faoziaziz/qioters/1.jpg

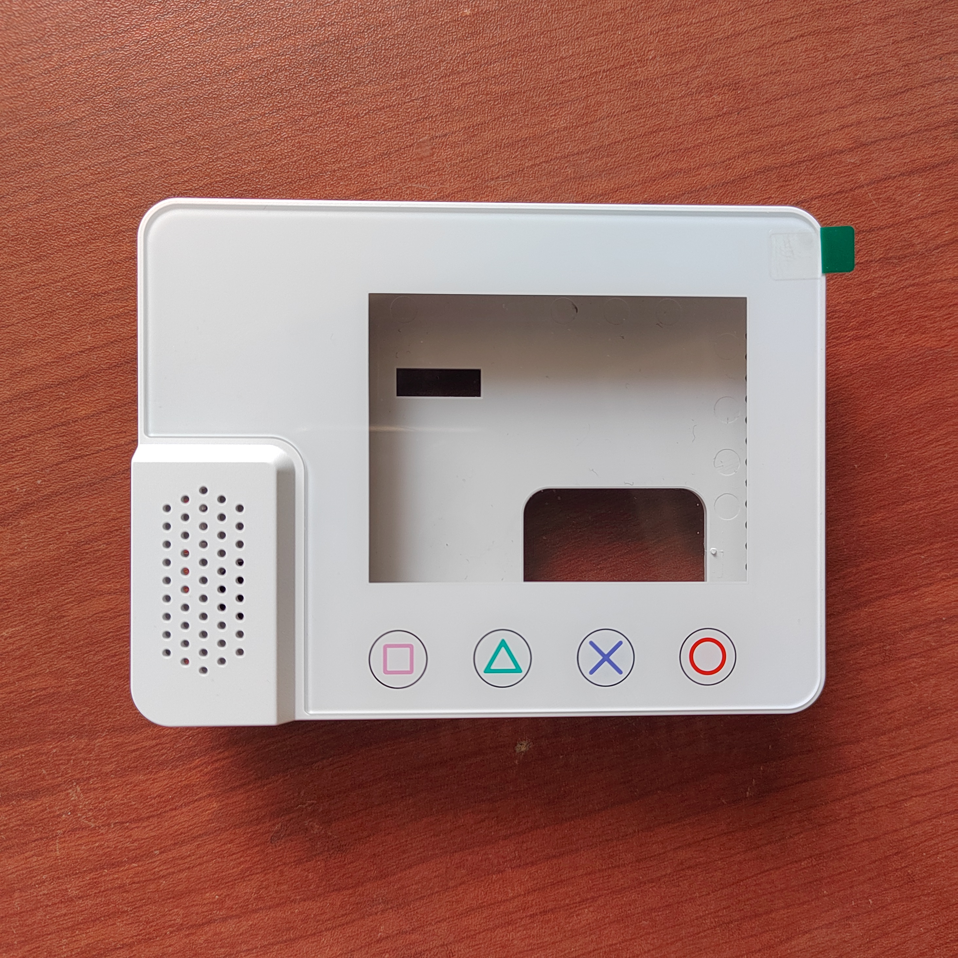
1.jpg
