faoziaziz/qioters/2.jpg

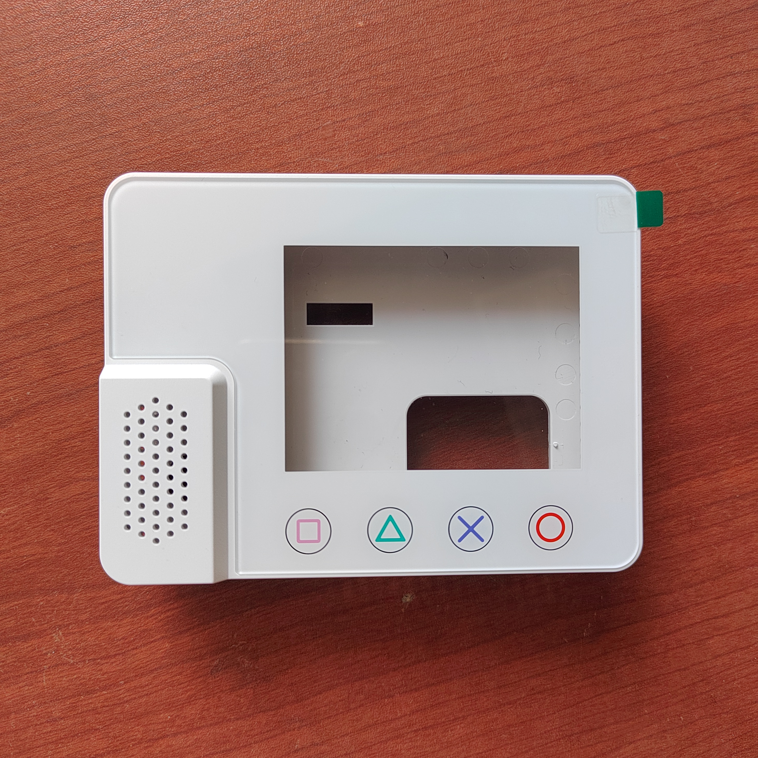
2.jpg
