faoziaziz/qioters/1.png

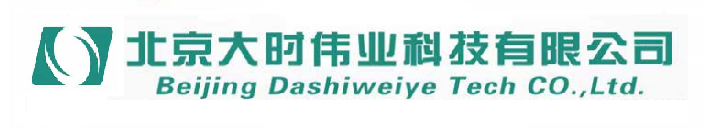
1.png
