faoziaziz/qioters/VAR-SOM_Compatibility_and_Pinouts.xlsx

Sheet: Revision
Version | Date | Description
1.0 | 2019-12-17 | Preliminary
1.1 | 22-Dec-19 | Correct SOM-MX8MM pins in the compatibility page only
1.2 | 02-JAN-20 | Added VAR-SOM-MX8M-NANO
1.3 | 2020-01-20 | Added VAR-SOM-MX8M-NANO and MINI SOM pin usage
1.4 | 2020-01-20 | Added VAR-SOM-SOLO pin usage and fix pin 58
1.5 | 2020-01-28 | Pin view on compatibility_pinmap page modified to include all SOMs
1.6 | 2020-03-22 | Added VAR-SOM-MX8MP Compatibility list updated with SOM-MX8MP
1.7 | 2020-05-17 | Updated VAR-SOM-MX8MP Pinout
1.8 | 2020-06-02 | Added SymphonyConnectors J7-J8-J5-J6-J4-J10-J11-J19
1.9 | 2020-06-15 | Added notes on power pins 31 33 35 in MX8X MX8MM MX8MN MX8MP Update second SPI in most COMMON FUNCTION TABLE pins 70 775 77 79
2.0 | 2020-06-28 | Updated COMMON FUNCTION TABLE pins 1,58,97 Updated most common function table - column ordered for MX6 family than MX8 family Updated VAR-SOM-MX8MP sheet pins 1,58 SymphonyConnectors sheet update to reflect Symphony-V1.4 changes; Added SOM notes column
2.1 | 2020-07-21 | Added Bootcfg on VAR-SOM-MX8MM Updated Mnemonics
2.2 | 2020-10-21 | Added SOM board images to mnemonics Added VAR-SOM-6UL pin usage per SOM configuration Updated J19 pin numbering according to Symphony-V1.4 VAR-SOM-MX8MP - updated pins 36,38 name
2.3 | 2021-03-18 | VAR-SOM-MX8M-MINI, VAR-SOM-MX8M-NANO - Added note for pin 91
2.4 | 2022-05-18 | VAR-SOM-MX8M-PLUS - removed SAI5_xx ALT functions from CPU SAI1_xx balls [SOM pins 40,55,56,57,70,72,73,75,82,86,117,120,177] Corrected notes pins 29,30
2.5 | 2023-03-16 | Added VAR-SOM-AM62 - Added pinmux sheet, updated compatibility_pinmap sheet Added SOM board images to mnemonics
2.6 | 2023-03-20 | VAR-SOM-AM62 - upated pins 50,51
2.7 | 2024-12-04 | Added support for VAR-SOM-MX8M-PLUS_V2.x Updated notes VAR-SOM-MX8M-PLUS_V1.x

Sheet: Mnemonics
Pinname mnemonics
"/" | Denote alternate function number "/" is ALT1 "////" is ALT4 None is ALT0
"/*/" | Function of configurable IC E.g. "SAI5_RXC/SAI1_TXD1////PDM_CLK/////GPIO3_IO20/*/LINEIN1_LP" " /*/LINEIN1_LP " - with "AC" Audio Codec configuration in the part number pin will expose the Audio Codec LINEIN1_LP IO The "SAI5_RXC/SAI1_TXD1////PDM_CLK/////GPIO3_IO20" Altenate function of SOC pad SAI5_RXC cannot be used in the above case!
"~" | Prefix points to an alternate function optionally used or shared on SOM; Verify with SOM datasheet before using this pin;
NC | Not Connected E.g. "NC/*/LVDS0_CH1_CLK_N" means that when "LD" LVDS Display option NOT included in the SOM configuration - this pin will not be connected
Compatibility_PinMap table mnemonics
"FULL COMPATIBLE" | "S"- Compatible Signal pin; "P"- Compatible Power pin
SOM Boards naming mnemonics
VAR-SOM-SOLO
VAR-SOM-6UL
VAR-SOM-MX6
VAR-SOM-MX8
VAR-SOM-MX8X
VAR-SOM-MX8MM (MINI)
VAR-SOM-MX8MN (NANO)
VAR-SOM-MX8MP (PLUS)
VAR-SOM-MX93
VAR-SOM-AM62

Sheet: Compatibility_PinMap
 | Symphony SOMs compatibility list: |  |  | FULL COMPATIBLE (S- Signal; P- Power) | ALL VAR-SOM MOST COMMON FUNCTION; If none will display unique or GPIO by default; |  |  |  |  |  |  |  |  |  |  | PWM | Enter PIN#
PIN# | Compatibility LIST (MX6/MX8/MX8X/MX8MM/MX8MN/MX8MP) - Symphony based | Compatible Name | Common GPIO used on Symphony | xxxx | VAR-SOM-SOLO | VAR-SOM-6UL | VAR-SOM-MX6 | VAR-SOM-MX8 | VAR-SOM-MX8X | VAR-SOM-MX8MM | VAR-SOM-MX8MN | VAR-SOM-MX8MP_V1.x | VAR-SOM-MX8MP_V2.x | VAR-SOM-MX93 | VAR-SOM-AM62 |  | 17 | SPECIFIC SOM PIN FUNCTIONS :
1 |  |  |  |  | DGND | DGND | GND | GND | GND | NC | NC | NC | NC | NC | NC |  | VAR-SOM-SOLO | IPU1_DISP0_D09/LCD_D09//PWM2_OUT///WDOG2_B/////GPIO4_IO30
2 | GND | GND |  | P | DGND | DGND | GND | GND | GND | GND | GND | GND | GND | GND | GND |  | VAR-SOM-6UL | ENET_REF_CLK2/PWM4_OUT//OTG2_ID///CSI_FIELD////USDHC1_VSELECT/////GPIO1_IO5(ADC IN5)//////ENET2_1588_EVENT0_OUT///////CCM_PLL3_BYP////////UART5_RX
3 | ETH_MDI_A+/ETH0_MDI_A_P/ETH0_MDI_A_P/ETH_TRX0_P/ETH_TRX0_P/ETH0_MDI_A_P | ETH#A_MDI_A_P |  | S | GETH_TR0P | ETH_RXDP | ETH_MDI_A+ | ETH0_MDI_A_P | ETH0_MDI_A_P | ETH_TRX0_P | ETH_TRX0_P | ETH0_MDI_A_P | ETH0_MDI_A_P | ETH0_MDI_A_P | ETH0_MDI_A_P |  | VAR-SOM-MX6 | IPU1_DISP0_DATA09/IPU2_DISP0_DATA09//PWM2_OUT///WDOG2_B/////GPIO4_IO30
4 | ETH_MDI_C+/ETH0_MDI_C_P/ETH0_MDI_C_P/ETH_TRX2_P/ETH_TRX2_P/ETH0_MDI_C_P | ETH#A_MDI_C_P |  | S | GETH_TR2P | NC | ETH_MDI_C+ | ETH0_MDI_C_P | ETH0_MDI_C_P | ETH_TRX2_P | ETH_TRX2_P | ETH0_MDI_C_P | ETH0_MDI_C_P | ETH0_MDI_C_P | ETH0_MDI_C_P |  | VAR-SOM-MX8 | LVDS0_GPIO0_IO00/LVDS0_PWM0_OUT///LSIO_GPIO1_IO04
5 | ETH_MDI_A-/ETH0_MDI_A_M/ETH0_MDI_A_M/ETH_TRX0_N/ETH_TRX0_N/ETH0_MDI_A_M | ETH#A_MDI_A_M |  | S | GETH_TR0N | ETH_RXDN | ETH_MDI_A- | ETH0_MDI_A_M | ETH0_MDI_A_M | ETH_TRX0_N | ETH_TRX0_N | ETH0_MDI_A_M | ETH0_MDI_A_M | ETH0_MDI_A_M | ETH0_MDI_A_M |  | VAR-SOM-MX8X | MIPI_DSI0_GPIO0_IO00/ADMA_I2C1_SCL//MIPI_DSI0_PWM0_OUT////LSIO_GPIO1_IO27
6 | ETH_MDI_C-/ETH0_MDI_C_M/ETH0_MDI_C_M/ETH_TRX2_N/ETH_TRX2_N/ETH0_MDI_C_M | ETH#A_MDI_C_M |  | S | GETH_TR2N | NC | ETH_MDI_C- | ETH0_MDI_C_M | ETH0_MDI_C_M | ETH_TRX2_N | ETH_TRX2_N | ETH0_MDI_C_M | ETH0_MDI_C_M | ETH0_MDI_C_M | ETH0_MDI_C_M |  | VAR-SOM-MX8MM | SPDIF_EXT_CLK/PWM1_OUT/////GPIO5_IO05
7 | GND | GND |  | P | DGND | DGND | GND | GND | GND | GND | GND | GND | GND | GND | GND |  | VAR-SOM-MX8MN | SPDIF_EXT_CLK/PWM1_OUT/////GPIO5_IO05
8 | GND | GND |  | P | DGND | DGND | GND | GND | GND | GND | GND | GND | GND | GND | GND |  | VAR-SOM-MX8MP_V1.x | SPDIF1_EXT_CLK/PWM1_OUT///GPT1_COMPARE3/////GPIO5_IO05
9 | ETH_MDI_B+/ETH0_MDI_B_P/ETH0_MDI_B_P/ETH_TRX1_P/ETH_TRX1_P/ETH0_MDI_B_P | ETH#A_MDI_B_P |  | S | GETH_TR1P | ETH_TXDP | ETH_MDI_B+ | ETH0_MDI_B_P | ETH0_MDI_B_P | ETH_TRX1_P | ETH_TRX1_P | ETH0_MDI_B_P | ETH0_MDI_B_P | ETH0_MDI_B_P | ETH0_MDI_B_P |  | VAR-SOM-MX8MP_V2.x | SPDIF1_EXT_CLK/PWM1_OUT///GPT1_COMPARE3/////GPIO5_IO05
10 | ETH_MDI_D+/ETH0_MDI_D_P/ETH0_MDI_D_P/ETH_TRX3_P/ETH_TRX3_P/ETH0_MDI_D_P | ETH#A_MDI_D_P |  | S | GETH_TR3P | NC | ETH_MDI_D+ | ETH0_MDI_D_P | ETH0_MDI_D_P | ETH_TRX3_P | ETH_TRX3_P | ETH0_MDI_D_P | ETH0_MDI_D_P | ETH0_MDI_D_P | ETH0_MDI_D_P |  | VAR-SOM-MX93 | GPIO2.IO[24]/USDHC3.DATA0//LCDIF.D[20]/TPM3.CH3/DAP.TDO_TRACESWO/SPI6.PCS1/FLEXIO1.FLEXIO[24]
11 | ETH_MDI_B-/ETH0_MDI_B_M/ETH0_MDI_B_M/ETH_TRX1_N/ETH_TRX1_N/ETH0_MDI_B_M | ETH#A_MDI_B_M |  | S | GETH_TR1N | ETH_TXDN | ETH_MDI_B- | ETH0_MDI_B_M | ETH0_MDI_B_M | ETH_TRX1_N | ETH_TRX1_N | ETH0_MDI_B_M | ETH0_MDI_B_M | ETH0_MDI_B_M | ETH0_MDI_B_M |  | VAR-SOM-AM62 | MCASP0_AXR1/SPI2_CS2//ECAP1_IN_APWM_OUT/////PR0_UART0_RXD//////EHRPWM1_A///////GPIO1_9////////EQEP0_S
12 | ETH_MDI_D-/ETH0_MDI_D_M/ETH0_MDI_D_M/ETH_TRX3_N/ETH_TRX3_N/ETH0_MDI_D_M | ETH#A_MDI_D_M |  | S | GETH_TR3N | NC | ETH_MDI_D- | ETH0_MDI_D_M | ETH0_MDI_D_M | ETH_TRX3_N | ETH_TRX3_N | ETH0_MDI_D_M | ETH0_MDI_D_M | ETH0_MDI_D_M | ETH0_MDI_D_M
13 | GND | GND |  | P | DGND | DGND | GND | GND | GND | GND | GND | GND | GND | GND | GND
14 | GND | GND |  | P | DGND | DGND | GND | GND | GND | GND | GND | GND | GND | GND | GND
15 | ETH0_LED_ACT | ETH#A_LED_ACT |  | S | ETH_LED2 | ETH_LED2 | GETH_LED2 | ETH0_LED_ACT | ETH0_LED_ACT | ETH_LED_ACT | ETH_LED_ACT | ETH0_LED_ACT | ETH0_LED_ACT | ETH0_LED_ACT | ETH0_LED_ACT
16 | ETH0_LED_LINK_10_100_1000 | ETH#A_LED_LINK_10_100_1000 |  | S | ETH_LED1 | ETH_LED1 | ETH_PME_N_LED1 | ETH0_LED_LINK_10_100_1000 | ETH0_LED_LINK_10_100_1000 | ETH_LED_LINK10_100_1000 | ETH_LED_LINK10_100_1000 | ETH0_LED_LINK_10_100_1000 | ETH0_LED_LINK_10_100_1000 | ETH0_LED_LINK | ETH0_LED_LINK_10_100_1000
17 | PWM2_OUT/LVDS0_PWM0_OUT/MIPI_DSI0_PWM0_OUT/PWM1_OUT/PWM1_OUT/EHRPWM1_A | PWM#A |  | S | PWM2_OUT | PWM4_OUT | PWM2_OUT | LVDS0_PWM0_OUT | MIPI_DSI0_PWM0_OUT | PWM1_OUT | PWM1_OUT | PWM1_OUT | PWM1_OUT | TPM3.CH3 (PWM) | EHRPWM1_A
18 | DMIC_CLK | AC#_DMIC_CLK |  | S | DMIC_CLK | NC | DMIC_CLK | DMIC_CLK | DMIC_CLK | DMIC_CLK | DMIC_CLK | DMIC_CLK | DMIC_CLK | DMIC_CLK | DMIC_CLK
19 | GND/GND/GND/GND/GND/DGND | GND |  | P | DGND | DGND | GND | GND | GND | GND | GND | DGND | DGND | GND | DGND
20 | DMIC_DATA | AC#_DMIC_DATA |  | S | DMIC_DATA | NC | DMIC_DATA | DMIC_DATA | DMIC_DATA | DMIC_DATA | DMIC_DATA | DMIC_DATA | DMIC_DATA | DMIC_DATA | DMIC_DATA
21 | AUD4_RXD/AUD_SAI1_RXD/ADMA_SAI0_RXD/SAI2_RXD0/SAI2_RXD0/MCASP2_AXR2 | SAI#A_RXD |  | S | AUD4_RXD | SAI1_RX_D | AUD4_RXD | AUD_SAI1_RXD | ADMA_SAI0_RXD | SAI2_RXD0 | SAI2_RXD0 | SAI2_RX_DATA0 | SAI2_RX_DATA0 | SAI3.RX_DATA[0] | MCASP2_AXR2
22 | AUD4_RXC/AUD_SAI1_RXC/ADMA_SAI0_RXC/SAI2_RXC/SAI2_RXC/MCASP2_ACLKR | SAI#A_RXC_USDHC#A_RESET_B |  | S | AUD4_RXC | SAI1_RX_BCLK | AUD4_RXC | AUD_SAI1_RXC | ADMA_SAI0_RXC | SAI2_RXC | SAI2_RXC | SAI2_RX_BCLK | SAI2_RX_BCLK | SAI3.RX_BCLK | MCASP2_ACLKR
23 | AUD4_RXFS/AUD_SAI1_RXFS/ADMA_SAI0_RXFS/SAI2_RXFS/SAI2_RXFS/MCASP2_AFSR | SAI#A_RXFS_PCIE#A_RESET_B |  | S | AUD4_RXFS | SAI1_RX_SYNC | AUD4_RXFS | AUD_SAI1_RXFS | ADMA_SAI0_RXFS | SAI2_RXFS | SAI2_RXFS | SAI2_RX_SYNC | SAI2_RX_SYNC | SAI3.RX_SYNC | MCASP2_AFSR
24 | AUD4_TXFS/AUD_SAI1_TXFS/ADMA_SAI0_TXFS/SAI2_TXFS/SAI2_TXFS/MCASP2_AFSX | SAI#A_TXFS |  | S | AUD4_TXFS | SAI1_TX_SYNC | AUD4_TXFS | AUD_SAI1_TXFS | ADMA_SAI0_TXFS | SAI2_TXFS | SAI2_TXFS | SAI2_TX_SYNC | SAI2_TX_SYNC | SAI3.TX_SYNC | MCASP2_AFSX
25 | AUD4_TXC/AUD_SAI0_TXC/ADMA_SAI0_TXC/SAI2_TXC/SAI2_TXC/MCASP2_ACLKX | SAI#A_TXC |  | S | AUD4_TXC | SAI1_TX_BCLK | AUD4_TXC | AUD_SAI0_TXC | ADMA_SAI0_TXC | SAI2_TXC | SAI2_TXC | SAI2_TX_BCLK | SAI2_TX_BCLK | SAI3.TX_BCLK | MCASP2_ACLKX
26 | AUD4_TXD/AUD_SAI1_TXD/ADMA_SAI0_TXD/SAI2_TXD0/SAI2_TXD0/MCASP2_AXR3 | SAI#A_TXD |  | S | AUD4_TXD | SAI1_TX_D | AUD4_TXD | AUD_SAI1_TXD | ADMA_SAI0_TXD | SAI2_TXD0 | SAI2_TXD0 | SAI2_TX_DATA0 | SAI2_TX_DATA0 | SAI3.RX_BCLK | MCASP2_AXR3
27 | GND | GND |  | P | DGND | DGND | GND | GND | GND | GND | GND | GND | GND | GND | GND
28 | GND | GND |  | P | DGND | DGND | GND | GND | GND | GND | GND | GND | GND | GND | GND
29 | CCM_CLKO2/MIPI_CSI0_MCLK_OUT/MIPI_CSI0_MCLK_OUT/EXT_CLK4/EXT_CLK4/SYSCLKOUT0 | CLK#GP |  | S | CCM_CLKO2 | GPT2_CLK | CCM_CLKO2 | MIPI_CSI0_MCLK_OUT | MIPI_CSI0_MCLK_OUT | EXT_CLK4 | EXT_CLK4 | CCM_CLKO2 | CCM_CLKO2 | CCMSRCGPCMIX.CLKO1 | SYSCLKOUT0
30 | NC/CONN_ENET0_MDIO/CONN_ENET0_MDIO/ENET_MDIO/ENET_MDIO/MDIO0_MDIO | J1_30-ENET_MDIO |  | S | NC | ENET1_MDIO | NC | CONN_ENET0_MDIO | CONN_ENET0_MDIO | ENET_MDIO | ENET_MDIO | ENET_QOS_MDIO | ENET_QOS_MDIO | ENET_QOS.MDIO | MDIO0_MDIO
31 |  |  |  |  | DGND | DGND | GND | VCC_SOM | NC | NC | NC | NC | NC | NC | NC
32 | VCC_SOM | VCC_SOM |  | P | VCC_SOM | VCC_SOM | VCC_SOM | VCC_SOM | VCC_SOM | VCC_SOM | VCC_SOM | VCC_SOM | VCC_SOM | VCC_SOM | VCC_SOM
33 |  |  |  |  | DGND | DGND | GND | VCC_SOM | NC | NC | NC | NC | NC | NC | NC
34 | VCC_SOM | VCC_SOM |  | S | VCC_SOM | VCC_SOM | VCC_SOM | VCC_SOM | VCC_SOM | VCC_SOM | VCC_SOM | VCC_SOM | VCC_SOM | VCC_SOM | VCC_SOM
35 |  |  |  |  | DGND | DGND | GND | VCC_SOM | NC | NC | NC | NC | NC | NC | NC
36 | VCC_SOM/VCC_SOM/LICELL/VCC_SOM/VCC_SOM/VCC_SOM | VCC_SOM/MX8MP-ENET0 PWR |  | P | VCC_SOM | LICELL | VCC_SOM | VCC_SOM | LICELL | VCC_SOM | VCC_SOM | VDD_ENET0_1P8_3P3_IN | VDD_ENET0_1P8_3P3_IN | NC | VCC_SOM
37 | GND | GND |  | P | DGND | DGND | GND | GND | GND | GND | GND | GND | GND | GND | GND
38 | VCC_SOM/VDD_ENET1_1P8_2P5_3P3_IN/VDD_ENET1_1P8_2P5_3P3_IN/VDD_ENET/VDD_ENET/NC | VDD_ENET for MX8 SOM family |  | P | VCC_SOM | VCC_SOM | VCC_SOM | VDD_ENET1_1P8_2P5_3P3_IN | VDD_ENET1_1P8_2P5_3P3_IN | VDD_ENET | VDD_ENET | VDD_ENET1_1P8_3P3_IN | VDD_ENET1_1P8_3P3_IN | NC | NC
39 | ECSPI1_SS0/DMA_SPI1_CS0/ADMA_SPI2_CS0/ECSPI1_SS0/ECSPI1_SS0/SPI2_CS0 | SPI#A_CS0 |  | S | ECSPI1_SS0 | ECSPI4_SS0 | ECSPI1_SS0 | DMA_SPI1_CS0 | ADMA_SPI2_CS0 | ECSPI1_SS0 | ECSPI1_SS0 | ECSPI2_SS0 | ECSPI2_SS0 | SPI6.PCS0 | SPI2_CS0
40 |  |  | J1_40-MIPI_CAM_RST |  | GPIO3_IO05 | NC | GPIO3_IO05 | LSIO_GPIO3_IO06 | LSIO_GPIO0_IO12 | GPIO1_IO13 | GPIO1_IO13 | GPIO1_IO00 | GPIO1_IO00 | GPIO3.IO[27] | GPIO0_22
41 | ECSPI1_MISO/DMA_SPI1_SDI/ADMA_SPI2_SDI/ECSPI1_MISO/ECSPI1_MISO/SPI2_D1 | SPI#A_SDI |  | S | ECSPI1_MISO | ECSPI4_MISO | ECSPI1_MISO | DMA_SPI1_SDI | ADMA_SPI2_SDI | ECSPI1_MISO | ECSPI1_MISO | ECSPI2_MISO | ECSPI2_MISO | SPI6.SIN | SPI2_D1
42 | SRC_BOOT_CFG07/BOOT_SEL/BOOT_SEL/BOOT_SEL/BOOT_SEL/BOOT_SEL | BOOT#_SEL |  | S | SRC_BOOT_CFG07 | BOOT_SEL0 | SRC_BOOT_CFG07 | BOOT_SEL | BOOT_SEL | BOOT_SEL | BOOT_SEL | BOOT_SEL | BOOT_SEL | BOOT_SEL | BOOT_SEL
43 | ECSPI1_SCLK/DMA_SPI1_SCK/ADMA_SPI2_SCK/ECSPI1_SCLK/ECSPI1_SCLK/SPI2_CLK | SPI#A_SCK |  | S | ECSPI1_SCLK | ECSPI4_SCLK | ECSPI1_SCLK | DMA_SPI1_SCK | ADMA_SPI2_SCK | ECSPI1_SCLK | ECSPI1_SCLK | ECSPI2_SCLK | ECSPI2_SCLK | SPI6.SCK | SPI2_CLK
44 | FLEXCAN1_TX/FLEXCAN0_TX/ADMA_FLEXCAN2_TX/CAN_TX/CAN_TX/MCAN0_TX | FLEXCAN#A_TX |  | S | FLEXCAN1_TX | CAN1_TX | FLEXCAN1_TX | FLEXCAN0_TX | ADMA_FLEXCAN2_TX | CAN_TX | CAN_TX | FLEXCAN2_TX | FLEXCAN2_TX | CAN1.TX | MCAN0_TX
45 | ECSPI1_MOSI/DMA_SPI1_SDO/ADMA_SPI2_SDO/ECSPI1_MOSI/ECSPI1_MOSI/SPI2_D0 | SPI#A_SDO |  | S | ECSPI1_MOSI | ECSPI4_MOSI | ECSPI1_MOSI | DMA_SPI1_SDO | ADMA_SPI2_SDO | ECSPI1_MOSI | ECSPI1_MOSI | ECSPI2_MOSI | ECSPI2_MOSI | SPI6.SOUT | SPI2_D0
46 | FLEXCAN1_RX/DMA_FLEXCAN0_RX/ADMA_FLEXCAN2_RX/CAN_RX/CAN_RX/MCAN0_RX | FLEXCAN#A_RX |  | S | FLEXCAN1_RX | CAN1_RX | FLEXCAN1_RX | DMA_FLEXCAN0_RX | ADMA_FLEXCAN2_RX | CAN_RX | CAN_RX | FLEXCAN2_RX | FLEXCAN2_RX | CAN1.RX | MCAN0_RX
47 | GND | GND |  | P | DGND | DGND | GND | GND | GND | GND | GND | GND | GND | GND | GND
48 |  |  |  |  | GPIO4_IO10 | GPIO1_IO25 | GPIO4_IO10 | LSIO_GPIO0_IO17 | LSIO_GPIO3_IO02 | GPIO1_IO02/WDOG_B | GPIO1_IO02/WDOG_B | SAI2_MCLK | SAI2_MCLK | GPIO2.IO[10] | GPIO0_20
49 | SOM_3V3_PER/SOM_3V3_PER/SOM_3V3_PER/SOM_3V3_PER/SOM_3V3_PER/SOM_PGOOD | SOM_3V3_PER |  | P | SOM_3V3_PER | SOM_3V3_PER | SOM_3V3_PER | SOM_3V3_PER | SOM_3V3_PER | SOM_3V3_PER | SOM_3V3_PER | SOM_3V3_PER | SOM_3V3_PER | SOM_3V3_PER | SOM_PGOOD
50 | UART2_CTS_B/DMA_UART1_RTS_B/ADMA_UART0_RTS_B/UART2_CTS_B/UART2_CTS_B/UART5_CTSn | UART#BT_RTS_B |  | S | UART2_CTS_B | UART2_CTS_B | UART2_CTS_B | DMA_UART1_RTS_B | ADMA_UART0_RTS_B | UART2_CTS_B | UART2_CTS_B | UART3_CTS_B | UART3_CTS_B | UART5.RTS_B | UART5_CTSn
51 | UART2_RTS_B/DMA_UART1_CTS_B/ADMA_UART0_CTS_B/UART2_RTS_B/UART2_RTS_B/UART5_RTSn | UART#BT_CTS_B |  | S | UART2_RTS_B | UART2_RTS_B | UART2_RTS_B | DMA_UART1_CTS_B | ADMA_UART0_CTS_B | UART2_RTS_B | UART2_RTS_B | UART3_RTS_B | UART3_RTS_B | UART5.CTS_B | UART5_RTSn
52 | UART2_TX_DATA/DMA_UART1_TX/ADMA_UART0_TX/UART2_TXD/UART2_TXD/UART5_TXD | UART#BT_TX |  | S | UART2_TX | UART2_TX | UART2_TX_DATA | DMA_UART1_TX | ADMA_UART0_TX | UART2_TXD | UART2_TXD | UART3_TX | UART3_TX | UART5.TX | UART5_TXD
53 | UART2_RX_DATA/DMA_UART1_RX/ADMA_UART0_RX/UART2_RXD/UART2_RXD/UART5_RXD | UART#BT_RX |  | S | UART2_RX | UART2_RX | UART2_RX_DATA | DMA_UART1_RX | ADMA_UART0_RX | UART2_RXD | UART2_RXD | UART3_RX | UART3_RX | UART5.RX | UART5_RXD
54 |  |  |  |  | UART3_RX | UART5_RX | UART3_RX_DATA | UART3_RX | LSIO_GPIO0_IO05 | UART1_RXD | UART1_RXD | GPIO4_IO09 | GPIO4_IO09 | GPIO4.IO[27] | GPIO1_6
55 |  |  |  |  | UART3_CTS_B | UART5_CTS_B | UART3_CTS_B | UART3_RTS (actually CTS) | LSIO_GPIO0_IO03 | UART1_CTS_B | UART1_CTS_B | GPIO4_IO15 | GPIO4_IO15 | GPIO4.IO[16] | GPIO1_0
56 |  |  |  |  | UART3_TX | UART5_TX | UART3_TX_DATA | UART3_TX | LSIO_GPIO0_IO01 | UART1_TXD | UART1_TXD | GPIO4_IO14 | GPIO4_IO14 | GPIO4.IO[17] | GPIO0_91
57 |  |  |  |  | UART3_RTS_B | UART5_RTS_B | UART3_RTS_B | UART3_CTS (actually RTS) | LSIO_GPIO0_IO04 | UART1_RTS_B | UART1_RTS_B | GPIO4_IO11 | GPIO4_IO11 | GPIO4.IO[23] | GPIO1_2
58 |  |  |  |  | DGND | DGND | GND | GND | GND | GND | GND | NC | NC | NC | MCU_GPIO0_7
59 | GND | GND |  | P | DGND | DGND | GND | GND | GND | GND | GND | GND | GND | GND | GND
60 | SD2_CLK/CONN_USDHC1_CLK/CONN_USDHC1_CLK/SD2_CLK/SD2_CLK/MMC1_CLK | USDHC#A_CLK |  | S | SD2_CLK | SD1_CLK | SD2_CLK | CONN_USDHC1_CLK | CONN_USDHC1_CLK | SD2_CLK | SD2_CLK | USDHC2_CLK | USDHC2_CLK | USDHC2.CLK | MMC1_CLK
61 | SD2_DATA2/CONN_USDHC1_DATA2/CONN_USDHC1_DATA2/SD2_DATA2/SD2_DATA2/MMC1_DAT2 | USDHC#A_DAT2 |  | S | SD2_D2 | SD1_DATA2 | SD2_DATA2 | CONN_USDHC1_DATA2 | CONN_USDHC1_DATA2 | SD2_DATA2 | SD2_DATA2 | USDHC2_DATA2 | USDHC2_DATA2 | USDHC2.DATA2 | MMC1_DAT2
62 | SD2_DATA0/CONN_USDHC1_DATA0/CONN_USDHC1_DATA0/SD2_DATA0/SD2_DATA0/MMC1_DAT2 | USDHC#A_DAT0 |  | S | SD2_D0 | SD1_DATA0 | SD2_DATA0 | CONN_USDHC1_DATA0 | CONN_USDHC1_DATA0 | SD2_DATA0 | SD2_DATA0 | USDHC2_DATA0 | USDHC2_DATA0 | USDHC2.DATA0 | MMC1_DAT2
63 | SD2_DATA1/CONN_USDHC1_DATA1/CONN_USDHC1_DATA1/SD2_DATA1/SD2_DATA1/MMC1_DAT1 | USDHC#A_DAT1 |  | S | SD2_D1 | SD1_DATA1 | SD2_DATA1 | CONN_USDHC1_DATA1 | CONN_USDHC1_DATA1 | SD2_DATA1 | SD2_DATA1 | USDHC2_DATA1 | USDHC2_DATA1 | USDHC2.DATA1 | MMC1_DAT1
64 | SD2_CMD/CONN_USDHC1_CMD/CONN_USDHC1_CMD/SD2_CMD/SD2_CMD/MMC1_CMD | USDHC#A_CMD |  | S | SD2_CMD | SD1_CMD | SD2_CMD | CONN_USDHC1_CMD | CONN_USDHC1_CMD | SD2_CMD | SD2_CMD | USDHC2_CMD | USDHC2_CMD | USDHC2.CMD | MMC1_CMD
65 | SD2_DATA3/CONN_USDHC1_DATA3/CONN_USDHC1_DATA3/SD2_DATA3/SD2_DATA3/MMC1_DAT3 | USDHC#A_DAT3 |  | S | SD2_D3 | SD1_DATA3 | SD2_DATA3 | CONN_USDHC1_DATA3 | CONN_USDHC1_DATA3 | SD2_DATA3 | SD2_DATA3 | USDHC2_DATA3 | USDHC2_DATA3 | USDHC2.DATA3 | MMC1_DAT3
66 | GND | GND |  | P | DGND | DGND | GND | GND | GND | GND | GND | GND | GND | GND | GND
67 | GND | GND |  | P | DGND | DGND | GND | GND | GND | GND | GND | GND | GND | GND | GND
68 | PWM1_OUT/LSIO_PWM2_OUT/LSIO_PWM3_OUT/PWM2_OUT/PWM2_OUT/EHRPWM0_B | PWM#B_CPT_INT |  | S | PWM1_OUT | PWM2_OUT | PWM1_OUT | LSIO_PWM2_OUT | LSIO_PWM3_OUT | PWM2_OUT | PWM2_OUT | PWM3_OUT | PWM3_OUT | TPM4.CH3 (PWM) | EHRPWM0_B
69 | PWM3_OUT/LSIO_PWM3_OUT/LSIO_PWM2_OUT/PWM3_OUT/PWM3_OUT/EHRPWM1_B | PWM#C |  | S | PWM3_OUT | PWM1_OUT | PWM3_OUT | LSIO_PWM3_OUT | LSIO_PWM2_OUT | PWM3_OUT | PWM3_OUT | PWM2_OUT | PWM2_OUT | TPM6.CH3 (PWM) | EHRPWM1_B
70 |  |  | J1_70-MIPI_CAM_SYNC |  | JTAG_TRSTB | ECSPI2_MOSI | GPIO2_IO14 | DMA_SPI0_SDO | ADMA_SPI1_SDO | ECSPI2_MOSI | ECSPI2_MOSI | GPIO1_IO13 | GPIO1_IO13 | NC | SPI1_D0
71 |  |  |  |  | GPIO1_IO02 | GPIO4_IO14 | GPIO1_IO02 | LSIO_GPIO6_IO20 | LSIO_GPIO0_IO06 | GPIO2_IO19 | GPIO2_IO19 | GPIO4_IO08 | GPIO4_IO08 | GPIO4.IO[26] | GPIO1_5
72 |  |  |  |  | USB_OTG_ID | GPIO5_IO3 | USB_OTG_ID | LSIO_GPIO3_IO11 | LSIO_GPIO5_IO09 | USB2_OTG_ID | USB2_OTG_ID | GPIO1_IO05 | GPIO1_IO05 | GPIO1.IO[10] | GPIO1_12
73 |  |  |  |  | GPIO2_IO11 | GPIO5_IO1 | GPIO2_IO11 | LSIO_GPIO6_IO12 | LSIO_GPIO0_IO08 | GPIO4_IO27 | GPIO4_IO27 | GPIO4_IO12 | GPIO4_IO12 | GPIO4.IO[19] | GPIO0_89
74 | NC/CONN_ENET0_MDC/CONN_ENET0_MDC/ENET_MDC/ENET_MDC/MDIO0_MDC | J1_74-ENET_MDC |  | S | ONOFF | ENET1_MDC | NC | CONN_ENET0_MDC | CONN_ENET0_MDC | ENET_MDC | ENET_MDC | ENET_QOS_MDC | ENET_QOS_MDC | ENET_QOS.MDC | MDIO0_MDC
75 |  |  | J1_75-MIPI_CAM_TRIGGER |  | GPIO3_21 | ECSPI2_SCLK | GPIO3_IO21 | DMA_SPI0_SCK | ADMA_SPI1_SCK | ECSPI2_SCLK | ECSPI2_SCLK | GPIO1_IO01 | GPIO1_IO01 | GPIO4.IO[28] | SPI1_CLK
76 | GND | GND |  | P | DGND | DGND | GND | GND | GND | GND | GND | GND | GND | GND | GND
77 |  |  | J1_77-MIPI_CSI_PWDN |  | GPIO3_22 | ECSPI2_MISO | GPIO3_IO22 | DMA_SPI0_SDI | ADMA_SPI1_SDI | ECSPI2_MISO | ECSPI2_MISO | GPIO1_IO08 | GPIO1_IO08 | GPIO2.IO[11] | SPI1_D1
78 | GND | GND |  | P | DGND | DGND | GND | GND | GND | GND | GND | GND | GND | GND | GND
79 |  |  |  |  | GPIO3_IO30 | ECSPI2_SS0 | GPIO3_IO30 | DMA_SPI0_CS0 | ADMA_SPI1_CS0 | ECSPI2_SS0 | ECSPI2_SS0 | GPIO3_IO14 | GPIO3_IO14 | GPIO3.IO[18] | SPI1_CS0
80 | GPIO4_IO14/LSIO_GPIO0_IO14/LSIO_GPIO4_IO22/GPIO1_IO10/GPIO1_IO10/GPIO1_48 | USDHC#A_CD_B |  | S | GPIO4_14 | GPIO1_0 | GPIO4_IO14 | LSIO_GPIO0_IO14 | LSIO_GPIO4_IO22 | GPIO1_IO10 | GPIO1_IO10 | GPIO1_IO14 | GPIO1_IO14 | GPIO3.IO[0] | GPIO1_48
81 |  |  |  |  | GPIO5_IO19 | GPIO5_IO7 | GPIO5_IO19 | LSIO_GPIO6_IO19 | LSIO_GPIO0_IO07 | GPIO1_IO00 | GPIO1_IO00 | GPIO4_IO07 | GPIO4_IO07 | GPIO4.IO[25] | GPIO1_4
82 | GPIO4_IO15/LSIO_GPIO0_IO18/LSIO_GPIO4_IO21/GPIO5_IO01/GPIO5_IO01/GPIO1_51 | J1_82-USB#A_HOST_PWR |  | S | GPIO4_15 | GPIO3_16 | GPIO4_IO15 | LSIO_GPIO0_IO18 | LSIO_GPIO4_IO21 | GPIO5_IO01 | GPIO5_IO01 | GPIO1_IO07 | GPIO1_IO07 | NC | GPIO1_51
83 | UART1_RX_DATA/DMA_UART0_RX/ADMA_UART3_RX/UART4_RXD/UART4_RXD/UART0_RXD | UART#_DEBUG_RX |  | S | UART1_RX | UART1_RX | UART1_RX_DATA | DMA_UART0_RX | ADMA_UART3_RX | UART4_RXD | UART4_RXD | UART2_RX | UART2_RX | UART1.RX | UART0_RXD
84 |  |  |  |  | UART1_RTS_B | UART1_RTS_B | UART1_RTS_B | UART0_CTS_B (= old RTS) | LSIO_GPIO0_IO24 | GPIO4_IO03 | NC | GPIO3_IO06 | GPIO3_IO06 | NC | GPIO0_19
85 | UART1_TX_DATA/DMA_UART0_TX/ADMA_UART3_TX/UART4_TXD/UART4_TXD/UART0_TXD | UART#_DEBUG_TX |  | S | UART1_TX | UART1_TX | UART1_TX_DATA | DMA_UART0_TX | ADMA_UART3_TX | UART4_TXD | UART4_TXD | UART2_TX | UART2_TX | UART1.TX | UART0_TXD
86 |  |  | J1_86-MIPI_CAM_BUF_CTL |  | UART1_CTS_B GPIO3_IO19 | UART1_CTS_B GPIO1_IO18 | UART1_CTS_B GPIO3_IO19 | DMA_UART0_RTS_B LSIO_GPIO0_IO22 | LSIO_GPIO3_IO24 | GPIO4_IO05 | NC | GPIO1_IO06 | GPIO1_IO06 | GPIO2.IO[17] | GPIO0_21
87 | I2C1_SDA/DMA_I2C1_SDA/ADMA_I2C1_SDA/I2C2_SDA/I2C2_SDA/I2C0_SDA | I2C#A_SDA |  | S | I2C1_SDA | I2C1_SDA | I2C1_SDA | DMA_I2C1_SDA | ADMA_I2C1_SDA | I2C2_SDA | I2C2_SDA | I2C3_SDA | I2C3_SDA | I2C5.SDA | I2C0_SDA
88 | I2C1_SCL/DMA_I2C1_SCL/ADMA_I2C1_SCL/I2C2_SCL/I2C2_SCL/I2C0_SCL | I2C#A_SCL |  | S | I2C1_SCL | I2C1_SCL | I2C1_SCL | DMA_I2C1_SCL | ADMA_I2C1_SCL | I2C2_SCL | I2C2_SCL | I2C3_SCL | I2C3_SCL | I2C5.SCL | I2C0_SCL
89 | GND | GND |  | S | DGND | DGND | GND | GND | GND | GND | GND | GND | GND | GND | GND
90 | I2C3_SDA/DMA_I2C4_SDA/ADMA_I2C2_SDA/I2C3_SDA/I2C3_SDA/I2C1_SDA | I2C#C_SDA |  | S | I2C3_SDA | I2C3_SDA | I2C3_SDA | DMA_I2C4_SDA | ADMA_I2C2_SDA | I2C3_SDA | I2C3_SDA | I2C4_SDA | I2C4_SDA | I2C1.SDA | I2C1_SDA
91 |  |  |  |  | JTAG_TDI | BOOT_MODE1 | SATA_RX_N | USB3_SS3_RX_N | USB3_SS3_RX_N | GPIO1_IO15 | GPIO1_IO15 | USB1_RX_N | USB1_RX_N | NC | MCU_GPIO0_5
92 | I2C3_SCL/DMA_I2C4_SCL/ADMA_I2C2_SCL/I2C3_SCL/I2C3_SCL/I2C1_SCL | I2C#C_SCL |  | S | I2C3_SCL | I2C3_SCL | I2C3_SCL | DMA_I2C4_SCL | ADMA_I2C2_SCL | I2C3_SCL | I2C3_SCL | I2C4_SCL | I2C4_SCL | I2C1.SCL | I2C1_SCL
93 |  |  |  |  | JTAG_TDO | BOOT_MODE0 | SATA_RX_P | USB3_SS3_RX_P | USB3_SS3_RX_P | GPIO4_IO10 | NC | USB1_RX_P | USB1_RX_P | NC | MCU_GPIO0_8
94 | GPIO1_IO04/CONN_USB_OTG2_ID/CONN_USB_OTG2_ID/USB1_ID/USB1_ID/GPIO1_50 | USB#B_OTG_ID |  | S | GPIO1_4 | USB_OTG1_ID | GPIO1_IO04 | CONN_USB_OTG2_ID | CONN_USB_OTG2_ID | USB1_ID | USB1_ID | USB1_ID | USB1_ID | USB1_ID | GPIO1_50
95 | GND | GND |  | P | DGND | DGND | GND | GND | GND | GND | GND | GND | GND | GND | GND
96 |  |  |  |  | UART5_CTS_B | UART7_CTS_B | UART5_CTS_B | LSIO_GPIO6_IO10 | CONN_ENET1_RGMII_TXC | GPIO1_IO06 | GPIO1_IO06 | GPIO4_IO17 | GPIO4_IO17 | GPIO4.IO[21] | GPIO0_88
97 |  |  |  |  | JTAG_TCK | NC | SATA_TX_P | USB3_SS3_TX_P | USB3_SS3_TX_P | NC | NC | USB1_TX_P | USB1_TX_P | NC | NC
98 | POR_B/POR_B_3V3/POR_B_3V3/PMIC_PWRON_B/PMIC_PWRON_B/SYS_nRSTIN_3V3 | POR_B#_3V3 |  | S | POR_B | POR_B | POR_B | POR_B_3V3 | POR_B_3V3 | PMIC_PWRON_B | PMIC_PWRON_B | PMIC_RST_B_3V3 | PMIC_RST_B_3V3 | SYS_NRST | SYS_nRSTIN_3V3
99 |  |  |  |  | JTAG_TMS | NC | SATA_TX_N | USB3_SS3_TX_N | USB3_SS3_TX_N | GPIO1_IO14 | GPIO1_IO14 | USB1_TX_N | USB1_TX_N | NC | MCU_GPIO0_6
100 | CLK1_N/PCIE_EXT_REFCLK100M_N/PCIE_EXT_REFCLK100M_N/PCIE1_REF_CLK_N/NC/NC | PCIE#A_REFCLK100M_N |  | S | CLK1_N | GPIO4_IO15 | CLK1_N | PCIE_EXT_REFCLK100M_N | PCIE_EXT_REFCLK100M_N | PCIE1_REF_CLK_N | NC | PCIE_REF_CLK_N | PCIE_REF_CLK_N | NC | NC
101 | GND | GND |  | P | DGND | DGND | GND | GND | GND | GND | GND | GND | GND | GND | GND
102 | CLK1_P/PCIE_EXT_REFCLK100M_P/PCIE_EXT_REFCLK100M_P/PCIE1_REF_CLK_P/NC/NC | PCIE#A_REFCLK100M_P |  | S | CLK1_P | GPIO4_IO11 | CLK1_P | PCIE_EXT_REFCLK100M_P | PCIE_EXT_REFCLK100M_P | PCIE1_REF_CLK_P | NC | PCIE_REF_CLK_P | PCIE_REF_CLK_P | NC | NC
103 | VCC_SOM | VCC_SOM |  | P | VCC_SOM | VCC_SOM | VCC_SOM | VCC_SOM | VCC_SOM | VCC_SOM | VCC_SOM | VCC_SOM | VCC_SOM | VCC_SOM | VCC_SOM
104 | USB_H1_VBUS/CONN_USB_OTG1_VBUS/CONN_USB_OTG1_VBUS/USB2_VBUS/NC/USB1_VBUS | USB#A_HOST_VBUS |  | S | USB_H1_VBUS_5V | USB_OTG2_VBUS | USB_H1_VBUS | CONN_USB_OTG1_VBUS | CONN_USB_OTG1_VBUS | USB2_VBUS | NC | USB2_VBUS | USB2_VBUS | USB2_VBUS_3V3 | USB1_VBUS
105 | VCC_SOM | VCC_SOM |  | P | VCC_SOM | VCC_SOM | VCC_SOM | VCC_SOM | VCC_SOM | VCC_SOM | VCC_SOM | VCC_SOM | VCC_SOM | VCC_SOM | VCC_SOM
106 | USB_OTG_VBUS/CONN_USB_OTG2_VBUS/CONN_USB_OTG2_VBUS/USB1_VBUS/USB1_VBUS/USB0_VBUS | USB#B_OTG_VBUS |  | S | USB_OTG_VBUS_5V | USB_OTG1_VBUS | USB_OTG_VBUS | CONN_USB_OTG2_VBUS | CONN_USB_OTG2_VBUS | USB1_VBUS | USB1_VBUS | USB1_VBUS | USB1_VBUS | USB1_VBUS_3V3 | USB0_VBUS
107 | VCC_SOM | VCC_SOM |  | P | VCC_SOM | VCC_SOM | VCC_SOM | VCC_SOM | VCC_SOM | VCC_SOM | VCC_SOM | VCC_SOM | VCC_SOM | VCC_SOM | VCC_SOM
108 | USB_HOST_DN/CONN_USB_OTG1_DN/CONN_USB_OTG1_DN/USB2_D_N/NC/USB1_DM | USB#A_HOST_DN |  | S | USB_H1_DN | USB_OTG2_DN | USB_HOST_DN | CONN_USB_OTG1_DN | CONN_USB_OTG1_DN | USB2_D_N | NC | USB2_D_N | USB2_D_N | USB2_DN | USB1_DM
109 | VCC_SOM | VCC_SOM |  | P | VCC_SOM | VCC_SOM | VCC_SOM | VCC_SOM | VCC_SOM | VCC_SOM | VCC_SOM | VCC_SOM | VCC_SOM | VCC_SOM | VCC_SOM
110 | USB_HOST_DP/CONN_USB_OTG1_DP/CONN_USB_OTG1_DP/USB2_D_P/NC/USB1_DP | USB#A_HOST_DP |  | S | USB_H1_DP | USB_OTG2_DP | USB_HOST_DP | CONN_USB_OTG1_DP | CONN_USB_OTG1_DP | USB2_D_P | NC | USB2_D_P | USB2_D_P | USB2_DP | USB1_DP
111 | VCC_SOM | VCC_SOM |  | P | VCC_SOM | VCC_SOM | VCC_SOM | VCC_SOM | VCC_SOM | VCC_SOM | VCC_SOM | VCC_SOM | VCC_SOM | VCC_SOM | VCC_SOM
112 | GND | GND |  | P | DGND | DGND | GND | GND | GND | GND | GND | GND | GND | GND | GND
113 |  |  |  |  | UART5_RTS_B | UART7_RTS_B | UART5_RTS_B | LSIO_GPIO6_IO11 | LSIO_GPIO0_IO02 | GPIO4_IO28 | GPIO4_IO28 | GPIO4_IO16 | GPIO4_IO16 | GPIO4.IO[20] | GPIO0_87
114 | USB_OTG_DN/CONN_USB_OTG2_DM/CONN_USB_OTG2_DM/USB1_D_N/USB1_D_N/USB0_DM | USB#B_OTG_DN |  | S | USB_OTG_DN | USB_OTG1_DN | USB_OTG_DN | CONN_USB_OTG2_DM | CONN_USB_OTG2_DM | USB1_D_N | USB1_D_N | USB1_D_N | USB1_D_N | USB1_DN | USB0_DM
115 | UART5_RX_DATA/DMA_UART4_RX/ADMA_UART2_RX/UART2_RXD/UART2_RXD/UART2_RXD | UART#B_RX |  | S | UART5_RX | UART7_RX | UART5_RX_DATA | DMA_UART4_RX | ADMA_UART2_RX | UART2_RXD | UART2_RXD | UART4_RXD | UART4_RXD | UART6.RX | UART2_RXD
116 | USB_OTG_DP/CONN_USB_OTG2_DP/CONN_USB_OTG2_DP/USB1_D_P/USB1_D_P/USB0_DP | USB#B_OTG_DP |  | S | USB_OTG_DP | USB_OTG1_DP | USB_OTG_DP | CONN_USB_OTG2_DP | CONN_USB_OTG2_DP | USB1_D_P | USB1_D_P | USB1_D_P | USB1_D_P | USB1_DP | USB0_DP
117 |  |  | J1_117-MIPI_CAM_OPT |  | UART4_CTS_B GPIO6_IO03 | UART8_CTS_B GPIO3_IO9 | GPIO6_IO03 | LSIO_GPIO4_IO00 | LSIO_GPIO3_IO23 | GPIO1_IO08 | GPIO1_IO08 | GPIO1_IO03 | GPIO1_IO03 | NC | GPIO1_11
118 | GND | GND |  | P | DGND | DGND | GND | GND | GND | GND | GND | GND | GND | GND | GND
119 | CSI_D0P/MIPI_CSI0_DP0/MIPI_CSI0_DP0/CSI_P1_D0_P/CSI_P1_D0_P/CSI0_RXP0 | MIPI_CSI#A_DATA0_P |  | S | CSI_DATA0_P | GPIO3_IO7 | CSI_D0P | MIPI_CSI0_DP0 | MIPI_CSI0_DP0 | CSI_P1_D0_P | CSI_P1_D0_P | MIPI_CSI1_D0_P | MIPI_CSI1_D0_P | CSI_D0_P | CSI0_RXP0
120 |  |  |  |  | GPIO5_IO21 | GPIO5_IO5 | GPIO5_IO21 | LSIO_GPIO6_IO17 | LSIO_GPIO0_IO11 | GPIO5_IO02 | GPIO5_IO02 | GPIO4_IO10 | GPIO4_IO10 | GPIO4.IO[22] | GPIO1_1
121 | CSI_D0M/MIPI_CSI0_DN0/MIPI_CSI0_DN0/CSI_P1_D0_N/CSI_P1_D0_N/CSI0_RXN0 | MIPI_CSI#A_DATA0_N |  | S | CSI_DATA0_N | GPIO3_IO8 | CSI_D0M | MIPI_CSI0_DN0 | MIPI_CSI0_DN0 | CSI_P1_D0_N | CSI_P1_D0_N | MIPI_CSI1_D0_N | MIPI_CSI1_D0_N | CSI_D0_N | CSI0_RXN0
122 |  |  |  |  | GPIO5_IO20 | GPIO5_IO9 | GPIO5_IO20 | LSIO_GPIO6_IO18 | LSIO_GPIO0_IO10 | GPIO1_IO12 | GPIO1_IO12 | GPIO4_IO06 | GPIO4_IO06 | GPIO4.IO[24] | GPIO1_3
123 | CSI_D1M/MIPI_CSI0_DN1/MIPI_CSI0_DN1/CSI_P1_D1_N/CSI_P1_D1_N/CSI0_RXN1 | MIPI_CSI#A_DATA1_N |  | S | CSI_DATA1_N | GPIO3_IO17 | CSI_D1M | MIPI_CSI0_DN1 | MIPI_CSI0_DN1 | CSI_P1_D1_N | CSI_P1_D1_N | MIPI_CSI1_D1_N | MIPI_CSI1_D1_N | CSI_D1_N | CSI0_RXN1
124 | UART4_TX_DATA/DMA_UART2_TX/ADMA_UART1_TX/UART3_TXD/UART3_TXD/UART6_TXD | UART#A_TX |  | S | UART4_TX | UART8_TX | UART4_TX_DATA | DMA_UART2_TX | ADMA_UART1_TX | UART3_TXD | UART3_TXD | UART1_TXD | UART1_TXD | UART7.TX | UART6_TXD
125 | CSI_D1P/MIPI_CSI0_DP1/MIPI_CSI0_DP1/CSI_P1_D1_P/CSI_P1_D1_P/CSI0_RXP1 | MIPI_CSI#A_DATA1_P |  | S | CSI_DATA1_P | GPIO3_IO18 | CSI_D1P | MIPI_CSI0_DP1 | MIPI_CSI0_DP1 | CSI_P1_D1_P | CSI_P1_D1_P | MIPI_CSI1_D1_P | MIPI_CSI1_D1_P | CSI_D1_P | CSI0_RXP1
126 | GND | GND |  | P | DGND | DGND | GND | GND | GND | GND | GND | GND | GND | GND | GND
127 | CSI_D2P/MIPI_CSI0_DP2/MIPI_CSI0_DP2/CSI_P1_D2_P/CSI_P1_D2_P/CSI0_RXP2 | MIPI_CSI#A_DATA2_P |  | S | CSI_DATA2_P | GPIO3_IO19 | CSI_D2P | MIPI_CSI0_DP2 | MIPI_CSI0_DP2 | CSI_P1_D2_P | CSI_P1_D2_P | MIPI_CSI1_D2_P | MIPI_CSI1_D2_P | NC | CSI0_RXP2
128 | PCIE_TXM/HSIO_PCIE0_TX0_N/HSIO_PCIE0_TX0_N/PCIE1_TX_N/NC/MCU_GPIO0_21 | PCIE#A_TX0_N |  | S | PCIE_TX_N | GPIO4_IO12 | PCIE_TXM | HSIO_PCIE0_TX0_N | HSIO_PCIE0_TX0_N | PCIE1_TX_N | NC | PCIE_TXN_N | PCIE_TXN_N | WIFI_HOST_WAKE | MCU_GPIO0_21
129 | CSI_D2M/MIPI_CSI0_DN2/MIPI_CSI0_DN2/CSI_P1_D2_N/CSI_P1_D2_N/CSI0_RXN2 | MIPI_CSI#A_DATA2_N |  | S | CSI_DATA2_N | GPIO3_IO20 | CSI_D2M | MIPI_CSI0_DN2 | MIPI_CSI0_DN2 | CSI_P1_D2_N | CSI_P1_D2_N | MIPI_CSI1_D2_N | MIPI_CSI1_D2_N | NC | CSI0_RXN2
130 | PCIE_TXP/HSIO_PCIE0_TX0_P/HSIO_PCIE0_TX0_P/PCIE1_TX_P/NC/MCU_RESETz | PCIE#A_TX0_P |  | S | PCIE_TX_P | USB_OTG1_CHD_B | PCIE_TXP | HSIO_PCIE0_TX0_P | HSIO_PCIE0_TX0_P | PCIE1_TX_P | NC | PCIE_TXN_P | PCIE_TXN_P | BT_DEV_WAKE | MCU_RESETz
131 | CSI_D3M/MIPI_CSI0_DN3/MIPI_CSI0_DN3/CSI_P1_D3_N/CSI_P1_D3_N/CSI0_RXN3 | MIPI_CSI#A_DATA3_N |  | S | CSI_DATA3_N | GPIO3_IO23 | CSI_D3M | MIPI_CSI0_DN3 | MIPI_CSI0_DN3 | CSI_P1_D3_N | CSI_P1_D3_N | MIPI_CSI1_D3_N | MIPI_CSI1_D3_N | GPIO1.IO[15] | CSI0_RXN3
132 | GND | GND |  | P | DGND | DGND | GND | GND | GND | GND | GND | GND | GND | GND | GND
133 | CSI_D3P/MIPI_CSI0_DP3/MIPI_CSI0_DP3/CSI_P1_D3_P/CSI_P1_D3_P/CSI0_RXP3 | MIPI_CSI#A_DATA3_P |  | S | CSI_DATA3_P | GPIO3_IO24 | CSI_D3P | MIPI_CSI0_DP3 | MIPI_CSI0_DP3 | CSI_P1_D3_P | CSI_P1_D3_P | MIPI_CSI1_D3_P | MIPI_CSI1_D3_P | NC | CSI0_RXP3
134 | PCIE_RXP/HSIO_PCIE0_RX0_P/HSIO_PCIE0_RX0_P/PCIE1_RX_P/NC/RESET_REQz | PCIE#A_RX0_P |  | S | PCIE_RX_P | GPIO4_IO16 | PCIE_RXP | HSIO_PCIE0_RX0_P | HSIO_PCIE0_RX0_P | PCIE1_RX_P | NC | PCIE_RXN_P | PCIE_RXN_P | BT_HOST_WAKE | RESET_REQz
135 | CSI_CLK0P/MIPI_CSI0_CKP/MIPI_CSI0_CKP/CSI_P1_CK_P/CSI_P1_CK_P/CSI0_RXCLKP | MIPI_CSI#A_CLK_P |  | S | CSI_CLK0_P | GPIO3_IO27 | CSI_CLK0P | MIPI_CSI0_CKP | MIPI_CSI0_CKP | CSI_P1_CK_P | CSI_P1_CK_P | MIPI_CSI1_CLK_P | MIPI_CSI1_CLK_P | CSI_CLK_P | CSI0_RXCLKP
136 | PCIE_RXM/HSIO_PCIE0_RX0_N/HSIO_PCIE0_RX0_N/PCIE1_RX_N/NC/MCU_ERRORn | PCIE#A_RX0_N |  | S | PCIE_RX_N | ONOFF | PCIE_RXM | HSIO_PCIE0_RX0_N | HSIO_PCIE0_RX0_N | PCIE1_RX_N | NC | PCIE_RXN_N | PCIE_RXN_N | PMIC_NINT | MCU_ERRORn
137 | CSI_CLK0M/MIPI_CSI0_CKN/MIPI_CSI0_CKN/CSI_P1_CK_N/CSI_P1_CK_N/CSI0_RXCLKN | MIPI_CSI#A_CLK_N |  | S | CSI_CLK0_N | GPIO3_IO28 | CSI_CLK0M | MIPI_CSI0_CKN | MIPI_CSI0_CKN | CSI_P1_CK_N | CSI_P1_CK_N | MIPI_CSI1_CLK_N | MIPI_CSI1_CLK_N | CSI_CLK_N | CSI0_RXCLKN
138 | GND | GND |  | P | DGND | DGND | GND | GND | GND | GND | GND | GND | GND | GND | GND
139 | GND | GND |  | P | DGND | DGND | GND | GND | GND | GND | GND | GND | GND | GND | GND
140 |  |  |  |  | DSI_CLK0_P | CCM_PMIC_STBY_REQ | DSI_CLK0_P | MIPI_DSI0_CLK_P | LSIO_GPIO3_IO20/*/LSIO_GPIO1_IO10 | PMIC_STBY_REQ | PMIC_STBY_REQ | USB2_RX_P | USB2_RX_P | BBSMMIX.PMIC_STBY_REQ | MCU_GPIO0_19
141 |  |  |  |  | DSI_DATA0_N | GPIO3_IO13 | DSI_DATA0_N | MIPI_DSI0_DATA0_N | LSIO_GPIO3_IO19/*/LSIO_GPIO1_IO12 | GPIO4_IO14 | NC | USB2_TX_N | USB2_TX_N | ETH_INT_1V8 | MCU_GPIO0_20
142 |  |  |  |  | DSI_CLK0_N | SNVS_PMIC_ON_REQ | DSI_CLK0_N | MIPI_DSI0_CLK_N | LSIO_GPIO3_IO18/*/LSIO_GPIO1_IO09 | PMIC_ON_REQ | PMIC_ON_REQ | USB2_RX_N | USB2_RX_N | BBSMMIX.PMIC_ON_REQ | MCU_GPIO0_11
143 |  |  |  |  | DSI_DATA0_P | GPIO3_IO14 | DSI_DATA0_P | MIPI_DSI0_DATA0_P | LSIO_GPIO3_IO21/*/LSIO_GPIO1_IO11 | ONOFF | ONOFF | USB2_TX_P | USB2_TX_P | BBSMMIX.ONOFF | MCU_GPIO0_12
144 | GND | GND |  | P | DGND | DGND | GND | GND | GND | GND | GND | GND | GND | GND | GND
145 |  |  |  |  | DSI_DATA1_N | GPIO3_IO4 | DSI_DATA1_N | MIPI_DSI0_DATA1_N | LSIO_GPIO3_IO22/*/LSIO_GPIO1_IO13 | GPIO4_IO07 | NC | EARC_N_HPD | EARC_N_HPD | NC | MCU_GPIO0_9
146 |  |  |  |  | HDMI_TX_DATA1_P | GPIO2_IO6 | HDMI_TX_DATA1_P | HDMI_TX0_DATA1_EDP1_P | SCU_DSC_BOOT_MODE1 | GPIO4_IO18 | NC | HDMI_TX1_P | HDMI_TX1_P | ANAMIX.ADC_IN0 | MCU_GPIO0_17
147 |  |  |  |  | DSI_DATA1_P | GPIO3_IO0 | DSI_DATA1_P | MIPI_DSI0_DATA1_P | LSIO_GPIO3_IO17/*/LSIO_GPIO1_IO14 | GPIO4_IO12 | NC | EARC_P_UTIL | EARC_P_UTIL | NC | MCU_GPIO0_10
148 |  |  |  |  | HDMI_TX_DATA1_N | GPIO2_IO5 | HDMI_TX_DATA1_N | HDMI_TX0_DATA1_EDP1_N | SNVS_TAMPER_OUT4 | GPIO1_IO15 | NC | HDMI_TX1_N | HDMI_TX1_N | ANAMIX.ADC_IN1 | MCU_GPIO0_18
149 | GND | GND |  | P | DGND | DGND | GND | GND | GND | GND | GND | GND | GND | GND | GND
150 |  |  |  |  | HDMI_TX_CLK_N | GPIO2_IO3 | HDMI_TX_CLK_N | HDMI_TX0_CLK_EDP3_N | SNVS_TAMPER_OUT0 | GPIO1_IO03 | GPIO1_IO03 | HDMI_TXC_N | HDMI_TXC_N | ANAMIX.ADC_IN2 | MCU_GPIO0_2
151 |  |  |  |  | HDMI_TX_DATA2_P | GPIO2_IO2 | HDMI_TX_DATA2_P | HDMI_TX0_DATA2_EDP0_P | SNVS_TAMPER_IN2 | GPIO4_IO06 | NC | HDMI_TX2_P | HDMI_TX2_P | ANAMIX.ADC_IN3 | MCU_GPIO0_3
152 |  |  |  |  | HDMI_TX_CLK_P | GPIO2_IO4 | HDMI_TX_CLK_P | HDMI_TX0_CLK_EDP3_P | SNVS_TAMPER_OUT1 | GPIO4_IO13 | NC | HDMI_TXC_P | HDMI_TXC_P | ANAMIX.CLKIN1 | MCU_GPIO0_4
153 |  |  |  |  | HDMI_TX_DATA2_N | GPIO2_IO7 | HDMI_TX_DATA2_N | HDMI_TX0_DATA2_EDP0_N | SNVS_TAMPER_IN1 | GPIO1_IO05 | GPIO1_IO05 | HDMI_TX2_N | HDMI_TX2_N | ANAMIX.CLKIN2 | MCU_GPIO0_1
154 |  |  |  |  | HDMI_TX_HPD | GPIO3_IO15 | HDMI_TX_HPD | HDMI_TX0_HPD | SNVS_TAMPER_IN3 | GPIO1_IO01 | GPIO1_IO01 | HDMI_HPD | HDMI_HPD | BBSMMIX.TAMPER0 | MCU_GPIO0_16
155 |  |  |  |  | HDMI_TX_DATA0_P | GPIO2_IO0 | HDMI_TX_DATA0_P | HDMI_TX0_DATA0_EDP2_P | SNVS_TAMPER_OUT3 | GPIO4_IO17 | NC | HDMI_TX0_P | HDMI_TX0_P | NC | MCU_GPIO0_14
156 |  |  |  |  | HDMI_TX_DDC_CEC | NC | HDMI_TX_DDC_CEC | HDMI_TX0_CEC / SNVS_TAMPER_IN0 | SNVS_TAMPER_IN0 | GPIO4_IO11 | NC | HDMI_CEC | HDMI_CEC | BBSMMIX.TAMPER1 | MCU_GPIO0_15
157 |  |  |  |  | HDMI_TX_DATA0_N | GPIO2_IO1 | HDMI_TX_DATA0_N | HDMI_TX0_DATA0_EDP2_N | SNVS_TAMPER_OUT2 | GPIO4_IO08 | NC | HDMI_TX0_N | HDMI_TX0_N | NC | MCU_GPIO0_13
158 | GND | GND |  | P | DGND | DGND | GND | GND | GND | GND | GND | GND | GND | GND | GND
159 | GND | GND |  | P | DGND | DGND | GND | GND | GND | GND | GND | GND | GND | GND | GND
160 | LVDS0_TX1_N/LVDS0_T0BN/MIPI_DSI0_DN1/DSI_TX1_N/*/LVDS0_CH0_TX1_N/DSI_TX1_N/*/LVDS0_CH0_TX1_N/OLDI0_A1N | LVDS#A_TX1_N |  | S | LVDS0_DATA1_N | LVDS_TX1_N | LVDS0_TX1_N | LVDS0_T0BN | MIPI_DSI0_DN1 | DSI_TX1_N/*/LVDS0_CH0_TX1_N | DSI_TX1_N/*/LVDS0_CH0_TX1_N | LVDS0_D1_N | LVDS0_D1_N | LVDS_TX1_N/*/DSI_D1_N | OLDI0_A1N
161 | LVDS0_TX0_N/LVDS0_T0AN/MIPI_DSI0_DN0/DSI_TX0_N/*/LVDS0_CH0_TX0_N/DSI_TX0_N/*/LVDS0_CH0_TX0_N/OLDI0_A0N | LVDS#A_TX0_N |  | S | LVDS0_DATA0_N | LVDS_TX0_N | LVDS0_TX0_N | LVDS0_T0AN | MIPI_DSI0_DN0 | DSI_TX0_N/*/LVDS0_CH0_TX0_N | DSI_TX0_N/*/LVDS0_CH0_TX0_N | LVDS0_D0_N | LVDS0_D0_N | LVDS_TX0_N/*/DSI_D0_N | OLDI0_A0N
162 | LVDS0_TX1_P/LVDS0_T0BP/MIPI_DSI0_DP1/DSI_TX1_P/*/LVDS0_CH0_TX1_P/DSI_TX1_P/*/LVDS0_CH0_TX1_P/OLDI0_A1P | LVDS#A_TX1_P |  | S | LVDS0_DATA1_P | LVDS_TX1_P | LVDS0_TX1_P | LVDS0_T0BP | MIPI_DSI0_DP1 | DSI_TX1_P/*/LVDS0_CH0_TX1_P | DSI_TX1_P/*/LVDS0_CH0_TX1_P | LVDS0_D1_P | LVDS0_D1_P | LVDS_TX1_P/*/DSI_D1_P | OLDI0_A1P
163 | LVDS0_TX0_P/LVDS0_T0AP/MIPI_DSI0_DP0/DSI_TX0_P/*/LVDS0_CH0_TX0_P/DSI_TX0_P/*/LVDS0_CH0_TX0_P/OLDI0_A0P | LVDS#A_TX0_P |  | S | LVDS0_DATA0_P | LVDS_TX0_P | LVDS0_TX0_P | LVDS0_T0AP | MIPI_DSI0_DP0 | DSI_TX0_P/*/LVDS0_CH0_TX0_P | DSI_TX0_P/*/LVDS0_CH0_TX0_P | LVDS0_D0_P | LVDS0_D0_P | LVDS_TX0_P/*/DSI_D0_P | OLDI0_A0P
164 | LVDS0_TX2_N/LVDS0_T0CN/MIPI_DSI0_DN2/DSI_TX2_N/*/LVDS0_CH0_TX2_N/DSI_TX2_N/*/LVDS0_CH0_TX2_N/OLDI0_A2N | LVDS#A_TX2_N |  | S | LVDS0_DATA2_N | LVDS_TX2_N | LVDS0_TX2_N | LVDS0_T0CN | MIPI_DSI0_DN2 | DSI_TX2_N/*/LVDS0_CH0_TX2_N | DSI_TX2_N/*/LVDS0_CH0_TX2_N | LVDS0_D2_N | LVDS0_D2_N | LVDS_TX2_N/*/DSI_D2_N | OLDI0_A2N
165 | LVDS0_TX3_N/LVDS0_T0DN/MIPI_DSI0_DN3/DSI_TX3_N/*/LVDS0_CH0_TX3_N/DSI_TX3_N/*/LVDS0_CH0_TX3_N/OLDI0_A3N | LVDS#A_TX3_N |  | S | LVDS0_DATA3_N | GPIO3_IO2 | LVDS0_TX3_N | LVDS0_T0DN | MIPI_DSI0_DN3 | DSI_TX3_N/*/LVDS0_CH0_TX3_N | DSI_TX3_N/*/LVDS0_CH0_TX3_N | LVDS0_D3_N | LVDS0_D3_N | LVDS_TX3_N/*/DSI_D3_N | OLDI0_A3N
166 | LVDS0_TX2_P/LVDS0_T0CP/MIPI_DSI0_DP2/DSI_TX2_P/*/LVDS0_CH0_TX2_P/DSI_TX2_P/*/LVDS0_CH0_TX2_P/OLDI0_A2P | LVDS#A_TX2_P |  | S | LVDS0_DATA2_P | LVDS_TX2_P | LVDS0_TX2_P | LVDS0_T0CP | MIPI_DSI0_DP2 | DSI_TX2_P/*/LVDS0_CH0_TX2_P | DSI_TX2_P/*/LVDS0_CH0_TX2_P | LVDS0_D2_P | LVDS0_D2_P | LVDS_TX2_P/*/DSI_D2_P | OLDI0_A2P
167 | LVDS0_TX3_P/LVDS0_T0DP/MIPI_DSI0_DP3/DSI_TX3_P/*/LVDS0_CH0_TX3_P/DSI_TX3_P/*/LVDS0_CH0_TX3_P/OLDI0_A3P | LVDS#A_TX3_P |  | S | LVDS0_DATA3_P | GPIO3_IO3 | LVDS0_TX3_P | LVDS0_T0DP | MIPI_DSI0_DP3 | DSI_TX3_P/*/LVDS0_CH0_TX3_P | DSI_TX3_P/*/LVDS0_CH0_TX3_P | LVDS0_D3_P | LVDS0_D3_P | LVDS_TX3_P/*/DSI_D3_P | OLDI0_A3P
168 | LVDS0_CLK_N/LVDS0_T0CLKN/MIPI_DSI0_CKN/DSI_CLK_N/*/LVDS0_CH0_CLK_N/DSI_CLK_N/*/LVDS0_CH0_CLK_N/OLDI0_CLK0N | LVDS#A_CLK_N |  | S | LVDS0_CLK_N | LVDS_CLK_N | LVDS0_CLK_N | LVDS0_T0CLKN | MIPI_DSI0_CKN | DSI_CLK_N/*/LVDS0_CH0_CLK_N | DSI_CLK_N/*/LVDS0_CH0_CLK_N | LVDS0_CLK_N | LVDS0_CLK_N | LVDS_CLK_N/*/DSI_CLK_N | OLDI0_CLK0N
169 | GND | GND |  | P | DGND | DGND | GND | GND | GND | GND | GND | GND | GND | GND | GND
170 | LVDS0_CLK_P/LVDS0_T0CLKP/MIPI_DSI0_CKP/DSI_CLK_P/*/LVDS0_CH0_CLK_P/DSI_CLK_P/*/LVDS0_CH0_CLK_P/OLDI0_CLK0P | LVDS#A_CLK_P |  | S | LVDS0_CLK_P | LVDS_CLK_P | LVDS0_CLK_P | LVDS0_T0CLKP | MIPI_DSI0_CKP | DSI_CLK_P/*/LVDS0_CH0_CLK_P | DSI_CLK_P/*/LVDS0_CH0_CLK_P | LVDS0_CLK_P | LVDS0_CLK_P | LVDS_CLK_P/*/DSI_CLK_P | OLDI0_CLK0P
171 | UART5_TX_DATA/DMA_UART4_TX/ADMA_UART2_TX/UART2_TXD/UART2_TXD/UART2_TXD | UART#B_TX |  | S | UART5_TX_D | UART7_TX | UART5_TX_DATA | DMA_UART4_TX | ADMA_UART2_TX | UART2_TXD | UART2_TXD | UART4_TXD | UART4_TXD | UART6.TX | UART2_TXD
172 | GND | GND |  | P | DGND | DGND | GND | GND | GND | GND | GND | GND | GND | GND | GND
173 |  |  |  |  | UART4_RTS_B | UART8_RTS_B | UART4_RTS_B | LSIO_GPIO3_IO31 | SNVS_TAMPER_IN4 | GPIO4_IO15 | NC | GPIO1_IO09 | GPIO1_IO09 | NC | GPIO0_18
174 | I2C2_SCL/DMA_I2C0_SCL or HDMI_TX0_DDC_SCL/ADMA_I2C3_SCL/I2C4_SCL/I2C4_SCL/I2C2_SCL | I2C#B_SCL |  | S | I2C2_SCL | I2C4_SCL | I2C2_SCL | DMA_I2C0_SCL or HDMI_TX0_DDC_SCL | ADMA_I2C3_SCL | I2C4_SCL | I2C4_SCL | I2C5_SCL | I2C5_SCL | I2C7.SCL | I2C2_SCL
175 | UART4_RX_DATA/DMA_UART2_RX/ADMA_UART1_RX/UART3_RXD/UART3_RXD/UART6_RXD | UART#A_RX |  | S | UART4_RX | UART8_RX | UART4_RX_DATA | DMA_UART2_RX | ADMA_UART1_RX | UART3_RXD | UART3_RXD | UART1_RXD | UART1_RXD | UART7.RX | UART6_RXD
176 | I2C2_SDA/DMA_I2C0_SDA or HDMI_TX0_DDC_SDA/ADMA_I2C3_SDA/I2C4_SDA/I2C4_SDA/I2C2_SDA | I2C#B_SDA |  | S | I2C2_SDA | I2C4_SDA | I2C2_SDA | DMA_I2C0_SDA or HDMI_TX0_DDC_SDA | ADMA_I2C3_SDA | I2C4_SDA | I2C4_SDA | I2C5_SDA | I2C5_SDA | I2C7.SDA | I2C2_SDA
177 |  |  |  |  | GPIO5_IO18 | GPIO5_IO8 | GPIO5_IO18 | LSIO_GPIO6_IO13 | LSIO_GPIO0_IO09 | GPIO4_IO11 | NC | GPIO4_IO13 | GPIO4_IO13 | GPIO4.IO[18] | GPIO0_90
178 | GND | GND |  | P | DGND | DGND | GND | GND | GND | GND | GND | GND | GND | GND | GND
179 | GND | GND |  | P | DGND | DGND | GND | GND | GND | GND | GND | GND | GND | GND | GND
180 | LVDS1_CLK_N/LVDS0_T1CLKN/MIPI_DSI1_CKN/LVDS0_CH1_CLK_N/LVDS0_CH1_CLK_N/OLDI0_CLK1N | LVDS#B_CLK_N |  | S | LVDS1_CLK_N | CCM_CLK1_N | LVDS1_CLK_N | LVDS0_T1CLKN | MIPI_DSI1_CKN | LVDS0_CH1_CLK_N | LVDS0_CH1_CLK_N | LVDS1_CLK_N | LVDS1_CLK_N | DSI_CLK_N/*/LVDS_CLK_N | OLDI0_CLK1N
181 | LVDS1_TX3_P/LVDS0_T1DP/*/MIPI_DSI0_DP3/**/HDMI_TX0_AUX_P/MIPI_DSI1_DP3/LVDS0_CH1_TX3_P/LVDS0_CH1_TX3_P/OLDI0_A7P | LVDS#B_TX3_P |  | S | LVDS1_DATA3_P | GPIO3_IO1 | LVDS1_TX3_P | LVDS0_T1DP/*/MIPI_DSI0_DP3/**/HDMI_TX0_AUX_P | MIPI_DSI1_DP3 | LVDS0_CH1_TX3_P | LVDS0_CH1_TX3_P | LVDS1_D3_P | LVDS1_D3_P | DSI_D3_P/*/LVDS_TX3_P | OLDI0_A7P
182 | LVDS1_CLK_P/LVDS0_T1CLKP/MIPI_DSI1_CKP/LVDS0_CH1_CLK_P/LVDS0_CH1_CLK_P/OLDI0_CLK1P | LVDS#B_CLK_P |  | S | LVDS1_CLK_P | CCM_CLK1_P | LVDS1_CLK_P | LVDS0_T1CLKP | MIPI_DSI1_CKP | LVDS0_CH1_CLK_P | LVDS0_CH1_CLK_P | LVDS1_CLK_P | LVDS1_CLK_P | DSI_CLK_P/*/LVDS_CLK_P | OLDI0_CLK1P
183 | LVDS1_TX3_N/LVDS0_T1DN/*/MIPI_DSI0_DN3/**/HDMI_TX0_AUX_M/MIPI_DSI1_DN3/LVDS0_CH1_TX3_N/LVDS0_CH1_TX3_N/OLDI0_A7N | LVDS#B_TX3_N |  | S | LVDS1_DATA3_N | NC | LVDS1_TX3_N | LVDS0_T1DN/*/MIPI_DSI0_DN3/**/HDMI_TX0_AUX_M | MIPI_DSI1_DN3 | LVDS0_CH1_TX3_N | LVDS0_CH1_TX3_N | LVDS1_D3_N | LVDS1_D3_N | DSI_D3_N/*/LVDS_TX3_N | OLDI0_A7N
184 | LVDS1_TX0_N/LVDS0_T1AN/MIPI_DSI1_DN0/LVDS0_CH1_TX0_N/LVDS0_CH1_TX0_N/OLDI0_A4N | LVDS#B_TX0_N |  | S | LVDS1_DATA0_N | NC | LVDS1_TX0_N | LVDS0_T1AN | MIPI_DSI1_DN0 | LVDS0_CH1_TX0_N | LVDS0_CH1_TX0_N | LVDS1_D0_N | LVDS1_D0_N | DSI_D0_N/*/LVDS_TX0_N | OLDI0_A4N
185 | GND | GND |  | P | DGND | DGND | GND | GND | GND | GND | GND | GND | GND | GND | GND
186 | LVDS1_TX0_P/LVDS0_T1AP/MIPI_DSI1_DP0/LVDS0_CH1_TX0_P/LVDS0_CH1_TX0_P/OLDI0_A4P | LVDS#B_TX0_P |  | S | LVDS1_DATA0_P | NC | LVDS1_TX0_P | LVDS0_T1AP | MIPI_DSI1_DP0 | LVDS0_CH1_TX0_P | LVDS0_CH1_TX0_P | LVDS1_D0_P | LVDS1_D0_P | DSI_D0_P/*/LVDS_TX0_P | OLDI0_A4P
187 | TS_X- | TP#_TS_X- |  | S | TS_X- | ADC IN3(TS) | TS_X- | TS_X- | TS_X- | TS_X- | TS_X- | TS_X- | TS_X- | TS_X- | TS_X-
188 | LVDS1_TX1_N/LVDS0_T1BN/MIPI_DSI1_DN1/LVDS0_CH1_TX1_N/LVDS0_CH1_TX1_N/OLDI0_A5N | LVDS#B_TX1_N |  | S | LVDS1_DATA1_N | NC | LVDS1_TX1_N | LVDS0_T1BN | MIPI_DSI1_DN1 | LVDS0_CH1_TX1_N | LVDS0_CH1_TX1_N | LVDS1_D1_N | LVDS1_D1_N | DSI_D1_N/*/LVDS_TX1_N | OLDI0_A5N
189 | TS_X+ | TP#_TS_X+ |  | S | TS_X+ | ADC IN4(TS) | TS_X+ | TS_X+ | TS_X+ | TS_X+ | TS_X+ | TS_X+ | TS_X+ | TS_X+ | TS_X+
190 | LVDS1_TX1_P/LVDS0_T1BP/MIPI_DSI1_DP1/LVDS0_CH1_TX1_P/LVDS0_CH1_TX1_P/OLDI0_A5P | LVDS#B_TX1_P |  | S | LVDS1_DATA1_P | NC | LVDS1_TX1_P | LVDS0_T1BP | MIPI_DSI1_DP1 | LVDS0_CH1_TX1_P | LVDS0_CH1_TX1_P | LVDS1_D1_P | LVDS1_D1_P | DSI_D1_P/*/LVDS_TX1_P | OLDI0_A5P
191 | TS_Y+ | TP#_TS_Y+ |  | S | TS_Y+ | ADC IN2(TS) | TS_Y+ | TS_Y+ | TS_Y+ | TS_Y+ | TS_Y+ | TS_Y+ | TS_Y+ | TS_Y+ | TS_Y+
192 | LVDS1_TX2_N/LVDS0_T1CN/*/MIPI_DSI0_DN2/MIPI_DSI1_DN2/LVDS0_CH1_TX2_N/LVDS0_CH1_TX2_N/OLDI0_A6N | LVDS#B_TX2_N |  | S | LVDS1_DATA2_N | NC | LVDS1_TX2_N | LVDS0_T1CN/*/MIPI_DSI0_DN2 | MIPI_DSI1_DN2 | LVDS0_CH1_TX2_N | LVDS0_CH1_TX2_N | LVDS1_D2_N | LVDS1_D2_N | DSI_D2_N/*/LVDS_TX2_N | OLDI0_A6N
193 | TS_Y- | TP#_TS_Y- |  | S | TS_Y- | ADC IN1(TS) | TS_Y- | TS_Y- | TS_Y- | TS_Y- | TS_Y- | TS_Y- | TS_Y- | TS_Y- | TS_Y-
194 | LVDS1_TX2_P/LVDS0_T1CP/*/MIPI_DSI0_DP2/MIPI_DSI1_DP2/LVDS0_CH1_TX2_P/LVDS0_CH1_TX2_P/OLDI0_A6P | LVDS#B_TX2_P |  | S | LVDS1_DATA2_P | NC | LVDS1_TX2_P | LVDS0_T1CP/*/MIPI_DSI0_DP2 | MIPI_DSI1_DP2 | LVDS0_CH1_TX2_P | LVDS0_CH1_TX2_P | LVDS1_D2_P | LVDS1_D2_P | DSI_D2_P/*/LVDS_TX2_P | OLDI0_A6P
195 | AC_AGND | AC#_AGND |  | P | AC_AGND/EMMC_BOOT | AC_AGND | AC_AGND | AC_AGND | AC_AGND | AC_AGND | AC_AGND | AC_AGND | AC_AGND | AC_AGND | AC_AGND
196 | AC_AGND/AC_HPOUTFB/AC_HPOUTFB/AC_HPOUTFB/AC_HPOUTFB/AC_HPOUTFB | AC#_HPOUTFB |  | S | AC_AGND | AC_AGND | AC_AGND | AC_HPOUTFB | AC_HPOUTFB | AC_HPOUTFB | AC_HPOUTFB | AC_HPOUTFB | AC_HPOUTFB | AC_HPOUTFB | AC_HPOUTFB
197 | AC_LINEIN1_LP | AC#_LINEIN_LP |  | S | AC_LINEIN_LP | AC_LINEIN_LP | AC_LINEIN1_LP | AC_LINEIN1_LP | AC_LINEIN1_LP | AC_LINEIN1_LP | AC_LINEIN1_LP | AC_LINEIN1_LP | AC_LINEIN1_LP | AC_LINEIN1_LP | AC_LINEIN1_LP
198 | AC_HPLOUT | AC#_HPLOUT |  | S | AC_HPLOUT | AC_HPLOUT | AC_HPLOUT | AC_HPLOUT | AC_HPLOUT | AC_HPLOUT | AC_HPLOUT | AC_HPLOUT | AC_HPLOUT | AC_HPLOUT | AC_HPLOUT
199 | AC_LINEIN1_RP | AC#_LINEIN_RP |  | S | AC_LINEIN_RP | AC_LINEIN_RP | AC_LINEIN1_RP | AC_LINEIN1_RP | AC_LINEIN1_RP | AC_LINEIN1_RP | AC_LINEIN1_RP | AC_LINEIN1_RP | AC_LINEIN1_RP | AC_LINEIN1_RP | AC_LINEIN1_RP
200 | AC_HPROUT | AC#_HPROUT |  | S | AC_HPROUT | AC_HPROUT | AC_HPROUT | AC_HPROUT | AC_HPROUT | AC_HPROUT | AC_HPROUT | AC_HPROUT | AC_HPROUT | AC_HPROUT | AC_HPROUT

Sheet: SymphonyConnectors
 | xxx | yyy | << Highlight | VAR-SOM-MX93
Symphony Header | Pin# | SOM_PIN | Symphony NetName | Alternate Function for Selected SOM (Cell E1) | Symphony Note | SOM Note
J13 | 1 | 79 | J1.79 | USDHC1.STROBE/FLEXSPI.A_DQS///FLEXIO1.FLEXIO[18]/GPIO3.IO[18] |  | 1.8V level signal
J13 | 3 | 48 | J1.48 | GPIO2.IO[10]/SPI3.SOUT/ISI.D[4]/LCDIF.D[6]/TPM4.EXTCLK/UART7.CTS_B/I2C8.SDA/FLEXIO1.FLEXIO[10] |  | 0
J13 | 5 | 84 | J1.84 | USDHC3.DATA0/FLEXSPI.A_DATA[0]///FLEXIO1.FLEXIO[22]/GPIO3.IO[22]/*/NC |  | 1.8V level signal USDHC3 cannot be used on WBD or WB
J13 | 7 | 173 | J1.173 | NC |  | 0
J13 | 9 | 154 | J1.154-HDMI_HPD | BBSMMIX.TAMPER0 |  | 1.8V level signal
J13 | 11 | 156 | J1.156-HDMI_DDCCEC | BBSMMIX.TAMPER1 |  | 1.8V level signal
J13 | 15 | 152 | J1.152-HDMI_CLKP | ANAMIX.CLKIN1/ANAMIX.ESD_DIODE |  | 1.8V level signal. Has an internal 100k Pull down.
J13 | 16 | 155 | J1.155-HDMI_D0P | NC |  | 0
J13 | 17 | 150 | J1.150-HDMI_CLKM | ANAMIX.ADC_IN2 |  | 1.8V level signal
J13 | 18 | 157 | J1.157-HDMI_D0M | NC |  | 0
J13 | 21 | 151 | J1.151-HDMI_D2P | ANAMIX.ADC_IN3 |  | 1.8V level signal
J13 | 22 | 146 | J1.146-HDMI_D1P | ANAMIX.ADC_IN0 |  | 1.8V level signal
J13 | 23 | 153 | J1.153-HDMI_D2M | ANAMIX.CLKIN2/ANAMIX.ATX |  | 1.8V level signal. Has an internal 100k Pull down.
J13 | 24 | 148 | J1.148-HDMI_D1M | ANAMIX.ADC_IN1 |  | 1.8V level signal
J18 | 1 | 68 | PWM#B_CPT_INT | GPIO2.IO[25]/USDHC3.DATA1/CAN2.TX/LCDIF.D[21]/TPM4.CH3/DAP.TCLK_SWCLK/SPI7.PCS1/FLEXIO1.FLEXIO[25] |  | 0
J18 | 2 | 69 | PWM#C | GPIO2.IO[27]/USDHC3.DATA3/CAN2.RX/LCDIF.D[23]/TPM6.CH3/DAP.TMS_SWDIO/SPI5.PCS1/FLEXIO1.FLEXIO[27] |  | 0
J18 | 3 | 124 | UART#A_TX | GPIO2.IO[8]/SPI3.PCS0/ISI.D[2]/LCDIF.D[4]/TPM6.CH0/UART7.TX/I2C7.SDA/FLEXIO1.FLEXIO[8] |  | 0
J18 | 4 | 52 | UART#BT_TX | DAP.TDO_TRACESWO/MQS2.RIGHT//CAN2.RX/FLEXIO1.FLEXIO[31]/GPIO3.IO[31]/UART5.TX |  | 1.8V level signal UART can be used if BT disabled
J18 | 5 | 175 | UART#A_RX | GPIO2.IO[9]/SPI3.SIN/ISI.D[3]/LCDIF.D[5]/TPM3.EXTCLK/UART7.RX/I2C7.SCL/FLEXIO1.FLEXIO[9] |  | 0
J18 | 6 | 53 | UART#BT_RX | DAP.TDI/MQS2.LEFT//CAN2.TX/FLEXIO2.FLEXIO[30]/GPIO3.IO[28]/UART5.RX |  | 1.8V level signal UART can be used if BT disabled
J18 | 7 | 171 | UART#B_TX | GPIO2.IO[4]/TPM3.CH0/PDM.CLK/LCDIF.D[0]/SPI7.PCS0/UART6.TX/I2C6.SDA/FLEXIO1.FLEXIO[4] |  | 0
J18 | 8 | 51 | UART#BT_CTS_B | DAP.TCLK_SWCLK////FLEXIO1.FLEXIO[30]/GPIO3.IO[30]/UART5.CTS_B |  | 1.8V level signal UART can be used if BT disabled
J18 | 9 | 115 | UART#B_RX | GPIO2.IO[5]/TPM4.CH0/PDM.BIT_STREAM[0]/LCDIF.D[1]/SPI7.SIN/UART6.RX/I2C6.SCL/FLEXIO1.FLEXIO[5] |  | 0
J18 | 10 | 50 | UART#BT_RTS_B | DAP.TMS_SWDIO////FLEXIO2.FLEXIO[31]/GPIO3.IO[29]/UART5.RTS_B |  | 1.8V level signal UART can be used if BT disabled. Has an internal 10K pull down.
J3 | 5 | 141 | J1.141-DSI_D0M | ETH_INT_1V8 |  | 1.8V level signal
J3 | 6 | 143 | J1.143-DSI_D0P | BBSMMIX.ONOFF |  | 1.8V level signal. Has an internal 100k Pull up.
J3 | 8 | 145 | J1.145-DSI_D1M | USDHC3.CLK/FLEXSPI.A_SCLK///FLEXIO1.FLEXIO[20]/GPIO3.IO[20]/*/NC |  | 1.8V level signal USDHC3 cannot be used on WBD or WB
J3 | 9 | 147 | J1.147-DSI_D1P | USDHC3.CMD/FLEXSPI.A_SS0_B///FLEXIO1.FLEXIO[21]/GPIO3.IO[21]/*/NC |  | 1.8V level signal USDHC3 cannot be used on WBD or WB
J3 | 11 | 57 |  | ENET2.RGMII_RXC/ENET2.RX_ER/SAI2.TX_DATA[1]//FLEXIO2.FLEXIO[23]/GPIO4.IO[23] |  | 1.8V level signal
J3 | 12 |  | CB-USB#A_HOST_PWR | SymphonyBoard USB#A power switch control input (U22.2) | For v1.3 compatibility add short to J3.18
J3 | 14 | 142 | J1.142-DSI_CLK0M | BBSMMIX.PMIC_ON_REQ |  | 1.8V level signal. Has an internal 100k Pull down.
J3 | 15 | 140 | J1.140-DSI_CLK0P | BBSMMIX.PMIC_STBY_REQ |  | 1.8V level signal. Has an internal 100k Pull down.
J3 | 17 |  | CB_WDOG_B | SymphonyBoard reset circuitry reset input (U7.3)
J3 | 18 | 82 | J1.82-USB#A_HOST_PWR | NC | For v1.3 compatibility add short to J3.12 | 0
J3 | 19 | 17 | PWM#A | GPIO2.IO[24]/USDHC3.DATA0//LCDIF.D[20]/TPM3.CH3/DAP.TDO_TRACESWO/SPI6.PCS1/FLEXIO1.FLEXIO[24] |  | 0
J4 | 1 | 87 | I2C#A_SDA | GPIO2.IO[22]/USDHC3.CLK/SPDIF1.IN/LCDIF.D[18]/TPM5.CH1/TPM6.EXTCLK/I2C5.SDA/FLEXIO1.FLEXIO[22] |  | 0
J4 | 2 | 88 | I2C#A_SCL | GPIO2.IO[23]/USDHC3.CMD/SPDIF1.OUT/LCDIF.D[19]/TPM6.CH1//I2C5.SCL/FLEXIO1.FLEXIO[23] |  | 0
J17 | 1 | 86 | J1.86-MIPI_CAM_BUF_CTL | GPIO2.IO[17]/SAI3.MCLK/ISI.D[8]/LCDIF.D[13]/UART3.RTS_B/SPI4.PCS1/UART4.RTS_B/FLEXIO1.FLEXIO[17] |  | 0
J17 | 2 | 40 | J1.40-MIPI_CAM_RST | CCMSRCGPCMIX.CLKO2////FLEXIO1.FLEXIO[27]/GPIO3.IO[27] |  | 1.8V level signal
J17 | 3 | 84 | J1.84 | USDHC3.DATA0/FLEXSPI.A_DATA[0]///FLEXIO1.FLEXIO[22]/GPIO3.IO[22]/*/NC |  | 1.8V level signal USDHC3 cannot be used on WBD or WB
J17 | 4 | 70 | J1.70-MIPI_CAM_SYNC | NC |  | 0
J17 | 5 | 48 | J1.48 | GPIO2.IO[10]/SPI3.SOUT/ISI.D[4]/LCDIF.D[6]/TPM4.EXTCLK/UART7.CTS_B/I2C8.SDA/FLEXIO1.FLEXIO[10] |  | 0
J17 | 6 | 75 | J1.75-MIPI_CAM_TRIGGER | CCMSRCGPCMIX.CLKO3////FLEXIO2.FLEXIO[28]/GPIO4.IO[28] |  | 1.8V level signal
J17 | 7 | 117 | J1.117-MIPI_CAM_OPT | NC |  | 0
J17 | 8 | 77 | J1.77-MIPI_CSI_PWDN | GPIO2.IO[11]/SPI3.SCK/ISI.D[5]/LCDIF.D[7]/TPM5.EXTCLK/UART7.RTS_B/I2C8.SCL/FLEXIO1.FLEXIO[11] |  | 0
J17 | 9 | 173 | J1.173 | NC |  | 0
J17 | 10 | 79 | J1.79 | USDHC1.STROBE/FLEXSPI.A_DQS///FLEXIO1.FLEXIO[18]/GPIO3.IO[18] |  | 1.8V level signal
J16 | 1 | 23 | SAI#A_RXFS_PCIE#A_RESET_B | GPIO2.IO[19]/SAI3.RX_SYNC/PDM.BIT_STREAM[3]/LCDIF.D[15]/SPI5.SIN/SPI4.SIN/TPM6.CH2/SAI3.TX_DATA[0] |  | 0
J16 | 2 | 43 | SPI#A_SCK | GPIO2.IO[3]/I2C4.SCL/ISI.LINE_VALID/LCDIF.HSYNC/SPI6.SCK/UART5.RTS_B/I2C6.SCL/FLEXIO1.FLEXIO[3] |  | 0
J16 | 3 | 25 | SAI#A_TXC | GPIO2.IO[16]/SAI3.TX_BCLK/PDM.BIT_STREAM[2]/LCDIF.D[12]/UART3.CTS_B/SPI4.PCS2/UART4.CTS_B/FLEXIO1.FLEXIO[16] |  | 0
J16 | 4 | 39 | SPI#A_CS0 | GPIO2.IO[0]/I2C3.SDA/ISI.PCLK/LCDIF.PCLK/SPI6.PCS0/UART5.TX/I2C5.SDA/FLEXIO1.FLEXIO[0] |  | I2C3 used internally by Codec, PMIC, EEPROM
J16 | 5 | 21 | SAI#A_RXD | GPIO2.IO[20]/SAI3.RX_DATA[0]/PDM.BIT_STREAM[0]/LCDIF.D[16]/SPI5.SOUT/SPI4.SOUT/TPM3.CH1/FLEXIO1.FLEXIO[20] |  | 0
J16 | 6 | 41 | SPI#A_SDI | GPIO2.IO[1]/I2C3.SCL/ISI.D[0]/LCDIF.DE/SPI6.SIN/UART5.RX/I2C5.SCL/FLEXIO1.FLEXIO[1] |  | I2C3 used internally by Codec, PMIC, EEPROM
J16 | 7 | 26 | SAI#A_TXD | GPIO2.IO[21]/SAI3.TX_DATA[0]/PDM.CLK/LCDIF.D[17]/SPI5.SCK/SPI4.SCK/TPM4.CH1/SAI3.RX_BCLK |  | 0
J16 | 8 | 45 | SPI#A_SDO | GPIO2.IO[2]/I2C4.SDA/ISI.FRAME_VALID/LCDIF.VSYNC/SPI6.SOUT/UART5.CTS_B/I2C6.SDA/FLEXIO1.FLEXIO[2] |  | 0
J16 | 9 | 24 | SAI#A_TXFS | GPIO2.IO[26]/USDHC3.DATA2/PDM.BIT_STREAM[1]/LCDIF.D[22]/TPM5.CH3/DAP.TDI/SPI8.PCS1/SAI3.TX_SYNC |  | 0
J16 | 10 | 174 | I2C#B_SCL | GPIO2.IO[7]/SPI3.PCS1/ISI.D[1]/LCDIF.D[3]/SPI7.SCK/UART6.RTS_B/I2C7.SCL/FLEXIO1.FLEXIO[7] |  | 0
J16 | 11 | 22 | SAI#A_RXC_USDHC#A_RESET_B | GPIO2.IO[18]/SAI3.RX_BCLK/ISI.D[9]/LCDIF.D[14]/SPI5.PCS0/SPI4.PCS0/TPM5.CH2/FLEXIO1.FLEXIO[18] |  | 0
J16 | 12 | 176 | I2C#B_SDA | GPIO2.IO[6]/TPM5.CH0/PDM.BIT_STREAM[1]/LCDIF.D[2]/SPI7.SOUT/UART6.CTS_B/I2C7.SDA/FLEXIO1.FLEXIO[6] |  | 0
J16 | 13 | 92 | I2C#C_SCL | I2C1.SCL/I3C1.SCL/UART1.DCB_B/TPM2.CH0//GPIO1.IO[0] |  | 0
J16 | 14 | 88 | I2C#A_SCL | GPIO2.IO[23]/USDHC3.CMD/SPDIF1.OUT/LCDIF.D[19]/TPM6.CH1//I2C5.SCL/FLEXIO1.FLEXIO[23] |  | 0
J16 | 15 | 90 | I2C#C_SDA | I2C1.SDA/I3C1.SDA/UART1.RIN_B/TPM2.CH1//GPIO1.IO[1] |  | 0
J16 | 16 | 87 | I2C#A_SDA | GPIO2.IO[22]/USDHC3.CLK/SPDIF1.IN/LCDIF.D[18]/TPM5.CH1/TPM6.EXTCLK/I2C5.SDA/FLEXIO1.FLEXIO[22] |  | 0
J16 | 17 | 72 | J1.72-USB3_INTB | PDM.BIT_STREAM[1]/M33.NMI/SPI2.PCS1/TPM2.EXTCLK/LPTMR1.ALT3/GPIO1.IO[10] |  | 0
J16 | 18 | #N/A | CANL0 | #N/A | Via U13 CAN PHY chip on Symphony
J16 | 20 | #N/A | CANH0 | #N/A | Via U13 CAN PHY chip on Symphony
U13 | 1 | 44 | FLEXCAN#A_TX | PDM.CLK/MQS1.LEFT///LPTMR1.ALT1/GPIO1.IO[8]/CAN1.TX |  | 0
U13 | 4 | 46 | FLEXCAN#A_RX | PDM.BIT_STREAM[0]/MQS1.RIGHT/SPI1.PCS1/TPM1.EXTCLK/LPTMR1.ALT2/GPIO1.IO[9]/CAN1.RX |  | 0
J30 | 3 | 193 | TP#_TS_Y- | GPIO2.IO[13]/TPM4.CH2/PDM.BIT_STREAM[3]/LCDIF.D[9]/SPI8.SIN/UART8.RX/I2C8.SCL/FLEXIO1.FLEXIO[13]/*/TS_Y- |  | 0
J30 | 4 | 56 | J1.56-ENET1_RGMII_TXD2 | ENET2.RGMII_TD2/INPUT=ENET2.TX_CLK OUTPUT=CCMSRCGPCMIX.ENET_REF_CLK_ROOT/SAI2.RX_DATA[1]//FLEXIO2.FLEXIO[17]/GPIO4.IO[17] | Via U8 U10 switch; Set EXP_ENET_SEL = L | 1.8V level signal
J30 | 5 | 191 | TP#_TS_Y+ | GPIO2.IO[12]/TPM3.CH2/PDM.BIT_STREAM[2]/LCDIF.D[8]/SPI8.PCS0/UART8.TX/I2C8.SDA/SAI3.RX_SYNC/*/TS_Y+ |  | 0
J30 | 6 | 55 | J1.55-ENET1_RGMII_TXD3 | ENET2.RGMII_TD3//SAI2.RX_DATA[0]//FLEXIO2.FLEXIO[16]/GPIO4.IO[16] | Via U8 U10 switch; Set EXP_ENET_SEL = L | 1.8V level signal
J30 | 7 | 189 | TP#_TS_X+ | GPIO2.IO[15]/UART3.RX/ISI.D[7]/LCDIF.D[11]/SPI8.SCK/UART8.RTS_B/UART4.RX/FLEXIO1.FLEXIO[15]/*/TS_X+ |  | 0
J30 | 8 | 73 | J1.73-ENET1_RGMII_TXD0 | ENET2.RGMII_TD0/UART4.TX/SAI2.RX_DATA[3]//FLEXIO2.FLEXIO[19]/GPIO4.IO[19] | Via U8 U10 switch; Set EXP_ENET_SEL = L | 1.8V level signal
J30 | 9 | 187 | TP#_TS_X- | GPIO2.IO[14]/UART3.TX/ISI.D[6]/LCDIF.D[10]/SPI8.SOUT/UART8.CTS_B/UART4.TX/FLEXIO1.FLEXIO[14]/*/TS_X- |  | 0
J30 | 10 | 96 | J1.96-ENET1_RGMII_TXC | ENET2.RGMII_TXC/ENET2.TX_ER/SAI2.TX_BCLK//FLEXIO2.FLEXIO[21]/GPIO4.IO[21] | Via U8 U10 switch; Set EXP_ENET_SEL = L | 1.8V level signal
J30 | 11 | 71 | J1.71-ENET1_RGMII_RXD2 | ENET2.RGMII_RD2/UART4.CTS_B/SAI2.MCLK/MQS2.RIGHT/FLEXIO2.FLEXIO[26]/GPIO4.IO[26] | Via U8 U10 switch; Set EXP_ENET_SEL = L | 1.8V level signal
J30 | 12 | 113 | J1.113-ENET1_RGMII_TX_CTL | ENET2.RGMII_TX_CTL/UART4.DTR_B/SAI2.TX_SYNC//FLEXIO2.FLEXIO[20]/GPIO4.IO[20] | Via U8 U10 switch; Set EXP_ENET_SEL = L | 1.8V level signal
J30 | 13 | 81 | J1.81-ENET1_RGMII_RXD1 | ENET2.RGMII_RD1/SPDIF1.IN/SAI2.TX_DATA[3]//FLEXIO2.FLEXIO[25]/GPIO4.IO[25] | Via U8 U10 switch; Set EXP_ENET_SEL = L | 1.8V level signal
J30 | 14 | 177 | J1.177-ENET1_RGMII_TXD1 | ENET2.RGMII_TD1/UART4.RTS_B/SAI2.RX_DATA[2]//FLEXIO2.FLEXIO[18]/GPIO4.IO[18] | Via U8 U10 switch; Set EXP_ENET_SEL = L | 1.8V level signal
J30 | 15 | 122 | J1.122-ENET1_RGMII_RXD0 | ENET2.RGMII_RD0/UART4.RX/SAI2.TX_DATA[2]//FLEXIO2.FLEXIO[24]/GPIO4.IO[24] | Via U8 U10 switch; Set EXP_ENET_SEL = L | 1.8V level signal
J30 | 16 | 57 | J1.57-ENET1_RGMII_RXC | ENET2.RGMII_RXC/ENET2.RX_ER/SAI2.TX_DATA[1]//FLEXIO2.FLEXIO[23]/GPIO4.IO[23] | Via U8 U10 switch; Set EXP_ENET_SEL = L | 1.8V level signal
J30 | 17 | 120 | J1.120-ENET1_RGMII_RX_CTL | ENET2.RGMII_RX_CTL/UART4.DSR_B/SAI2.TX_DATA[0]//FLEXIO2.FLEXIO[22]/GPIO4.IO[22] | Via U8 U10 switch; Set EXP_ENET_SEL = L | 1.8V level signal
J30 | 18 | 54 | J1.54-ENET1_RGMII_RXD3 | ENET2.RGMII_RD3/SPDIF1.OUT/SPDIF1.IN/MQS2.LEFT/FLEXIO2.FLEXIO[27]/GPIO4.IO[27] | Via U8 U10 switch; Set EXP_ENET_SEL = L | 1.8V level signal
 |  |  |  |  | Note: U8 U10 do not exist as of Symphony V1.4
J5 | 5 | 184 | LVDS#B_TX0_N | DSI_D0_N/*/LVDS_TX0_N |  | 0
J5 | 6 | 186 | LVDS#B_TX0_P | DSI_D0_P/*/LVDS_TX0_P |  | 0
J5 | 8 | 188 | LVDS#B_TX1_N | DSI_D1_N/*/LVDS_TX1_N |  | 0
J5 | 9 | 190 | LVDS#B_TX1_P | DSI_D1_P/*/LVDS_TX1_P |  | 0
J5 | 11 | 192 | LVDS#B_TX2_N | DSI_D2_N/*/LVDS_TX2_N |  | 0
J5 | 12 | 194 | LVDS#B_TX2_P | DSI_D2_P/*/LVDS_TX2_P |  | 0
J5 | 14 | 180 | LVDS#B_CLK_N | DSI_CLK_N/*/LVDS_CLK_N |  | 0
J5 | 15 | 182 | LVDS#B_CLK_P | DSI_CLK_P/*/LVDS_CLK_P |  | 0
J5 | 19 | 17 | PWM#A | GPIO2.IO[24]/USDHC3.DATA0//LCDIF.D[20]/TPM3.CH3/DAP.TDO_TRACESWO/SPI6.PCS1/FLEXIO1.FLEXIO[24] |  | 0
J6 | 1 | 183 | LVDS#B_TX3_N | DSI_D3_N/*/LVDS_TX3_N |  | 0
J6 | 2 | 181 | LVDS#B_TX3_P | DSI_D3_P/*/LVDS_TX3_P |  | 0
J7 | 5 | 161 | LVDS#A_TX0_N | LVDS_TX0_N/*/DSI_D0_N |  | 0
J7 | 6 | 163 | LVDS#A_TX0_P | LVDS_TX0_P/*/DSI_D0_P |  | 0
J7 | 8 | 160 | LVDS#A_TX1_N | LVDS_TX1_N/*/DSI_D1_N |  | 0
J7 | 9 | 162 | LVDS#A_TX1_P | LVDS_TX1_P/*/DSI_D1_P |  | 0
J7 | 11 | 164 | LVDS#A_TX2_N | LVDS_TX2_N/*/DSI_D2_N |  | 0
J7 | 12 | 166 | LVDS#A_TX2_P | LVDS_TX2_P/*/DSI_D2_P |  | 0
J7 | 14 | 168 | LVDS#A_CLK_N | LVDS_CLK_N/*/DSI_CLK_N |  | 0
J7 | 15 | 170 | LVDS#A_CLK_P | LVDS_CLK_P/*/DSI_CLK_P |  | 0
J7 | 19 | 17 | PWM#A | GPIO2.IO[24]/USDHC3.DATA0//LCDIF.D[20]/TPM3.CH3/DAP.TDO_TRACESWO/SPI6.PCS1/FLEXIO1.FLEXIO[24] |  | 0
J8 | 1 | 165 | LVDS#A_TX3_N | LVDS_TX3_N/*/DSI_D3_N |  | 0
J8 | 2 | 167 | LVDS#A_TX3_P | LVDS_TX3_P/*/DSI_D3_P |  | 0
J10 | 1 | 187 | TP#_TS_X-_CONN | GPIO2.IO[14]/UART3.TX/ISI.D[6]/LCDIF.D[10]/SPI8.SOUT/UART8.CTS_B/UART4.TX/FLEXIO1.FLEXIO[14]/*/TS_X- | Via resistor R13 | 0
J10 | 2 | 191 | TP#_TS_Y+_CONN | GPIO2.IO[12]/TPM3.CH2/PDM.BIT_STREAM[2]/LCDIF.D[8]/SPI8.PCS0/UART8.TX/I2C8.SDA/SAI3.RX_SYNC/*/TS_Y+ | Via resistor R10 | 0
J10 | 3 | 189 | TP#_TS_X+_CONN | GPIO2.IO[15]/UART3.RX/ISI.D[7]/LCDIF.D[11]/SPI8.SCK/UART8.RTS_B/UART4.RX/FLEXIO1.FLEXIO[15]/*/TS_X+ | Via resistor R12 | 0
J10 | 4 | 193 | TP#_TS_Y-_CONN | GPIO2.IO[13]/TPM4.CH2/PDM.BIT_STREAM[3]/LCDIF.D[9]/SPI8.SIN/UART8.RX/I2C8.SCL/FLEXIO1.FLEXIO[13]/*/TS_Y- | Via resistor R8 | 0
J11 | 1 |  | CPT_RST |  | Cap touch reset - only 10K PU.
J11 | 2 | 90 | I2C#C_SDA | I2C1.SDA/I3C1.SDA/UART1.RIN_B/TPM2.CH1//GPIO1.IO[1] |  | 0
J11 | 3 | 92 | I2C#C_SCL | I2C1.SCL/I3C1.SCL/UART1.DCB_B/TPM2.CH0//GPIO1.IO[0] |  | 0
J11 | 4 | 68 | PWM#B_CPT_INT | GPIO2.IO[25]/USDHC3.DATA1/CAN2.TX/LCDIF.D[21]/TPM4.CH3/DAP.TCLK_SWCLK/SPI7.PCS1/FLEXIO1.FLEXIO[25] |  | 0
J19 | 11 | 119 | MIPI_CSI#A_DATA0_P | CSI_D0_P |  | 0
J19 | 13 | 121 | MIPI_CSI#A_DATA0_N | CSI_D0_N |  | 0
J19 | 17 | 135 | MIPI_CSI#A_CLK_P | CSI_CLK_P |  | 0
J19 | 19 | 137 | MIPI_CSI#A_CLK_N | CSI_CLK_N |  | 0
J19 | 23 | 125 | MIPI_CSI#A_DATA1_P | CSI_D1_P |  | 0
J19 | 25 | 123 | MIPI_CSI#A_DATA1_N | CSI_D1_N |  | 0
J19 | 29 | 127 | MIPI_CSI#A_DATA2_P | NC |  | 0
J19 | 31 | 129 | MIPI_CSI#A_DATA2_N | NC |  | 0
J19 | 35 | 133 | MIPI_CSI#A_DATA3_P | NC |  | 0
J19 | 37 | 131 | MIPI_CSI#A_DATA3_N | WDOG1.WDOG_ANY/////GPIO1.IO[15] |  | Used internally to connect to PMIC. Has an internal 100k Pull up
J19 | 41 | 75 | J1.75-MIPI_CAM_TRIGGER_1V8 | CCMSRCGPCMIX.CLKO3////FLEXIO2.FLEXIO[28]/GPIO4.IO[28] | Input from SOM; Unidirectional buffer; 1.8V Level | 1.8V level signal
J19 | 45 | 70 | J1.70-MIPI_CAM_SYNC_1V8 | NC | Output to SOM; Unidirectional buffer; 1.8V Level | 0
J19 | 47 | 117 | J1.117-MIPI_CAM_OPT_1V8 | NC | Output to SOM; Unidirectional buffer; 1.8V Level | 0
J19 | 49 | 40 | J1.40-MIPI_CAM_RST_B_1V8 | CCMSRCGPCMIX.CLKO2////FLEXIO1.FLEXIO[27]/GPIO3.IO[27] | Input from SOM; Unidirectional buffer; 1.8V Level | 1.8V level signal
J19 | 51 | 77 | J1.77-MIPI_CSI_PWDN_1V8 | GPIO2.IO[11]/SPI3.SCK/ISI.D[5]/LCDIF.D[7]/TPM5.EXTCLK/UART7.RTS_B/I2C8.SCL/FLEXIO1.FLEXIO[11] | Input from SOM; Unidirectional buffer; 1.8V Level | 0
J19 | 55 | 88 | CAM_I2C_SCL | GPIO2.IO[23]/USDHC3.CMD/SPDIF1.OUT/LCDIF.D[19]/TPM6.CH1//I2C5.SCL/FLEXIO1.FLEXIO[23] | Via I2C level translator; 1.8V Levels | 0
J19 | 57 | 87 | CAM_I2C_SDA | GPIO2.IO[22]/USDHC3.CLK/SPDIF1.IN/LCDIF.D[18]/TPM5.CH1/TPM6.EXTCLK/I2C5.SDA/FLEXIO1.FLEXIO[22] | Via I2C level translator; 1.8V Levels | 0
 |  | 86 | J1.86-MIPI_CAM_BUF_CTL | GPIO2.IO[17]/SAI3.MCLK/ISI.D[8]/LCDIF.D[13]/UART3.RTS_B/SPI4.PCS1/UART4.RTS_B/FLEXIO1.FLEXIO[17] | Pins 10-12-14-16-20 buffer control; Include PU 10K | 0
J29 | 2 |  | USB_DEBUG_DM_C | Debug console UART via USB bridge signal | Via U23 buffer
J29 | 3 |  | USB_DEBUG_DP_C | Debug console UART via USB bridge signal | Via U23 buffer
U23 | 4 | 83 | UART#_DEBUG_RX | UART1.RX/SECO.RX/SPI2.SIN/TPM1.CH0//GPIO1.IO[4] |  | 0
U23 | 7 | 85 | UART#_DEBUG_TX | UART1.TX/SECO.TX/SPI2.PCS0/TPM1.CH1//GPIO1.IO[5]/CCMSRCGPCMIX.BOOT_MODE[0] |  | 0
J27 | 2 |  | SATAc_TXP | Via C140 | Via U2 selector; controlled by EXP_USB3_SATA_SEL.
J27 | 3 |  | SATAc_TXN | Via C141 | Via U2 selector; controlled by EXP_USB3_SATA_SEL.
J27 | 5 |  | SATAc_RXN | Via C142 | Via U2 selector; controlled by EXP_USB3_SATA_SEL.
J27 | 6 |  | SATAc_RXP | Via C143 | Via U2 selector; controlled by EXP_USB3_SATA_SEL.
U2 | 2 | 93 | J1.93-SATA_RXP-USB3_SS3_RX_P | BT_PCM_IN | Include 10K PD to support SOM-6UL boot | 1.8V level signal
U2 | 3 | 91 | J1.91-SATA_RXN-USB3_SS3_RX_N | BT_PCM_CLK | Include 10K PU to support SOM-6UL boot | 1.8V level signal
U2 | 6 | 97 | J1.97-SATA_TXP-USB3_SS3_TX_P | BT_PCM_OUT |  | 1.8V level signal
U2 | 7 | 99 | J1.99-SATA_TXN-USB3_SS3_TX_N | BT_PCM_SYNC |  | 1.8V level signal
 |  |  |  |  | Note: EXP_USB3_SATA_SEL=0 (default) to SATA
J15 | 1 |  | PCIE#A_WAKE_B |  | Connected to TP2
J15 | 11 |  | PCIE#A_REFCLK100M_N_C |  | Sourced from U6 PCI ref. clk. Generator
J15 | 13 |  | PCIE#A_REFCLK100M_P_C |  | Sourced from U6 PCI ref. clk. Generator
J15 | 20 |  | PCIE#A_DIS_B |  | Connected to TP1
J15 | 23 | 136 | PCIE#A_RX0_N | PMIC_NINT | Via C8 - as 0 Ohm resistor | 1.8V level signal. No internal pull up.
J15 | 25 | 134 | PCIE#A_RX0_P | BT_HOST_WAKE | Via C7 - as 0 Ohm resistor | 1.8V level signal
J15 | 31 | 128 | PCIE#A_TX0_N | WIFI_HOST_WAKE | Via C6 AC coupling capacitor | 1.8V level signal
J15 | 33 | 130 | PCIE#A_TX0_P | BT_DEV_WAKE | Via C5 AC coupling capacitor | 1.8V level signal
J15 | 30 | 88 | I2C#A_SCL | GPIO2.IO[23]/USDHC3.CMD/SPDIF1.OUT/LCDIF.D[19]/TPM6.CH1//I2C5.SCL/FLEXIO1.FLEXIO[23] |  | 0
J15 | 32 | 87 | I2C#A_SDA | GPIO2.IO[22]/USDHC3.CLK/SPDIF1.IN/LCDIF.D[18]/TPM5.CH1/TPM6.EXTCLK/I2C5.SDA/FLEXIO1.FLEXIO[22] |  | 0
J15 | 22 | 23 | SAI#A_RXFS_PCIE#A_RESET_B | GPIO2.IO[19]/SAI3.RX_SYNC/PDM.BIT_STREAM[3]/LCDIF.D[15]/SPI5.SIN/SPI4.SIN/TPM6.CH2/SAI3.TX_DATA[0] |  | 0

Sheet: ConcertoConnectors
 |  | xxxx | << Highlight | VAR-SOM-MX8MN
Concerto Header | Pin# | SOM_PIN | Concerto NetName | Alternate Function for Selected SOM ^^^^^ | Note
J25 | 5 | 84 | UART#DBG_RTS | NC
J25 | 9 | 154 | HDMI_TX_HPD | GPIO1_IO01/PWM1_OUT/////REF_CLK_24M//////EXT_CLK2
J25 | 11 | 156 | HDMI_TX_DDC_CEC | NC
J25 | 15 | 152 | HDMI_TX_CK_P | NC
J25 | 16 | 155 | HDMI_TX_D0_P | NC
J25 | 17 | 150 | HDMI_TX_CK_N | ~GPIO1_IO03/SD1_VSELECT/////SDMA1_EXT_EVENT0//////XTAL_OK
J25 | 18 | 157 | HDMI_TX_D0_N | NC
J25 | 21 | 151 | HDMI_TX_D2_P | NC
J25 | 22 | 146 | HDMI_TX_D1_P | NC
J25 | 23 | 153 | HDMI_TX_D2_N | ~GPIO1_IO05/M4_NMI/////PMIC_READY//////INT_BOOT
J25 | 24 | 148 | HDMI_TX_D1_N | NC
 |  |  |  | Name
J13 | 42 | 137 | MIPI-CSI_CK_N | CSI_CK_N
J13 | 44 | 135 | MIPI-CSI_CK_P | CSI_CK_P
J13 | 48 | 121 | MIPI-CSI_D0_N | CSI_D0_N
J13 | 50 | 119 | MIPI-CSI_D0_P | CSI_D0_P
J13 | 36 | 123 | MIPI-CSI_D1_N | CSI_D1_N
J13 | 38 | 125 | MIPI-CSI_D1_P | CSI_D1_P
J13 | 30 | 129 | MIPI-CSI_D2_N | CSI_D2_N
J13 | 32 | 127 | MIPI-CSI_D2_P | CSI_D2_P
J13 | 24 | 131 | MIPI-CSI_D3_N | CSI_D3_N
J13 | 26 | 133 | MIPI-CSI_D3_P | CSI_D3_P
J13 | 14 | 70 | MIPI-CSI_OPT_1V8_TO_SOM | ECSPI2_MOSI/UART4_TXD//I2C3_SDA///SAI5_RXD3////SAI5_TXD0/////GPIO5_IO11 | VIA U18 & U19
J13 | 10 | 77 | MIPI-CSI_PWR_EN_1V8_FROM_SOM | ECSPI2_MISO/UART4_CTS_B//I2C4_SCL///SAI5_MCLK/////GPIO5_IO12 | VIA U18 & U19
J13 | 12 | 40 | MIPI-CSI_RST_B_1V8_FROM_SOM | GPIO1_IO13/USB1_OTG_OC/////PWM2_OUT | VIA U18 & U19
J13 | 16 | 86 | MIPI-CSI_SYNC_1V8_TO_SOM | NC | VIA U18 & U19
J13 | 20 | 75 | MIPI-CSI_TRIG_1V8_FROM_SOM | ECSPI2_SCLK/UART4_RXD//I2C3_SCL///SAI5_RXD2////SAI5_TXC/////GPIO5_IO10 | VIA U18 & U19
 |  | 73 | MIPI_CSI_BUF_OE_B | SAI2_MCLK/SAI5_MCLK/////GPIO4_IO27//////SAI3_MCLK | Control Signal
J20 | 14 | 168 | LVDS#A_CLK_N | DSI_CLK_N/*/LVDS0_CH0_CLK_N
J20 | 15 | 170 | LVDS#A_CLK_P | DSI_CLK_P/*/LVDS0_CH0_CLK_P
J20 | 5 | 161 | LVDS#A_TX0_N | DSI_D0_N/*/LVDS0_CH0_TX0_N
J20 | 6 | 163 | LVDS#A_TX0_P | DSI_D0_P/*/LVDS0_CH0_TX0_P
J20 | 8 | 160 | LVDS#A_TX1_N | DSI_D1_N/*/LVDS0_CH0_TX1_N
J20 | 9 | 162 | LVDS#A_TX1_P | DSI_D1_P/*/LVDS0_CH0_TX1_P
J20 | 11 | 164 | LVDS#A_TX2_N | DSI_D2_N/*/LVDS0_CH0_TX2_N
J20 | 12 | 166 | LVDS#A_TX2_P | DSI_D2_P/*/LVDS0_CH0_TX2_P
J20 | 19 | 17 | PWM#A | SPDIF_EXT_CLK/PWM1_OUT/////GPIO5_IO05
J22 | 14 | 180 | LVDS_DISP2_CK_N | NC/*/LVDS0_CH1_CLK_N
J22 | 15 | 182 | LVDS_DISP2_CK_P | NC/*/LVDS0_CH1_CLK_P
J22 | 5 | 184 | LVDS_DISP2_D0_N | NC/*/LVDS0_CH1_TX0_N
J22 | 6 | 186 | LVDS_DISP2_D0_P | NC/*/LVDS0_CH1_TX0_P
J22 | 8 | 188 | LVDS_DISP2_D1_N | NC/*/LVDS0_CH1_TX1_N
J22 | 9 | 190 | LVDS_DISP2_D1_P | NC/*/LVDS0_CH1_TX1_P
J22 | 11 | 192 | LVDS_DISP2_D2_N | NC/*/LVDS0_CH1_TX2_N
J22 | 12 | 194 | LVDS_DISP2_D2_P | NC/*/LVDS0_CH1_TX2_P
J22 | 19 | 68 | PWM#B | SPDIF_RX/PWM2_OUT/////GPIO5_IO04
J18 | 12 | 70 | J1.70 | ECSPI2_MOSI/UART4_TXD//I2C3_SDA///SAI5_RXD3////SAI5_TXD0/////GPIO5_IO11
J18 | 18 | 75 | J1.75 | ECSPI2_SCLK/UART4_RXD//I2C3_SCL///SAI5_RXD2////SAI5_TXC/////GPIO5_IO10
J18 | 17 | 77 | J1.77 | ECSPI2_MISO/UART4_CTS_B//I2C4_SCL///SAI5_MCLK/////GPIO5_IO12
J18 | 11 | 79 | J1.79 | ECSPI2_SS0/UART4_RTS_B//I2C4_SDA/////GPIO5_IO13
J18 | 14 | 142 | MIPI-DSI_CK_N | PMIC_ON_REQ
J18 | 15 | 140 | MIPI-DSI_CK_P | PMIC_STBY_REQ
J18 | 5 | 141 | MIPI-DSI_D0_N | NC
J18 | 6 | 143 | MIPI-DSI_D0_P | ONOFF
J18 | 8 | 145 | MIPI-DSI_D1_N | NC
J18 | 9 | 147 | MIPI-DSI_D1_P | NC
J18 | 19 | 69 | PWM#C | SPDIF_TX/PWM3_OUT/////GPIO5_IO03
J26 | 1 | 52 | UART#BT_TXD | SAI3_TXC/GPT1_COMPARE2//SAI5_RXD2///SAI2_TXD1////~UART2_TXD/////GPIO5_IO00//////PDM_BIT2
J26 | 2 | 56 | UART#C_TX | UART1_TXD/ECSPI3_MOSI/////GPIO5_IO23
J26 | 3 | 53 | UART#BT_RXD | SAI3_TXFS/GPT1_CAPTURE2//SAI5_RXD1///SAI3_TXD1////~UART2_RXD/////GPIO4_IO31//////PDM_BIT3
J26 | 4 | 54 | UART#C_RX | UART1_RXD/ECSPI3_SCLK/////GPIO5_IO22
J26 | 5 | 50 | UART#BT_CTS | SAI3_RXC/GPT1_CLK//SAI5_RXC///SAI2_RXD1////~UART2_CTS_B/////GPIO4_IO29//////PDM_CLK
J26 | 6 | 55 | UART#C_CTS | _UART3_RXD/UART1_CTS_B//SD3_RESET_B///GPT1_CAPTURE2/////GPIO5_IO26
J26 | 7 | 51 | UART#BT_RTS | SAI3_RXD/GPT1_COMPARE1//SAI5_RXD0///SAI3_TXD1////~UART2_RTS_B/////GPIO4_IO30//////PDM_BIT1
J26 | 8 | 57 | UART#C_RTS | _UART3_TXD/UART1_RTS_B//SD3_VSELECT///GPT1_CLK/////GPIO5_IO27
J26 | 9 | 171 | UART#B_TX | UART2_TXD/ECSPI3_SS0///GPT1_COMPARE2/////GPIO5_IO25
J26 | 10 | 124 | UART#A_TX | UART3_TXD/UART1_RTS_B//SD3_VSELECT///GPT1_CLK/////GPIO5_IO27
J26 | 11 | 115 | UART#B_RX | UART2_RXD/ECSPI3_MISO///GPT1_COMPARE3/////GPIO5_IO24
J26 | 12 | 175 | UART#A_RX | UART3_RXD/UART1_CTS_B//SD3_RESET_B///GPT1_CAPTURE2/////GPIO5_IO26
J26 | 13 | 96 | UART#B_CTS | GPIO1_IO06/ENET_MDC/////SD1_CD_B//////EXT_CLK3
J26 | 14 | 117 | UART#A_CTS | GPIO1_IO08/ENET_1588_EVENT0_IN//PWM1_OUT/////SD2_RESET_B
J26 | 15 | 113 | UART#B_RTS | SAI3_RXFS/GPT1_CAPTURE1//SAI5_RXFS///SAI3_RXD1////SPDIF_IN/////GPIO4_IO28//////PDM_BIT0
J26 | 16 | 173 | UART#A_RTS | NC
J26 | 17 | #N/A | CAN#A_H | #N/A | Via PHY chip on Custom
J26 | 19 | #N/A | CAN#A_L | #N/A | Via PHY chip on Custom
J23 | 6 | 39 | ENET2_RX_ER | ECSPI1_SS0/UART3_RTS_B//I2C2_SDA///SAI5_RXD1////SAI5_TXFS/////GPIO5_IO09
J23 | 10 | 43 | ENET2_TD1 | ~ECSPI1_SCLK/UART3_RXD//I2C1_SCL///SAI5_RXFS/////GPIO5_IO06
J23 | 4 | 41 | ENET2_TX_CLK | ~ECSPI1_MISO/UART3_CTS_B//I2C2_SCL///SAI5_RXD0/////GPIO5_IO08
J23 | 8 | 45 | ENET2_TX_EN | ~ECSPI1_MOSI/UART3_TXD//I2C1_SDA///SAI5_RXC/////GPIO5_IO07
J23 | 5 | 48 | GPLED | GPIO1_IO02/~WDOG_B/////WDOG_ANY
J23 | 1 | 174 | I2C#B_SCL_BASE | I2C4_SCL/PWM2_OUT///ECSPI2_MISO/////GPIO5_IO20 | Via U17 requires ETH_RST_B/I2C_BASE_EN_B = L
J23 | 3 | 176 | I2C#B_SDA_BASE | I2C4_SDA/PWM1_OUT///ECSPI2_SS0/////GPIO5_IO21 | Via U17 requires ETH_RST_B/I2C_BASE_EN_B = L
J23 | 9 | 92 | I2C#C_SCL_BASE | ~I2C3_SCL/PWM4_OUT//GPT2_CLK///ECSPI2_SCLK/////GPIO5_IO18 | Via U17 requires ETH_RST_B/I2C_BASE_EN_B = L
J23 | 7 | 90 | I2C#C_SDA_BASE | ~I2C3_SDA/PWM3_OUT//GPT3_CLK///ECSPI2_MOSI/////GPIO5_IO19 | Via U17 requires ETH_RST_B/I2C_BASE_EN_B = L
 |  | 120 | ETH_RST_B/I2C_BASE_EN_B | SAI3_MCLK/PWM4_OUT//SAI5_MCLK////SPDIF_OUT/////GPIO5_IO02//////SPDIF_IN | Base Control signal
J17 | 2 | 187 | TP#_X_NEG | NC/*/TS_X-
J17 | 3 |  | CB_WDOG_B |  | Connect to WDOG_B function for "REBOOT"
J17 | 4 | 191 | TP#_Y_POS | NC/*/TS_Y+
J17 | 5 | 122 | CAP_TOUCH_INT_B | GPIO1_IO12/USB1_OTG_PWR
J17 | 6 | 189 | TP#_X_POS | NC/*/TS_X+
J17 | 7 | 86 | UART#DBG_CTS | NC
J17 | 8 | 193 | TP#_Y_NEG | NC/*/TS_Y-
J17 | 9 | 73 | MIPI_CSI_BUF_OE_B | SAI2_MCLK/SAI5_MCLK/////GPIO4_IO27//////SAI3_MCLK
J17 | 10 | 82 | J1.82 | SAI3_TXD/GPT1_COMPARE3//SAI5_RXD3////SPDIF_EXT_CLK/////GPIO5_IO01

Sheet: VAR-SOM-MX6
PIN# | Symbol pin name source
1 | GND/*/USB_OTG_ID/ENET_RX_ER//ESAI_RX_HF_CLK///SPDIF_IN////ENET_1588_EVENT2_OUT/////GPIO1_IO24
2 | GND
3 | NC/*/MDI_A+
4 | NC/*/MDI_C+
5 | NC/*/MDI_A-
6 | NC/*/MDI_C-
7 | GND
8 | GND
9 | NC/*/MDI_B+
10 | NC/*/MDI_D+
11 | NC/*/MDI_B-
12 | NC/*/MDI_D-
13 | GND
14 | GND
15 | NC/*/GETH_LED2
16 | /ENET_TX_EN//ESAI_TX3_RX2/////GPIO1_IO28/*/GETH_LED1
17 | IPU1_DISP0_DATA09/IPU2_DISP0_DATA09//PWM2_OUT///WDOG2_B/////GPIO4_IO30
18 | NC/*/DMIC_CLK
19 | GND
20 | NC/*/DMIC_DATA
21 | IPU1_DISP0_DATA23/IPU2_DISP0_DATA23//ECSPI1_SS0///AUD4_RXD/////GPIO5_IO17
22 | IPU1_DISP0_DATA19/IPU2_DISP0_DATA19//ECSPI2_SCLK///AUD5_RXD////AUD4_RXC/////GPIO5_IO13///////EIM_CS3
23 | IPU1_DISP0_DATA18/IPU2_DISP0_DATA18//ECSPI2_SS0///AUD5_TXFS////AUD4_RXFS/////GPIO5_IO12///////EIM_CS2
24 | IPU1_DISP0_DATA22/IPU2_DISP0_DATA22//ECSPI1_MISO///AUD4_TXFS/////GPIO5_IO16
25 | IPU1_DISP0_DATA20/IPU2_DISP0_DATA20//ECSPI1_SCLK///AUD4_TXC/////GPIO5_IO14
26 | IPU1_DISP0_DATA21/IPU2_DISP0_DATA21//ECSPI1_MOSI///AUD4_TXD/////GPIO5_IO15
27 | GND
28 | GND
29 | ESAI_RX_HF_CLK//I2C3_SCL///XTALOSC_REF_CLK_24M////CCM_CLKO2/////GPIO1_IO03//////USB_H1_OC///////MLB_CLK
30 | NC
31 | GND
32 | VCC_SOM
33 | GND
34 | VCC_SOM
35 | GND
36 | VCC_SOM
37 | GND
38 | VCC_SOM
39 | ECSPI1_SS0/ENET_COL//AUD5_RXD///KEY_ROW1////UART5_RX_DATA/////GPIO4_IO09//////SD2_VSELECT
40 | EIM_AD05/IPU1_DISP1_DATA04//IPU2_CSI1_DATA04/////GPIO3_IO05///////SRC_BOOT_CFG05
41 | ECSPI1_MISO/ENET_MDIO//AUD5_TXFS///KEY_COL1////UART5_TX_DATA/////GPIO4_IO08//////SD1_VSELECT
42 | EIM_AD07/IPU1_DISP1_DATA02//IPU2_CSI1_DATA02/////GPIO3_IO07///////SRC_BOOT_CFG07
43 | ECSPI1_SCLK/ENET_RX_DATA3//AUD5_TXC///KEY_COL0////UART4_TX_DATA/////GPIO4_IO06//////DCIC1_OUT
44 | ESAI_TX4_RX1/ECSPI5_RDY//EPIT1_OUT///FLEXCAN1_TX////UART2_TX_DATA/////GPIO1_IO07//////SPDIF_LOCK///////USB_OTG_HOST_MODE
45 | ECSPI1_MOSI/ENET_TX_DATA3//AUD5_TXD///KEY_ROW0////UART4_RX_DATA/////GPIO4_IO07//////DCIC2_OUT
46 | ESAI_TX5_RX0/XTALOSC_REF_CLK_32K//EPIT2_OUT///FLEXCAN1_RX////UART2_RX_DATA/////GPIO1_IO08//////SPDIF_SR_CLK///////USB_OTG_PWR_CTL_WAKE
47 | GND
48 | ECSPI1_SS1/ENET_RX_DATA2//FLEXCAN1_TX///KEY_COL2////ENET_MDC/////GPIO4_IO10//////USB_H1_PWR_CTL_WAKE
49 | SOM_3V3_PER
50 | EIM_DATA28/I2C1_SDA//ECSPI4_MOSI///IPU2_CSI1_DATA12////UART2_CTS_B/////GPIO3_IO28//////IPU1_EXT_TRIG///////IPU1_DI0_PIN13
51 | EIM_DATA29/IPU1_DI1_PIN15//ECSPI4_SS0////UART2_RTS_B/////GPIO3_IO29//////IPU2_CSI1_VSYNC///////IPU1_DI0_PIN14
52 | EIM_DATA26/IPU1_DI1_PIN11//IPU1_CSI0_DATA01///IPU2_CSI1_DATA14////UART2_TX_DATA/////GPIO3_IO26//////IPU1_SISG2///////IPU1_DISP1_DATA22
53 | EIM_DATA27/IPU1_DI1_PIN13//IPU1_CSI0_DATA00///IPU2_CSI1_DATA13////UART2_RX_DATA/////GPIO3_IO27//////IPU1_SISG3///////IPU1_DISP1_DATA23
54 | EIM_DATA25/ECSPI4_SS3//UART3_RX_DATA///ECSPI1_SS3////ECSPI2_SS3/////GPIO3_IO25//////AUD5_RXC///////UART1_DSR_B
55 | EIM_DATA23/IPU1_DI0_D0_CS//UART3_CTS_B///UART1_DCD_B////IPU2_CSI1_DATA_EN/////GPIO3_IO23//////IPU1_DI1_PIN02///////IPU1_DI1_PIN14
56 | EIM_DATA24/ECSPI4_SS2//UART3_TX_DATA///ECSPI1_SS2////ECSPI2_SS2/////GPIO3_IO24//////AUD5_RXFS///////UART1_DTR_B
57 | EIM_EB3/ECSPI4_RDY//UART3_RTS_B///UART1_RI_B////IPU2_CSI1_HSYNC/////GPIO2_IO31//////IPU1_DI1_PIN03///////SRC_BOOT_CFG31
58 | GND/*/MLB_CLK/ENET_TX_DATA1//ESAI_TX2_RX3////ENET_1588_EVENT0_IN/////GPIO1_IO29
59 | GND
60 | SD2_CLK/ECSPI5_SCLK//KEY_COL5///AUD4_RXFS/////GPIO1_IO10
61 | SD2_DATA2/ECSPI5_SS1//EIM_CS3///AUD4_TXD////KEY_ROW6/////GPIO1_IO13
62 | SD2_DATA0/ECSPI5_MISO///AUD4_RXD////KEY_ROW7/////GPIO1_IO15//////DCIC2_OUT
63 | SD2_DATA1/ECSPI5_SS0//EIM_CS2///AUD4_TXFS////KEY_COL7/////GPIO1_IO14
64 | SD2_CMD/ECSPI5_MOSI//KEY_ROW5///AUD4_RXC/////GPIO1_IO11
65 | SD2_DATA3/ECSPI5_SS3//KEY_COL6///AUD4_TXC/////GPIO1_IO12
66 | GND
67 | GND
68 | ESAI_RX_FS/WDOG1_B//KEY_COL6///CCM_REF_EN_B////PWM1_OUT/////GPIO1_IO09//////SD1_WP
69 | /SD4_DATA1//PWM3_OUT/////GPIO2_IO09
70 | /SD4_DATA6//UART2_CTS_B/////GPIO2_IO14
71 | ESAI_TX_FS//KEY_ROW6/////GPIO1_IO02//////SD2_WP///////MLB_DATA
72 | ESAI_RX_CLK/WDOG2_B//KEY_ROW5///USB_OTG_ID////PWM2_OUT/////GPIO1_IO01//////SD1_CD_B
73 | /SD4_DATA3/////GPIO2_IO11
74 | NC
75 | EIM_DATA21/ECSPI4_SCLK//IPU1_DI0_PIN17///IPU2_CSI1_DATA11////USB_OTG_OC/////GPIO3_IO21//////I2C1_SCL///////SPDIF_IN
76 | GND
77 | EIM_DATA22/ECSPI4_MISO//IPU1_DI0_PIN01///IPU2_CSI1_DATA10////USB_OTG_PWR/////GPIO3_IO22//////SPDIF_OUT
78 | GND
79 | EIM_DATA30/IPU1_DISP1_DATA21//IPU1_DI0_PIN11///IPU1_CSI0_DATA03////UART3_CTS_B/////GPIO3_IO30//////USB_H1_OC
80 | FLEXCAN2_TX/IPU1_SISG4//USB_OTG_OC///KEY_COL4////UART5_RTS_B/////GPIO4_IO14
81 | IPU1_CSI0_HSYNC///CCM_CLKO1/////GPIO5_IO19///////ARM_TRACE_CTL
82 | FLEXCAN2_RX/IPU1_SISG5//USB_OTG_PWR///KEY_ROW4////UART5_CTS_B/////GPIO4_IO15
83 | IPU1_CSI0_DATA11/AUD3_RXFS//ECSPI2_SS0///UART1_RX_DATA/////GPIO5_IO29///////ARM_TRACE08
84 | EIM_DATA20/ECSPI4_SS0//IPU1_DI0_PIN16///IPU2_CSI1_DATA15////UART1_RTS_B/////GPIO3_IO20//////EPIT2_OUT
85 | IPU1_CSI0_DATA10/AUD3_RXC//ECSPI2_MISO///UART1_TX_DATA/////GPIO5_IO28///////ARM_TRACE07
86 | EIM_DATA19/ECSPI1_SS1//IPU1_DI0_PIN08///IPU2_CSI1_DATA16////UART1_CTS_B/////GPIO3_IO19//////EPIT1_OUT
87 | IPU1_CSI0_DATA08/EIM_DATA06//ECSPI2_SCLK///KEY_COL7////I2C1_SDA/////GPIO5_IO26///////ARM_TRACE05
88 | IPU1_CSI0_DATA09/EIM_DATA07//ECSPI2_MOSI///KEY_ROW7////I2C1_SCL/////GPIO5_IO27///////ARM_TRACE06
89 | GND
90 | ESAI_TX3_RX2/ENET_1588_EVENT2_IN//ENET_REF_CLK///SD1_LCTL////SPDIF_IN/////GPIO7_IO11//////I2C3_SDA///////JTAG_DE_B
91 | SATA_RXN
92 | ESAI_TX2_RX3//KEY_ROW7///CCM_CLKO1/////GPIO1_IO05//////I2C3_SCL///////ARM_EVENTI
93 | SATA_RXP
94 | ESAI_TX_HF_CLK//KEY_COL7/////GPIO1_IO04//////SD2_CD_B
95 | GND
96 | IPU1_CSI0_DATA19/EIM_DATA15///UART5_CTS_B/////GPIO6_IO05
97 | SATA_TXP
98 | POR_B
99 | SATA_TXN
100 | CLK1_N
101 | GND
102 | CLK1_P
103 | VCC_SOM
104 | USB_H1_VBUS
105 | VCC_SOM
106 | USB_OTG_VBUS
107 | VCC_SOM
108 | USB_HOST_DN
109 | VCC_SOM
110 | USB_HOST_DP
111 | VCC_SOM
112 | GND
113 | IPU1_CSI0_DATA18/EIM_DATA14///UART5_RTS_B/////GPIO6_IO04///////ARM_TRACE15
114 | USB_OTG_DN
115 | IPU1_CSI0_DATA15/EIM_DATA11///UART5_RX_DATA/////GPIO6_IO01///////ARM_TRACE12
116 | USB_OTG_DP
117 | IPU1_CSI0_DATA17/EIM_DATA13///UART4_CTS_B/////GPIO6_IO03///////ARM_TRACE14
118 | GND
119 | CSI_D0P
120 | IPU1_CSI0_VSYNC/EIM_DATA01/////GPIO5_IO21///////ARM_TRACE00
121 | CSI_D0M
122 | IPU1_CSI0_DATA_EN/EIM_DATA00/////GPIO5_IO20///////ARM_TRACE_CLK
123 | CSI_D1M
124 | IPU1_CSI0_DATA12/EIM_DATA08///UART4_TX_DATA/////GPIO5_IO30///////ARM_TRACE09
125 | CSI_D1P
126 | GND
127 | CSI_D2P
128 | PCIE_TXM
129 | CSI_D2M
130 | PCIE_TXP
131 | CSI_D3M
132 | GND
133 | CSI_D3P
134 | PCIE_RXP
135 | CSI_CLK0P
136 | PCIE_RXM
137 | CSI_CLK0M
138 | GND
139 | GND
140 | DSI_CLK0P
141 | DSI_D0M
142 | DSI_CLK0M
143 | DSI_D0P
144 | GND
145 | DSI_D1M
146 | HDMI_D1P
147 | DSI_D1P
148 | HDMI_D1M
149 | GND
150 | HDMI_CLKM
151 | HDMI_D2P
152 | HDMI_CLKP
153 | HDMI_D2M
154 | HDMI_HPD
155 | HDMI_D0P
156 | HDMI_DDCCEC/*/TAMPER
157 | HDMI_D0M
158 | GND
159 | GND
160 | LVDS0_TX1_N
161 | LVDS0_TX0_N
162 | LVDS0_TX1_P
163 | LVDS0_TX0_P
164 | LVDS0_TX2_N
165 | LVDS0_TX3_N
166 | LVDS0_TX2_P
167 | LVDS0_TX3_P
168 | LVDS0_CLK_N
169 | GND
170 | LVDS0_CLK_P
171 | IPU1_CSI0_DATA14/EIM_DATA10///UART5_TX_DATA/////GPIO6_IO00///////ARM_TRACE11
172 | GND
173 | IPU1_CSI0_DATA16/EIM_DATA12///UART4_RTS_B/////GPIO6_IO02///////ARM_TRACE13
174 | ECSPI1_SS3/ENET_CRS//HDMI_TX_DDC_SCL///KEY_COL3////I2C2_SCL/////GPIO4_IO12//////SPDIF_IN
175 | IPU1_CSI0_DATA13/EIM_DATA09///UART4_RX_DATA/////GPIO5_IO31///////ARM_TRACE10
176 | /ASRC_EXT_CLK//HDMI_TX_DDC_SDA///KEY_ROW3////I2C2_SDA/////GPIO4_IO13//////SD1_VSELECT
177 | IPU1_CSI0_PIXCLK/////GPIO5_IO18///////ARM_EVENTO
178 | GND
179 | GND
180 | LVDS1_CLK_N
181 | LVDS1_TX3_P
182 | LVDS1_CLK_P
183 | LVDS1_TX3_N
184 | LVDS1_TX0_N
185 | GND
186 | LVDS1_TX0_P
187 | NC/*/TS_X-
188 | LVDS1_TX1_N
189 | NC/*/TS_X+
190 | LVDS1_TX1_P
191 | NC/*/TS_Y+
192 | LVDS1_TX2_N
193 | NC/*/TS_Y-
194 | LVDS1_TX2_P
195 | NC/*/AGND/*/EMMC_BOOT
196 | NC/*/AGND
197 | NC/*/LINEIN1_LP
198 | NC/*/HPLOUT
199 | NC/*/LINEIN1_RP
200 | NC/*/HPROUT

Sheet: VAR-SOM-MX8
PIN# | Symbol pin name source
1 | GND/*/CONN_ENET1_REFCLK_125M_25M/CONN_ENET1_PPS///LSIO_GPIO4_IO16
2 | GND
3 | NC/*/ETH0_MDI_A_P
4 | NC/*/ETH0_MDI_C_P
5 | NC/*/ETH0_MDI_A_M
6 | NC/*/ETH0_MDI_C_M
7 | GND
8 | GND
9 | NC/*/ETH0_MDI_B_P
10 | NC/*/ETH0_MDI_D_P
11 | NC/*/ETH0_MDI_B_M
12 | NC/*/ETH0_MDI_D_M
13 | GND
14 | GND
15 | NC/*/ETH0_LED_ACT
16 | NC/*/ETH0_LED_LINK_10_100_1000
17 | LVDS0_GPIO0_IO00/LVDS0_PWM0_OUT///LSIO_GPIO1_IO04
18 | NC/*/DMIC_CLK
19 | GND
20 | NC/*/DMIC_DATA
21 | AUD_SAI1_RXD/AUD_SAI0_TXFS///LSIO_GPIO3_IO13
22 | AUD_SAI1_RXC/AUD_SAI0_TXD///LSIO_GPIO3_IO12
23 | AUD_SAI1_RXFS/AUD_SAI0_RXD///LSIO_GPIO3_IO14
24 | AUD_SAI1_TXFS/AUD_SAI1_RXFS///LSIO_GPIO3_IO17
25 | AUD_SAI1_TXC/AUD_SAI0_TXC///LSIO_GPIO3_IO15
26 | AUD_SAI1_TXD/AUD_SAI1_RXC///LSIO_GPIO3_IO16
27 | GND
28 | GND
29 | MIPI_CSI0_ACM_MCLK_OUT///LSIO_GPIO1_IO24
30 | CONN_ENET0_MDIO/DMA_I2C4_SDA///LSIO_GPIO4_IO13
31 | VCC_SOM/*/NC
32 | VCC_SOM
33 | VCC_SOM/*/NC
34 | VCC_SOM
35 | VCC_SOM/*/NC
36 | VCC_SOM/*/LICELL
37 | GND
38 | VDD_ENET1_1P8_2P5_3P3_IN
39 | /DMA_SPI1_CS0//LSIO_KPP0_ROW2///LSIO_GPIO3_IO24
40 | DMA_SPI0_CS1/AUD_SAI0_TXC///LSIO_GPIO3_IO06
41 | /DMA_SPI1_SDI//LSIO_KPP0_ROW1///LSIO_GPIO3_IO23
42 | LVDS0_GPIO0_IO01///LSIO_GPIO1_IO05
43 | /DMA_SPI1_SCK//LSIO_KPP0_COL3///LSIO_GPIO3_IO21
44 | DMA_FLEXCAN0_TX///LSIO_GPIO3_IO30
45 | /DMA_SPI1_SDO//LSIO_KPP0_ROW0///LSIO_GPIO3_IO22
46 | DMA_FLEXCAN0_RX///LSIO_GPIO3_IO29
47 | GND
48 | LSIO_GPT1_CLK/DMA_I2C2_SCL//LSIO_KPP0_COL7///LSIO_GPIO0_IO17
49 | SOM_3V3_PER
50 | DMA_UART1_CTS_B/DMA_SPI3_CS0//DMA_UART1_RTS_B///LSIO_GPIO0_IO27
51 | DMA_UART1_RTS_B/DMA_SPI3_SDI//DMA_UART1_CTS_B///LSIO_GPIO0_IO26
52 | DMA_UART1_TX/DMA_SPI3_SCK///LSIO_GPIO0_IO24
53 | DMA_UART1_RX/DMA_SPI3_SDO///LSIO_GPIO0_IO25
54 | CONN_ENET1_RGMII_RXD3/DMA_UART3_RX//VPU_TSI_S1_CLK///LSIO_GPIO6_IO21
55 | CONN_ENET1_RGMII_TXD3/DMA_UART3_RTS_B//VPU_TSI_S1_SYNC///LSIO_GPIO6_IO15
56 | CONN_ENET1_RGMII_TXD2/DMA_UART3_TX//VPU_TSI_S1_VID///LSIO_GPIO6_IO14
57 | CONN_ENET1_RGMII_RXC/DMA_UART3_CTS_B//VPU_TSI_S1_DATA///LSIO_GPIO6_IO16
58 | GND/*/CONN_ENET0_REFCLK_125M_25M/CONN_ENET0_PPS///LSIO_GPIO4_IO15
59 | GND
60 | CONN_USDHC1_CLK
61 | CONN_USDHC1_DATA2/CONN_NAND_DQS_N///LSIO_GPIO5_IO17
62 | CONN_USDHC1_DATA0/CONN_NAND_RE_N///LSIO_GPIO5_IO15
63 | CONN_USDHC1_DATA1/CONN_NAND_RE_P///LSIO_GPIO5_IO16
64 | CONN_USDHC1_CMD///LSIO_GPIO5_IO14
65 | CONN_USDHC1_DATA3/CONN_NAND_DQS_P///LSIO_GPIO5_IO18
66 | GND/*/SNVS_TAMPER_OUT0
67 | GND
68 | LSIO_GPT1_COMPARE/LSIO_PWM2_OUT//LSIO_KPP0_ROW5///LSIO_GPIO0_IO19
69 | LSIO_GPT0_COMPARE/LSIO_PWM3_OUT//LSIO_KPP0_COL6///LSIO_GPIO0_IO16
70 | DMA_SPI0_SDO/AUD_SAI0_TXD///LSIO_GPIO3_IO03
71 | CONN_ENET1_RGMII_RXD2/CONN_ENET1_RMII_RX_ER//VPU_TSI_S0_CLK///LSIO_GPIO6_IO20
72 | DMA_SPI2_CS1/AUD_SAI0_TXFS///LSIO_GPIO3_IO11
73 | CONN_ENET1_RGMII_TXD0///LSIO_GPIO6_IO12
74 | CONN_ENET0_MDC/DMA_I2C4_SCL///LSIO_GPIO4_IO14
75 | DMA_SPI0_SCK/AUD_SAI0_RXC///LSIO_GPIO3_IO02
76 | GND
77 | DMA_SPI0_SDI/AUD_SAI0_RXD///LSIO_GPIO3_IO04
78 | GND
79 | DMA_SPI0_CS0/AUD_SAI0_RXFS///LSIO_GPIO3_IO05
80 | LSIO_GPT0_CLK/DMA_I2C1_SCL//LSIO_KPP0_COL4///LSIO_GPIO0_IO14
81 | CONN_ENET1_RGMII_RXD1//VPU_TSI_S0_DATA///LSIO_GPIO6_IO19
82 | LSIO_GPT1_CAPTURE/DMA_I2C2_SDA//LSIO_KPP0_ROW4///LSIO_GPIO0_IO18
83 | DMA_UART0_RX///LSIO_GPIO0_IO20
84 | DMA_UART0_CTS_B/LSIO_PWM1_OUT//DMA_UART2_TX///LSIO_GPIO0_IO23
85 | DMA_UART0_TX///LSIO_GPIO0_IO21
86 | DMA_UART0_RTS_B/LSIO_PWM0_OUT//DMA_UART2_RX///LSIO_GPIO0_IO22
87 | DMA_I2C1_SDA/CONN_USB_OTG2_OC///LSIO_GPIO4_IO06
88 | DMA_I2C1_SCL/CONN_USB_OTG2_PWR///LSIO_GPIO4_IO04
89 | GND
90 | CONN_ENET1_MDIO/DMA_I2C4_SDA///LSIO_GPIO4_IO17
91 | CONN_USB_SS3_RX_M_LN_0
92 | CONN_ENET1_MDC/DMA_I2C4_SCL///LSIO_GPIO4_IO18
93 | CONN_USB_SS3_RX_P_LN_0
94 | CONN_USB_OTG2_ID
95 | GND
96 | CONN_ENET1_RGMII_TXC/CONN_ENET1_RCLK50M_OUT//CONN_ENET1_RCLK50M_IN///LSIO_GPIO6_IO10
97 | CONN_USB_SS3_TX_P_LN_0
98 | POR_B_3V3
99 | CONN_USB_SS3_TX_M_LN_0
100 | HSIO_PCIE_IOB_EXT_REFCLK100M_N
101 | GND
102 | HSIO_PCIE_IOB_EXT_REFCLK100M_P
103 | VCC_SOM
104 | CONN_USB_OTG1_VBUS
105 | VCC_SOM
106 | CONN_USB_OTG2_VBUS
107 | VCC_SOM
108 | CONN_USB_OTG1_DN
109 | VCC_SOM
110 | CONN_USB_OTG1_DP
111 | VCC_SOM
112 | GND
113 | CONN_ENET1_RGMII_TX_CTL///LSIO_GPIO6_IO11
114 | CONN_USB_OTG2_DM
115 | M40_GPIO0_IO00/M40_TPM0_CH0//DMA_UART4_RX///LSIO_GPIO0_IO08
116 | CONN_USB_OTG2_DP
117 | DMA_FLEXCAN1_TX///LSIO_GPIO4_IO00
118 | GND
119 | MIPI_CSI0_DP0
120 | CONN_ENET1_RGMII_RX_CTL//VPU_TSI_S0_VID///LSIO_GPIO6_IO17
121 | MIPI_CSI0_DN0
122 | CONN_ENET1_RGMII_RXD0//VPU_TSI_S0_SYNC///LSIO_GPIO6_IO18
123 | MIPI_CSI0_DN1
124 | LVDS0_I2C1_SCL/DMA_UART2_TX///LSIO_GPIO1_IO08
125 | MIPI_CSI0_DP1
126 | GND
127 | MIPI_CSI0_DP2
128 | HSIO_PCIE0_TX0_N
129 | MIPI_CSI0_DN2
130 | HSIO_PCIE0_TX0_P
131 | MIPI_CSI0_DN3
132 | GND
133 | MIPI_CSI0_DP3
134 | HSIO_PCIE0_RX0_P
135 | MIPI_CSI0_CKP
136 | HSIO_PCIE0_RX0_N
137 | MIPI_CSI0_CKN
138 | GND
139 | GND
140 | MIPI_DSI0_CKP
141 | MIPI_DSI0_DN0
142 | MIPI_DSI0_CKN
143 | MIPI_DSI0_DP0
144 | GND
145 | MIPI_DSI0_DN1
146 | HDMI_TX0_TX_P_LN_1
147 | MIPI_DSI0_DP1
148 | HDMI_TX0_TX_M_LN_1
149 | GND
150 | HDMI_TX0_TX_M_LN_3
151 | HDMI_TX0_TX_P_LN_0
152 | HDMI_TX0_TX_P_LN_3
153 | HDMI_TX0_TX_M_LN_0
154 | HDMI_TX0_HPD
155 | HDMI_TX0_TX_P_LN_2
156 | HDMI_TX0_CEC/*/SNVS_TAMPER_IN0
157 | HDMI_TX0_TX_M_LN_2
158 | GND
159 | GND
160 | LVDS0_T0BN
161 | LVDS0_T0AN
162 | LVDS0_T0BP
163 | LVDS0_T0AP
164 | LVDS0_T0CN
165 | LVDS0_T0DN
166 | LVDS0_T0CP
167 | LVDS0_T0DP
168 | LVDS0_T0CLKN
169 | GND
170 | LVDS0_T0CLKP
171 | M40_GPIO0_IO01/M40_TPM0_CH1//DMA_UART4_TX///LSIO_GPIO0_IO09
172 | GND
173 | DMA_FLEXCAN1_RX///LSIO_GPIO3_IO31
174 | HDMI_TX0_I2C0_SCL/DMA_I2C0_SCL///LSIO_GPIO2_IO02/*/HDMI_TX0_DDC_SCL
175 | LVDS0_I2C1_SDA/DMA_UART2_RX///LSIO_GPIO1_IO09
176 | HDMI_TX0_I2C0_SDA/DMA_I2C0_SDA///LSIO_GPIO2_IO03/*/HDMI_TX0_DDC_SCL
177 | CONN_ENET1_RGMII_TXD1///LSIO_GPIO6_IO13
178 | GND
179 | GND
180 | LVDS0_T1CLKN
181 | LVDS0_T1DP/*/MIPI_DSI0_DP3/**/HDMI_TX0_AUX_P
182 | LVDS0_T1CLKP
183 | LVDS0_T1DN/*/MIPI_DSI0_DN3/**/HDMI_TX0_AUX_M
184 | LVDS0_T1AN
185 | GND
186 | LVDS0_T1AP
187 | NC/*/TS_X-
188 | LVDS0_T1BN
189 | NC/*/TS_X+
190 | LVDS0_T1BP
191 | NC/*/TS_Y+
192 | LVDS0_T1CN/*/MIPI_DSI0_DN2
193 | NC/*/TS_Y-
194 | LVDS0_T1CP/*/MIPI_DSI0_DP2
195 | NC/*/AGND
196 | NC/*/HPOUTFB
197 | NC/*/LINEIN1_LP
198 | NC/*/HPLOUT
199 | NC/*/LINEIN1_RP
200 | NC/*/HPROUT

Sheet: VAR-SOM-MX8X
PIN# | Symbol pin name source | SOM Usage | Applicable Configuration | Note
1 | GND |  |  |  | Odd
2 | GND |  |  |  | Even
3 | NC/*/ETH0_MDI_A_P |  |  |  | Odd
4 | NC/*/ETH0_MDI_C_P |  |  |  | Even
5 | NC/*/ETH0_MDI_A_M |  |  |  | Odd
6 | NC/*/ETH0_MDI_C_M |  |  |  | Even
7 | GND |  |  |  | Odd
8 | GND |  |  |  | Even
9 | NC/*/ETH0_MDI_B_P |  |  |  | Odd
10 | NC/*/ETH0_MDI_D_P |  |  |  | Even
11 | NC/*/ETH0_MDI_B_M |  |  |  | Odd
12 | NC/*/ETH0_MDI_D_M |  |  |  | Even
13 | GND |  |  |  | Odd
14 | GND |  |  |  | Even
15 | NC/*/ETH0_LED_ACT |  |  |  | Odd
16 | NC/*/ETH0_LED_LINK_10_100_1000 |  |  |  | Even
17 | MIPI_DSI0_GPIO0_IO00/ADMA_I2C1_SCL//MIPI_DSI0_PWM0_OUT////LSIO_GPIO1_IO27 |  |  |  | Odd
18 | ADMA_FLEXCAN1_RX/ADMA_SAI2_RXFS//ADMA_FTM_CH2///ADMA_SAI1_TXD////LSIO_GPIO1_IO17/*/DMIC_CLK |  |  |  | Even
19 | GND |  |  |  | Odd
20 | ADMA_ACM_MCLK_OUT0/ADMA_ESAI0_TX_HF_CLK//ADMA_LCD_CLK///ADMA_SPI2_SDO////LSIO_GPIO0_IO20/*/DMIC_DATA |  |  |  | Even
21 | ADMA_SPI0_CS0/ADMA_SAI0_RXD//M40_TPM0_CH1///M40_GPIO0_IO03////LSIO_GPIO1_IO08 |  |  |  | Odd
22 | ADMA_SPI0_CS1/ADMA_SAI0_RXC//ADMA_SAI1_TXD///ADMA_LCD_PWM0////LSIO_GPIO1_IO07 |  |  |  | Even
23 | ADMA_SAI1_RXD/ADMA_SAI0_RXFS//ADMA_SPI1_CS1///ADMA_LCD_D21////LSIO_GPIO0_IO29 |  |  |  | Odd
24 | ADMA_SPI0_SDO/ADMA_SAI0_TXFS//M40_I2C0_SDA///M40_GPIO0_IO01////LSIO_GPIO1_IO06 |  |  |  | Even
25 | ADMA_SPI0_SCK/ADMA_SAI0_TXC//M40_I2C0_SCL///M40_GPIO0_IO00////LSIO_GPIO1_IO04 |  |  |  | Odd
26 | ADMA_SPI0_SDI/ADMA_SAI0_TXD//M40_TPM0_CH0///M40_GPIO0_IO02////LSIO_GPIO1_IO05 |  |  |  | Even
27 | GND |  |  |  | Odd
28 | GND |  |  |  | Even
29 | MIPI_CSI0_ACM_MCLK_OUT////LSIO_GPIO3_IO04 |  |  |  | Odd
30 | CONN_ENET0_MDIO/ADMA_I2C3_SDA//CONN_ENET1_MDIO////LSIO_GPIO5_IO10 |  |  |  | Even
31 | NC |  |  |  | Odd
32 | VCC_SOM |  |  |  | Even
33 | NC |  |  |  | Odd
34 | VCC_SOM |  |  |  | Even
35 | NC |  |  |  | Odd
36 | LICELL |  |  |  | Even
37 | GND |  |  |  | Odd
38 | VDD_ENET1_1P8_2P5_3P3_IN |  |  |  | Even
39 | ADMA_SPI2_CS0////LSIO_GPIO1_IO00 |  |  |  | Odd
40 | ADMA_SPDIF0_EXT_CLK//ADMA_LCD_D12///CONN_ENET1_REFCLK_125M_25M////LSIO_GPIO0_IO12 |  |  |  | Even
41 | ADMA_ACM_MCLK_IN0/ADMA_ESAI0_RX_HF_CLK//ADMA_LCD_VSYNC///ADMA_SPI2_SDI////LSIO_GPIO0_IO19 |  |  |  | Odd
42 | ADMA_I2C1_SCL/CONN_USB_OTG2_PWR////LSIO_GPIO4_IO04 |  |  |  | Even
43 | ADMA_SPI2_SCK////LSIO_GPIO1_IO03 |  |  |  | Odd
44 | ADMA_FLEXCAN2_TX/ADMA_SAI3_RXFS//ADMA_UART3_TX///ADMA_SAI1_RXC////LSIO_GPIO1_IO20 |  |  |  | Even
45 | ADMA_SPI2_SDO////LSIO_GPIO1_IO01 |  |  |  | Odd
46 | ADMA_FLEXCAN2_RX/ADMA_SAI3_RXD//ADMA_UART3_RX///ADMA_SAI1_RXFS////LSIO_GPIO1_IO19 |  |  |  | Even
47 | GND |  |  |  | Odd
48 | CI_PI_CSI_EN/CI_PI_CSI_I2C_SCL//ADMA_I2C3_SCL///ADMA_SPI1_SDI////LSIO_GPIO3_IO02 |  |  |  | Even
49 | SOM_3V3_PER |  |  |  | Odd
50 | ADMA_FLEXCAN0_RX/ADMA_SAI2_RXC//ADMA_UART0_RTS_B///ADMA_SAI1_TXC////LSIO_GPIO1_IO15 |  |  |  | Even
51 | ADMA_FLEXCAN0_TX/ADMA_SAI2_RXD//ADMA_UART0_CTS_B///ADMA_SAI1_TXFS////LSIO_GPIO1_IO16 |  |  |  | Odd
52 | ADMA_UART0_TX/ADMA_MQS_L//ADMA_FLEXCAN0_TX///SCU_UART0_TX////LSIO_GPIO1_IO22 |  |  |  | Even
53 | ADMA_UART0_RX/ADMA_MQS_R//ADMA_FLEXCAN0_RX///SCU_UART0_RX////LSIO_GPIO1_IO21 |  |  |  | Odd
54 | ADMA_ESAI0_TX1//ADMA_LCD_D05///CONN_ENET1_RGMII_RXD3////LSIO_GPIO0_IO05 |  |  |  | Even
55 | ADMA_ESAI0_SCKT/CONN_MLB_SIG//ADMA_LCD_D03///CONN_ENET1_RGMII_TXD3////LSIO_GPIO0_IO03 |  |  |  | Odd
56 | ADMA_ESAI0_FST/CONN_MLB_CLK//ADMA_LCD_D01///CONN_ENET1_RGMII_TXD2////LSIO_GPIO0_IO01 |  |  |  | Even
57 | ADMA_ESAI0_TX0/CONN_MLB_DATA//ADMA_LCD_D04///CONN_ENET1_RGMII_RXC////LSIO_GPIO0_IO04 |  |  |  | Odd
58 | GND |  |  |  | Even
59 | GND |  |  |  | Odd
60 | CONN_USDHC1_CLK//ADMA_UART3_RX////LSIO_GPIO4_IO23 |  |  |  | Even
61 | CONN_USDHC1_DATA2/CONN_NAND_WE_B//ADMA_UART3_CTS_B////LSIO_GPIO4_IO27 |  |  |  | Odd
62 | CONN_USDHC1_DATA0/CONN_NAND_CE1_B//ADMA_MQS_L////LSIO_GPIO4_IO25 |  |  |  | Even
63 | CONN_USDHC1_DATA1/CONN_NAND_RE_B//ADMA_UART3_TX////LSIO_GPIO4_IO26 |  |  |  | Odd
64 | CONN_USDHC1_CMD/CONN_NAND_CE0_B//ADMA_MQS_R////LSIO_GPIO4_IO24 |  |  |  | Even
65 | CONN_USDHC1_DATA3/CONN_NAND_ALE//ADMA_UART3_RTS_B////LSIO_GPIO4_IO28 |  |  |  | Odd
66 | GND |  |  |  | Even
67 | GND |  |  |  | Odd
68 | ADMA_UART1_CTS_B/LSIO_PWM3_OUT//ADMA_LCD_D17///LSIO_GPT1_COMPARE////LSIO_GPIO0_IO24 |  |  |  | Even
69 | ADMA_UART1_RTS_B/LSIO_PWM2_OUT//ADMA_LCD_D16///LSIO_GPT1_CAPTURE////LSIO_GPT0_CLK |  |  |  | Odd
70 | CI_PI_CSI_MCLK/MIPI_CSI0_I2C0_SDA///ADMA_SPI1_SDO////LSIO_GPIO3_IO01 |  |  |  | Even
71 | ADMA_ESAI0_TX2_RX3/CONN_ENET1_RMII_RX_ER//ADMA_LCD_D06///CONN_ENET1_RGMII_RXD2////LSIO_GPIO0_IO06 |  |  |  | Odd
72 | CONN_ENET0_REFCLK_125M_25M/CONN_ENET0_PPS//CONN_ENET1_PPS////LSIO_GPIO5_IO09 |  |  |  | Even
73 | ADMA_ESAI0_TX4_RX1//ADMA_LCD_D08///CONN_ENET1_RGMII_TXD0////LSIO_GPIO0_IO08 |  |  |  | Odd
74 | CONN_ENET0_MDC/ADMA_I2C3_SCL//CONN_ENET1_MDC////LSIO_GPIO5_IO11 |  |  |  | Even
75 | ADMA_SAI0_TXFS/ADMA_SPI2_CS1//ADMA_SPI1_SCK////LSIO_GPIO0_IO28 |  |  |  | Odd
76 | GND |  |  |  | Even
77 | ADMA_SAI0_TXC/ADMA_SAI1_TXD//ADMA_SPI1_SDI///ADMA_LCD_D19////LSIO_GPIO0_IO26 |  |  |  | Odd
78 | GND |  |  |  | Even
79 | CI_PI_CSI_RESET/CI_PI_CSI_I2C_SDA//ADMA_I2C3_SDA///ADMA_SPI1_CS0////LSIO_GPIO3_IO03 |  |  |  | Odd
80 | CONN_USDHC1_CD_B/CONN_NAND_DQS_P//ADMA_SPI2_CS0///CONN_NAND_DQS////LSIO_GPIO4_IO22 |  |  |  | Even
81 | ADMA_ESAI0_TX3_RX2//ADMA_LCD_D07///CONN_ENET1_RGMII_RXD1////LSIO_GPIO0_IO07 |  |  |  | Odd
82 | CONN_USDHC1_WP/CONN_NAND_DQS_N//ADMA_SPI2_SDI////LSIO_GPIO4_IO21 |  |  |  | Even
83 | SCU_GPIO0_IO00/SCU_UART0_RX//M40_UART0_RX///ADMA_UART3_RX////LSIO_GPIO2_IO03 |  |  |  | Odd
84 | CI_PI_CSI_PCLK/MIPI_CSI0_I2C0_SCL///ADMA_SPI1_SCK////LSIO_GPIO3_IO00 |  |  |  | Even
85 | SCU_GPIO0_IO01/SCU_UART0_TX//M40_UART0_TX///ADMA_UART3_TX////SCU_WDOG0_WDOG_OUT |  |  |  | Odd
86 | LSIO_QSPI0B_SS1_B/LSIO_QSPI1A_SS1_B//LSIO_KPP0_ROW3////LSIO_GPIO3_IO24 |  |  |  | Even
87 | ADMA_I2C1_SDA/CONN_USB_OTG1_OC//CONN_USB_OTG2_OC////LSIO_GPIO4_IO05 |  |  |  | Odd
88 | ADMA_I2C1_SCL/CONN_USB_OTG1_PWR//CONN_USB_OTG2_PWR////LSIO_GPIO4_IO03 |  |  |  | Even
89 | GND |  |  |  | Odd
90 | MIPI_DSI1_GPIO0_IO01/ADMA_I2C2_SDA////LSIO_GPIO2_IO00 |  |  |  | Even
91 | CONN_USB_SS3_RX_M_LN_0 |  |  |  | Odd
92 | MIPI_DSI1_GPIO0_IO00/ADMA_I2C2_SCL//MIPI_DSI1_PWM0_OUT////LSIO_GPIO1_IO31 |  |  |  | Even
93 | CONN_USB_SS3_RX_P_LN_0 |  |  |  | Odd
94 | CONN_USB_OTG2_ID |  |  |  | Even
95 | GND |  |  |  | Odd
96 | ADMA_ESAI0_FSR/CONN_ENET1_RCLK50M_OUT//ADMA_LCD_D00///CONN_ENET1_RGMII_TXC////CONN_ENET1_RCLK50M_IN |  |  |  | Even
97 | CONN_USB_SS3_TX_P_LN_0 |  |  |  | Odd
98 | POR_B_3V3 |  |  |  | Even
99 | CONN_USB_SS3_TX_M_LN_0 |  |  |  | Odd
100 | HSIO_PCIE_IOB_EXT_REFCLK100M_N |  |  |  | Even
101 | GND |  |  |  | Odd
102 | HSIO_PCIE_IOB_EXT_REFCLK100M_P |  |  |  | Even
103 | VCC_SOM |  |  |  | Odd
104 | CONN_USB_OTG1_VBUS |  |  |  | Even
105 | VCC_SOM |  |  |  | Odd
106 | CONN_USB_OTG2_VBUS |  |  |  | Even
107 | VCC_SOM |  |  |  | Odd
108 | CONN_USB_OTG1_DN |  |  |  | Even
109 | VCC_SOM |  |  |  | Odd
110 | CONN_USB_OTG1_DP |  |  |  | Even
111 | VCC_SOM |  |  |  | Odd
112 | GND |  |  |  | Even
113 | ADMA_ESAI0_SCKR//ADMA_LCD_D02///CONN_ENET1_RGMII_TX_CTL////LSIO_GPIO0_IO02 |  |  |  | Odd
114 | CONN_USB_OTG2_DM |  |  |  | Even
115 | ADMA_UART2_RX/ADMA_FTM_CH0//ADMA_FLEXCAN1_RX////LSIO_GPIO1_IO24 |  |  |  | Odd
116 | CONN_USB_OTG2_DP |  |  |  | Even
117 | LSIO_QSPI0B_SS0_B/LSIO_QSPI1A_SS0_B//LSIO_KPP0_ROW2////LSIO_GPIO3_IO23 |  |  |  | Odd
118 | GND |  |  |  | Even
119 | MIPI_CSI0_DP0 |  |  |  | Odd
120 | ADMA_SPDIF0_TX/ADMA_MQS_L//ADMA_LCD_D11///CONN_ENET1_RGMII_RX_CTL////LSIO_GPIO0_IO11 |  |  |  | Even
121 | MIPI_CSI0_DN0 |  |  |  | Odd
122 | ADMA_SPDIF0_RX/ADMA_MQS_R//ADMA_LCD_D10///CONN_ENET1_RGMII_RXD0////LSIO_GPIO0_IO10 |  |  |  | Even
123 | MIPI_CSI0_DN1 |  |  |  | Odd
124 | ADMA_UART1_TX/LSIO_PWM0_OUT//LSIO_GPT0_CAPTURE////LSIO_GPIO0_IO21 |  |  |  | Even
125 | MIPI_CSI0_DP1 |  |  |  | Odd
126 | GND |  |  |  | Even
127 | MIPI_CSI0_DP2 |  |  |  | Odd
128 | HSIO_PCIE0_TX0_N |  |  |  | Even
129 | MIPI_CSI0_DN2 |  |  |  | Odd
130 | HSIO_PCIE0_TX0_P |  |  |  | Even
131 | MIPI_CSI0_DN3 |  |  |  | Odd
132 | GND |  |  |  | Even
133 | MIPI_CSI0_DP3 |  |  |  | Odd
134 | HSIO_PCIE0_RX0_P |  |  |  | Even
135 | MIPI_CSI0_CKP |  |  |  | Odd
136 | HSIO_PCIE0_RX0_N |  |  |  | Even
137 | MIPI_CSI0_CKN |  |  |  | Odd
138 | GND |  |  |  | Even
139 | GND |  |  |  | Odd
140 | LSIO_QSPI0B_DATA2/LSIO_QSPI1A_DATA2//LSIO_KPP0_COL3////LSIO_GPIO3_IO20/*/ADMA_ADC_IN0/M40_I2C0_SCL//M40_GPIO0_IO00////LSIO_GPIO1_IO10 |  |  |  | Even
141 | LSIO_QSPI0B_DATA1/LSIO_QSPI1A_DATA1//LSIO_KPP0_COL2////LSIO_GPIO3_IO19/*/ADMA_ADC_IN2/M40_UART0_RX//M40_GPIO0_IO02///ADMA_ACM_MCLK_IN0////LSIO_GPIO1_IO12 |  |  |  | Odd
142 | LSIO_QSPI0B_DATA0/LSIO_QSPI1A_DATA0//LSIO_KPP0_COL1////LSIO_GPIO3_IO18/*/ADMA_ADC_IN1/M40_I2C0_SDA//M40_GPIO0_IO01////LSIO_GPIO1_IO09 |  |  |  | Even
143 | LSIO_QSPI0B_DATA3/LSIO_QSPI1A_DATA3//LSIO_KPP0_ROW0////LSIO_GPIO3_IO21/*/ADMA_ADC_IN3/M40_UART0_TX//M40_GPIO0_IO03///ADMA_ACM_MCLK_OUT0////LSIO_GPIO1_IO11 |  |  |  | Odd
144 | GND |  |  |  | Even
145 | LSIO_QSPI0B_DQS/LSIO_QSPI1A_DQS//LSIO_KPP0_ROW1////LSIO_GPIO3_IO22/*/ADMA_ADC_IN5/M40_TPM0_CH1//M40_GPIO0_IO05////LSIO_GPIO1_IO13 |  |  |  | Odd
146 | SCU_DSC_BOOT_MODE1 |  |  |  | Even
147 | LSIO_QSPI0B_SCLK/LSIO_QSPI1A_SCLK//LSIO_KPP0_COL0////LSIO_GPIO3_IO17/*/ADMA_ADC_IN4/M40_TPM0_CH0//M40_GPIO0_IO04////LSIO_GPIO1_IO14 |  |  |  | Odd
148 | CI_PI_CSI_D06//ADMA_SAI2_RXD///SNVS_TAMPER_OUT4 |  |  |  | Even
149 | GND |  |  |  | Odd
150 | CI_PI_CSI_D02//ADMA_SAI0_RXC///SNVS_TAMPER_OUT0 |  |  |  | Even
151 | CI_PI_CSI_D09//ADMA_SAI3_RXD///SNVS_TAMPER_IN2 |  |  |  | Odd
152 | CI_PI_CSI_D03//ADMA_SAI0_RXD///SNVS_TAMPER_OUT1 |  |  |  | Even
153 | CI_PI_CSI_D08//ADMA_SAI3_RXC///SNVS_TAMPER_IN1 |  |  |  | Odd
154 | CI_PI_CSI_HSYNC/CI_PI_CSI_D00//ADMA_SAI3_RXFS///SNVS_TAMPER_IN3 |  |  |  | Even
155 | CI_PI_CSI_D05//ADMA_SAI2_RXC///SNVS_TAMPER_OUT3 |  |  |  | Odd
156 | CI_PI_CSI_D07//ADMA_SAI2_RXFS///SNVS_TAMPER_IN0 |  |  |  | Even
157 | CI_PI_CSI_D04//ADMA_SAI0_RXFS///SNVS_TAMPER_OUT2 |  |  |  | Odd
158 | GND |  |  |  | Even
159 | GND |  |  |  | Odd
160 | MIPI_DSI0_DN1 |  |  |  | Even
161 | MIPI_DSI0_DN0 |  |  |  | Odd
162 | MIPI_DSI0_DP1 |  |  |  | Even
163 | MIPI_DSI0_DP0 |  |  |  | Odd
164 | MIPI_DSI0_DN2 |  |  |  | Even
165 | MIPI_DSI0_DN3 |  |  |  | Odd
166 | MIPI_DSI0_DP2 |  |  |  | Even
167 | MIPI_DSI0_DP3 |  |  |  | Odd
168 | MIPI_DSI0_CKN |  |  |  | Even
169 | GND |  |  |  | Odd
170 | MIPI_DSI0_CKP |  |  |  | Even
171 | ADMA_UART2_TX/ADMA_FTM_CH1//ADMA_FLEXCAN1_TX////LSIO_GPIO1_IO23 |  |  |  | Odd
172 | GND |  |  |  | Even
173 | CI_PI_CSI_VSYNC/CI_PI_CSI_D01///SNVS_TAMPER_IN4 |  |  |  | Odd
174 | ADMA_SPI3_CS1/ADMA_I2C3_SCL//ADMA_LCD_RESET///ADMA_SPI2_CS0////ADMA_LCD_D16 |  |  |  | Even
175 | ADMA_UART1_RX/LSIO_PWM1_OUT//LSIO_GPT0_COMPARE///LSIO_GPT1_CLK////LSIO_GPIO0_IO22 |  |  |  | Odd
176 | ADMA_ACM_MCLK_IN1/ADMA_I2C3_SDA//ADMA_LCD_EN///ADMA_SPI2_SCK////ADMA_LCD_D17 |  |  |  | Even
177 | ADMA_ESAI0_TX5_RX0//ADMA_LCD_D09///CONN_ENET1_RGMII_TXD1////LSIO_GPIO0_IO09 |  |  |  | Odd
178 | GND |  |  |  | Even
179 | GND |  |  |  | Odd
180 | MIPI_DSI1_CKN |  |  |  | Even
181 | MIPI_DSI1_DP3 |  |  |  | Odd
182 | MIPI_DSI1_CKP |  |  |  | Even
183 | MIPI_DSI1_DN3 |  |  |  | Odd
184 | MIPI_DSI1_DN0 |  |  |  | Even
185 | GND |  |  |  | Odd
186 | MIPI_DSI1_DP0 |  |  |  | Even
187 | ADMA_SPI3_SDO//ADMA_LCD_D14////LSIO_GPIO0_IO14/*/TS_X- |  |  |  | Odd
188 | MIPI_DSI1_DN1 |  |  |  | Even
189 | ADMA_SPI3_SCK//ADMA_LCD_D13////LSIO_GPIO0_IO13/*/TS_X+ |  |  |  | Odd
190 | MIPI_DSI1_DP1 |  |  |  | Even
191 | ADMA_SPI3_CS0/ADMA_ACM_MCLK_OUT1//ADMA_LCD_HSYNC////LSIO_GPIO0_IO16/*/TS_Y+ |  |  |  | Odd
192 | MIPI_DSI1_DN2 |  |  |  | Even
193 | ADMA_SPI3_SDI//ADMA_LCD_D15////LSIO_GPIO0_IO15/*/TS_Y- |  |  |  | Odd
194 | MIPI_DSI1_DP2 |  |  |  | Even
195 | NC/*/AGND |  |  |  | Odd
196 | ADMA_SAI0_RXD/ADMA_SAI1_RXFS//ADMA_SPI1_CS0///ADMA_LCD_D20////LSIO_GPIO0_IO27/*/HPOUTFB |  |  |  | Even
197 | ADMA_SAI0_TXD/ADMA_SAI1_RXC//ADMA_SPI1_SDO///ADMA_LCD_D18////LSIO_GPIO0_IO25/*/LINEIN1_LP |  |  |  | Odd
198 | ADMA_FLEXCAN1_TX/ADMA_SAI3_RXC//ADMA_DMA0_REQ_IN0///ADMA_SAI1_RXD////LSIO_GPIO1_IO18/*/HPLOUT |  |  |  | Even
199 | ADMA_SAI1_RXFS/ADMA_SAI1_TXFS///ADMA_LCD_D23////LSIO_GPIO0_IO31/*/LINEIN1_RP |  |  |  | Odd
200 | ADMA_SAI1_RXC/ADMA_SAI1_TXC///ADMA_LCD_D22////LSIO_GPIO0_IO30/*/HPROUT |  |  |  | Even

Sheet: VAR-SOM-MX8MM
PIN# | Name | SOM Usage | Applicable Configuration | Note |  | dmic
1 | ENET_TX_CTL/////GPIO1_IO22/*/NC |  |  |  | Odd
2 | GND |  |  |  | Even |  | BOOT_CFG | 15 | 14 | 13 | 12 | 11 | 10 | 9 | 8 | 7 | 6 | 5 | 4 | 3 | 2 | 1 | 0
3 | ENET_TD3/////GPIO1_IO18/*/ETH_TRX0_P |  |  |  | Odd |  | eMMC - SD3 | 0 | 0 | 1 | 0 | 1 | 0 | 0 | 0 | 0 | 0 | 0 | 0 | 0 | 0 | 0 | 0
4 | ENET_RD0/////GPIO1_IO26/*/ETH_TRX2_P |  |  |  | Even |  | Sdcard - SD2 | 0 | 0 | 0 | 1 | 0 | 1 | 0 | 0 | 0 | X | X | 0 | 0 | 0 | 0 | X | X=Don't Care
5 | ENET_TD2/ENET_TX_CLK_IN|ENET_REF_CLK_ROOT_OUT/////GPIO1_IO19/*/ETH_TRX0_N |  |  |  | Odd |  | GPIO4_IO | 19 | 18 | 17 | X | 15 | 14 | 13 | 12 | X | 8 | 7 | 6 | 5 | 4 | 3 | 2 | X=Not Exposed
6 | ENET_RD1/////GPIO1_IO27/*/ETH_TRX2_N |  |  |  | Even
7 | GND |  |  |  | Odd
8 | GND |  |  |  | Even
9 | ENET_TD1/////GPIO1_IO20/*/ETH_TRX1_P |  |  |  | Odd
10 | ENET_RD2/////GPIO1_IO28/*/ETH_TRX3_P |  |  |  | Even
11 | ENET_TD0/////GPIO1_IO21/*/ETH_TRX1_N |  |  |  | Odd
12 | ENET_RD3/////GPIO1_IO29/*/ETH_TRX3_N |  |  |  | Even
13 | GND |  |  |  | Odd
14 | GND |  |  |  | Even
15 | ENET_RX_CTL/////GPIO1_IO24/*/LED_ACT |  |  |  | Odd
16 | ENET_RXC/ENET_RX_ER/////GPIO1_IO25/*/LED_LINK10_100_1000 |  |  |  | Even
17 | SPDIF_EXT_CLK/PWM1_OUT/////GPIO5_IO05 |  |  |  | Odd
18 | SAI5_RXD3/SAI1_TXD5//SAI1_TXFS///SAI5_TXD0////PDM_BIT3/////GPIO3_IO24/*/DMIC_CLK |  | AC |  | Even
19 | GND |  |  |  | Odd
20 | SAI5_MCLK/SAI1_TXC/////GPIO3_IO25/*/DMIC_DATA |  | AC |  | Even
21 | SAI2_RXD0/SAI5_TXD0////UART1_RTS_B/////GPIO4_IO23 |  |  |  | Odd
22 | SAI2_RXC/SAI5_TXC////UART1_RXD/////GPIO4_IO22 |  |  |  | Even
23 | SAI2_RXFS/SAI5_TXFS//SAI5_TXD1///SAI2_RXD1////UART1_TXD/////GPIO4_IO21 |  |  |  | Odd
24 | SAI2_TXFS/SAI5_TXD1///SAI2_TXD1////UART1_CTS_B/////GPIO4_IO24 |  |  |  | Even
25 | SAI2_TXC/SAI5_TXD2/////GPIO4_IO25 |  |  |  | Odd
26 | SAI2_TXD0/SAI5_TXD3/////GPIO4_IO26 |  |  |  | Even
27 | GND |  |  |  | Odd
28 | GND |  |  |  | Even
29 | GPIO1_IO07/ENET_MDIO//////EXT_CLK4 |  |  |  | Odd
30 | ~ENET_MDIO/////GPIO1_IO17 | ENET_MDIO | EC | MDIO Shared + 8.2K PU on SOM to NVCC_ENET | Even
31 | NC |  |  | For other iMX8 based SOM keep optional RES. for pwr | Odd
32 | VCC_SOM |  |  |  | Even
33 | NC |  |  | For other iMX8 based SOM keep optional RES. for pwr | Odd
34 | VCC_SOM |  |  |  | Even
35 | NC |  |  | For other iMX8 based SOM keep optional RES. for pwr | Odd
36 | VCC_SOM |  |  |  | Even
37 | GND |  |  |  | Odd
38 | VDD_ENET/*/NC | VDD_ENET | NO EC | Must provide power with no EC | Even
39 | ECSPI1_SS0/UART3_RTS_B/////GPIO5_IO09 |  |  |  | Odd
40 | GPIO1_IO13/USB1_OTG_OC/////PWM2_OUT |  |  |  | Even
41 | ~ECSPI1_MISO/UART3_CTS_B/////GPIO5_IO08 | ECSPI1 | CN or TP | ECSPI1 Shared | Odd
42 | BOOT_SEL |  |  | Internal Pulled up = eMMC | Even
43 | ~ECSPI1_SCLK/UART3_RXD/////GPIO5_IO06 | ECSPI1 | CN or TP | ECSPI1 Shared | Odd
44 | NC/*/CAN_TX |  |  |  | Even
45 | ~ECSPI1_MOSI/UART3_TXD/////GPIO5_IO07 | ECSPI1 | CN or TP | ECSPI1 Shared | Odd
46 | NC/*/CAN_RX |  |  |  | Even
47 | GND |  |  |  | Odd
48 | GPIO1_IO02/~WDOG_B/////WDOG_ANY | WDOG_B |  | Always connected to PMIC_WDOG_B input | Even
49 | SOM_3V3_PER |  |  | Power output with last SOM rail; Used as control to base peripheral power enable; | Odd
50 | SAI3_RXC/GPT1_CLK//SAI5_RXC////~UART2_CTS_B/////GPIO4_IO29 | UART2 | WBD or WB | UART2 Function can be released with BT disabled | Even
51 | SAI3_RXD/GPT1_COMPARE1//SAI5_RXD0////~UART2_RTS_B/////GPIO4_IO30 | UART2 | WBD or WB | UART2 Function can be released with BT disabled | Odd
52 | SAI3_TXC/GPT1_COMPARE2//SAI5_RXD2////~UART2_TXD/////GPIO5_IO00 | UART2 | WBD or WB | UART2 Function can be released with BT disabled | Even
53 | SAI3_TXFS/GPT1_CAPTURE2//SAI5_RXD1///SAI3_TXD1////~UART2_RXD/////GPIO4_IO31 | UART2 | WBD or WB | UART2 Function can be released with BT disabled | Odd
54 | UART1_RXD/ECSPI3_SCLK/////GPIO5_IO22 |  |  |  | Even
55 | _UART3_RXD/UART1_CTS_B/////GPIO5_IO26 |  |  | Duplicate pin on 175 | Odd
56 | UART1_TXD/ECSPI3_MOSI/////GPIO5_IO23 |  |  |  | Even
57 | _UART3_TXD/UART1_RTS_B/////GPIO5_IO27 |  |  | Duplicate pin on 124 | Odd
58 | GND |  |  |  | Even
59 | GND |  |  |  | Odd
60 | SD2_CLK/////GPIO2_IO13 |  |  |  | Even
61 | SD2_DATA2/////GPIO2_IO17 |  |  |  | Odd
62 | SD2_DATA0/////GPIO2_IO15 |  |  |  | Even
63 | SD2_DATA1/////GPIO2_IO16 |  |  |  | Odd
64 | SD2_CMD/////GPIO2_IO14 |  |  |  | Even
65 | SD2_DATA3/////GPIO2_IO18 |  |  |  | Odd
66 | GND |  |  |  | Even
67 | GND |  |  |  | Odd
68 | SPDIF_RX/PWM2_OUT/////GPIO5_IO04 |  |  |  | Even
69 | SPDIF_TX/PWM3_OUT/////GPIO5_IO03 |  |  |  | Odd
70 | ECSPI2_MOSI/UART4_TXD/////GPIO5_IO11 |  |  |  | Even
71 | SD2_RESET_B/////GPIO2_IO19 |  |  |  | Odd
72 | GPIO1_IO11/USB2_OTG_ID |  |  |  | Even
73 | SAI2_MCLK/SAI5_MCLK/////GPIO4_IO27 |  |  |  | Odd
74 | ~ENET_MDC/////GPIO1_IO16 | ENET_MDC | EC | MDC Shared | Even
75 | ECSPI2_SCLK/UART4_RXD/////GPIO5_IO10 |  |  |  | Odd
76 | GND |  |  |  | Even
77 | ECSPI2_MISO/UART4_CTS_B/////GPIO5_IO12 |  |  |  | Odd
78 | GND |  |  |  | Even
79 | ECSPI2_SS0/UART4_RTS_B/////GPIO5_IO13 |  |  |  | Odd
80 | GPIO1_IO10/USB1_OTG_ID |  |  |  | Even
81 | ~GPIO1_IO00/ENET_PHY_REF_CLK_ROOT_OUT/////REF_CLK_32K//////EXT_CLK1 | GPIO1_IO00 | CN | SOM usage: CAN-FD_CS | Odd
82 | SAI3_TXD/GPT1_COMPARE3//SAI5_RXD3/////GPIO5_IO01 |  |  |  | Even
83 | UART4_RXD/UART2_CTS_B//PCIE1_CLKREQ_B/////GPIO5_IO28 |  |  |  | Odd
84 | SAI1_RXD1/SAI5_RXD1///PDM_BIT1/////GPIO4_IO03//////~BOOT_CFG01 | BOOT_CFG |  | Can be driven after SOM_3V3_PER rise + 30ms | Even
85 | UART4_TXD/UART2_RTS_B/////GPIO5_IO29 |  |  |  | Odd
86 | SAI1_RXD3/SAI5_RXD3///PDM_BIT3/////GPIO4_IO05//////~BOOT_CFG03 | BOOT_CFG |  | Can be driven after SOM_3V3_PER rise + 30ms | Even
87 | I2C2_SDA/ENET1_1588_EVENT1_OUT/////GPIO5_IO17 |  |  |  | Odd
88 | I2C2_SCL/ENET1_1588_EVENT1_IN/////GPIO5_IO16 |  |  |  | Even
89 | GND |  |  |  | Odd
90 | ~I2C3_SDA/PWM3_OUT//GPT3_CLK/////GPIO5_IO19 | I2C3 | AC | I2C3 Shared on SOM | Even
91 | ~GPIO1_IO15/USB2_OTG_OC/////PWM4_OUT//////CLKO2 | GPIO1_IO15 | CN | SOM usage: CN-TX_INT (SOM Rev v1.3 and up) | Odd
92 | ~I2C3_SCL/PWM4_OUT//GPT2_CLK/////GPIO5_IO18 | I2C3 | AC | I2C3 Shared on SOM | Even
93 | SAI1_TXFS/SAI5_TXFS/////GPIO4_IO10 |  |  |  | Odd
94 | USB1_ID |  |  |  | Even
95 | GND |  |  |  | Odd
96 | GPIO1_IO06/ENET1_MDC/////SD1_CD_B//////EXT_CLK3 |  |  |  | Even
97 | ENET_TXC/ENET_TX_ER/////GPIO1_IO23/*/NC |  |  |  | Odd
98 | PMIC_PWRON_B |  |  | Include 100K pull up to VCC_SOM on SOM | Even
99 | ~GPIO1_IO14/USB2_OTG_PWR/////PWM3_OUT//////CLKO1 | GPIO1_IO14 | TP | SOM usage: RES-TOUCH_CS_B | Odd
100 | PCIE1_REF_CLK_N |  |  |  | Even
101 | GND |  |  |  | Odd
102 | PCIE1_REF_CLK_P |  |  |  | Even
103 | VCC_SOM |  |  |  | Odd
104 | USB2_VBUS |  |  |  | Even
105 | VCC_SOM |  |  |  | Odd
106 | USB1_VBUS |  |  |  | Even
107 | VCC_SOM |  |  |  | Odd
108 | USB2_D_N |  |  |  | Even
109 | VCC_SOM |  |  |  | Odd
110 | USB2_D_P |  |  |  | Even
111 | VCC_SOM |  |  |  | Odd
112 | GND |  |  |  | Even
113 | SAI3_RXFS/GPT1_CAPTURE1//SAI5_RXFS///SAI3_RXD1/////GPIO4_IO28 |  |  |  | Odd
114 | USB1_D_N |  |  |  | Even
115 | UART2_RXD/ECSPI3_MISO/////GPIO5_IO24 |  |  |  | Odd
116 | USB1_D_P |  |  |  | Even
117 | GPIO1_IO08/ENET1_1588_EVENT0_IN/////SD2_RESET_B |  |  |  | Odd
118 | GND |  |  |  | Even
119 | CSI_P1_D0_P |  |  |  | Odd
120 | SAI3_MCLK/PWM4_OUT//SAI5_MCLK/////GPIO5_IO02 |  |  |  | Even
121 | CSI_P1_D0_N |  |  |  | Odd
122 | GPIO1_IO12/USB1_OTG_PWR |  |  |  | Even
123 | CSI_P1_D1_N |  |  |  | Odd
124 | UART3_TXD/UART1_RTS_B/////GPIO5_IO27 |  |  | Duplicate pin 57 | Even
125 | CSI_P1_D1_P |  |  |  | Odd
126 | GND |  |  |  | Even
127 | CSI_P1_D2_P |  |  |  | Odd
128 | PCIE1_TX_N |  |  |  | Even
129 | CSI_P1_D2_N |  |  |  | Odd
130 | PCIE1_TX_P |  |  |  | Even
131 | CSI_P1_D3_N |  |  |  | Odd
132 | GND |  |  |  | Even
133 | CSI_P1_D3_P |  |  |  | Odd
134 | PCIE1_RX_P |  |  |  | Even
135 | CSI_P1_CK_P |  |  |  | Odd
136 | PCIE1_RX_N |  |  |  | Even
137 | CSI_P1_CK_N |  |  |  | Odd
138 | GND |  |  |  | Even
139 | GND |  |  |  | Odd
140 | PMIC_STBY_REQ |  |  |  | Even
141 | SAI1_TXD2/SAI5_TXD2/////GPIO4_IO14//////~BOOT_CFG10 | BOOT_CFG |  | Can be driven after SOM_3V3_PER rise + 30ms | Odd
142 | PMIC_ON_REQ |  |  |  | Even
143 | ONOFF |  |  | Can be used to wake from "poweroff" Includes 100K pull up to VCC_SOM on SOM | Odd
144 | GND |  |  |  | Even
145 | SAI1_RXD5/SAI6_TXD0//SAI6_RXD0///SAI1_RXFS/////GPIO4_IO07//////~BOOT_CFG05 | BOOT_CFG |  | Can be driven after SOM_3V3_PER rise + 30ms | Odd
146 | SAI1_TXD6/SAI6_RXFS//SAI6_TXFS/////GPIO4_IO18//////~BOOT_CFG14 | BOOT_CFG |  | Can be driven after SOM_3V3_PER rise + 30ms | Even
147 | SAI1_TXD0/SAI5_TXD0/////GPIO4_IO12//////~BOOT_CFG08 | BOOT_CFG |  | Can be driven after SOM_3V3_PER rise + 30ms | Odd
148 | SAI1_RXD0/SAI5_RXD0//SAI1_TXD1///PDM_BIT0/////GPIO4_IO02//////~BOOT_CFG00 | BOOT_CFG |  | Can be driven after SOM_3V3_PER rise + 30ms | Even
149 | GND |  |  |  | Odd
150 | ~GPIO1_IO03/USDHC1_VSELECT | GPIO1_IO03 | TP | SOM usage: RES-TOUCH_INT_B | Even
151 | SAI1_RXD4/SAI6_TXC//SAI6_RXC/////GPIO4_IO06//////~BOOT_CFG04 | BOOT_CFG |  | Can be driven after SOM_3V3_PER rise + 30ms | Odd
152 | SAI1_TXD1/SAI5_TXD1/////GPIO4_IO13//////~BOOT_CFG09 | BOOT_CFG |  | Can be driven after SOM_3V3_PER rise + 30ms | Even
153 | ~GPIO1_IO05/M4_NMI/////PMIC_READY | GPIO1_IO05 | CN | SOM usage: CAN_INT_B | Odd
154 | GPIO1_IO01/PWM1_OUT/////REF_CLK_24M//////EXT_CLK2 |  |  |  | Even
155 | SAI1_TXD5/SAI6_RXD0//SAI6_TXD0/////GPIO4_IO17//////~BOOT_CFG13 | BOOT_CFG |  | Can be driven after SOM_3V3_PER rise + 30ms | Odd
156 | SAI1_TXD7/SAI6_MCLK///PDM_CLK/////GPIO4_IO19//////~BOOT_CFG15 | BOOT_CFG |  | Can be driven after SOM_3V3_PER rise + 30ms | Even
157 | SAI1_RXD6/SAI6_TXFS//SAI6_RXFS/////GPIO4_IO08//////~BOOT_CFG06 | BOOT_CFG |  | Can be driven after SOM_3V3_PER rise + 30ms | Odd
158 | GND |  |  |  | Even
159 | GND |  |  |  | Odd
160 | DSI_TX1_N/*/LVDS0_CH0_TX1_N |  | LD |  | Even
161 | DSI_TX0_N/*/LVDS0_CH0_TX0_N |  | LD |  | Odd
162 | DSI_TX1_P/*/LVDS0_CH0_TX1_P |  | LD |  | Even
163 | DSI_TX0_P/*/LVDS0_CH0_TX0_P |  | LD |  | Odd
164 | DSI_TX2_N/*/LVDS0_CH0_TX2_N |  | LD |  | Even
165 | DSI_TX3_N/*/LVDS0_CH0_TX3_N |  | LD |  | Odd
166 | DSI_TX2_P/*/LVDS0_CH0_TX2_P |  | LD |  | Even
167 | DSI_TX3_P/*/LVDS0_CH0_TX3_P |  | LD |  | Odd
168 | DSI_CLK_N/*/LVDS0_CH0_CLK_N |  | LD |  | Even
169 | GND |  |  |  | Odd
170 | DSI_CLK_P/*/LVDS0_CH0_CLK_P |  | LD |  | Even
171 | UART2_TXD/ECSPI3_SS0/////GPIO5_IO25 |  |  |  | Odd
172 | GND |  |  |  | Even
173 | SAI1_TXD3/SAI5_TXD3/////GPIO4_IO15//////~BOOT_CFG11 | BOOT_CFG |  | Can be driven after SOM_3V3_PER rise + 30ms | Odd
174 | I2C4_SCL/PWM2_OUT//PCIE1_CLKREQ_B/////GPIO5_IO20 |  |  |  | Even
175 | UART3_RXD/UART1_CTS_B/////GPIO5_IO26 |  |  | Duplicate pin 55 | Odd
176 | I2C4_SDA/PWM1_OUT/////GPIO5_IO21 |  |  |  | Even
177 | SAI1_TXC/SAI5_TXC/////GPIO4_IO11 |  |  |  | Odd
178 | GND |  |  |  | Even
179 | GND |  |  |  | Odd
180 | NC/*/LVDS0_CH1_CLK_N |  | LD |  | Even
181 | NC/*/LVDS0_CH1_TX3_P |  | LD |  | Odd
182 | NC/*/LVDS0_CH1_CLK_P |  | LD |  | Even
183 | NC/*/LVDS0_CH1_TX3_N |  | LD |  | Odd
184 | NC/*/LVDS0_CH1_TX0_N |  | LD |  | Even
185 | GND |  |  |  | Odd
186 | NC/*/LVDS0_CH1_TX0_P |  | LD |  | Even
187 | SAI1_RXD2/SAI5_RXD2///PDM_BIT2/////GPIO4_IO04//////~BOOT_CFG02/*/TS_X- | BOOT_CFG |  | Can be driven after SOM_3V3_PER rise + 30ms | Odd
188 | NC/*/LVDS0_CH1_TX1_N |  | LD |  | Even
189 | SAI1_MCLK/SAI5_MCLK//SAI1_TXC///PDM_CLK/////GPIO4_IO20/*/TS_X+ |  |  |  | Odd
190 | NC/*/LVDS0_CH1_TX1_P |  | LD |  | Even
191 | SAI1_RXFS/SAI5_RXFS/////GPIO4_IO00/*/TS_Y+ |  |  |  | Odd
192 | NC/*/LVDS0_CH1_TX2_N |  | LD |  | Even
193 | SAI1_RXC/SAI5_RXC/////GPIO4_IO01/*/TS_Y- |  |  |  | Odd
194 | NC/*/LVDS0_CH1_TX2_P |  | LD |  | Even
195 | AGND |  |  |  | Odd
196 | SAI5_RXFS/SAI1_TXD0/////GPIO3_IO19/*/HPOUTFB |  | AC |  | Even
197 | SAI5_RXC/SAI1_TXD1////PDM_CLK/////GPIO3_IO20/*/LINEIN1_LP |  | AC |  | Odd
198 | SAI5_RXD0/SAI1_TXD2////PDM_BIT0/////GPIO3_IO21/*/HPLOUT |  | AC |  | Even
199 | SAI5_RXD1/SAI1_TXD3//SAI1_TXFS///SAI5_TXFS////PDM_BIT1/////GPIO3_IO22/*/LINEIN1_RP |  | AC |  | Odd
200 | SAI5_RXD2/SAI1_TXD4//SAI1_TXFS///SAI5_TXC////PDM_BIT2/////GPIO3_IO23/*/HPROUT |  | AC |  | Even

Sheet: VAR-SOM-MX8MN
PIN# | Name | SOM Usage | Applicable Configuration | Note |  | HIGHLIGHT IN RED | xxx | HIGHLIGHT IN GRN | yyy | HIGHLIGHT IN YEL | zz
1 | ENET_TX_CTL//SAI6_MCLK/////GPIO1_IO22//////SD3_D0/*/NC |  |  |  | Odd
2 | GND |  |  |  | Even
3 | ENET_TD3//SAI6_TXC///PDM_BIT1////SPDIF_EXT_CLK/////GPIO1_IO18//////SD3_D6/*/ETH_TRX0_P |  |  |  | Odd
4 | ENET_RD0//SAI7_RXD0///PDM_BIT1/////GPIO1_IO26//////SD3_D4/*/ETH_TRX2_P |  |  |  | Even
5 | ENET_TD2/ENET_TX_CLK_IN|ENET_REF_CLK_ROOT_OUT//SAI6_RXD0///PDM_BIT3/////GPIO1_IO19//////SD3_D7/*/ETH_TRX0_N |  |  |  | Odd
6 | ENET_RD1//SAI7_RXFS///PDM_BIT0/////GPIO1_IO27//////SD3_RESET_B/*/ETH_TRX2_N |  |  |  | Even
7 | GND |  |  |  | Odd
8 | GND |  |  |  | Even
9 | ENET_TD1//SAI6_RXFS///PDM_BIT2/////GPIO1_IO20//////SD3_CD_B/*/ETH_TRX1_P |  |  |  | Odd
10 | ENET_RD2//SAI7_RXC///PDM_CLK/////GPIO1_IO28//////SD3_CLK/*/ETH_TRX3_P |  |  |  | Even
11 | ENET_TD0//SAI6_RXC///PDM_BIT1/////GPIO1_IO21//////SD3_WP/*/ETH_TRX1_N |  |  |  | Odd
12 | ENET_RD3//SAI7_MCLK///SPDIF_IN/////GPIO1_IO29//////SD3_CMD/*/ETH_TRX3_N |  |  |  | Even
13 | GND |  |  |  | Odd
14 | GND |  |  |  | Even
15 | ENET_RX_CTL//SAI7_TXFS///PDM_BIT3/////GPIO1_IO24//////SD3_D2/*/LED_ACT |  |  |  | Odd
16 | ENET_RXC/ENET_RX_ER//SAI7_TXC///PDM_BIT2/////GPIO1_IO25//////SD3_D3/*/LED_LINK10_100_1000 |  |  |  | Even
17 | SPDIF_EXT_CLK/PWM1_OUT/////GPIO5_IO05 |  |  |  | Odd
18 | SAI5_RXD3///SAI5_TXD0////PDM_BIT3/////GPIO3_IO24/*/DMIC_CLK |  |  |  | Even
19 | GND |  |  |  | Odd
20 | SAI5_MCLK/////GPIO3_IO25/*/DMIC_DATA |  |  |  | Even
21 | SAI2_RXD0/SAI5_TXD0///SAI2_TXD1////UART1_RTS_B/////GPIO4_IO23//////PDM_BIT3 |  |  |  | Odd
22 | SAI2_RXC/SAI5_TXC////UART1_RXD/////GPIO4_IO22//////PDM_BIT1 |  |  |  | Even
23 | SAI2_RXFS/SAI5_TXFS//SAI5_TXD1///SAI2_RXD1////UART1_TXD/////GPIO4_IO21//////PDM_BIT2 |  |  |  | Odd
24 | SAI2_TXFS/SAI5_TXD1///SAI2_TXD1////UART1_CTS_B/////GPIO4_IO24//////PDM_BIT2 |  |  |  | Even
25 | SAI2_TXC/SAI5_TXD2/////GPIO4_IO25//////PDM_BIT1 |  |  |  | Odd
26 | SAI2_TXD0/SAI5_TXD3/////GPIO4_IO26 |  |  |  | Even
27 | GND |  |  |  | Odd
28 | GND |  |  |  | Even
29 | GPIO1_IO07/ENET_MDIO/////SD1_WP//////EXT_CLK4 |  |  |  | Odd
30 | ~ENET_MDIO//SAI6_TXFS///PDM_BIT2////SPDIF_IN/////GPIO1_IO17//////SD3_D5 | ENET_MDIO | EC | MDIO Shared + 8.2K PU on SOM to NVCC_ENET | Even
31 | NC |  |  | For other iMX8 based SOM keep optional RES. for pwr | Odd
32 | VCC_SOM |  |  |  | Even
33 | NC |  |  | For other iMX8 based SOM keep optional RES. for pwr | Odd
34 | VCC_SOM |  |  |  | Even
35 | NC |  |  | For other iMX8 based SOM keep optional RES. for pwr | Odd
36 | VCC_SOM |  |  |  | Even
37 | GND |  |  |  | Odd
38 | VDD_ENET/*/NC | VDD_ENET | NO EC | Must provide power with NO EC | Even
39 | ECSPI1_SS0/UART3_RTS_B//I2C2_SDA///SAI5_RXD1////SAI5_TXFS/////GPIO5_IO09 |  |  |  | Odd
40 | GPIO1_IO13/USB1_OTG_OC/////PWM2_OUT |  |  |  | Even
41 | ~ECSPI1_MISO/UART3_CTS_B//I2C2_SCL///SAI5_RXD0/////GPIO5_IO08 | ECSPI1 | CN or TP | ECSPI1 Shared | Odd
42 | BOOT_SEL |  |  | Internal Pulled up = eMMC | Even
43 | ~ECSPI1_SCLK/UART3_RXD//I2C1_SCL///SAI5_RXFS/////GPIO5_IO06 | ECSPI1 | CN or TP | ECSPI1 Shared | Odd
44 | NC/*/CAN_TX |  |  |  | Even
45 | ~ECSPI1_MOSI/UART3_TXD//I2C1_SDA///SAI5_RXC/////GPIO5_IO07 | ECSPI1 | CN or TP | ECSPI1 Shared | Odd
46 | NC/*/CAN_RX |  |  |  | Even
47 | GND |  |  |  | Odd
48 | GPIO1_IO02/~WDOG_B/////WDOG_ANY | WDOG_B |  | Always connected to PMIC_WDOG_B input | Even
49 | SOM_3V3_PER |  |  | Power output with last SOM rail; Used as control to base peripheral power enable; | Odd
50 | SAI3_RXC/GPT1_CLK//SAI5_RXC///SAI2_RXD1////~UART2_CTS_B/////GPIO4_IO29//////PDM_CLK | UART2 | WBD or WB | Function can be released with BT disabled | Even
51 | SAI3_RXD/GPT1_COMPARE1//SAI5_RXD0///SAI3_TXD1////~UART2_RTS_B/////GPIO4_IO30//////PDM_BIT1 | UART2 | WBD or WB | Function can be released with BT disabled | Odd
52 | SAI3_TXC/GPT1_COMPARE2//SAI5_RXD2///SAI2_TXD1////~UART2_TXD/////GPIO5_IO00//////PDM_BIT2 | UART2 | WBD or WB | Function can be released with BT disabled | Even
53 | SAI3_TXFS/GPT1_CAPTURE2//SAI5_RXD1///SAI3_TXD1////~UART2_RXD/////GPIO4_IO31//////PDM_BIT3 | UART2 | WBD or WB | Function can be released with BT disabled | Odd
54 | UART1_RXD/ECSPI3_SCLK/////GPIO5_IO22 |  |  |  | Even
55 | _UART3_RXD/UART1_CTS_B//SD3_RESET_B///GPT1_CAPTURE2/////GPIO5_IO26 |  |  | Duplicate pin on 157 | Odd
56 | UART1_TXD/ECSPI3_MOSI/////GPIO5_IO23 |  |  |  | Even
57 | _UART3_TXD/UART1_RTS_B//SD3_VSELECT///GPT1_CLK/////GPIO5_IO27 |  |  | Duplicate pin on 124 | Odd
58 | GND |  |  |  | Even
59 | GND |  |  |  | Odd
60 | SD2_CLK/SAI5_RXFS//ECSPI2_SCLK///UART4_RXD////SAI5_MCLK/////GPIO2_IO13 |  |  |  | Even
61 | SD2_D2/SAI5_TXC//ECSPI2_SS0///SPDIF_OUT////PDM_BIT2/////GPIO2_IO17 |  |  |  | Odd
62 | SD2_D0/SAI5_RXD0//I2C4_SDA///UART2_RXD////PDM_BIT0/////GPIO2_IO15 |  |  |  | Even
63 | SD2_D1/SAI5_TXFS//I2C4_SCL///UART2_TXD////PDM_BIT1/////GPIO2_IO16 |  |  |  | Odd
64 | SD2_CMD/SAI5_RXC//ECSPI2_MOSI///UART4_TXD////PDM_CLK/////GPIO2_IO14 |  |  |  | Even
65 | SD2_D3/SAI5_TXD0//ECSPI2_MISO///SPDIF_IN////PDM_BIT3/////GPIO2_IO18 |  |  |  | Odd
66 | GND |  |  |  | Even
67 | GND |  |  |  | Odd
68 | SPDIF_RX/PWM2_OUT/////GPIO5_IO04 |  |  |  | Even
69 | SPDIF_TX/PWM3_OUT/////GPIO5_IO03 |  |  |  | Odd
70 | ECSPI2_MOSI/UART4_TXD//I2C3_SDA///SAI5_RXD3////SAI5_TXD0/////GPIO5_IO11 |  |  |  | Even
71 | SD2_RESET_B/////GPIO2_IO19 |  |  |  | Odd
72 | GPIO1_IO11/PWM2_OUT |  |  |  | Even
73 | SAI2_MCLK/SAI5_MCLK/////GPIO4_IO27//////SAI3_MCLK |  |  |  | Odd
74 | ~ENET_MDC//SAI6_TXD0///PDM_BIT3////SPDIF_OUT/////GPIO1_IO16//////SD3_STROBE | ENET_MDC | EC | MDC Shared | Even
75 | ECSPI2_SCLK/UART4_RXD//I2C3_SCL///SAI5_RXD2////SAI5_TXC/////GPIO5_IO10 |  |  |  | Odd
76 | GND |  |  |  | Even
77 | ECSPI2_MISO/UART4_CTS_B//I2C4_SCL///SAI5_MCLK/////GPIO5_IO12 |  |  |  | Odd
78 | GND |  |  |  | Even
79 | ECSPI2_SS0/UART4_RTS_B//I2C4_SDA/////GPIO5_IO13 |  |  |  | Odd
80 | GPIO1_IO10/USB1_OTG_ID//PWM3_OUT |  |  |  | Even
81 | ~GPIO1_IO00/ENET_PHY_REF_CLK_ROOT/////REF_CLK_32K//////EXT_CLK1 | GPIO1_IO00 | CN | SOM usage: CAN-FD_CS | Odd
82 | SAI3_TXD/GPT1_COMPARE3//SAI5_RXD3////SPDIF_EXT_CLK/////GPIO5_IO01 |  |  |  | Even
83 | UART4_RXD/UART2_CTS_B///GPT1_COMPARE1/////GPIO5_IO28 |  |  |  | Odd
84 | NC |  |  |  | Even
85 | UART4_TXD/UART2_RTS_B///GPT1_CAPTURE1/////GPIO5_IO29 |  |  |  | Odd
86 | NC |  |  | Include 1K pull Down on SOM | Even
87 | I2C2_SDA/ENET_1588_EVENT1_OUT//SD3_WP///ECSPI1_SS0/////GPIO5_IO17 |  |  |  | Odd
88 | I2C2_SCL/ENET_1588_EVENT1_IN//SD3_CD_B///ECSPI1_MISO/////GPIO5_IO16 |  |  |  | Even
89 | GND |  |  |  | Odd
90 | ~I2C3_SDA/PWM3_OUT//GPT3_CLK///ECSPI2_MOSI/////GPIO5_IO19 | I2C3 | AC | I2C3 Shared on SOM | Even
91 | GPIO1_IO15////SD3_WP/////PWM4_OUT//////CCM_CLKO2 | GPIO1_IO15 | CN | SOM usage: CN-TX_INT (SOM Rev v1.3 and up) | Odd
92 | ~I2C3_SCL/PWM4_OUT//GPT2_CLK///ECSPI2_SCLK/////GPIO5_IO18 | I2C3 | AC | I2C3 Shared on SOM | Even
93 | NC |  |  |  | Odd
94 | USB1_ID |  |  |  | Even
95 | GND |  |  |  | Odd
96 | GPIO1_IO06/ENET_MDC/////SD1_CD_B//////EXT_CLK3 |  |  |  | Even
97 | ENET_TXC/ENET_TX_ER//SAI7_TXD0/////GPIO1_IO23//////SD3_D1/*/NC |  |  |  | Odd
98 | PMIC_PWRON_B |  |  |  | Even
99 | ~GPIO1_IO14////SD3_CD_B/////PWM3_OUT//////CCM_CLKO1 | GPIO1_IO14 | TP |  | Odd
100 | NC |  |  |  | Even
101 | GND |  |  |  | Odd
102 | NC |  |  |  | Even
103 | VCC_SOM |  |  |  | Odd
104 | NC |  |  |  | Even
105 | VCC_SOM |  |  |  | Odd
106 | USB1_VBUS |  |  |  | Even
107 | VCC_SOM |  |  |  | Odd
108 | NC |  |  |  | Even
109 | VCC_SOM |  |  |  | Odd
110 | NC |  |  |  | Even
111 | VCC_SOM |  |  |  | Odd
112 | GND |  |  |  | Even
113 | SAI3_RXFS/GPT1_CAPTURE1//SAI5_RXFS///SAI3_RXD1////SPDIF_IN/////GPIO4_IO28//////PDM_BIT0 |  |  |  | Odd
114 | USB1_D_N |  |  |  | Even
115 | UART2_RXD/ECSPI3_MISO///GPT1_COMPARE3/////GPIO5_IO24 |  |  |  | Odd
116 | USB1_D_P |  |  |  | Even
117 | GPIO1_IO08/ENET_1588_EVENT0_IN//PWM1_OUT/////SD2_RESET_B |  |  |  | Odd
118 | GND |  |  |  | Even
119 | CSI_D0_P |  |  |  | Odd
120 | SAI3_MCLK/PWM4_OUT//SAI5_MCLK////SPDIF_OUT/////GPIO5_IO02//////SPDIF_IN |  |  |  | Even
121 | CSI_D0_N |  |  |  | Odd
122 | GPIO1_IO12/USB1_OTG_PWR |  |  |  | Even
123 | CSI_D1_N |  |  |  | Odd
124 | UART3_TXD/UART1_RTS_B//SD3_VSELECT///GPT1_CLK/////GPIO5_IO27 |  |  | Duplicate pin 57 | Even
125 | CSI_D1_P |  |  |  | Odd
126 | GND |  |  |  | Even
127 | CSI_D2_P |  |  |  | Odd
128 | NC |  |  |  | Even
129 | CSI_D2_N |  |  |  | Odd
130 | NC |  |  |  | Even
131 | CSI_D3_N |  |  |  | Odd
132 | GND |  |  |  | Even
133 | CSI_D3_P |  |  |  | Odd
134 | NC |  |  |  | Even
135 | CSI_CK_P |  |  |  | Odd
136 | NC |  |  |  | Even
137 | CSI_CK_N |  |  |  | Odd
138 | GND |  |  |  | Even
139 | GND |  |  |  | Odd
140 | PMIC_STBY_REQ |  |  |  | Even
141 | NC |  |  |  | Odd
142 | PMIC_ON_REQ |  |  |  | Even
143 | ONOFF |  |  | Can be used to wake from "poweroff" | Odd
144 | GND |  |  |  | Even
145 | NC |  |  |  | Odd
146 | NC |  |  |  | Even
147 | NC |  |  |  | Odd
148 | NC |  |  |  | Even
149 | GND |  |  |  | Odd
150 | ~GPIO1_IO03/SD1_VSELECT/////SDMA1_EXT_EVENT0//////XTAL_OK | GPIO1_IO03 | TP | SOM usage: RES-TOUCH_INT_B | Even
151 | NC |  |  |  | Odd
152 | NC |  |  |  | Even
153 | ~GPIO1_IO05/M4_NMI/////PMIC_READY//////INT_BOOT | GPIO1_IO05 | CN | SOM usage: CAN_INT_B | Odd
154 | GPIO1_IO01/PWM1_OUT/////REF_CLK_24M//////EXT_CLK2 |  |  |  | Even
155 | NC |  |  |  | Odd
156 | NC |  |  |  | Even
157 | NC |  |  |  | Odd
158 | GND |  |  |  | Even
159 | GND |  |  |  | Odd
160 | DSI_D1_N/*/LVDS0_CH0_TX1_N |  |  |  | Even
161 | DSI_D0_N/*/LVDS0_CH0_TX0_N |  |  |  | Odd
162 | DSI_D1_P/*/LVDS0_CH0_TX1_P |  |  |  | Even
163 | DSI_D0_P/*/LVDS0_CH0_TX0_P |  |  |  | Odd
164 | DSI_D2_N/*/LVDS0_CH0_TX2_N |  |  |  | Even
165 | DSI_D3_N/*/LVDS0_CH0_TX3_N |  |  |  | Odd
166 | DSI_D2_P/*/LVDS0_CH0_TX2_P |  |  |  | Even
167 | DSI_D3_P/*/LVDS0_CH0_TX3_P |  |  |  | Odd
168 | DSI_CLK_N/*/LVDS0_CH0_CLK_N |  |  |  | Even
169 | GND |  |  |  | Odd
170 | DSI_CLK_P/*/LVDS0_CH0_CLK_P |  |  |  | Even
171 | UART2_TXD/ECSPI3_SS0///GPT1_COMPARE2/////GPIO5_IO25 |  |  |  | Odd
172 | GND |  |  |  | Even
173 | NC |  |  |  | Odd
174 | I2C4_SCL/PWM2_OUT///ECSPI2_MISO/////GPIO5_IO20 |  |  |  | Even
175 | UART3_RXD/UART1_CTS_B//SD3_RESET_B///GPT1_CAPTURE2/////GPIO5_IO26 |  |  | Duplicate pin 55 | Odd
176 | I2C4_SDA/PWM1_OUT///ECSPI2_SS0/////GPIO5_IO21 |  |  |  | Even
177 | NC |  |  |  | Odd
178 | GND |  |  |  | Even
179 | GND |  |  |  | Odd
180 | NC/*/LVDS0_CH1_CLK_N |  |  |  | Even
181 | NC/*/LVDS0_CH1_TX3_P |  |  |  | Odd
182 | NC/*/LVDS0_CH1_CLK_P |  |  |  | Even
183 | NC/*/LVDS0_CH1_TX3_N |  |  |  | Odd
184 | NC/*/LVDS0_CH1_TX0_N |  |  |  | Even
185 | GND |  |  |  | Odd
186 | NC/*/LVDS0_CH1_TX0_P |  |  |  | Even
187 | NC/*/TS_X- |  |  |  | Odd
188 | NC/*/LVDS0_CH1_TX1_N |  |  |  | Even
189 | NC/*/TS_X+ |  |  |  | Odd
190 | NC/*/LVDS0_CH1_TX1_P |  |  |  | Even
191 | NC/*/TS_Y+ |  |  |  | Odd
192 | NC/*/LVDS0_CH1_TX2_N |  |  |  | Even
193 | NC/*/TS_Y- |  |  |  | Odd
194 | NC/*/LVDS0_CH1_TX2_P |  |  |  | Even
195 | AGND |  |  |  | Odd
196 | SAI5_RXFS/////GPIO3_IO19/*/HPOUTFB |  |  |  | Even
197 | SAI5_RXC////PDM_CLK/////GPIO3_IO20/*/LINEIN1_LP |  |  |  | Odd
198 | SAI5_RXD0////PDM_BIT0/////GPIO3_IO21/*/HPLOUT |  |  |  | Even
199 | SAI5_RXD1///SAI5_TXFS////PDM_BIT1/////GPIO3_IO22/*/LINEIN1_RP |  |  |  | Odd
200 | SAI5_RXD2///SAI5_TXC////PDM_BIT2/////GPIO3_IO23/*/HPROUT |  |  |  | Even

Sheet: VAR-SOM-MX8MP_V1.x
PIN# | Symbol pin name source | SOM Usage | Applicable Configuration | Note |  | xxx
1 | ENET_QOS_RGMII_TX_CTL//SAI6_MCLK///SPDIF1_OUT/////GPIO1_IO22//////USDHC3_DATA0/*/NC |  |  |  | Odd
2 | GND |  |  |  | Even
3 | ENET_QOS_RGMII_TD3//SAI6_TX_BCLK///PDM_BIT_STREAM2/////GPIO1_IO18//////USDHC3_DATA6/*/ETH0_MDI_A_P |  |  |  | Odd
4 | ENET_QOS_RGMII_RD0//SAI7_RX_DATA0///PDM_BIT_STREAM1/////GPIO1_IO26//////USDHC3_DATA4/*/ETH0_MDI_C_P |  |  |  | Even
5 | ENET_QOS_RGMII_TD2/ENET_QOS_INPUT=ENET_ QOS_TX_CLK OUTPUT=CCM_ENET_QOS_REF_CLK_ROOT//SAI6_RX_DATA0///PDM_BIT_STREAM1/////GPIO1_IO19//////USDHC3_DATA7/*/ETH0_MDI_A_M |  |  |  | Odd
6 | ENET_QOS_RGMII_RD1//SAI7_RX_SYNC///PDM_BIT_STREAM0/////GPIO1_IO27//////USDHC3_RESET_B/*/ETH0_MDI_C_M |  |  |  | Even
7 | GND |  |  |  | Odd
8 | GND |  |  |  | Even
9 | ENET_QOS_RGMII_TD1//SAI6_RX_SYNC///PDM_BIT_STREAM0/////GPIO1_IO20//////USDHC3_CD_B/*/ETH0_MDI_B_P |  |  |  | Odd
10 | ENET_QOS_RGMII_RD2//SAI7_RX_BCLK///PDM_CLK/////GPIO1_IO28//////USDHC3_CLK/*/ETH0_MDI_D_P |  |  |  | Even
11 | ENET_QOS_RGMII_TD0//SAI6_RX_BCLK///PDM_CLK/////GPIO1_IO21//////USDHC3_WP/*/ETH0_MDI_B_M |  |  |  | Odd
12 | ENET_QOS_RGMII_RD3//SAI7_MCLK///SPDIF1_IN/////GPIO1_IO29//////USDHC3_CMD/*/ETH0_MDI_D_M |  |  |  | Even
13 | GND |  |  |  | Odd
14 | GND |  |  |  | Even
15 | ENET_QOS_RGMII_RX_CTL//SAI7_TX_SYNC///PDM_BIT_STREAM3/////GPIO1_IO24//////USDHC3_DATA2/*/ETH0_LED_ACT |  |  |  | Odd
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
