faoziaziz/qioters/qiot.ods

Reference | Value | LCSC Part # | Manufacturer_Part_Number | Footprint | Qty | DNP | JLCPARTS | unit pricce | price SKU
C1,C28,C41,C54,C102 | 1uF | C29266 | CL05A105KO5NNNC | Capacitor_SMD:C_0402_1005Metric | 5 |  |  | 0.0023 | 0.0115
C2,C13,C16,C18,C23,C33,C34,C35,C93 | 4.7uF | C23733 | CL05A475MP5NRNC | Capacitor_SMD:C_0402_1005Metric | 9 |  |  | 0.005 | 0.045
C3,C5,C6,C10,C11,C12,C15,C17,C19,C20,C21,C24,C25,C27 | 220nF | C16772 | CL05B224KO5NNNC | Capacitor_SMD:C_0402_1005Metric | 14 |  |  | 0.0042 | 0.0588
C4,C7,C8,C9 | 12pF | C76948 | GRM1555C1H120JA01D | Capacitor_SMD:C_0402_1005Metric | 4 |  |  | 0.0027 | 0.0108
C14,C22,C26,C38,C100 | 22uF | C59461 | CL10A226MQ8NRNC | Capacitor_SMD:C_0603_1608Metric | 5 |  |  | 0.0089 | 0.0445
C29,C30,C31,C32,C37,C39,C40,C42,C55,C62,C63,C64,C66,C73,C81,C83,C90,C94,C95,C98,C103 | 100nF | C77020 | GRM155R71H104KE14D | Capacitor_SMD:C_0402_1005Metric | 21 |  |  | 0.0031 | 0.0651
C36,C52,C56,C58,C59,C65,C67,C71,C72,C74,C75,C77,C78,C79,C87,C88,C99,C101 | 10uF | C194427 | GRM188R6YA106MA73D | Capacitor_SMD:C_0603_1608Metric | 18 |  |  | 0.0417 | 0.7506
C43,C48,C50,C97 | 470nF | C437527 | GRM155R61H474KE11D | Capacitor_SMD:C_0402_1005Metric | 4 |  |  | 0.0288 | 0.1152
C44,C45,C46,C47,C49,C51,C96 | 10nF | C60133 | CC0402KRX7R9BB103 | Capacitor_SMD:C_0402_1005Metric | 7 |  |  | 0.001 | 0.007
C57 | 22nF | C77023 | GRM155R71H223KA12D | Capacitor_SMD:C_0402_1005Metric | 1 |  |  | 0.0028 | 0.0028
C61 | 4.7uF | C2858031 | GRM155R61E475ME15D | Capacitor_SMD:C_0402_1005Metric | 1 |  |  | 0.0368 | 0.0368
C68 | 22uF | C696800 | T491X226K050AT | footprints:CAP-SMD_L7.3-W4.3-R-RD | 1 |  |  | 1.8335 | 1.8335
C70,C86,C91 | 2.2uF | C385032 | GRM155R61E225KE11D | Capacitor_SMD:C_0402_1005Metric | 3 |  |  | 0.0158 | 0.0474
C76,C80,C89,C104 | 1nF | C696907 | TCC0402X7R102M500AT | Capacitor_SMD:C_0402_1005Metric | 4 |  |  | 0.0005 | 0.002
C82 | 47pF | C105622 | CC0603JRNPO9BN470 | Capacitor_SMD:C_0603_1608Metric | 1 |  |  | 0.0028 | 0.0028
C84,C85,C105 | 47uF | C140782 | GRM188R60J476ME15D | Capacitor_SMD:C_0603_1608Metric | 3 |  |  | 0.0541 | 0.1623
C92 | 47uF | C403725 | GRM31CR61E476ME44L | Capacitor_SMD:C_1206_3216Metric | 1 |  |  | 0.2821 | 0.2821
D1,D4,D5,D7 | 150040GS73240 | C6210741 | C6210741 | LED_SMD:LED_0402_1005Metric | 4 |  |  | 0.3351 | 1.3404
D2,D3 | PMEG3020EH | C167645 | PMEG3020EH | Diode_SMD:D_SOD-123F | 2 |  |  | 0.7434 | 1.4868
D6,D11,D12,D13,D14 | LED | C6210741 | IN-S42BT5UW | LED_SMD:LED_0402_1005Metric | 5 |  |  | 0.3351 | 1.6755
D8,D9,D10 | CUS05S40 | C2762696 | CUS05S40.H3F | Diode_SMD:D_SOD-323 | 3 |  |  | 0.0617 | 0.1851
J3,J26 | TYPE-C-31-M-12 | C165948 | TYPE-C-31-M-12 | footprints:HRO_TYPE-C-31-M-12 | 2 |  |  | 0.1746 | 0.3492
J4 | PJ-102AH | C3096093 | PJ-102AH | footprints:DC-IN-TH_PJ-102AH | 1 |  |  | 0.8121 | 0.8121
L1 | 4.7uH_2016 | C383380 | MLP2016H4R7MT0S1 | Inductor_SMD:L_Murata_DFE201610P | 1 |  |  | 0.0778 | 0.0778
L2 | 6.8uH | C41405888 | YSMC201610H-6R8MB | Inductor_SMD:L_Murata_DFE201610P | 1 |  |  | 0.0562 | 0.0562
L3 | 2.2uH | C41347750 | AFE201612S2R2MBT | Inductor_SMD:L_APV_APH0620 | 1 |  |  | 0.0357 | 0.0357
Q1,Q2,Q3,Q8 | PMBT2222A | C23869 | PMBT2222A,215 | Package_TO_SOT_SMD:SOT-23 | 4 |  |  | 0.0108 | 0.0432
Q4,Q5,Q9,Q10 | IRLZ44NSTRL(UMW) | C42370422 | IRLZ44NSTRL(UMW) | Package_TO_SOT_SMD:TO-263-2 | 4 |  |  | 0.3094 | 1.2376
Q6 | 2N7002 | C65189 | 2N7002,215 | Package_TO_SOT_SMD:SOT-23 | 1 |  |  | 0.0254 | 0.0254
Q7 | BSS223PW | C5197341 | BSS223PW-VB | Package_TO_SOT_SMD:SOT-323_SC-70 | 1 |  |  | 0.0274 | 0.0274
R1 | 2.2M | C2998080 | FRC0402F2204TS | Resistor_SMD:R_0402_1005Metric | 1 |  |  | 0.0007 | 0.0007
R3,R5,R6,R7,R18,R29,R33,R46,R50,R53,R84,R87,R92,R93,TH1,TH2,TH3,TH4 | 10K | C60490 | RC0402FR-0710KL | Resistor_SMD:R_0402_1005Metric | 18 |  |  | 0.0006 | 0.0108
R4,R80 | 30K | C138008 | RC0402FR-0730KL | Resistor_SMD:R_0402_1005Metric | 2 |  |  | 0.0007 | 0.0014
R8,R12,R15,R25,R37,R41,R42 | 1K | C11702 | 0402WGF1001TCE | Resistor_SMD:R_0402_1005Metric | 7 |  |  | 0.0006 | 0.0042
R9,R10,R85,R86 | 5.1K | C105872 | RC0402FR-075K1L | Resistor_SMD:R_0402_1005Metric | 4 |  |  | 0.0007 | 0.0028
R11 | 2.7K | C138017 | RC0402FR-072K7L | Resistor_SMD:R_0402_1005Metric | 1 |  |  | 0.0007 | 0.0007
R13,R16,R17,R38,R44,R48,R49 | 100K | C60491 | RC0402FR-07100KL | Resistor_SMD:R_0402_1005Metric | 7 |  |  | 0.0006 | 0.0042
R14 | 1.5k | C25867 | 0402WGF1501TCE | Resistor_SMD:R_0402_1005Metric | 1 |  |  | 0.0006 | 0.0006
R20,R21,R22,R27 | 49.9 | C25120 | 0402WGF499JTCE | Resistor_SMD:R_0402_1005Metric | 4 |  |  | 0.0006 | 0.0024
R24 | 2K | C4109 | 0402WGF2001TCE | Resistor_SMD:R_0402_1005Metric | 1 |  |  | 0.0006 | 0.0006
R26 | 402 | C137984 | RC0402FR-07402RL | Resistor_SMD:R_0402_1005Metric | 1 |  |  | 0.0007 | 0.0007
R28,R58 | 10 | C2906862 | FRC0402F10R0TS | Resistor_SMD:R_0402_1005Metric | 2 |  |  | 0.0005 | 0.001
R30,R32 | 100 | C106232 | RC0402FR-07100RL | Resistor_SMD:R_0402_1005Metric | 2 |  |  | 0.0007 | 0.0014
R31 | 0.05 | C473658 | CS02W8F500MTCE | Resistor_SMD:R_0402_1005Metric | 1 |  |  | 0.0377 | 0.0377
R34,R35,R36 | 150 | C138054 | RC0402FR-07150RL | Resistor_SMD:R_0402_1005Metric | 3 |  |  | 0.0007 | 0.0021
R39 | 365 | C453662 | RC-02K3650FT | Resistor_SMD:R_0402_1005Metric | 1 |  |  | 0.0006 | 0.0006
R40,R43,R56,R61 | 0 | C106231 | RC0402FR-070RL | Resistor_SMD:R_0402_1005Metric | 4 |  |  | 0.0006 | 0.0024
R45 | 2.2K | C114762 | RC0402FR-072K2L | Resistor_SMD:R_0402_1005Metric | 1 |  |  | 0.0007 | 0.0007
R47,R52,R65,R68,R74,R88 | 4.7K | C105871 | RC0402FR-074K7L | Resistor_SMD:R_0402_1005Metric | 6 |  |  | 0.0007 | 0.0042
R51 | 2.49 | C2085509 | CRCW04022R49FKED | Resistor_SMD:R_0402_1005Metric | 1 |  |  | 0.0115 | 0.0115
R54 | 63.4K | C2933107 | FRC0402F6342TS | Resistor_SMD:R_0402_1005Metric | 1 |  |  | 0.0005 | 0.0005
R57,R59 | 0.01 | C138067 | RC0402FR-0710ML | Resistor_SMD:R_0402_1005Metric | 2 |  |  | 0.0007 | 0.0014
R62 | 200K | C2907009 | FRC0603F2003TS | Resistor_SMD:R_0603_1608Metric | 1 |  |  | 0.001 | 0.001
R63 | 64K | C2902643 | ARG03DTC6402N | Resistor_SMD:R_0603_1608Metric | 1 |  |  | 0.0086 | 0.0086
R64 | 16K | C163487 | RC0402FR-0716KL | Resistor_SMD:R_0402_1005Metric | 1 |  |  | 0.0007 | 0.0007
R66 | 390K | C25782 | 0402WGF3903TCE | Resistor_SMD:R_0402_1005Metric | 1 |  |  | 0.0006 | 0.0006
R67,R77 | 75K | C137935 | RC0402FR-0775KL | Resistor_SMD:R_0402_1005Metric | 2 |  |  | 0.0007 | 0.0014
R69,R89 | 47K | C93943 | RC0402FR-0747KL | Resistor_SMD:R_0402_1005Metric | 2 |  |  | 0.0007 | 0.0014
R70,R90 | 15K | C25756 | 0402WGF1502TCE | Resistor_SMD:R_0402_1005Metric | 2 |  |  | 0.0006 | 0.0012
R71,R72,R78,R91 | 2.49K | C102924 | RTT022491FTH | Resistor_SMD:R_0402_1005Metric | 4 |  |  | 0.0006 | 0.0024
R73 | 20K | C25765 | 0402WGF2002TCE | Resistor_SMD:R_0402_1005Metric | 1 |  |  | 0.0006 | 0.0006
R75 | 1M | C138033 | RC0402FR-071ML | Resistor_SMD:R_0402_1005Metric | 1 |  |  | 0.0007 | 0.0007
R76,R79 | 50K | C861451 | RT0603BRD0750KL | Resistor_SMD:R_0603_1608Metric | 2 |  |  | 0.0197 | 0.0394
R81,R82 | 0.1 | C3013344 | FRL0402JR100TS | Resistor_SMD:R_0402_1005Metric | 2 |  |  | 0.0025 | 0.005
R83 | 1.5K | C25867 | 0402WGF1501TCE | Resistor_SMD:R_0402_1005Metric | 1 |  |  | 0.0006 | 0.0006
SW1 | SW_SPDT_312 | C466019 | DM1-16UC-1 | Button_Switch_THT:SW_XKB_DM1-16UC-1 | 1 |  |  | 0.1634 | 0.1634
SW2 | SW_Push_Dual | C470264 | SKHHNJA010 | footprints:SW-TH_SKHHNJA010 | 1 |  |  | 0.3837 | 0.3837
U1 | UM803RS | C620009 | UM803RS | Package_TO_SOT_SMD:SOT-23 | 1 |  |  | 0.1433 | 0.1433
U2 | MIMXRT1011DAE5A | C1575810 | MIMXRT1011DAE5A | footprints:MIMXRT1011DAE5A_NXP | 1 |  |  | 3.8478 | 3.8478
U3 | TS5A3159DBVR | C42411032 | TS5A3159DBVR-TP | Package_TO_SOT_SMD:SOT-23-6 | 1 |  |  | 0.1148 | 0.1148
U4 | W25Q128JVS | C97521 | W25Q128JVSIQ | footprints:SOIC127P790X216-8N | 1 |  |  | 1.1216 | 1.1216
U5 | MAX17320G20+T | C7457895 | MAX17320G20+T | footprints:21-0139I_T2444-4_MXM | 1 |  |  | 5.82 | 5.82
U6 | LTC4162EUFD | C3681528 | LTC4162EUFD | footprints:05-08-1712_ADI | 1 |  |  | 9.4875 | 9.4875
U7,U8,U10,U13 | TLV62130 | C122479 | TLV62130RGTR | footprints:RGT0016C | 4 |  |  | 0.4396 | 1.7584
U9 | MAX42402AFLB+ | C22392296 | MAX42402AFLB+ | footprints:MAX42402AFLB | 1 |  |  | 5.9424 | 5.9424
U11 | DRV8825 | C81582 | DRV8825PWPR | footprints:PWP28_5P18X3P1 | 1 |  |  | 1.0392 | 1.0392
U12 | FC41D | FC41D | FC41D | footprints:XCVR_FC41D | 1 |  |  | 3 | 3
U14 | PCA9539PW_118 | C2687996 | PCA9539PW,118 | footprints:SOP65P640X110-24N | 1 |  |  | 1.1267 | 1.1267
Y1 | 24MHz | C2965580 | XL7EL89CKI-111YLC-24M | footprints:OSC_XRCGB24M000F2P29R0 | 1 |  |  | 0.75 | 0.75
Y2 | 32.768KHz | C7528807 | XKXEL89CJI-SUAYLC-32.768K | footprints:CRYSTAL_FC-135 32.7680KA-AG3_EPS | 1 |  |  | 0.1765 | 0.1765
C53,C60 | 150uF | C413508 | EEEFK1H151P | Capacitor_SMD:CP_Elec_10x10.5 | 2 |  | EEEFK1H151P | 0.4541 | 0.9082
 |  |  |  |  |  |  |  |  | 46.7703
