faoziaziz/qioters/MYC-LR3576-PINList.xlsx

 |  | MYC-LR3576X PIN LIST |  |  |  |  |  | Version：V1.0 2024.10.15
LGA381 Pin Name | Net Name | CPU Ball | MUX1 | MUX2 | MUX3 | MUX4 | MUX5 | MUX6 | MUX7 | MUX8 | MUX9 | MUX10 | MUX11 | MUX12 | MUX13 | Power Rail | I/O | Default function | Comment
A61 | GMAC0_MDC_M0 | 1A7 | GPIO3_A6_d | VO_LCDC_D21 | VO_EBC_GDOE | ETH0_MDC_M0 | PDM1_SDI2_M2 | DSMC_DATA14 | FLEXBUS0_D6 |  |  | UART1_RX_M2 | UART10_CTSN_M0 |  | PWM1_CH2_M3 | 1.8V | O | GMAC0_MDC_M0
A60 | GMAC0_MDIO_M0 | A9 | GPIO3_A5_d | VO_LCDC_D22 | VO_EBC_GDSP | ETH0_MDIO_M0 | PDM1_SDI3_M2 | DSMC_DATA15 | FLEXBUS0_D7 |  |  | UART1_RTSN_M2 | SPI2_CSN1_M2 |  | PWM1_CH1_M3 | 1.8V | I/O | GMAC0_MDIO_M0
A16 | GMAC0_TXCLK_M0 | B11 | GPIO3_B6_d | VO_LCDC_D13 | VO_EBC_SDDO13 | ETH0_TXCLK_M0 |  | DSMC_DQS1 | FLEXBUS0_CLK |  |  |  | SPI3_CSN0_M1 |  | PWM0_CH1_M3 | 1.8V | O | GMAC0_TXCLK_M0
A59 | GMAC0_TXCTL_M0 | A11 | GPIO3_B3_d | VO_LCDC_D16 | VO_EBC_SDCE0 | ETH0_TXCTL_M0 | PDM1_SDI0_M2 | DSMC_DATA10 | FLEXBUS0_D2 |  |  |  | UART9_TX_M1 | I2C8_SCL_M3 |  | 1.8V | O | GMAC0_TXCTL_M0
A39 | GMAC0_TXD0_M0 | 1A9 | GPIO3_B5_d | VO_LCDC_D14 | VO_EBC_SDDO14 | ETH0_TXD0_M0 | SPDIF_TX1_M0 | DSMC_DATA8 | FLEXBUS0_D0 |  |  |  | UART9_CTSN_M1 |  | PWM1_CH5_M3 | 1.8V | O | GMAC0_TXD0_M0
A17 | GMAC0_TXD1_M0 | B10 | GPIO3_B4_d | VO_LCDC_D15 | VO_EBC_SDDO15 | ETH0_TXD1_M0 | SPDIF_RX1_M0 | DSMC_DATA9 | FLEXBUS0_D1 |  |  |  | UART9_RTSN_M1 |  | PWM1_CH4_M3 | 1.8V | O | GMAC0_TXD1_M0
A40 | GMAC0_TXD2_M0 | 1A8 | GPIO3_C3_d | VO_LCDC_D8 | VO_EBC_SDDO8 | ETH0_TXD2_M0 | SAI2_LRCK_M2 | DSMC_INT3 | FLEXBUS0_D10 | FLEXBUS0_CSN_M2 |  | UART11_CTSN_M0 | SPI4_MOSI_M1 | I2C9_SDA_M3 | PWM2_CH1_M3 | 1.8V | O | GMAC0_TXD2_M0
A18 | GMAC0_TXD3_M0 | B9 | GPIO3_C2_d | VO_LCDC_D9 | VO_EBC_SDDO9 | ETH0_TXD3_M0 | SAI2_SCLK_M2 | DSMC_INT1 | FLEXBUS0_D9 |  |  | UART11_RTSN_M0 | SPI4_MISO_M1 | I2C9_SCL_M3 | PWM2_CH0_M3 | 1.8V | O | GMAC0_TXD3_M0
A13 | GMAC0_RXCLK_M0 | 1A12 | GPIO3_D1_d | VO_LCDC_D2 | VO_EBC_SDDO2 | ETH0_RXCLK_M0 | SAI2_MCLK_M2 | DSMC_CSN2 | FLEXBUS0_D11 | FLEXBUS1_CSN_M2 |  |  | SPI4_CLK_M1 | I3C1_SDA_PU_M2 |  | 1.8V | I | GMAC0_RXCLK_M0
A38 | GMAC0_RXCTL_M0 | B13 | GPIO3_A7_d | VO_LCDC_D20 | VO_EBC_VCOM | ETH0_RXCTL_M0 | PDM1_CLK1_M2 | DSMC_DATA13 | FLEXBUS0_D5 |  |  | UART1_TX_M2 | UART10_RTSN_M0 |  |  | 1.8V | I | GMAC0_RXCTL_M0
A36 | GMAC0_RXD0_M0 | A13 | GPIO3_B2_d | VO_LCDC_D17 | VO_EBC_SDCE1 | ETH0_RXD0_M0 | PDM1_SDI1_M2 | DSMC_DATA11 | FLEXBUS0_D3 | UART9_RX_M1 |  |  | I2C8_SDA_M3 |  |  | 1.8V | I | GMAC0_RXD0_M0
A14 | GMAC0_RXD1_M0 | 1A11 | GPIO3_B1_d | VO_LCDC_D18 | VO_EBC_SDCE2 | ETH0_RXD1_M0 | PDM1_CLK0_M2 | DSMC_DATA12 | FLEXBUS0_D4 |  |  | UART10_TX_M0 | SPI4_CSN0_M1 |  | PWM1_CH3_M3 | 1.8V | I | GMAC0_RXD1_M0
A37 | GMAC0_RXD2_M0 | B12 | GPIO3_D3_d | VO_LCDC_D0 | VO_EBC_SDDO0 | ETH0_RXD2_M0 | SAI2_SDO_M2 | DSMC_CSN0 | FLEXBUS1_D2 |  |  | UART2_CTSN_M2 |  | I3C1_SCL_M2 | PWM2_CH5_M3 | 1.8V | I | GMAC0_RXD2_M0
A15 | GMAC0_RXD3_M0 | 1A10 | GPIO3_D2_d | VO_LCDC_D1 | VO_EBC_SDDO1 | ETH0_RXD3_M0 | SAI2_SDI_M2 | DSMC_CSN3 | FLEXBUS0_D12 | FLEXBUS1_D15_M0 | FLEXBUS0_CSN_M3 | UART2_RTSN_M2 | SPI4_CSN1_M1 | I3C1_SDA_M2 | PWM2_CH4_M3 | 1.8V | I | GMAC0_RXD3_M0
A54 | GMAC1_MDC_M0 | 1B13 | GPIO2_D4_d | ISP_PRELIGHT_TRIG_M0 | ETH1_MDC_M0 |  |  |  |  |  | UART6_RTSN_M1 |  | I2C9_SDA_M2 |  | PWM2_CH4_M2 | 1.8V | O | GMAC1_MDC_M0
A53 | GMAC1_MDIO_M0 | 1B15 | GPIO2_D5_d | ISP_FLASH_TRIGOUT_M0 | ETH1_MDIO_M0 |  |  |  |  |  | UART6_CTSN_M1 |  | I2C9_SCL_M2 |  | PWM2_CH5_M2 | 1.8V | I/O | GMAC1_MDIO_M0
A9 | GMAC1_TXCLK_M0 | 1C15 | GPIO2_C5_d | VI_CIF_D0 | ETH1_TXCLK_M0 |  | SAI2_SDI_M1 | PDM1_CLK0_M0 |  |  | UART11_RX_M1 | SPI1_CLK_M1 |  |  | PWM1_CH4_M2 | 1.8V | O | GMAC1_TXCLK_M0
A52 | GMAC1_TXCTL_M0 | B16 | GPIO2_D0_d |  | ETH1_TXCTL_M0 |  | SAI4_SDI_M3 |  |  |  | UART4_TX_M0 |  | I2C6_SCL_M2 |  | PWM2_CH0_M2 | 1.8V | O | GMAC1_TXCTL_M0
A32 | GMAC1_TXD0_M0 | 1A14 | GPIO2_C6_d |  | ETH1_TXD0_M0 |  | SAI4_SCLK_M3 |  |  |  | UART4_CTSN_M0 |  | I2C5_SCL_M2 |  | PWM1_CH5_M2 | 1.8V | O | GMAC1_TXD0_M0
A10 | GMAC1_TXD1_M0 | B15 | GPIO2_C7_d |  | ETH1_TXD1_M0 |  | SAI4_LRCK_M3 |  |  |  | UART4_RTSN_M0 |  | I2C5_SDA_M2 |  | PWM0_CH1_M2 | 1.8V | O | GMAC1_TXD1_M0
A33 | GMAC1_TXD2_M0 | A15 | GPIO2_C3_d | VI_CIF_D2 | ETH1_TXD2_M0 |  | SAI2_LRCK_M1 | PDM1_SDI3_M0 |  |  | UART11_RTSN_M1 | SPI1_MISO_M1 |  |  | PWM0_CH0_M2 | 1.8V | O | GMAC1_TXD2_M0
A11 | GMAC1_TXD3_M0 | 1A13 | GPIO2_C4_d | VI_CIF_D1 | ETH1_TXD3_M0 |  | SAI2_SDO_M1 | PDM1_SDI0_M0 |  |  | UART11_TX_M1 | SPI1_CSN0_M1 |  |  | PWM1_CH3_M2 | 1.8V | O | GMAC1_TXD3_M0
A6 | GMAC1_RXCLK_M0 | 1D15 | GPIO2_C2_d | VI_CIF_D3 | ETH1_RXCLK_M0 | ETH0_PPSTRIG_M1 | SAI2_SCLK_M1 | PDM1_SDI2_M0 |  |  | UART11_CTSN_M1 | SPI1_MOSI_M1 |  |  | PWM1_CH2_M2 | 1.8V | I | GMAC1_RXCLK_M0
A31 | GMAC1_RXCTL_M0 | B18 | GPIO2_D3_d |  | ETH1_RXCTL_M0 |  |  |  |  |  | UART6_RX_M1 |  |  | I3C1_SDA_M0 | PWM2_CH3_M2 | 1.8V | I | GMAC1_RXCTL_M0
A29 | GMAC1_RXD0_M0 | 1A16 | GPIO2_D1_d |  | ETH1_RXD0_M0 |  | SAI4_SDO_M3 |  |  |  | UART4_RX_M0 |  | I2C6_SDA_M2 |  | PWM2_CH1_M2 | 1.8V | I | GMAC1_RXD0_M0
A7 | GMAC1_RXD1_M0 | B17 | GPIO2_D2_d | CAM_CLK0_OUT_M1 | ETH1_RXD1_M0 |  | SAI4_MCLK_M3 |  |  |  | UART6_TX_M1 |  |  | I3C1_SCL_M0 | PWM2_CH2_M2 | 1.8V | I | GMAC1_RXD1_M0
A30 | GMAC1_RXD2_M0 | A17 | GPIO2_C0_d | VI_CIF_D5 | ETH1_RXD2_M0 | ETH0_PTP_REFCLK_M1 |  | PDM1_SDI1_M0 |  |  | UART9_RX_M0 |  |  |  | PWM1_CH0_M2 | 1.8V | I | GMAC1_RXD2_M0
A8 | GMAC1_RXD3_M0 | 1A15 | GPIO2_C1_d | VI_CIF_D4 | ETH1_RXD3_M0 | ETH0_PPSCLK_M1 | SAI2_MCLK_M1 | PDM1_CLK1_M0 |  |  | UART9_TX_M0 | SPI1_CSN1_M1 |  |  | PWM1_CH1_M2 | 1.8V | I | GMAC1_RXD3_M0
A43 | SAI1_MCLK_M0 | 1D6 | GPIO4_A2_d | SAI1_MCLK_M0 | SAI4_MCLK_M0 | AUPLL_CLK_IN_M2 |  |  |  |  |  |  |  |  | PWM2_CH5_M0 | 3.3V | O | SAI1_MCLK_M0
A44 | SAI1_SCLK_M0 | 1C6 | GPIO4_A3_d | SAI1_SCLK_M0 |  |  | FLEXBUS1_CSN_M4 |  |  |  | SPI3_CSN0_M2 | UART5_RTSN_M1 | I2C2_SCL_M2 |  | PWM2_CH4_M1 | 3.3V | O | SAI1_SCLK_M0
A22 | SAI1_LRCK_M0 | 1B6 | GPIO4_A5_d | SAI1_LRCK_M0 |  |  | FLEXBUS1_D12_M1 |  |  |  | SPI4_CSN1_M2 | UART5_CTSN_M1 | I2C2_SDA_M2 | PCIE1_CLKREQN_M2 |  | 3.3V | O | SAI1_LRCK_M0
A23 | SAI1_SDI0_M0 | 1A6 | GPIO4_B3_d | SAI1_SDI0_M0 | SAI4_SDO_M0 | PDM1_SDI0_M1 |  |  |  |  | SPI4_CSN0_M2 | SPI3_CSN1_M2 |  |  | PWM2_CH7_M0 | 3.3V | I | SAI1_SDI0_M0
A21 | SAI1_SDO0_M0 | A7 | GPIO4_A7_d | SAI1_SDO0_M0 | SAI4_SDI_M0 |  |  |  |  |  | SPI3_CLK_M2 |  |  |  | PWM2_CH6_M0 | 3.3V | O | SAI1_SDO0_M0
A57 | SAI2_SCLK_M0 | 1D22 | GPIO1_D1_d | ETH1_RXCTL_M1 |  |  | SAI2_SCLK_M0 |  |  |  | UART10_RX_M1 | I3C0_SDA_PU_M1 |  |  |  | 1.8V | O | SAI2_SCLK_M0
A73 | SAI2_LRCK_M0 | 1A24 | GPIO1_D2_d | ETH1_MDC_M1 |  |  | SAI2_LRCK_M0 |  |  |  |  | I3C0_SCL_M1 |  |  | PWM1_CH3_M1 | 1.8V | O | SAI2_LRCK_M0
A74 | SAI2_SDI_M0 | C28 | GPIO1_D3_d | ETH1_MDIO_M1 |  |  | SAI2_SDI_M0 |  |  |  |  | I3C0_SDA_M1 |  |  | PWM1_CH4_M1 | 1.8V | I | SAI2_SDI_M0
A56 | SAI2_SDO_M0 | C29 | GPIO1_D0_d | ETH1_RXD1_M1 |  |  | SAI2_SDO_M0 |  |  |  | UART10_TX_M1 |  |  |  |  | 1.8V | O | SAI2_SDO_M0
A71 | SDMMC0_CMD | 1A21 | GPIO2_A4_d | SDMMC0_CMD | FSPI1_CSN0_M0 |  | SAI3_SDO_M3 |  |  | UART5_RX_M2 |  | I2C5_SDA_M0 | SPI0_CSN0_M1 |  | PWM2_CH4_M0 | 3.3V | I/O | SDMMC0_CMD
A86 | SDMMC0_CLK | 1B21 | GPIO2_A5_d | SDMMC0_CLK | FSPI1_CLK_M0 |  | SAI3_SCLK_M3 | TEST_CLK_OUT |  | UART5_TX_M2 |  | I2C5_SCL_M0 | SPI0_CLK_M1 |  | I3C1_SDA_PU_M1 | 3.3V | O | SDMMC0_CLK
A69 | SDMMC0_D0 | B24 | GPIO2_A0_d | SDMMC0_D0 | FSPI1_D0_M0 | DSM_AUD_LP_M0 |  |  |  | UART0_RX_M1 | UART7_RX_M2 | I2C8_SCL_M0 | SPI0_MOSI_M1 | CAN0_RX_M0 | PWM2_CH2_M0 | 3.3V | I/O | SDMMC0_D0
A84 | SDMMC0_D1 | B25 | GPIO2_A1_d | SDMMC0_D1 | FSPI1_D1_M0 | DSM_AUD_LN_M0 | SAI3_MCLK_M3 |  |  | UART0_TX_M1 | UART7_TX_M2 | I2C8_SDA_M0 | SPI0_MISO_M1 | CAN0_TX_M0 | PWM2_CH3_M0 | 3.3V | I/O | SDMMC0_D1
A70 | SDMMC0_D2 | A23 | GPIO2_A2_d | SDMMC0_D2 | FSPI1_D2_M0 | DSM_AUD_RP_M0 | SAI3_LRCK_M3 |  |  | JTAG_TCK_M0 | UART5_RTSN_M2 |  | SPI0_CSN1_M1 | CAN1_RX_M0 | I3C1_SCL_M1 | 3.3V | I/O | SDMMC0_D2
A85 | SDMMC0_D3 | B23 | GPIO2_A3_d | SDMMC0_D3 | FSPI1_D3_M0 | DSM_AUD_RN_M0 | SAI3_SDI_M3 |  |  | JTAG_TMS_M0 | UART5_CTSN_M2 |  |  | CAN1_TX_M0 | I3C1_SDA_M1 | 3.3V | I/O | SDMMC0_D3
A68 | SDMMC0_DET_L | 1U21 | GPIO0_A7_u | SDMMC0_DETN |  |  |  |  |  |  |  |  | SPI2_CSN1_M0 |  |  | 1.8V | I | SDMMC0_DET_L | Internal pull up 100K to 1.8V
A83 | SDMMC0_PWREN_H | 1Y24 | GPIO0_B6_d | SDMMC0_PWREN | SDMMC1_DETN_M2 |  |  |  |  |  |  | HDMI_TX_HPDIN_M1 | EDP_TX_HPDIN_M1 |  | PWM1_CH2_M0 | 3.3V | O | SDMMC0_PWREN_H
A81 | SDMMC1_CMD_M0 | B26 | GPIO1_C0_d | ETH1_TXD3_M1 | SDMMC1_CMD_M0 |  |  | PDM0_SDI2_M2 |  |  | UART3_TX_M2 |  | SPI1_CSN1_M0 |  | PWM0_CH0_M1 | 1.8V | I/O | SDMMC1_CMD_M0
A48 | SDMMC1_CLK_M0 | 1B22 | GPIO1_C1_d | ETH1_TXCLK_M1 | SDMMC1_CLK_M0 |  | SAI3_MCLK_M1 | PDM0_CLK0_M2 |  |  | UART3_RX_M2 |  |  |  |  | 1.8V | O | SDMMC1_CLK_M0
A46 | SDMMC1_D0_M0 | A28 | GPIO1_B4_d | ETH1_RXD2_M1 | SDMMC1_D0_M0 |  | SAI3_SCLK_M1 |  |  |  |  | I2C9_SDA_M1 | SPI1_CLK_M0 | PCIE1_CLKREQN_M1 | PWM1_CH0_M1 | 1.8V | I/O | SDMMC1_D0_M0
A47 | SDMMC1_D1_M0 | B27 | GPIO1_B5_d | ETH1_RXD3_M1 | SDMMC1_D1_M0 |  | SAI3_LRCK_M1 |  |  |  |  | I2C9_SCL_M1 | SPI1_MOSI_M0 |  | PWM1_CH1_M1 | 1.8V | I/O | SDMMC1_D1_M0
A65 | SDMMC1_D2_M0 | 1A23 | GPIO1_B6_d | ETH1_RXCLK_M1 | SDMMC1_D2_M0 |  | SAI3_SDO_M1 |  |  |  | UART3_CTSN_M2 |  | SPI1_MISO_M0 | PCIE0_CLKREQN_M1 |  | 1.8V | I/O | SDMMC1_D2_M0
A66 | SDMMC1_D3_M0 | A27 | GPIO1_B7_d | ETH1_TXD2_M1 | SDMMC1_D3_M0 |  | SAI3_SDI_M1 |  |  |  | UART3_RTSN_M2 |  | SPI1_CSN0_M0 |  |  | 1.8V | I/O | SDMMC1_D3_M0
A92 | UART0_TX_M0_DEBUG | 1U24 | GPIO0_D4_u |  |  |  |  |  |  |  |  | UART0_TX_M0 | JTAG_TCK_M1 |  |  | 3.3V | O | UART0_TX_M0_DEBUG | The default debugging serial port cannot be modified
A93 | UART0_RX_M0_DEBUG | AA28 | GPIO0_D5_u |  |  |  |  |  |  |  |  | UART0_RX_M0 | JTAG_TMS_M1 |  |  | 3.3V | I | UART0_RX_M0_DEBUG
A77 | UART4_TX_M1 | 1B23 | GPIO1_C4_d | ETH1_TXD0_M1 |  | FSPI1_D0_M1 |  |  |  |  |  | UART4_TX_M1 | UART2_RTSN_M0 | SPI2_MOSI_M1 | PCIE0_BUTTONRSTN | 1.8V | O | UART4_TX_M1
A78 | UART4_RX_M1 | B28 | GPIO1_C5_d | ETH1_TXD1_M1 |  | FSPI1_D1_M1 |  |  |  |  |  | UART4_RX_M1 | UART2_CTSN_M0 | SPI2_MISO_M1 | PCIE1_BUTTONRSTN | 1.8V | I | UART4_RX_M1
A76 | UART4_CTSN_M1 | 1C23 | GPIO1_C3_u | ETH1_PPSTRIG_M1 | SDMMC1_DETN_M0 | FSPI1_CSN0_M1 |  |  |  |  | UART4_CTSN_M1 | I2C6_SDA_M1 | SPI2_CSN0_M1 |  |  | 1.8V | I | UART4_CTSN_M1
A75 | UART4_RTSN_M1 | B29 | GPIO1_C2_u | ETH1_PPSCLK_M1 | SDMMC1_PWREN_M0 | FSPI1_CSN1_M1 |  |  |  |  | UART4_RTSN_M1 | I2C6_SCL_M1 | SPI2_CSN1_M1 |  | PWM1_CH2_M1 | 1.8V | O | UART4_RTSN_M1
A90 | UART5_TX_M1 | 1A5 | GPIO4_B0_d | SAI1_SDO1_M0 | SAI1_SDI3_M0 | PDM1_CLK1_M1 | FLEXBUS1_D13_M1 |  |  |  | SPI4_CLK_M2 | UART5_TX_M1 | UART6_RTSN_M0 | UART2_RTSN_M1 |  | 3.3V | O | UART5_TX_M1
A91 | UART5_RX_M1 | B7 | GPIO4_B1_d | SAI1_SDO2_M0 | SAI1_SDI2_M0 | PDM1_SDI2_M1 | FLEXBUS1_D14_M1 |  |  |  | SPI4_MOSI_M2 | UART5_RX_M1 | UART6_CTSN_M0 | UART2_CTSN_M1 |  | 3.3V | I | UART5_RX_M1
A88 | UART8_TX_M1 | B22 | GPIO2_A6_d | VI_CIF_D15 | SDMMC1_D0_M1 | ETH0_RXD0_M1 | SAI0_SDO0_M0 |  |  |  | UART8_TX_M1 | SPI4_CSN1_M3 | I2C4_SCL_M2 |  |  | 1.8V | O | UART8_TX_M1
A89 | UART8_RX_M1 | B20 | GPIO2_A7_d | VI_CIF_D14 | SDMMC1_D1_M1 | ETH0_TXCTL_M1 | SAI0_SDO1_M0 |  |  |  | UART8_RX_M1 |  | I2C4_SDA_M2 |  |  | 1.8V | I | UART8_RX_M1
A62 | CAN0_TX_M2 | 1C5 | GPIO4_A4_d |  | SAI4_SCLK_M0 | PDM1_SDI3_M1 | FLEXBUS0_D13_M1 |  |  |  | SPI3_MOSI_M2 | UART6_TX_M0 | I2C4_SCL_M1 |  | CAN0_TX_M2 | 3.3V | O | CAN0_TX_M2
A63 | CAN0_RX_M2 | 1B5 | GPIO4_A6_d |  | SAI4_LRCK_M0 | PDM1_CLK0_M1 | FLEXBUS0_D14_M1 |  |  |  | SPI3_MISO_M2 | UART6_RX_M0 | I2C4_SDA_M1 |  | CAN0_RX_M2 | 3.3V | I | CAN0_RX_M2
A79 | CAN1_TX_M2 | 1A4 | GPIO4_B5_d | SPDIF_TX0_M0 |  |  | FLEXBUS0_D15_M1 |  |  |  |  | UART2_TX_M1 | I2C3_SCL_M0 | PCIE0_CLKREQN_M2 | CAN1_TX_M2 | 3.3V | O | CAN1_TX_M2
A80 | CAN1_RX_M2 | B8 | GPIO4_B4_d | SPDIF_RX0_M0 |  |  | FLEXBUS0_CSN_M4 |  |  |  |  | UART2_RX_M1 | I2C3_SDA_M0 |  | CAN1_RX_M2 | 3.3V | I | CAN1_RX_M2
A1 | SARADC_VIN0_BOOT | A25 | SARADC_IN0_BOOT |  |  |  |  |  |  |  |  |  |  |  |  | 1.8V | AI | SARADC_VIN0_BOOT | Configure the boot mode pin. The default boot sequence of the core board is SDMMC0->EMMC->USB
A24 | SARADC_VIN1_KEY/RECOVERY | 1A22 | SARADC_IN1 |  |  |  |  |  |  |  |  |  |  |  |  | 1.8V | AI | SARADC_VIN1_KEY/RECOVERY | 1.Internal pull up 10K to 1.8V 2.It is recommended to reserve a key or test point for the signal used to burn the mirror
A2 | SARADC_VIN2 | 1B19 | SARADC_IN2 |  |  |  |  |  |  |  |  |  |  |  |  | 1.8V | AI | SARADC_VIN2
A25 | SARADC_VIN3 | 1C19 | SARADC_IN3 |  |  |  |  |  |  |  |  |  |  |  |  | 1.8V | AI | SARADC_VIN3
A3 | SARADC_VIN4 | 1E18 | SARADC_IN4 |  |  |  |  |  |  |  |  |  |  |  |  | 1.8V | AI | SARADC_VIN4
A26 | SARADC_VIN5 | 1D19 | SARADC_IN5 |  |  |  |  |  |  |  |  |  |  |  |  | 1.8V | AI | SARADC_VIN5
A4 | SARADC_VIN6 | 1D21 | SARADC_IN6 |  |  |  |  |  |  |  |  |  |  |  |  | 1.8V | AI | SARADC_VIN6
A27 | SARADC_VIN7 | 1E19 | SARADC_IN7 |  |  |  |  |  |  |  |  |  |  |  |  | 1.8V | AI | SARADC_VIN7
A5 | GND
A12 | GND
A19 | GND
A20 | GND
A28 | GND
A34 | GND
A35 | GND
A41 | GND
A42 | GND
A45 | GND
A49 | GND
A50 | GND
A51 | GND
B31 | UART1_TX_M1 | B19 | GPIO2_B0_d | VI_CIF_D13 | SDMMC1_D2_M1 | ETH0_TXD1_M1 | SAI0_SDI0_M0 | PDM0_SDI3_M3 |  |  | UART1_TX_M1 |  |  |  |  | 1.8V | O | UART1_TX_M1
B30 | UART1_RX_M1 | 1A18 | GPIO2_B1_d | VI_CIF_D12 | SDMMC1_D3_M1 | ETH0_TXD0_M1 | SAI0_SDI1_M0 | PDM0_SDI2_M3 |  |  | UART1_RX_M1 |  |  |  |  | 1.8V | I | UART1_RX_M1
B33 | UART3_TX_M0 | 1D16 | GPIO3_A0_d | VI_CIF_HREF |  | ETH0_MDIO_M1 | SAI3_SCLK_M2 |  |  |  | UART3_TX_M0 | SPI3_CLK_M0 | I2C7_SCL_M1 |  |  | 1.8V | O | UART3_TX_M0
B32 | UART3_RX_M0 | 1B18 | GPIO3_A1_d | VI_CIF_VSYNC | ETH1_PPSTRIG_M0 | ETH0_MDC_M1 | SAI3_LRCK_M2 |  |  |  | UART3_RX_M0 | SPI3_MOSI_M0 | I2C7_SDA_M1 |  |  | 1.8V | I | UART3_RX_M0
B79 | I2C2_SCL_M0 | 1W24 | GPIO0_B7_d |  |  |  |  |  |  |  |  | I2C2_SCL_M0 | UART1_TX_M0 | NPU_AVS | PWM1_CH4_M0 | 3.3V | O | I2C2_SCL_M0
B78 | I2C2_SDA_M0 | AB29 | GPIO0_C0_d |  |  |  |  |  |  |  |  | I2C2_SDA_M0 | UART1_RX_M0 | CPULIT_AVS | PWM1_CH3_M0 | 3.3V | I/O | I2C2_SDA_M0
B58 | I2C4_SCL_M3 | 1E9 | GPIO3_C0_d | VO_LCDC_D11 | VO_EBC_SDDO11 | ETH0_PPSCLK_M0 | SAI1_SDO3_M1 | DSMC_DATA7 | FLEXBUS1_D9 |  |  | UART2_TX_M2 | UART3_RTSN_M1 | I2C4_SCL_M3 |  | 1.8V | O | I2C4_SCL_M3
B59 | I2C4_SDA_M3 | 1D12 | GPIO3_B7_d | VO_LCDC_D12 | VO_EBC_SDDO12 | ETH0_PPSTRIG_M0 | SAI1_SDI0_M1 | DSMC_DQS0 | FLEXBUS1_D10 |  | FLEXBUS1_CSN_M0 | UART2_RX_M2 | UART3_CTSN_M1 | I2C4_SDA_M3 |  | 1.8V | I/O | I2C4_SDA_M3
B60 | I2C5_SCL_M3 | 1D9 | GPIO3_C4_d | VO_LCDC_D7 | VO_EBC_SDDO7 |  | SAI1_SDO1_M1 | DSMC_DATA5 | FLEXBUS1_D7 |  |  | UART11_TX_M0 | SPI2_CSN0_M2 | I2C5_SCL_M3 | CAN0_TX_M3 | 1.8V | O | I2C5_SCL_M3
B61 | I2C5_SDA_M3 | 1B10 | GPIO3_C1_d | VO_LCDC_D10 | VO_EBC_SDDO10 | ETH0_PTP_REFCLK_M0 | SAI1_SDO2_M1 | DSMC_DATA6 | FLEXBUS1_D8 |  |  | UART11_RX_M0 | SPI2_MISO_M2 | I2C5_SDA_M3 | CAN0_RX_M3 | 1.8V | I/O | I2C5_SDA_M3
B71 | I2C8_SCL_M2 | A21 | GPIO2_B6_d | VI_CIF_D7 | ETH1_PTP_REFCLK_M1 | ETH0_RXD3_M1 | SAI0_SCLK_M0 |  |  |  |  | UART7_TX_M0 | UART8_RTSN_M1 | I2C8_SCL_M2 |  | 1.8V | O | I2C8_SCL_M2
B72 | I2C8_SDA_M2 | B21 | GPIO2_B7_d | VI_CIF_D6 |  | ETH0_RXD2_M1 | SAI0_LRCK_M0 |  |  |  |  | UART7_RX_M0 | UART8_CTSN_M1 | I2C8_SDA_M2 |  | 1.8V | I/O | I2C8_SDA_M2
B38 | PWM0_CH0_M0 | 1W22 | GPIO0_C4_d | SAI0_MCLK_M1 |  | PDM0_CLK0_M0 |  |  |  |  |  |  | UART10_TX_M2 |  | PWM0_CH0_M0 | 3.3V | I | PWM0_CH0_M0
B35 | PWM0_CH1_M0 | 1W21 | GPIO0_C3_d |  |  | PDM0_CLK1_M0 |  |  |  |  |  | HDMI_TX_CEC_M1 |  | SPI0_CSN1_M0 | PWM0_CH1_M0 | 3.3V | O | PWM0_CH1_M0
B54 | PWM1_CH0_M0 | AD28 | GPIO0_B4_d | REF_CLK1_OUT |  |  |  |  |  |  |  | I2C1_SCL_M1 | UART4_TX_M2 |  | PWM1_CH0_M0 | 3.3V | O | PWM1_CH0_M0
B36 | PWM1_CH1_M0 | AD29 | GPIO0_B5_d | REF_CLK2_OUT |  |  |  |  |  |  |  | I2C1_SDA_M1 | UART4_RX_M2 |  | PWM1_CH1_M0 | 3.3V | O | PWM1_CH1_M0
B69 | GPIO0_A0_d | V29 | GPIO0_A0_d | REF_CLK0_OUT |  | AUPLL_CLK_IN_M0 |  |  |  |  |  |  |  |  |  | 1.8V | I/O | GPIO0_A0_D
B20 | GPIO0_A2_d | 1U23 | GPIO0_A2_d |  |  |  |  |  |  |  |  | CLK_32K_IN | CLK0_32K_OUT | I2C6_SCL_M0 |  | 1.8V | I/O | GPIO0_A2_D
B67 | GPIO0_A5_d | Y29 | GPIO0_A5_d |  |  |  |  |  |  |  |  | PWR_CTRL3 |  | I2C6_SDA_M0 |  | 1.8V | I/O | GPIO0_A5_D
B17 | GPIO0_B0_z | 1U22 | GPIO0_B0_z |  |  | AUPLL_CLK_IN_M1 |  |  |  |  |  | SPI2_CSN0_M0 |  | I2C0_SCL_M0 |  | 1.8V | I/O | GPIO0_B0_Z
B16 | GPIO0_B1_z | 1P23 | GPIO0_B1_z |  |  |  |  |  |  |  |  | SPI2_MISO_M0 |  | I2C0_SDA_M0 |  | 1.8V | I/O | GPIO0_B1_Z
B21 | GPIO0_C5_d | 1AA22 | GPIO0_C5_d | SAI0_SDO0_M1 |  |  |  |  |  |  |  | DP_HPDIN_M1 | UART10_RX_M2 | I3C0_SDA_PU_M0 |  | 3.3V | I/O | GPIO0_C5_D
B70 | GPIO0_D2_d | 1Y22 | GPIO0_D2_d | SAI0_SDI2_M1 | SAI0_SDO2_M1 | PDM0_SDI2_M0 |  |  |  |  | I2C4_SCL_M0 |  | CPUBIG_AVS | PWM1_CH5_M0 | UART1_CTSN_M0 | 3.3V | I/O | GPIO0_D2_D
B41 | GPIO0_D3_d | 1AA23 | GPIO0_D3_d | SAI0_SDI3_M1 | SAI0_SDO1_M1 | PDM0_SDI3_M0 |  |  |  |  | I2C4_SDA_M0 |  | GPU_AVS | PWM2_CH0_M0 | UART1_RTSN_M0 | 3.3V | I/O | GPIO0_D3_D
B64 | GPIO1_C6_d | A26 | GPIO1_C6_d | ETH1_TXCTL_M1 |  | FSPI1_D2_M1 |  | PDM0_SDI0_M2 |  |  | UART2_TX_M0 | I2C8_SCL_M1 |  | SATA_CPPOD |  | 1.8V | I/O | GPIO1_C6_D
B63 | GPIO1_C7_d | 1C22 | GPIO1_C7_d | ETH1_RXD0_M1 |  | FSPI1_D3_M1 |  | PDM0_SDI1_M2 |  |  | UART2_RX_M0 | I2C8_SDA_M1 |  | SATA_CPDET |  | 1.8V | I/O | GPIO1_C7_D
B48 | GPIO1_D4_d | 1E21 | GPIO1_D4_d | ETH1_MCLK_M1 |  |  | SAI2_MCLK_M0 | PDM0_SDI3_M2 | SPDIF_RX1_M2 |  | UART10_RTSN_M1 | I2C5_SCL_M1 |  |  |  | 1.8V | I/O | GPIO1_D4_D
B50 | GPIO1_D5_d | 1E22 | GPIO1_D5_d | ETH_CLK1_25M_OUT_M1 |  | FSPI1_CLK_M1 |  | PDM0_CLK1_M2 | SPDIF_TX1_M2 |  | UART10_CTSN_M1 | I2C5_SDA_M1 | SPI2_CLK_M1 | SATA_MPSWIT | CLK1_32K_OUT | 1.8V | I/O | GPIO1_D5_D
B62 | GPIO2_B2_d | 1A17 | GPIO2_B2_d | VI_CIF_D11 | SDMMC1_CMD_M1 | ETH0_TXD3_M1 | SAI0_SDI2_M0 | PDM0_SDI1_M3 |  |  |  | UART1_CTSN_M1 | SPI4_CSN0_M3 | PCIE0_CLKREQN_M0 |  | 1.8V | I/O | GPIO2_B2_D
B28 | GPIO2_B3_d | 1B16 | GPIO2_B3_d | VI_CIF_D10 | SDMMC1_CLK_M1 | ETH0_TXCLK_M1 | SAI0_SDO2_M0 | PDM0_CLK1_M3 |  |  |  | UART1_RTSN_M1 | SPI4_CLK_M3 | PCIE1_CLKREQN_M0 |  | 1.8V | I/O | GPIO2_B3_D
B45 | GPIO2_B4_d | A19 | GPIO2_B4_d | VI_CIF_D9 | SDMMC1_PWREN_M1 | ETH0_TXD2_M1 | SAI0_SDI3_M0 | PDM0_SDI0_M3 |  |  | UART7_CTSN_M0 | SPI4_MOSI_M3 |  | SATA0_ACTLED_M0 |  | 1.8V | I/O | GPIO2_B4_D
B29 | GPIO2_B5_d | 1C18 | GPIO2_B5_d | VI_CIF_D8 | SDMMC1_DETN_M1 | ETH0_RXCLK_M1 | SAI0_MCLK_M0 | PDM0_CLK0_M3 |  |  | UART7_RTSN_M0 | SPI4_MISO_M3 |  | SATA1_ACTLED_M0 |  | 1.8V | I/O | GPIO2_B5_D
B52 | GPIO2_D6_d | 1D18 | GPIO2_D6_d | CAM_CLK1_OUT_M1 | ETH_CLK1_25M_OUT_M0 | ETH0_MCLK_M1 | SAI3_MCLK_M2 | SPDIF_RX0_M2 |  |  | UART9_RTSN_M0 |  |  | I3C1_SDA_PU_M0 | PWM2_CH6_M2 | 1.8V | I/O | GPIO2_D6_D
B27 | GPIO2_D7_d | 1E15 | GPIO2_D7_d | CAM_CLK2_OUT_M1 | ETH1_MCLK_M0 | ETH_CLK0_25M_OUT_M1 | SAI0_SDO3_M0 | SPDIF_TX0_M2 |  |  | UART9_CTSN_M0 | SPI3_CSN1_M0 |  |  | PWM2_CH7_M2 | 1.8V | I/O | GPIO2_D7_D
B43 | GPIO3_A2_d | 1A20 | GPIO3_A2_d | VI_CIF_CLKO | ETH1_PPSCLK_M0 | ETH0_RXCTL_M1 | SAI3_SDO_M2 | SPDIF_RX1_M1 |  |  | UART3_CTSN_M0 | SPI3_MISO_M0 | CAN1_TX_M3 | MIPI_TE_M1 |  | 1.8V | I/O | GPIO3_A2_D
B47 | GPIO3_A3_d | 1A19 | GPIO3_A3_d | VI_CIF_CLKI | ETH1_PTP_REFCLK_M0 | ETH0_RXD1_M1 | SAI3_SDI_M2 | SPDIF_TX1_M1 |  |  | UART3_RTSN_M0 | SPI3_CSN0_M0 | CAN1_RX_M3 |  |  | 1.8V | I/O | GPIO3_A3_D
B73 | GPIO3_A4_d | 1D13 | GPIO3_A4_d | VO_LCDC_D23 | VO_EBC_SDSHR | ETH_CLK0_25M_OUT_M0 | SAI4_SDI_M1 | DSMC_RDYN | FLEXBUS1_D11 |  | FLEXBUS0_CSN_M0 | UART1_CTSN_M2 | SPI2_CLK_M2 |  | PWM1_CH0_M3 | 1.8V | I/O | GPIO3_A4_D
B56 | GPIO3_B0_d | B14 | GPIO3_B0_d | VO_LCDC_D19 | VO_EBC_SDCE3 | ETH0_MCLK_M0 | SAI4_MCLK_M1 | DSMC_CSN1 | FLEXBUS0_D8 |  |  | UART10_RX_M0 | SPI2_MOSI_M2 |  | PWM0_CH0_M3 | 1.8V | I/O | GPIO3_B0_D
B34 | GPIO3_C5_d | 1B9 | GPIO3_C5_d | VO_LCDC_D6 | VO_EBC_SDDO6 |  | SAI1_SDO0_M1 | DSMC_DATA4 | FLEXBUS1_D6 |  |  | UART8_RX_M0 | SPI1_MISO_M2 |  | PWM2_CH2_M3 | 1.8V | I/O | GPIO3_C5_D
B49 | GPIO3_C6_d | 1D7 | GPIO3_C6_d | VO_LCDC_D5 | VO_EBC_SDDO5 |  | SAI1_LRCK_M1 | DSMC_DATA3 | FLEXBUS1_D5 |  |  | UART8_TX_M0 | SPI1_MOSI_M2 |  |  | 1.8V | I/O | GPIO3_C6_D
B42 | GPIO3_C7_d | 1C7 | GPIO3_C7_d | VO_LCDC_D4 | VO_EBC_SDDO4 |  | SAI1_SCLK_M1 | DSMC_DATA2 | FLEXBUS1_D4 |  |  | UART8_RTSN_M0 | SPI1_CLK_M2 |  |  | 1.8V | I/O | GPIO3_C7_D
B65 | GPIO3_D0_d | 1C12 | GPIO3_D0_d | VO_LCDC_D3 | VO_EBC_SDDO3 |  | SAI1_MCLK_M1 | DSMC_DATA1 | FLEXBUS1_D3 |  |  | UART8_CTSN_M0 | SPI1_CSN0_M2 |  | PWM2_CH3_M3 | 1.8V | I/O | GPIO3_D0_D
B44 | GPIO3_D4_d | 1E12 | GPIO3_D4_d | VO_LCDC_DEN | VO_EBC_SDLE |  | SAI1_SDI1_M1 | DSMC_DATA0 | FLEXBUS1_D1 |  |  | UART5_RX_M0 | SPI3_CLK_M1 | I2C3_SCL_M2 |  | 1.8V | I/O | GPIO3_D4_D
B76 | GPIO3_D5_d | 1D10 | GPIO3_D5_d | VO_LCDC_HSYNC | VO_EBC_GDCLK |  | SAI1_SDI2_M1 | DSMC_CLKP | FLEXBUS1_D0 |  |  | UART5_TX_M0 | SPI3_MISO_M1 | I2C3_SDA_M2 |  | 1.8V | I/O | GPIO3_D5_D
B75 | GPIO3_D6_d | 1C10 | GPIO3_D6_d | VO_LCDC_VSYNC | VO_EBC_SDCLK |  | SAI1_SDI3_M1 | DSMC_CLKN | FLEXBUS1_CLK |  |  | UART5_CTSN_M0 | SPI3_MOSI_M1 |  | PWM2_CH6_M3 | 1.8V | I/O | GPIO3_D6_D
B74 | GPIO3_D7_d | 1E7 | GPIO3_D7_d | VO_LCDC_CLK | VO_EBC_SDOE | CAM_CLK0_OUT_M0 | SAI4_SCLK_M1 | DSMC_RESETN | FLEXBUS0_D15_M0 | FLEXBUS1_D12_M0 | FLEXBUS1_CSN_M1 | UART5_RTSN_M0 | SPI3_CSN1_M1 |  | PWM2_CH7_M3 | 1.8V | I/O | GPIO3_D7_D
B57 | GPIO4_A0_d | 1B12 | GPIO4_A0_d |  | SPDIF_RX0_M1 | CAM_CLK1_OUT_M0 | SAI4_LRCK_M1 | DSMC_INT0 | FLEXBUS0_D13_M0 | FLEXBUS1_D14_M0 | FLEXBUS1_CSN_M3 | UART3_TX_M1 | SPI1_CSN1_M2 | I2C7_SCL_M2 | MIPI_TE_M2 | 1.8V | I/O | GPIO4_A0_D
B51 | GPIO4_A1_d | 1B7 | GPIO4_A1_d | VO_POST_EMPTY | SPDIF_TX0_M1 | CAM_CLK2_OUT_M0 | SAI4_SDO_M1 | DSMC_INT2 | FLEXBUS0_D14_M0 | FLEXBUS1_D13_M0 | FLEXBUS0_CSN_M1 | UART3_RX_M1 |  | I2C7_SDA_M2 |  | 1.8V | I/O | GPIO4_A1_D
B46 | GPIO4_B2_d | B6 | GPIO4_B2_d | SAI1_SDO3_M0 | SAI1_SDI1_M0 | PDM1_SDI1_M1 | FLEXBUS1_D15_M1 |  |  |  |  | SPI4_MISO_M2 |  | MIPI_TE_M0 |  | 3.3V | I/O | GPIO4_B2_D
B12 | PWRON_L |  |  |  |  |  |  |  |  |  |  |  |  |  |  |  | I |  | PMIC PIN,Processor sleep boot signal
B11 | RESET_L | W28 | NPOR |  |  |  |  |  |  |  |  |  |  |  |  | 1.8V | I |  | Reset signal,Internal pull up 10K to 1.8V
B10 | PMIC_EXT_EN_OUT |  |  |  |  |  |  |  |  |  |  |  |  |  |  |  | O |  | PMIC PIN,Core board output controls baseboard power output
B15 | PMIC_PWR_CTRL2 | 1T24 | GPIO0_A4_d |  |  |  |  |  |  |  | PWR_CTRL2 |  |  |  |  |  | I/O |  | Core board output controls baseboard power output
B9 | VCC_3V3_S3 |  |  |  |  |  |  |  |  |  |  |  |  |  |  | 3.3V
B8 | VCC_3V3_S3 |  |  |  |  |  |  |  |  |  |  |  |  |  |  | 3.3V
B19 | VCC_1V8_S3 |  |  |  |  |  |  |  |  |  |  |  |  |  |  | 1.8V
B18 | VCC_1V8_S3 |  |  |  |  |  |  |  |  |  |  |  |  |  |  | 1.8V
B5 | VDD_CORE_5V |  |  |  |  |  |  |  |  |  |  |  |  |  |  | 5V
B4 | VDD_CORE_5V |  |  |  |  |  |  |  |  |  |  |  |  |  |  | 5V
B3 | VDD_CORE_5V |  |  |  |  |  |  |  |  |  |  |  |  |  |  | 5V
B2 | VDD_CORE_5V |  |  |  |  |  |  |  |  |  |  |  |  |  |  | 5V
B1 | VDD_CORE_5V |  |  |  |  |  |  |  |  |  |  |  |  |  |  | 5V
B80 | GND
B68 | GND
B77 | GND
B66 | GND
B55 | GND
B53 | GND
B40 | GND
B39 | GND
B37 | GND
B26 | GND
B25 | GND
B24 | GND
B23 | GND
B22 | GND
B14 | GND
B13 | GND
B7 | GND
B6 | GND
A87 | GND
A82 | GND
A72 | GND
A67 | GND
A64 | GND
A58 | GND
A55 | GND
C10 | DP_TX_AUXP | 2T2 | DP_TX_AUXP |  |  |  |  |  |  |  |  |  |  |  |  |  | AI/O | DP_TX_AUXP
C11 | DP_TX_AUXN | 2T3 | DP_TX_AUXN |  |  |  |  |  |  |  |  |  |  |  |  |  | AI/O | DP_TX_AUXN
C52 | DP_TX_D2P | AK12 | USB3_OTG0_SSRX2P | DP_TX_D2P |  |  |  |  |  |  |  |  |  |  |  |  | AO | DP_TX_D2P
C53 | DP_TX_D2N | AL12 | USB3_OTG0_SSRX2N | DP_TX_D2N |  |  |  |  |  |  |  |  |  |  |  |  | AO | DP_TX_D2N
C32 | DP_TX_D3P | AL13 | USB3_OTG0_SSTX2P | DP_TX_D3P |  |  |  |  |  |  |  |  |  |  |  |  | AO | DP_TX_D3P
C33 | DP_TX_D3N | AK13 | USB3_OTG0_SSTX2N | DP_TX_D3N |  |  |  |  |  |  |  |  |  |  |  |  | AO | DP_TX_D3N
C86 | USB2_OTG0_DP | AK9 | USB2_OTG0_DP |  |  |  |  |  |  |  |  |  |  |  |  |  | AI/O | USB2_OTG0_DP
C87 | USB2_OTG0_DM | AL9 | USB2_OTG0_DM |  |  |  |  |  |  |  |  |  |  |  |  |  | AI/O | USB2_OTG0_DM
C73 | USB3_OTG0_SSTX_1P | AL11 | USB3_OTG0_SSTX1P | DP_TX_D1P |  |  |  |  |  |  |  |  |  |  |  |  | AO | USB3_OTG0_SSTX_1P
C74 | USB3_OTG0_SSTX_1N | AK11 | USB3_OTG0_SSTX1N | DP_TX_D1N |  |  |  |  |  |  |  |  |  |  |  |  | AO | USB3_OTG0_SSTX_1N
C35 | USB3_OTG0_SSRX_1P | AK10 | USB3_OTG0_SSRX1P | DP_TX_D0P |  |  |  |  |  |  |  |  |  |  |  |  | AI/O | USB3_OTG0_SSRX_1P
C36 | USB3_OTG0_SSRX_1N | AL10 | USB3_OTG0_SSRX1N | DP_TX_D0N |  |  |  |  |  |  |  |  |  |  |  |  | AI/O | USB3_OTG0_SSRX_1N
C55 | USB2_OTG0_ID | 2R6 | USB2_OTG0_ID |  |  |  |  |  |  |  |  |  |  |  |  |  | I | USB2_OTG0_ID
C71 | USB2_OTG0_VBUSDET | 2P3 | USB2_OTG0_VBUSDET |  |  |  |  |  |  |  |  |  |  |  |  |  | I | USB2_OTG0_VBUSDET
C89 | USB2_OTG1_DP | 2T4 | USB2_OTG1_DP |  |  |  |  |  |  |  |  |  |  |  |  |  | AI/O | USB2_OTG1_DP
C90 | USB2_OTG1_DM | 2T5 | USB2_OTG1_DM |  |  |  |  |  |  |  |  |  |  |  |  |  | AI/O | USB2_OTG1_DM
C14 | USB2_OTG1_ID | 2T9 | USB2_OTG1_ID |  |  |  |  |  |  |  |  |  |  |  |  |  | I | USB2_OTG1_ID
C13 | USB2_OTG1_VBUSDET | 2T10 | USB2_OTG1_VBUSDET |  |  |  |  |  |  |  |  |  |  |  |  |  | I | USB2_OTG1_VBUSDET
C77 | MIPI_DPHY_DSI_TX_D0P | AL15 | MIPI_DPHY_DSI_TX_D0P | MIPI_CPHY_DSI_TX_TRIO0_B |  |  |  |  |  |  |  |  |  |  |  | 1.8V | AO | MIPI_DPHY_DSI_TX_D0P
C76 | MIPI_DPHY_DSI_TX_D0N | AK15 | MIPI_DPHY_DSI_TX_D0N | MIPI_CPHY_DSI_TX_TRIO0_A |  |  |  |  |  |  |  |  |  |  |  | 1.8V | AO | MIPI_DPHY_DSI_TX_D0N
C39 | MIPI_DPHY_DSI_TX_D1P | AL16 | MIPI_DPHY_DSI_TX_D1P | MIPI_CPHY_DSI_TX_TRIO1_A |  |  |  |  |  |  |  |  |  |  |  | 1.8V | AO | MIPI_DPHY_DSI_TX_D1P
C38 | MIPI_DPHY_DSI_TX_D1N | AK16 | MIPI_DPHY_DSI_TX_D1N | MIPI_CPHY_DSI_TX_TRIO0_C |  |  |  |  |  |  |  |  |  |  |  | 1.8V | AO | MIPI_DPHY_DSI_TX_D1N
C58 | MIPI_DPHY_DSI_TX_CLKP | AL17 | MIPI_DPHY_DSI_TX_CLKP | MIPI_CPHY_DSI_TX_TRIO1_C |  |  |  |  |  |  |  |  |  |  |  | 1.8V | AO | MIPI_DPHY_DSI_TX_CLKP
C57 | MIPI_DPHY_DSI_TX_CLKN | AK17 | MIPI_DPHY_DSI_TX_CLKN | MIPI_CPHY_DSI_TX_TRIO1_B |  |  |  |  |  |  |  |  |  |  |  | 1.8V | AO | MIPI_DPHY_DSI_TX_CLKN
C17 | MIPI_DPHY_DSI_TX_D2P | AL18 | MIPI_DPHY_DSI_TX_D2P | MIPI_CPHY_DSI_TX_TRIO2_B |  |  |  |  |  |  |  |  |  |  |  | 1.8V | AO | MIPI_DPHY_DSI_TX_D2P
C16 | MIPI_DPHY_DSI_TX_D2N | AK18 | MIPI_DPHY_DSI_TX_D2N | MIPI_CPHY_DSI_TX_TRIO2_A |  |  |  |  |  |  |  |  |  |  |  | 1.8V | AO | MIPI_DPHY_DSI_TX_D2N
C61 | MIPI_DPHY_DSI_TX_D3P | AL19 | MIPI_DPHY_DSI_TX_D3P | NO_USE |  |  |  |  |  |  |  |  |  |  |  | 1.8V | AO | MIPI_DPHY_DSI_TX_D3P
C60 | MIPI_DPHY_DSI_TX_D3N | AK19 | MIPI_DPHY_DSI_TX_D3N | MIPI_CPHY_DSI_TX_TRIO2_C |  |  |  |  |  |  |  |  |  |  |  | 1.8V | AO | MIPI_DPHY_DSI_TX_D3N
C80 | MIPI_DPHY_CSI0_RX_D0P | AK20 | MIPI_DPHY_CSI0_RX_D0P | MIPI_CPHY_CSI_RX_TRIO0_B |  |  |  |  |  |  |  |  |  |  |  | 1.8V | AI | MIPI_DPHY_CSI0_RX_D0P
C79 | MIPI_DPHY_CSI0_RX_D0N | AL20 | MIPI_DPHY_CSI0_RX_D0N | MIPI_CPHY_CSI_RX_TRIO0_A |  |  |  |  |  |  |  |  |  |  |  | 1.8V | AI | MIPI_DPHY_CSI0_RX_D0N
C42 | MIPI_DPHY_CSI0_RX_D1P | AK21 | MIPI_DPHY_CSI0_RX_D1P | MIPI_CPHY_CSI_RX_TRIO1_A |  |  |  |  |  |  |  |  |  |  |  | 1.8V | AI | MIPI_DPHY_CSI0_RX_D1P
C41 | MIPI_DPHY_CSI0_RX_D1N | AL21 | MIPI_DPHY_CSI0_RX_D1N | MIPI_CPHY_CSI_RX_TRIO0_C |  |  |  |  |  |  |  |  |  |  |  | 1.8V | AI | MIPI_DPHY_CSI0_RX_D1N
C93 | MIPI_DPHY_CSI0_RX_CLKP | AK22 | MIPI_DPHY_CSI0_RX_CLKP | MIPI_CPHY_CSI_RX_TRIO1_C |  |  |  |  |  |  |  |  |  |  |  | 1.8V | AI | MIPI_DPHY_CSI0_RX_CLKP
C92 | MIPI_DPHY_CSI0_RX_CLKN | AL22 | MIPI_DPHY_CSI0_RX_CLKN | MIPI_CPHY_CSI_RX_TRIO1_B |  |  |  |  |  |  |  |  |  |  |  | 1.8V | AI | MIPI_DPHY_CSI0_RX_CLKN
C64 | MIPI_DPHY_CSI0_RX_D2P | AK23 | MIPI_DPHY_CSI0_RX_D2P | MIPI_CPHY_CSI_RX_TRIO2_B |  |  |  |  |  |  |  |  |  |  |  | 1.8V | AI | MIPI_DPHY_CSI0_RX_D2P
C63 | MIPI_DPHY_CSI0_RX_D2N | AL23 | MIPI_DPHY_CSI0_RX_D2N | MIPI_CPHY_CSI_RX_TRIO2_A |  |  |  |  |  |  |  |  |  |  |  | 1.8V | AI | MIPI_DPHY_CSI0_RX_D2N
C45 | MIPI_DPHY_CSI0_RX_D3P | AK24 | MIPI_DPHY_CSI0_RX_D3P | NO_USE |  |  |  |  |  |  |  |  |  |  |  | 1.8V | AI | MIPI_DPHY_CSI0_RX_D3P
C44 | MIPI_DPHY_CSI0_RX_D3N | AL24 | MIPI_DPHY_CSI0_RX_D3N | MIPI_CPHY_CSI_RX_TRIO2_C |  |  |  |  |  |  |  |  |  |  |  | 1.8V | AI | MIPI_DPHY_CSI0_RX_D3N
C4 | SPI4_CSN0_M0 | AL3 | GPIO4_C4_d | ISP_PRELIGHT_TRIG_M1 | SAI4_LRCK_M2 |  |  |  |  |  | DP_HPDIN_M0 | I2C3_SCL_M3 | SPI4_CSN0_M0 | UART6_TX_M3 | PWM2_CH6_M1 | 3.3V | I/O | SPI4_CSN0_M0
C47 | SPI4_CLK_M0 | AJ1 | GPIO4_C7_d |  | SAI4_SCLK_M2 | VP2_SYNC_OUT |  |  |  |  |  | I2C6_SDA_M3 | SPI4_CLK_M0 | CAN1_RX_M1 | PWM2_CH3_M1 | 3.3V | I/O | SPI4_CLK_M0
C27 | SPI4_MISO_M0 | 1AE1 | GPIO4_C6_d |  | SAI4_SDI_M2 | VP1_SYNC_OUT |  |  |  | PCIE0_CLKREQN_M3 | SATA0_ACTLED_M1 | I2C6_SCL_M3 | SPI4_MISO_M0 | CAN1_TX_M1 | PWM2_CH2_M1 | 3.3V | I/O | SPI4_MISO_M0
C26 | SPI4_MOSI_M0 | AK1 | GPIO4_C5_d | ISP_FLASH_TRIGOUT_M1 | SAI4_SDO_M2 | VP0_SYNC_OUT |  |  |  |  | SATA1_ACTLED_M1 | I2C3_SDA_M3 | SPI4_MOSI_M0 | UART6_RX_M3 | PWM2_CH5_M1 | 3.3V | I/O | SPI4_MOSI_M0
C83 | NC
C84 | NC
C68 | NC
C69 | NC
C29 | NC
C30 | NC
C49 | NC
C50 | NC
C81 | NC
C66 | NC
C91 | GND
C88 | GND
C85 | GND
C82 | NC
C78 | GND
C75 | GND
C72 | GND
C70 | GND
C67 | NC
C65 | NC
C62 | GND
C59 | GND
C56 | GND
C54 | GND
C51 | GND
C48 | GND
C46 | NC
C43 | GND
C40 | GND
C37 | GND
C34 | GND
C31 | GND
C28 | GND
C25 | NC
C24 | NC
C22 | NC
C21 | NC
C20 | NC
C19 | NC
C18 | GND
C15 | GND
C12 | GND
C9 | GND
C3 | NC
D52 | PCIE0_REFCLKP | 1N22 | PCIE0_REFCLKP |  |  |  |  |  |  |  |  |  |  |  |  |  | AI/O | PCIE0_REFCLKP
D51 | PCIE0_REFCLKN | 1N23 | PCIE0_REFCLKN |  |  |  |  |  |  |  |  |  |  |  |  |  | AI/O | PCIE0_REFCLKN
D33 | PCIE0_TXP | P29 | PCIE0_TXP | SATA0_TXP |  |  |  |  |  |  |  |  |  |  |  |  | AO | PCIE0_TXP
D32 | PCIE0_TXN | P28 | PCIE0_TXN | SATA0_TXN |  |  |  |  |  |  |  |  |  |  |  |  | AO | PCIE0_TXN
D36 | PCIE0_RXP | R28 | PCIE0_RXP | SATA0_RXP |  |  |  |  |  |  |  |  |  |  |  |  | AI | PCIE0_RXP
D35 | PCIE0_RXN | R29 | PCIE0_RXN | SATA0_RXN |  |  |  |  |  |  |  |  |  |  |  |  | AI | PCIE0_RXN
D8 | PCIE1_REFCLKP | 1L23 | PCIE1_REFCLKP |  |  |  |  |  |  |  |  |  |  |  |  |  | AI/O | PCIE1_REFCLKP
D7 | PCIE1_REFCLKN | 1M23 | PCIE1_REFCLKN |  |  |  |  |  |  |  |  |  |  |  |  |  | AI/O | PCIE1_REFCLKN
D11 | PCIE1_TXP/USB3_HOST1_SSTXP | N28 | PCIE1_TXP | SATA1_TXP | USB3_OTG1_SSTXP |  |  |  |  |  |  |  |  |  |  |  | AO | PCIE1_TXP/USB3_HOST1_SSTXP
D10 | PCIE1_TXN/USB3_HOST1_SSTXN | N29 | PCIE1_TXN | SATA1_TXN | USB3_OTG1_SSTXN |  |  |  |  |  |  |  |  |  |  |  | AO | PCIE1_TXN/USB3_HOST1_SSTXN
D14 | PCIE1_RXP/USB3_HOST1_SSRXP | M28 | PCIE1_RXP | SATA1_RXP | USB3_OTG1_SSRXP |  |  |  |  |  |  |  |  |  |  |  | AI | PCIE1_RXP/USB3_HOST1_SSRXP
D13 | PCIE1_RXN/USB3_HOST1_SSRXN | M29 | PCIE1_RXN | SATA1_RXN | USB3_OTG1_SSRXN |  |  |  |  |  |  |  |  |  |  |  | AI | PCIE1_RXN/USB3_HOST1_SSRXN
D62 | MIPI_DPHY_CSI1_RX_D0P | AE29 | MIPI_DPHY_CSI1_RX_D0P |  |  |  |  |  |  |  |  |  |  |  |  | 1.8V | AI | MIPI_DPHY_CSI1_RX_D0P
D61 | MIPI_DPHY_CSI1_RX_D0N | AE28 | MIPI_DPHY_CSI1_RX_D0N |  |  |  |  |  |  |  |  |  |  |  |  | 1.8V | AI | MIPI_DPHY_CSI1_RX_D0N
D59 | MIPI_DPHY_CSI1_RX_D1P | AF29 | MIPI_DPHY_CSI1_RX_D1P |  |  |  |  |  |  |  |  |  |  |  |  | 1.8V | AI | MIPI_DPHY_CSI1_RX_D1P
D58 | MIPI_DPHY_CSI1_RX_D1N | AF28 | MIPI_DPHY_CSI1_RX_D1N |  |  |  |  |  |  |  |  |  |  |  |  | 1.8V | AI | MIPI_DPHY_CSI1_RX_D1N
D72 | MIPI_DPHY_CSI1_RX_CLKP | 1AC22 | MIPI_DPHY_CSI1_RX_CLKP |  |  |  |  |  |  |  |  |  |  |  |  | 1.8V | AI | MIPI_DPHY_CSI1_RX_CLKP
D71 | MIPI_DPHY_CSI1_RX_CLKN | 1AC23 | MIPI_DPHY_CSI1_RX_CLKN |  |  |  |  |  |  |  |  |  |  |  |  | 1.8V | AI | MIPI_DPHY_CSI1_RX_CLKN
D46 | MIPI_DPHY_CSI2_RX_D0P | AG29 | MIPI_DPHY_CSI1_RX_D2P | MIPI_DPHY_CSI2_RX_D0P |  |  |  |  |  |  |  |  |  |  |  | 1.8V | AI | MIPI_DPHY_CSI2_RX_D0P
D45 | MIPI_DPHY_CSI2_RX_D0N | AG28 | MIPI_DPHY_CSI1_RX_D2N | MIPI_DPHY_CSI2_RX_D0N |  |  |  |  |  |  |  |  |  |  |  | 1.8V | AI | MIPI_DPHY_CSI2_RX_D0N
D30 | MIPI_DPHY_CSI2_RX_D1P | AH29 | MIPI_DPHY_CSI1_RX_D3P | MIPI_DPHY_CSI2_RX_D1P |  |  |  |  |  |  |  |  |  |  |  | 1.8V | AI | MIPI_DPHY_CSI2_RX_D1P
D29 | MIPI_DPHY_CSI2_RX_D1N | AH28 | MIPI_DPHY_CSI1_RX_D3N | MIPI_DPHY_CSI2_RX_D1N |  |  |  |  |  |  |  |  |  |  |  | 1.8V | AI | MIPI_DPHY_CSI2_RX_D1N
D49 | MIPI_DPHY_CSI2_RX_CLKP | 1AD21 |  | MIPI_DPHY_CSI2_RX_CLKP |  |  |  |  |  |  |  |  |  |  |  | 1.8V | AI | MIPI_DPHY_CSI2_RX_CLKP
D48 | MIPI_DPHY_CSI2_RX_CLKN | 1AD22 |  | MIPI_DPHY_CSI2_RX_CLKN |  |  |  |  |  |  |  |  |  |  |  | 1.8V | AI | MIPI_DPHY_CSI2_RX_CLKN
D21 | MIPI_DPHY_CSI3_RX_D0P | H28 | MIPI_DPHY_CSI3_RX_D0P |  |  |  |  |  |  |  |  |  |  |  |  | 1.8V | AI | MIPI_DPHY_CSI3_RX_D0P
D20 | MIPI_DPHY_CSI3_RX_D0N | H29 | MIPI_DPHY_CSI3_RX_D0N |  |  |  |  |  |  |  |  |  |  |  |  | 1.8V | AI | MIPI_DPHY_CSI3_RX_D0N
D18 | MIPI_DPHY_CSI3_RX_D1P | J28 | MIPI_DPHY_CSI3_RX_D1P |  |  |  |  |  |  |  |  |  |  |  |  | 1.8V | AI | MIPI_DPHY_CSI3_RX_D1P
D17 | MIPI_DPHY_CSI3_RX_D1N | J29 | MIPI_DPHY_CSI3_RX_D1N |  |  |  |  |  |  |  |  |  |  |  |  | 1.8V | AI | MIPI_DPHY_CSI3_RX_D1N
D40 | MIPI_DPHY_CSI3_RX_CLKP | 1H22 | MIPI_DPHY_CSI3_RX_CLKP |  |  |  |  |  |  |  |  |  |  |  |  | 1.8V | AI | MIPI_DPHY_CSI3_RX_CLKP
D39 | MIPI_DPHY_CSI3_RX_CLKN | 1H23 | MIPI_DPHY_CSI3_RX_CLKN |  |  |  |  |  |  |  |  |  |  |  |  | 1.8V | AI | MIPI_DPHY_CSI3_RX_CLKN
D55 | MIPI_DPHY_CSI4_RX_D0P | K28 | MIPI_DPHY_CSI3_RX_D2P | MIPI_DPHY_CSI4_RX_D0P |  |  |  |  |  |  |  |  |  |  |  | 1.8V | AI | MIPI_DPHY_CSI4_RX_D0P
D54 | MIPI_DPHY_CSI4_RX_D0N | K29 | MIPI_DPHY_CSI3_RX_D2N | MIPI_DPHY_CSI4_RX_D0N |  |  |  |  |  |  |  |  |  |  |  | 1.8V | AI | MIPI_DPHY_CSI4_RX_D0N
D69 | MIPI_DPHY_CSI4_RX_D1P | L28 | MIPI_DPHY_CSI3_RX_D3P | MIPI_DPHY_CSI4_RX_D1P |  |  |  |  |  |  |  |  |  |  |  | 1.8V | AI | MIPI_DPHY_CSI4_RX_D1P
D68 | MIPI_DPHY_CSI4_RX_D1N | L29 | MIPI_DPHY_CSI3_RX_D3N | MIPI_DPHY_CSI4_RX_D1N |  |  |  |  |  |  |  |  |  |  |  | 1.8V | AI | MIPI_DPHY_CSI4_RX_D1N
D80 | MIPI_DPHY_CSI4_RX_CLKP | 1K22 |  | MIPI_DPHY_CSI4_RX_CLKP |  |  |  |  |  |  |  |  |  |  |  | 1.8V | AI | MIPI_DPHY_CSI4_RX_CLKP
D79 | MIPI_DPHY_CSI4_RX_CLKN | 1K23 |  | MIPI_DPHY_CSI4_RX_CLKN |  |  |  |  |  |  |  |  |  |  |  | 1.8V | AI | MIPI_DPHY_CSI4_RX_CLKN
D75 | SPI0_CSN0_M0 | 1Y21 | GPIO0_C6_d | SAI0_SCLK_M1 |  |  |  |  |  |  | I2C3_SCL_M1 |  | SPI0_CSN0_M0 |  |  | 3.3V | I/O | SPI0_CSN0_M0
D74 | SPI0_CLK_M0 | 1Y23 | GPIO0_C7_d | SAI0_LRCK_M1 |  |  |  |  |  |  | I2C3_SDA_M1 |  | SPI0_CLK_M0 |  |  | 3.3V | I/O | SPI0_CLK_M0
D76 | SPI0_MISO_M0 | AC28 | GPIO0_D1_d | SAI0_SDI1_M1 | SAI0_SDO3_M1 | PDM0_SDI1_M0 |  |  |  |  |  |  | SPI0_MISO_M0 |  |  | 3.3V | I/O | SPI0_MISO_M0
D77 | SPI0_MOSI_M0 | 1W23 | GPIO0_D0_d | SAI0_SDI0_M1 |  | PDM0_SDI0_M0 |  |  |  |  |  |  | SPI0_MOSI_M0 |  |  | 3.3V | I/O | SPI0_MOSI_M0
D27 | HDMI_TX_D0P | 1AE24 | HDMI_TX_D0P | EDP_TX_D0P |  |  |  |  |  |  |  |  |  |  |  |  | AO | HDMI_TX_D0P
D26 | HDMI_TX_D0N | AK27 | HDMI_TX_D0N | EDP_TX_D0N |  |  |  |  |  |  |  |  |  |  |  |  | AO | HDMI_TX_D0N
D5 | HDMI_TX_D1P | AK28 | HDMI_TX_D1P | EDP_TX_D1P |  |  |  |  |  |  |  |  |  |  |  |  | AO | HDMI_TX_D1P
D4 | HDMI_TX_D1N | AL28 | HDMI_TX_D1N | EDP_TX_D1N |  |  |  |  |  |  |  |  |  |  |  |  | AO | HDMI_TX_D1N
D24 | HDMI_TX_D2P | AJ28 | HDMI_TX_D2P | EDP_TX_D2P |  |  |  |  |  |  |  |  |  |  |  |  | AO | HDMI_TX_D2P
D23 | HDMI_TX_D2N | AK29 | HDMI_TX_D2N | EDP_TX_D2N |  |  |  |  |  |  |  |  |  |  |  |  | AO | HDMI_TX_D2N
D2 | HDMI_TX_D3P | AL26 | HDMI_TX_D3P | EDP_TX_D3P |  |  |  |  |  |  |  |  |  |  |  |  | AO | HDMI_TX_D3P
D1 | HDMI_TX_D3N | AK26 | HDMI_TX_D3N | EDP_TX_D3N |  |  |  |  |  |  |  |  |  |  |  |  | AO | HDMI_TX_D3N
D42 | HDMI_TX_SBDP | 2T12 | HDMI_TX_SBDP | EDP_TX_AUXP |  |  |  |  |  |  |  |  |  |  |  |  | AI/O | HDMI_TX_SBDP
D43 | HDMI_TX_SBDN | 2U12 | HDMI_TX_SBDN | EDP_TX_AUXN |  |  |  |  |  |  |  |  |  |  |  |  | AI/O | HDMI_TX_SBDN
C5 | HDMI_TX_SCL | AL2 | GPIO4_C2_d | DSM_AUD_RP_M1 |  |  |  | HDMI_TX_SCL |  | I2C2_SCL_M3 | CAN0_TX_M1 | UART9_TX_M2 | PWM2_CH0_M1 |  |  | 3.3V | I/O | HDMI_TX_SCL
C6 | HDMI_TX_SDA | 1AE2 | GPIO4_C3_d | DSM_AUD_RN_M1 |  |  |  | HDMI_TX_SDA |  | I2C2_SDA_M3 | CAN0_RX_M1 | UART9_RX_M2 | PWM2_CH1_M1 |  |  | 3.3V | I/O | HDMI_TX_SDA
C8 | HDMI_TX_HPDIN_M0 | AK2 | GPIO4_C1_d | DSM_AUD_LN_M1 |  |  |  | HDMI_TX_HPDIN_M0 | PCIE1_CLKREQN_M3 | I2C7_SDA_M3 | EDP_TX_HPDIN_M0 | UART11_RX_M2 | PWM0_CH1_M1 |  |  | 3.3V | I/O | HDMI_TX_HPDIN_M0
C7 | HDMI_TX_CEC_M0 | AK3 | GPIO4_C0_d | DSM_AUD_LP_M1 | SAI4_MCLK_M2 |  |  | HDMI_TX_CEC_M0 |  | I2C7_SCL_M3 | SPI4_CSN1_M0 | UART11_TX_M2 | PWM1_CH5_M1 |  |  | 3.3V | I/O | HDMI_TX_CEC_M0
D78 | GND
D73 | GND
D70 | GND
D67 | GND
D66 | NC
D65 | NC
D64 | NC
D63 | GND
D60 | GND
D57 | GND
D56 | GND
D53 | GND
D50 | GND
D47 | GND
D44 | GND
D41 | GND
D38 | GND
D37 | GND
D34 | GND
D31 | GND
D28 | GND
D25 | GND
D22 | GND
D19 | GND
D16 | GND
D15 | GND
D12 | GND
D9 | GND
D6 | GND
D3 | GND
C1 | NC
C2 | NC
C23 | GND
E1 | GND
E2 | GND
E3 | GND
E4 | GND
E5 | GND
E6 | GND
E7 | GND
E8 | GND
E9 | GND
E10 | GND
E11 | GND
E12 | GND
E13 | GND
E14 | GND
E15 | GND
E16 | GND
E17 | GND
E18 | GND
E19 | GND
E20 | GND
E21 | GND
E22 | GND
E23 | GND
E24 | GND
E25 | GND
E26 | GND
E27 | GND
E28 | GND
E29 | GND
E30 | GND
E31 | GND
E32 | GND
E33 | GND
E34 | GND
E35 | GND
 |  |  | I/O column, I/O represents digital input and digital output, AI/O represents analog input and output
 |  |  |  | GMAC |  | SAI |  | SDMMC
 |  |  |  | UART |  | I2C |  | DP
 |  |  |  | USB |  | MIPI_DSI |  | MIPI_CSI
 |  |  |  | SPI |  | PCIE |  | Other
 |  |  |  | HDMI |  | GPIO |  | NC
 |  |  |  | Power |  | GND
