faoziaziz/qioters/qiot.step

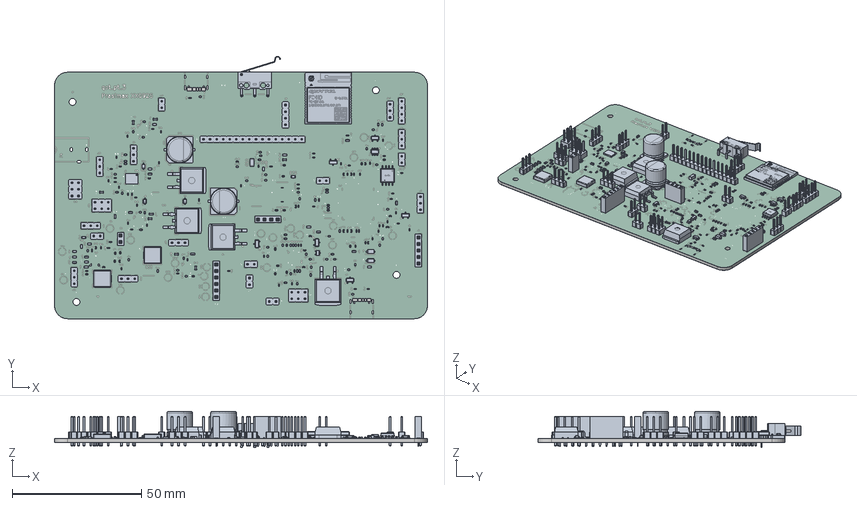
[picture p5: CAD file, 2025-10-26]
qiot.step
144.5 x 101.7 x 14.1 mm
C_0402_1005Metric x 73
SOT-23 x 6
R_0402_1005Metric x 91
LED_0402_1005Metric x 9
C_0603_1608Metric x 28
D_SOD-323 x 3
qiot 1.19.1 x 4
PinHeader_1x03_P2.54mm_Vertical x 9
CRYSTAL-SMD_4P-L2.0-W1.6-BL-2
PinHeader_2x03_P2.54mm_Vertical x 3
PinSocket_1x06_P2.54mm_Vertical
PinSocket_1x04_P2.54mm_Vertical
USB-C_SMD-TYPE-C-31-M-12 x 2
TSSOP-24_L7.8-W4.4-H1.0-LS6.4-P0.65
L_APV_APH0620 x 2
PinHeader_1x16_P2.54mm_Vertical
SOIC-8_L5.3-W5.3-H1.9-LS7.9-P1.27
LTC4162EUFD-L42_PBF
PinHeader_1x02_P2.54mm_Vertical x 7
FC41D--3DModel-STEP-269445
TQFP-80_L12.0-W12.0-H1.2-LS14.0-P0.50
R_0603_1608Metric x 4
QFN-24_L4.0-W4.0-P0.50-TL-EP2.1
SOT-23-6
PinHeader_1x04_P2.54mm_Vertical x 2
CP_Elec_10x10.5 x 2
SOT-323_SC-70
SW_XKB_DM1-16UC-1
QFN-16_L3.0-W3.0-H0.9-P0.50 x 4
HTSSOP-28_L9.7-W4.4-P0.65-LS6.4-BL-EP
C_1206_3216Metric
D_SOD-123F x 2
DC-IN-TH_PJ-102AH
PinSocket_1x05_P2.54mm_Vertical
PinSocket_1x02_P2.54mm_Vertical
qiot_silkscreen
qiot_soldermask
qiot_PCB
