faoziaziz/qioters/tester_golden_sample.pdf

Tester Golden Sample

Menyalakan device
Ada 4 tombol touch yang terletak didalam device, kita namakan dari yang paling kiri (yang dekat dengan Buzzer) sebagai tombol touch 1. Untuk 2, 3, 4 mengikuti urutan dari kiri kekanan.
Untuk menyalakan device,
1. Sambungkan usb micro dengan device.
2. Tekan tombol 1, 2, 3 secara bersamaan.
3. Check melalui device manager apakah terdeteksi COM port baru, jika iya maka kita akan coba untuk flash selanjutnya.

Flashing

Pertama delete dulu semua memorynya dengan tools => erase All Flash Memory => Erase Only

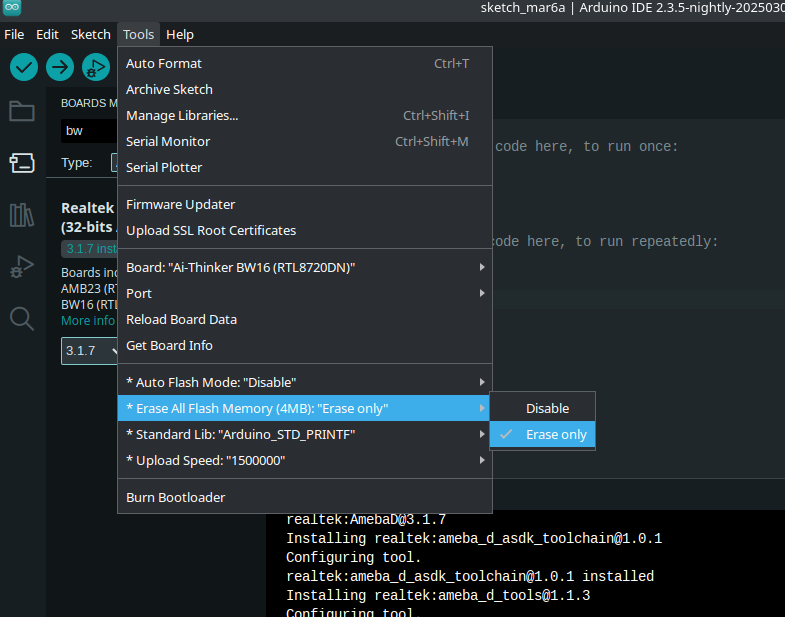
[picture p6: figure]

Pilih erase only untuk mendelete flash program yang awal, biasanya hal ini dilakukan karena pasca image yang diflash melalui ota tidak bisa langsung diflash melalui serial downloader. Kemudian klik upload dan tunggu erasing dari memorynya. Setelah flash delete ok

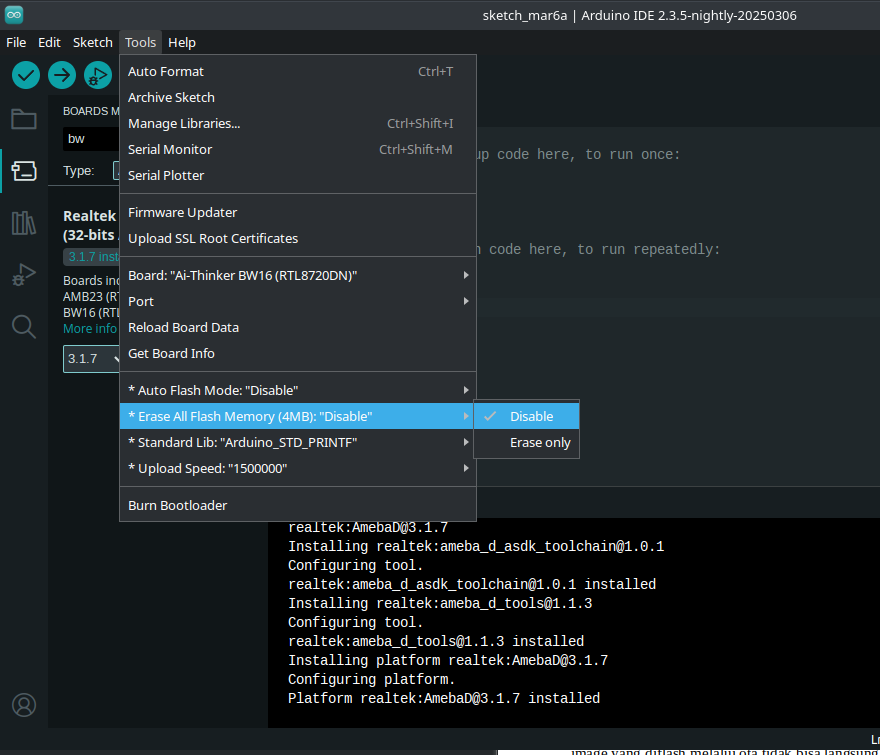
[picture p7: figure]

Rubah erase only menjadi disable.

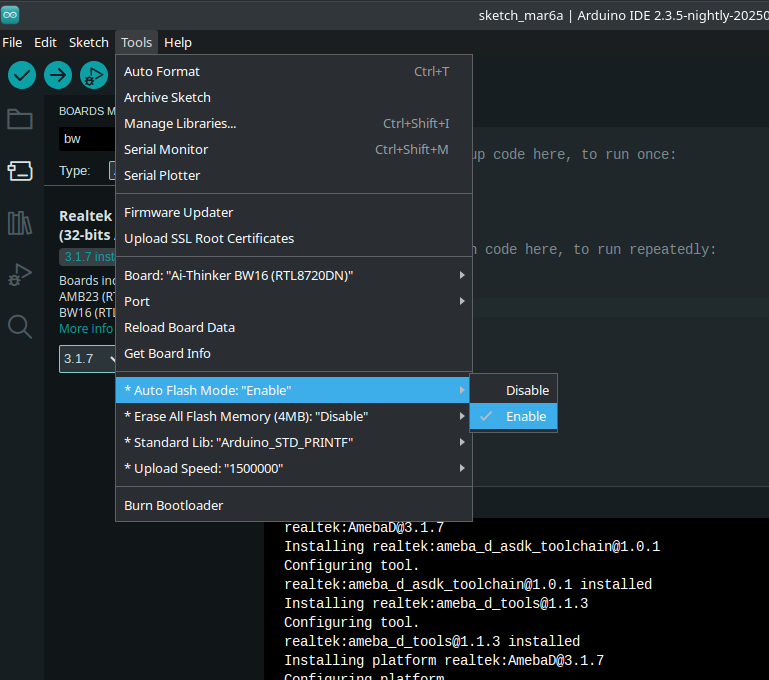
[picture p8: figure]

Pilih enable pada autoflash mode.

Download code berikut https://drive.google.com/file/d/1F_KMlC8iW5evjmMvRgDZTTVTZBBZixk/view?usp=sharing (https://drive.google.com/file/d/1F_KMlC8iW5e-vjmMvRgDZTTVTZBBZixk/view?usp=sharing)
lalu flash, namanya chelticodisp.ino

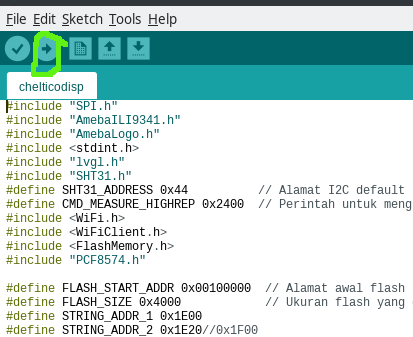
[picture p9: figure]

lalu flash dan download.

Figure 1: Lalu flash
