faoziaziz/qioters/qiot.pdf

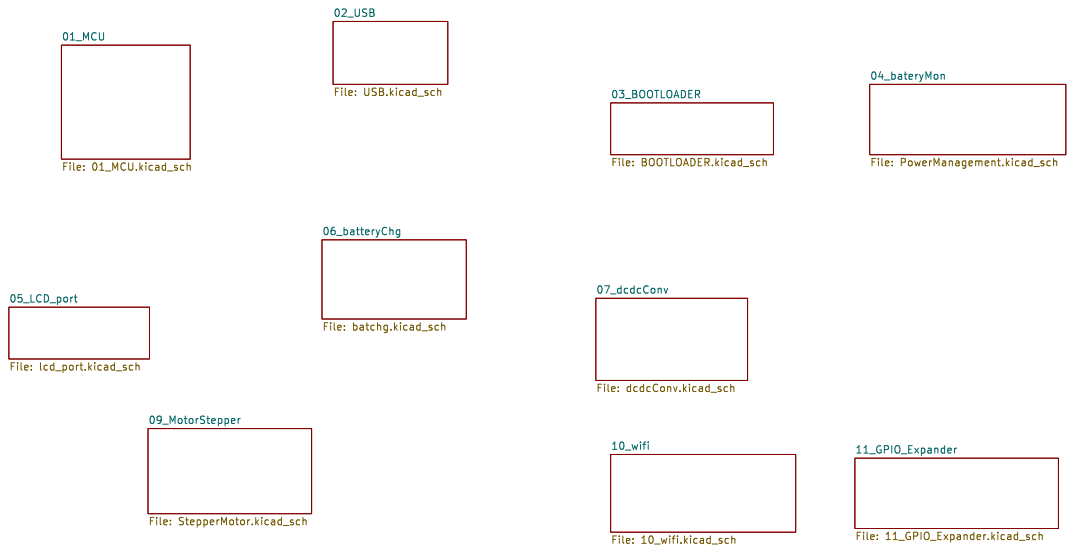
[picture p10: page 1]

Id: 1/11 Title: File: qiot.kicad_sch Sheet: /

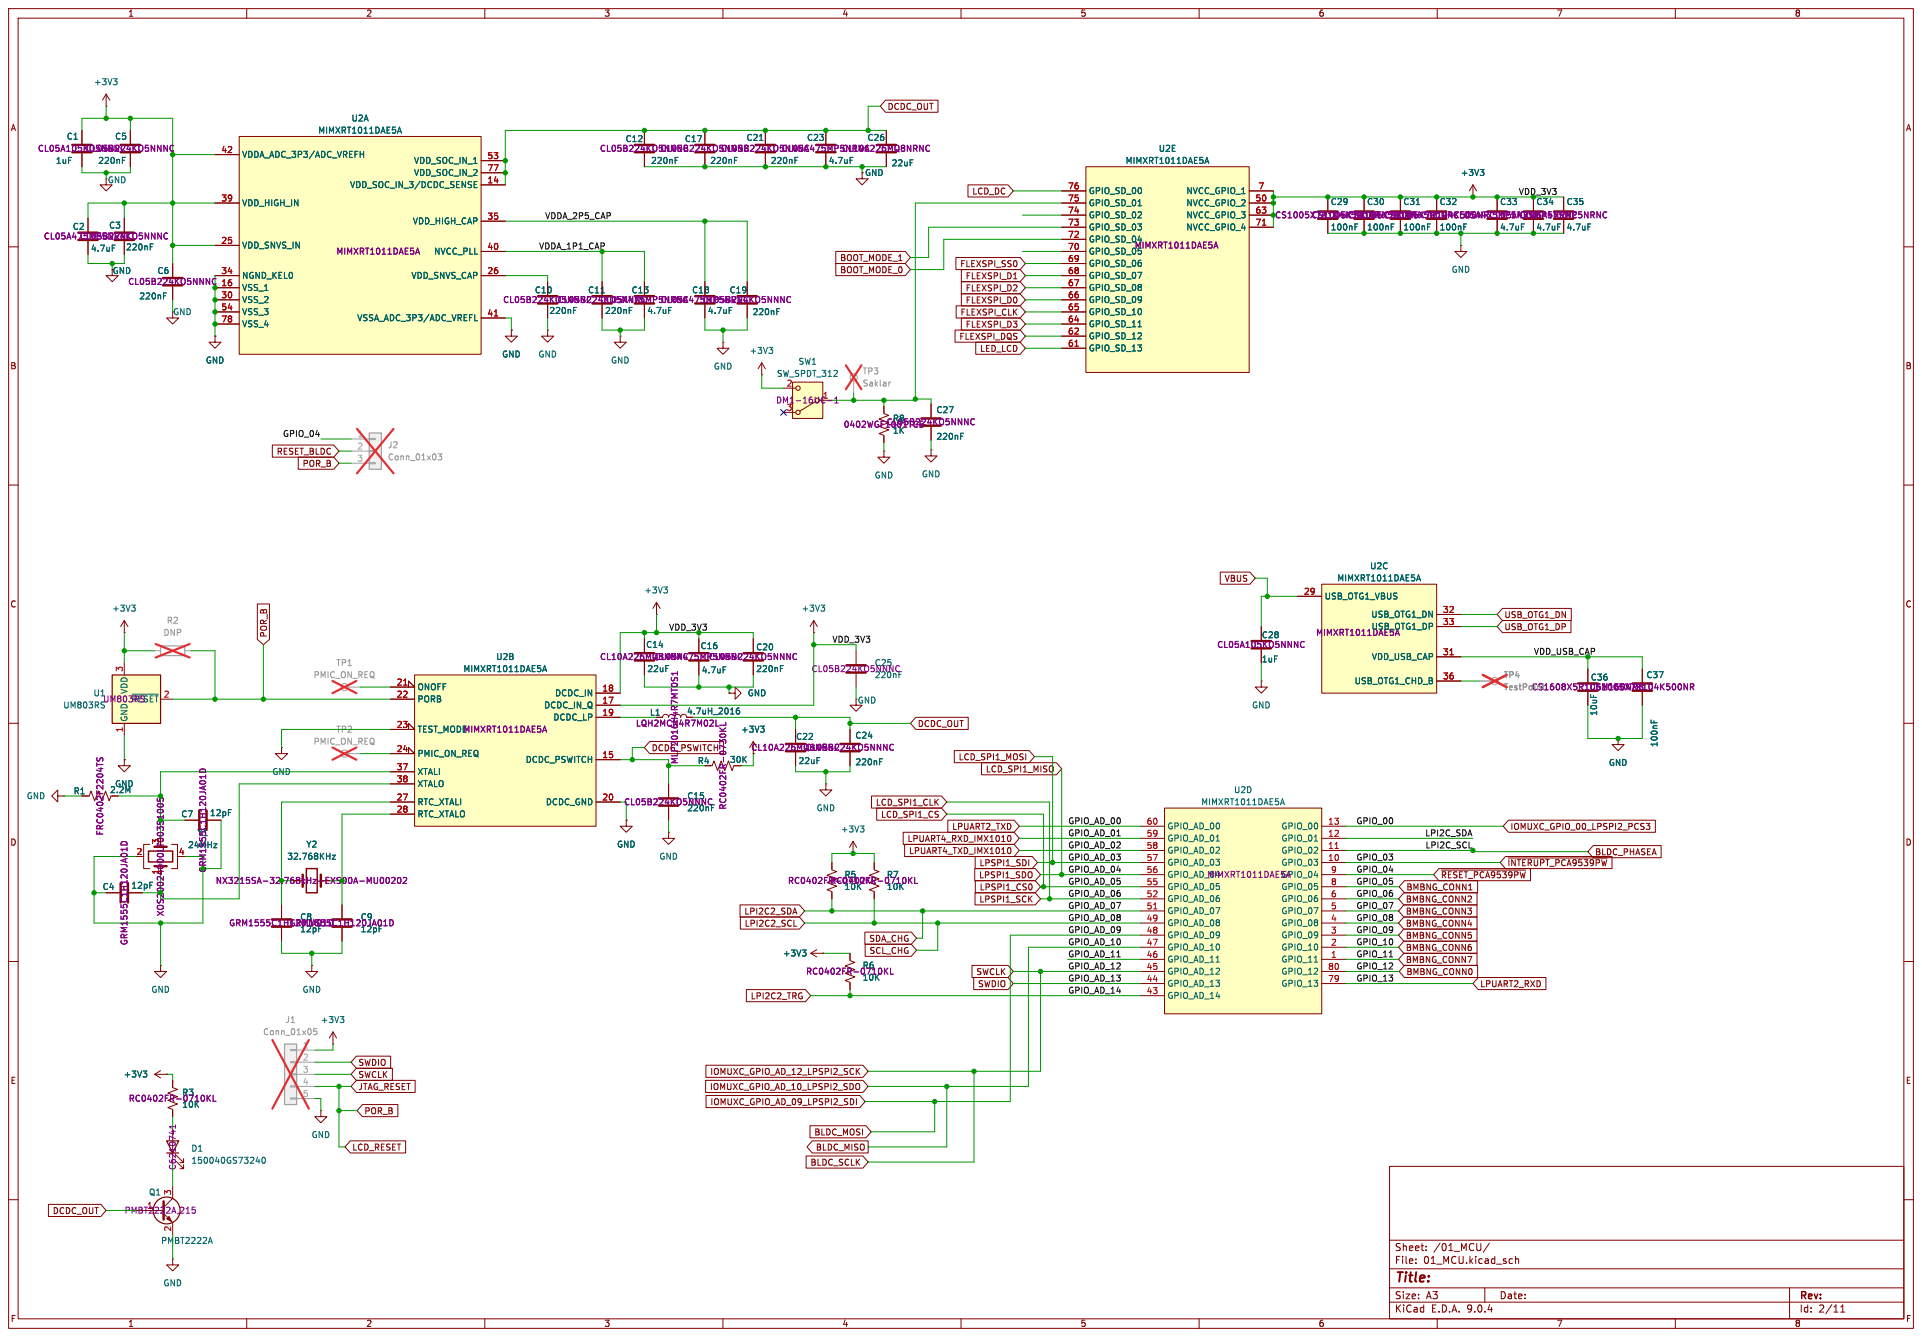
[picture p11: page 2]

Id: 2/11 Title: File: 01_MCU.kicad_sch Sheet: /01_MCU/

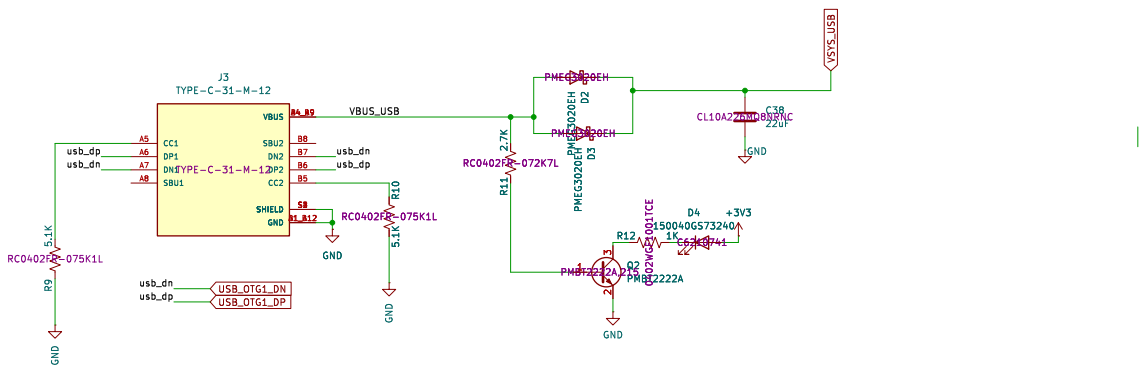
[picture p12: page 3]

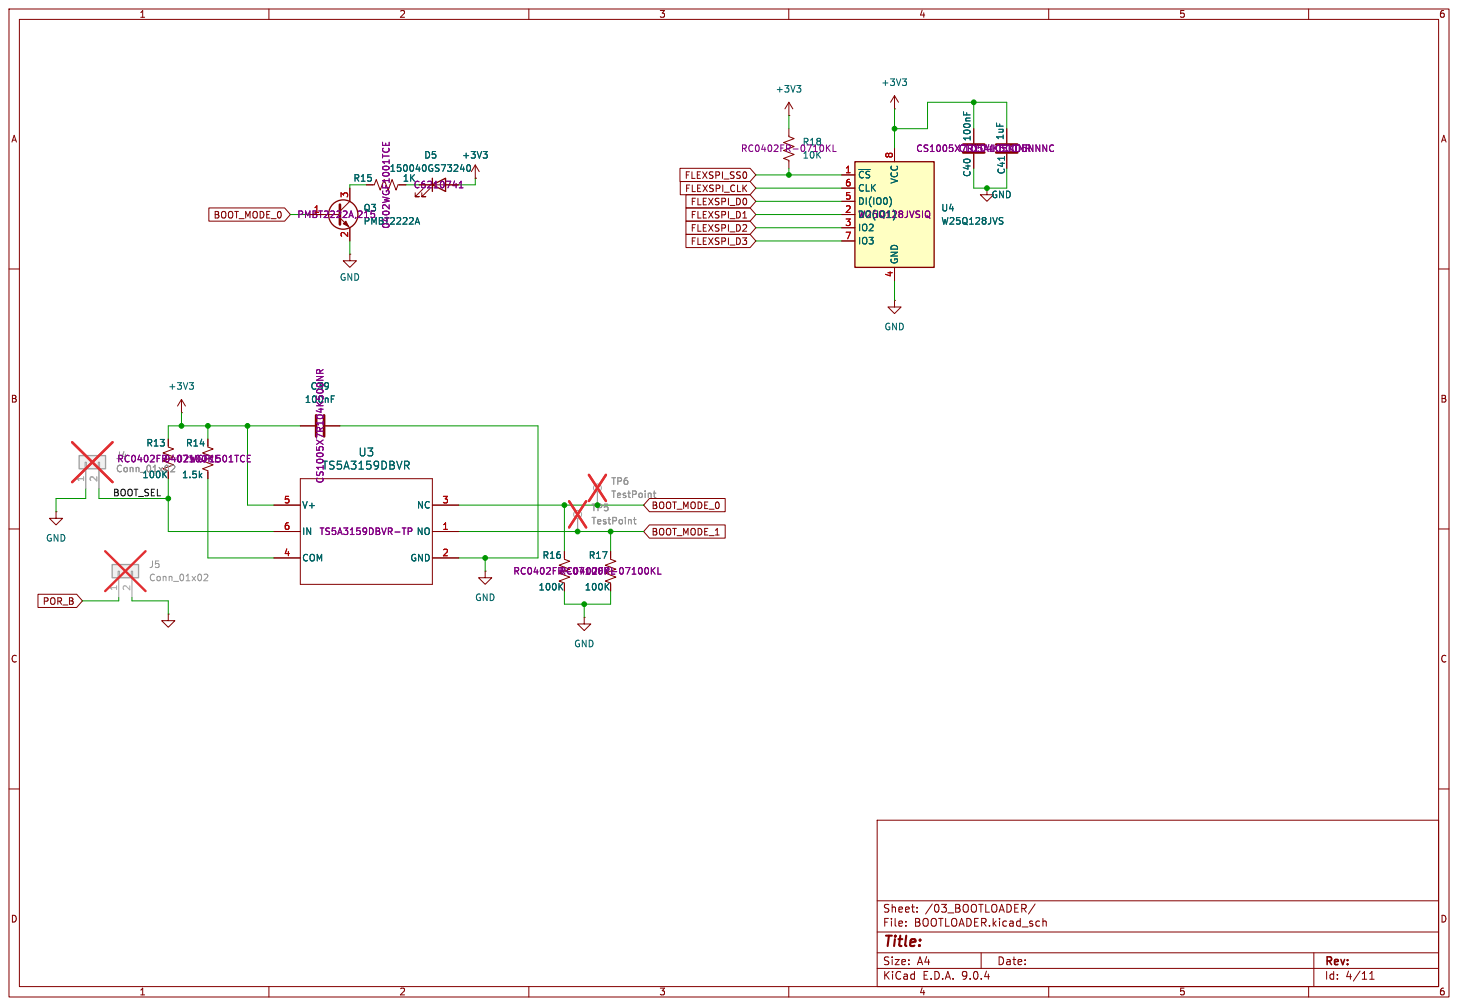
[picture p13: page 4]

Id: 4/11 Title: File: BOOTLOADER.kicad_sch Sheet: /03_BOOTLOADER/

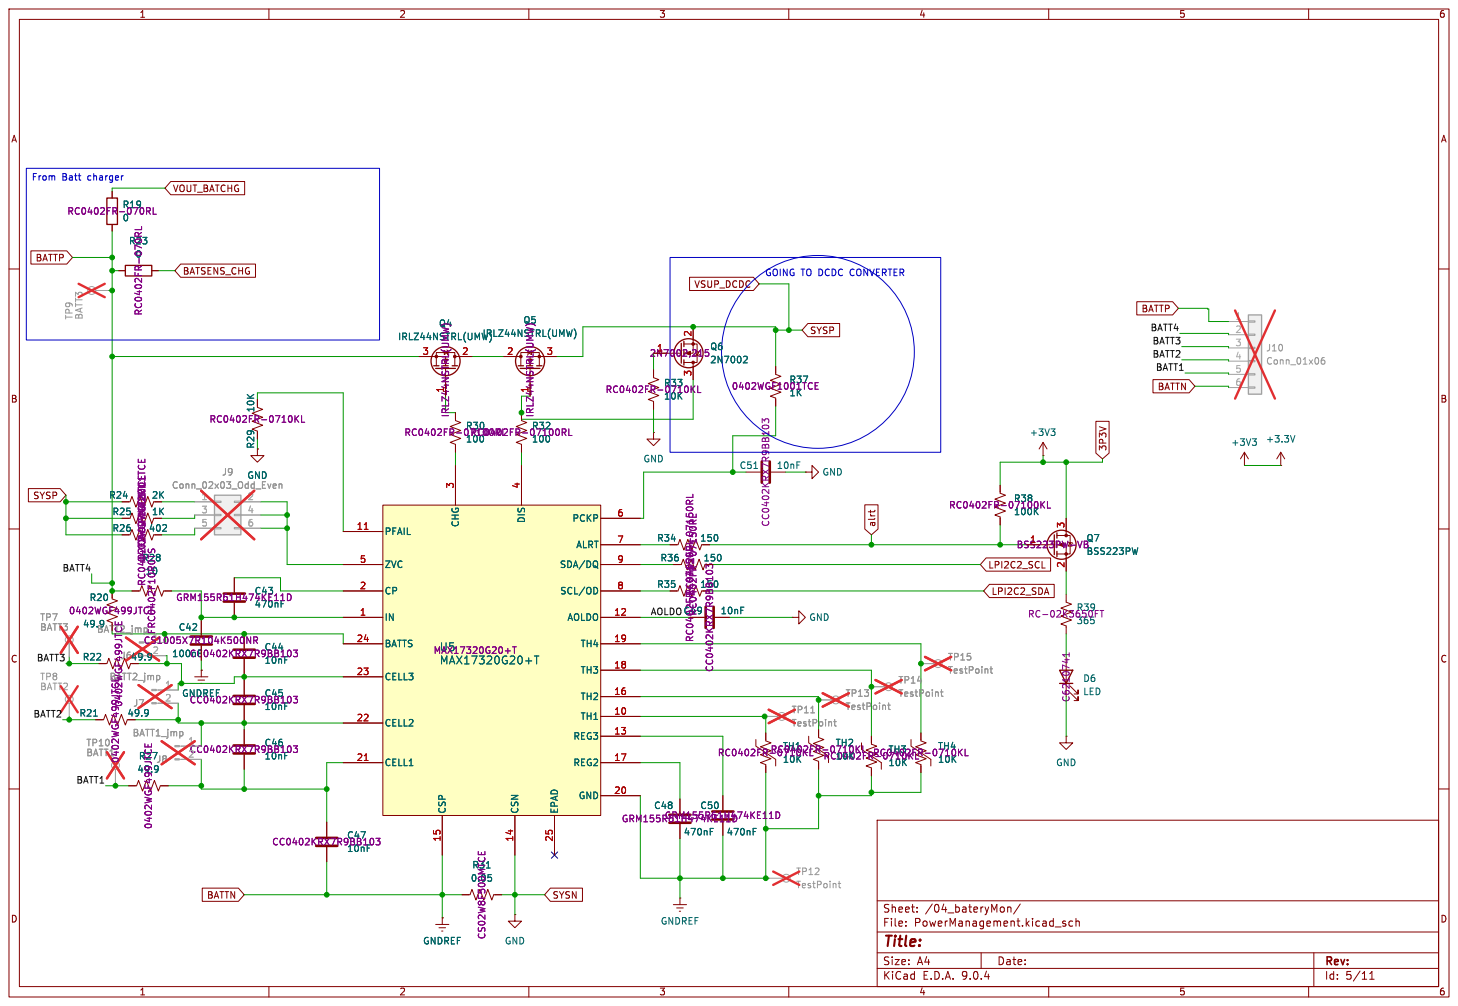
[picture p14: page 5]

4 EPAD 25 ALRT 7 SDA/DQ 9 SCL/OD 8 AOLDO 12 TH4 19 TH3 18 TH2 16 TH1 10 REG3 13 REG2 17 GND 20 PCKP 6 U5 MAX17320G20+T MAX17320G20+T R19

4 EPAD 25 ALRT 7 SDA/DQ 9 SCL/OD 8 AOLDO 12 TH4 19 TH3 18 TH2 16 TH1 10 REG3 13 REG2 17 GND 20 PCKP 6 C45

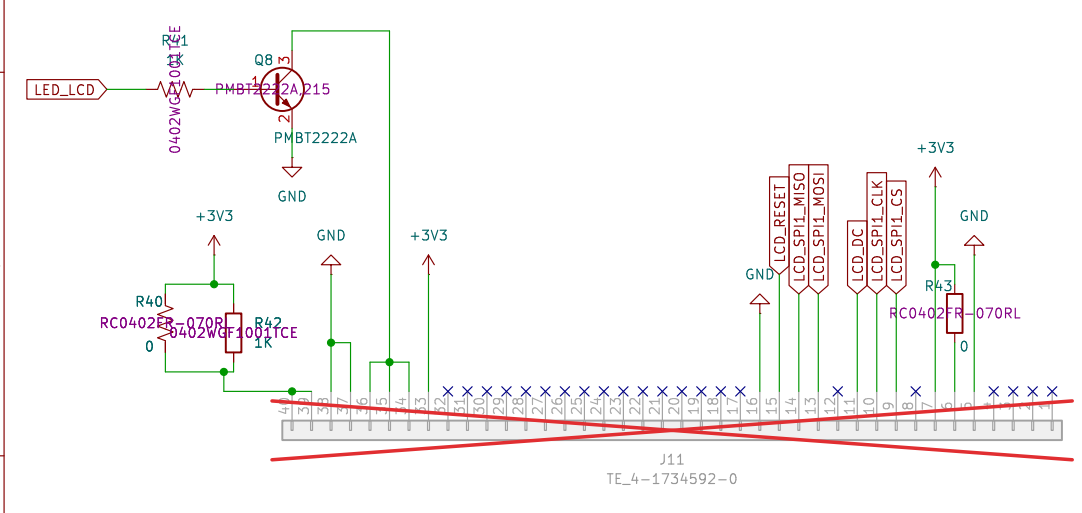
[picture p15: page 6]

Id: 6/11 Title: File: lcd_port.kicad_sch Sheet: /05_LCD_port/

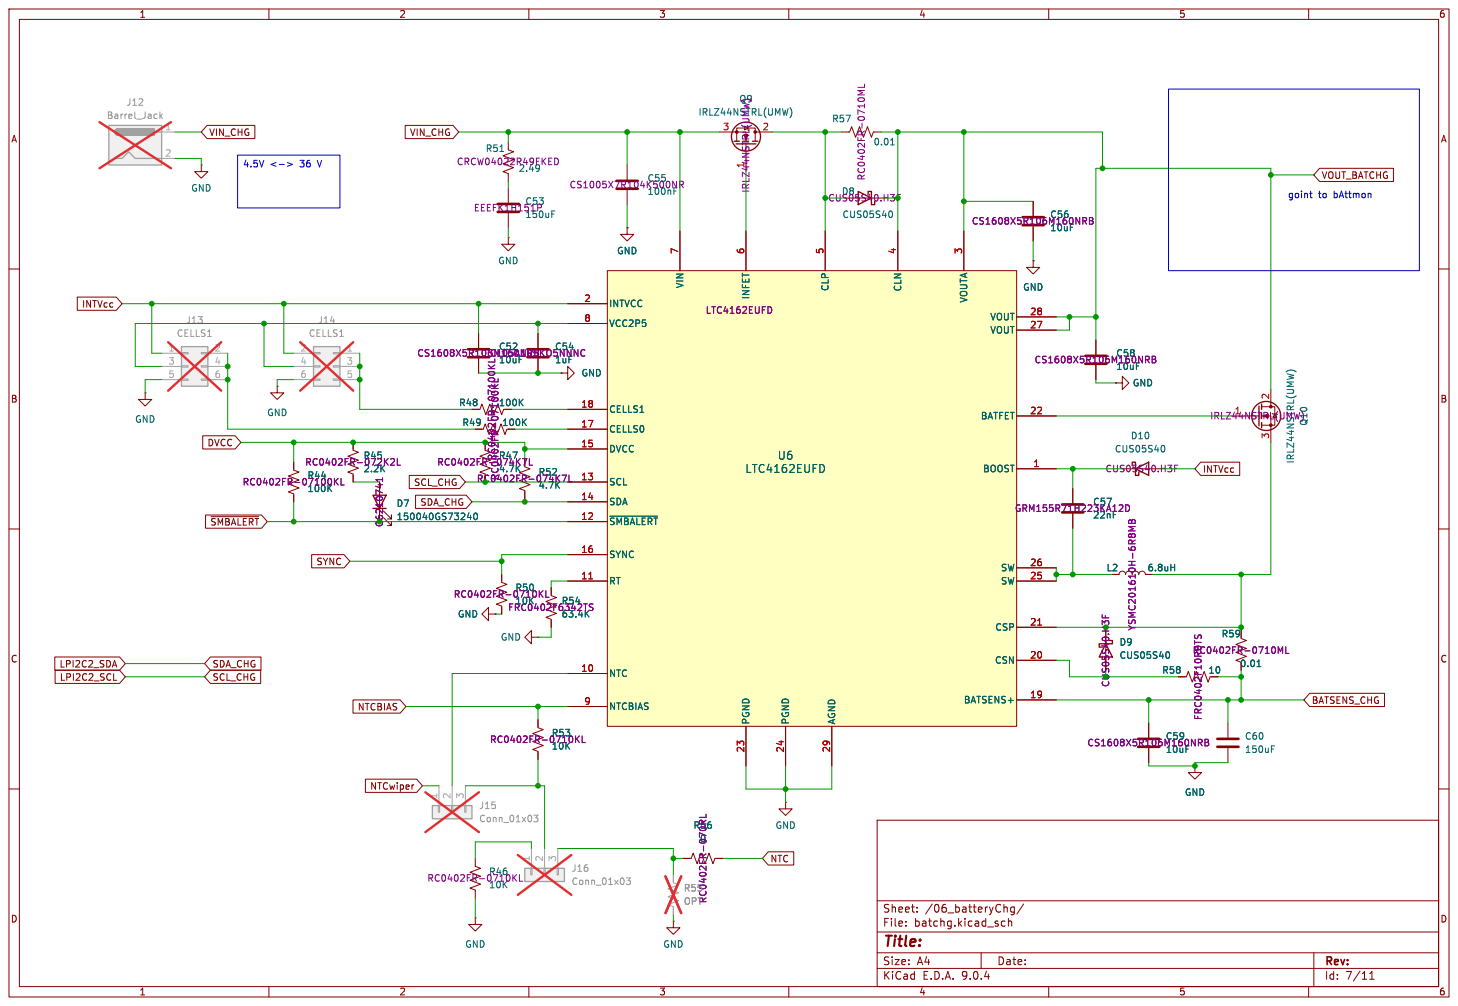
[picture p16: page 7]

3 VOUT 28 VOUT 27 BATFET 22 BOOST 1 SW 26 SW 25 CSP 21 CSN 20 BATSENS+ 19 ~{SMBALERT} 12 C56

3 VOUT 28 VOUT 27 BATFET 22 BOOST 1 SW 26 SW 25 CSP 21 CSN 20 BATSENS+ 19 ~{SMBALERT} 12 U6

Id: 7/11 Title: File: batchg.kicad_sch Sheet: /06_batteryChg/

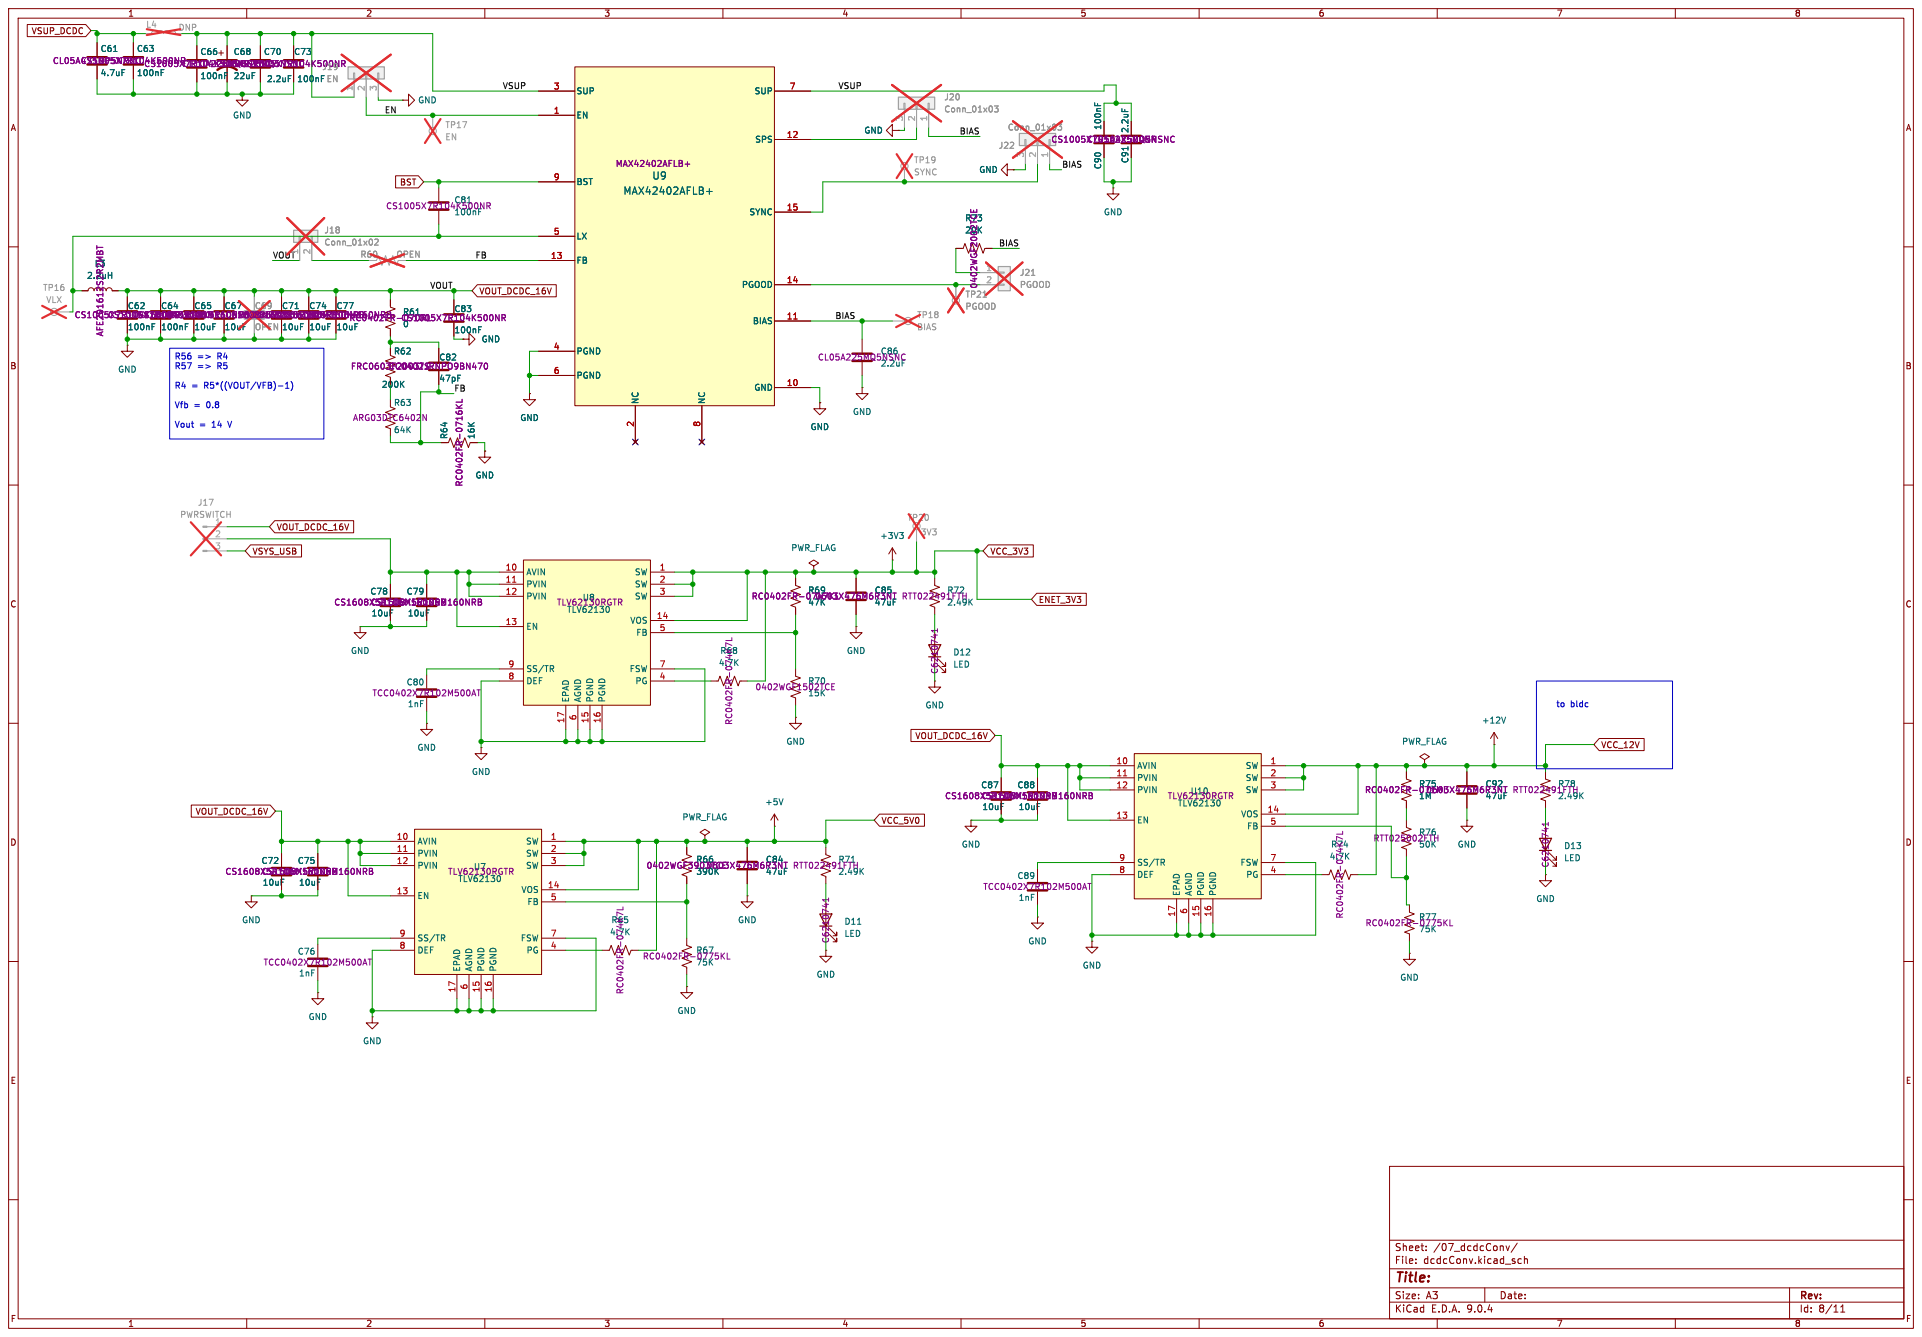
[picture p17: page 8]

8 SUP 7 SPS 12 SYNC 15 PGOOD 14 BIAS 11 GND 10 U9 MAX42402AFLB+ MAX42402AFLB+ GND

8 SUP 7 SPS 12 SYNC 15 PGOOD 14 BIAS 11 GND 10 GND

VOUT R56 => R4 R57 => R5 R4 = R5*((VOUT/VFB)-1) Vfb = 0.8 Vout = 14 V

6 PGND 15 PGND 16 SW 1 SW 2 SW 3 VOS 14 FB 5 FSW 7 PG 4 U8 TLV62130 TLV62130RGTR GND

6 PGND 15 PGND 16 SW 1 SW 2 SW 3 VOS 14 FB 5 FSW 7 PG 4 U10 TLV62130 TLV62130RGTR

6 PGND 15 PGND 16 SW 1 SW 2 SW 3 VOS 14 FB 5 FSW 7 PG 4 U7 TLV62130 TLV62130RGTR GND

Id: 8/11 Title: File: dcdcConv.kicad_sch Sheet: /07_dcdcConv/ GND

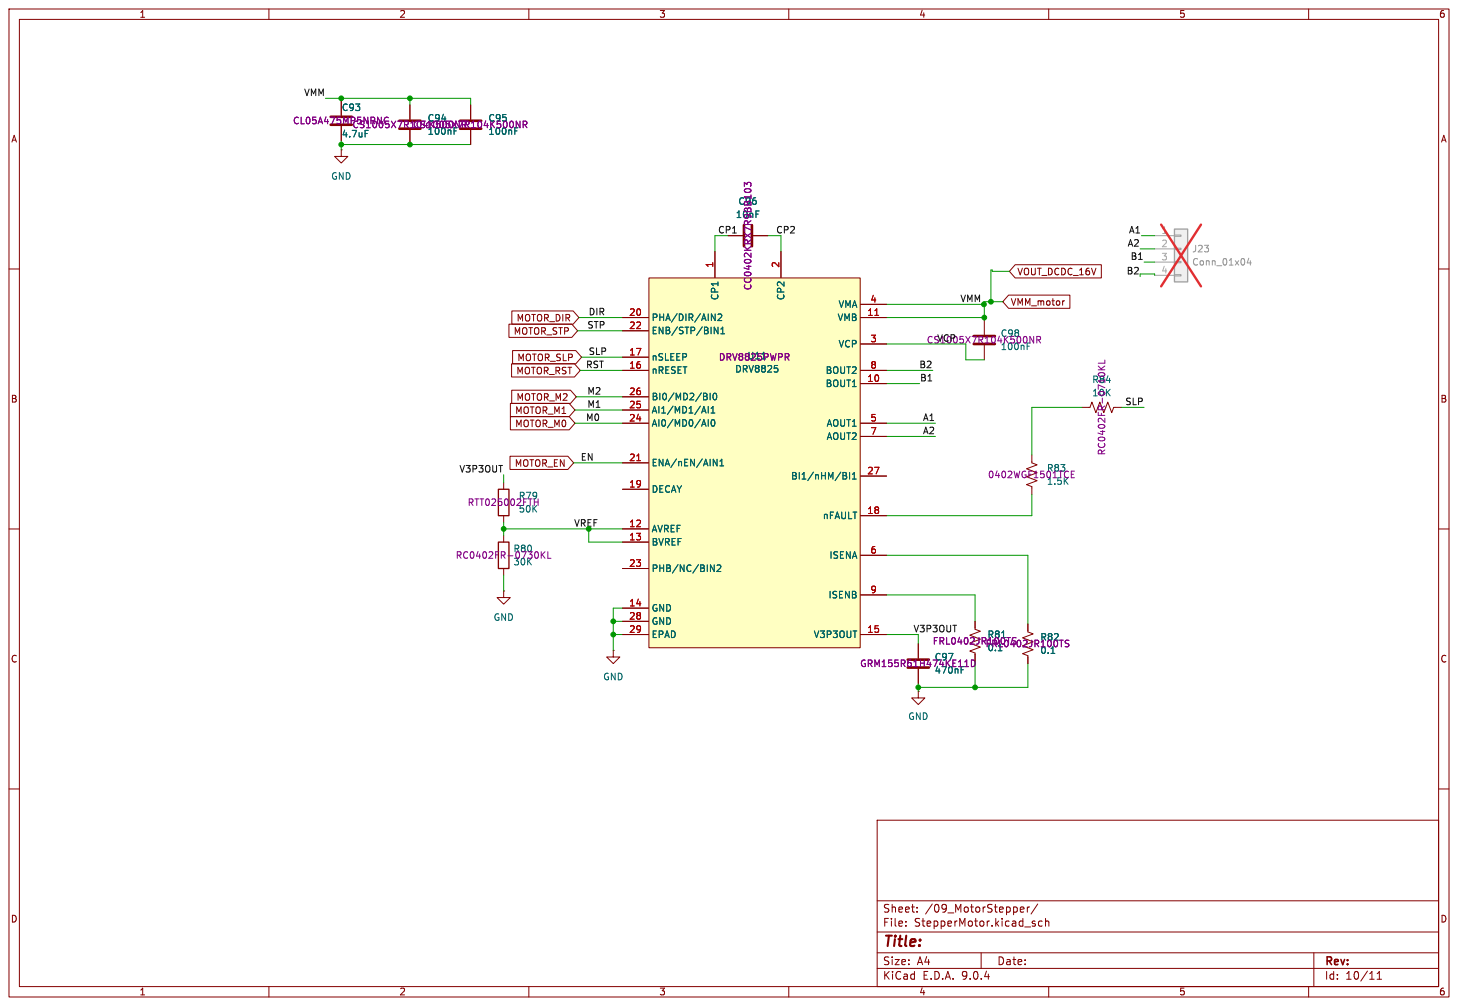
[picture p18: page 9]

2 VMA 4 VMB 11 VCP 3 BOUT2 8 BOUT1 10 AOUT1 5 AOUT2 7 BI1/nHM/BI1 27

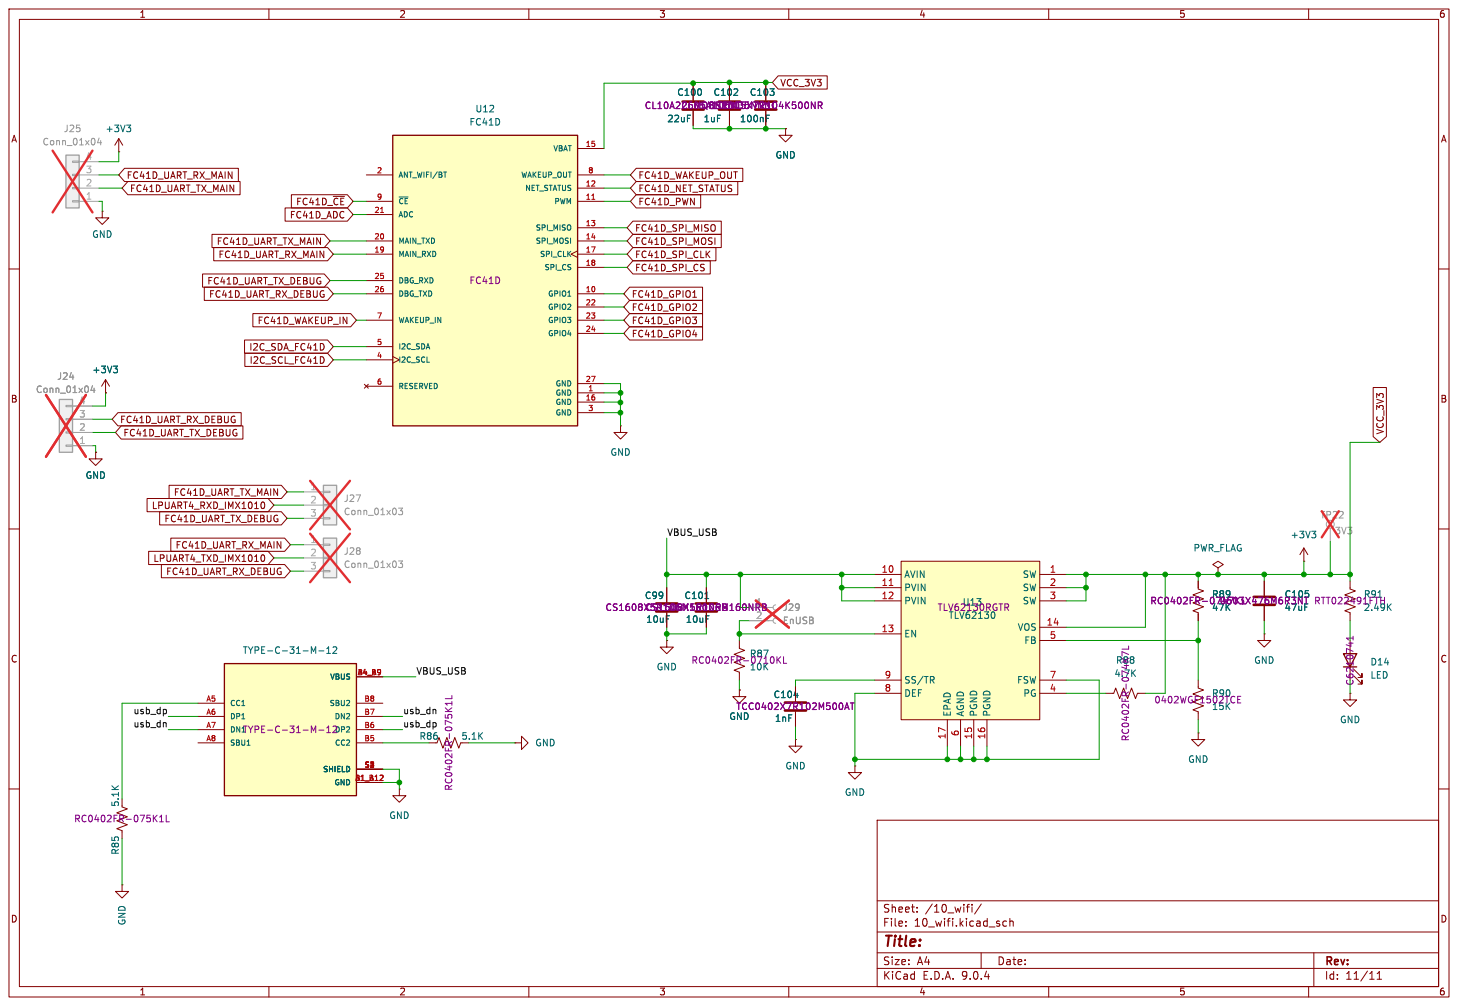
[picture p19: page 10]

Id: 11/11 Title: File: 10_wifi.kicad_sch Sheet: /10_wifi/ GND

6 PGND 15 PGND 16 SW 1 SW 2 SW 3 VOS 14 FB 5 FSW 7 PG 4 U13 TLV62130 TLV62130RGTR

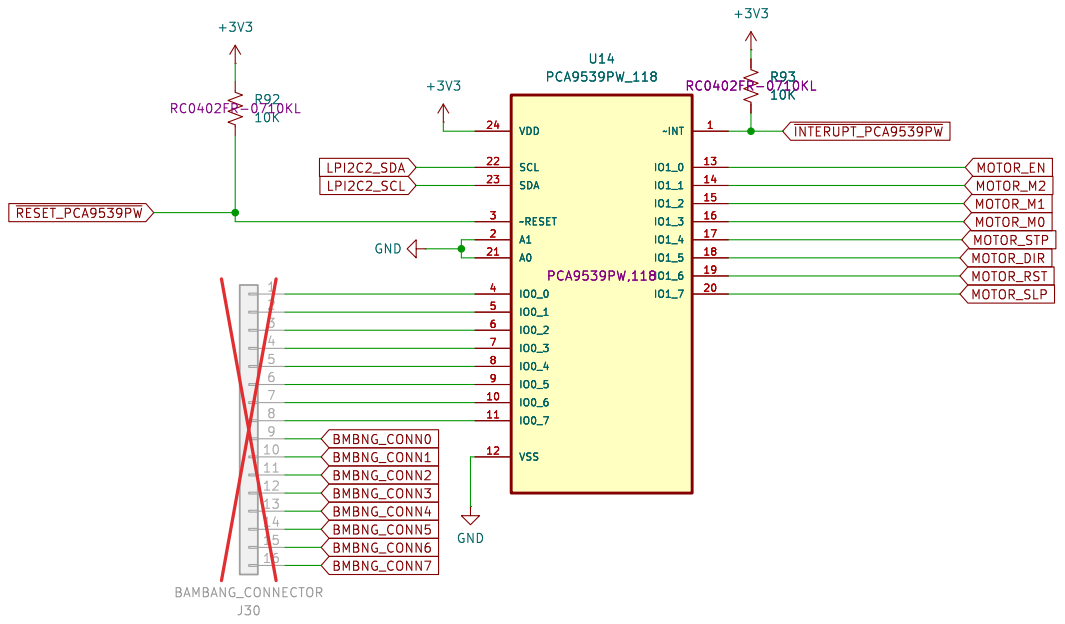
[picture p20: page 11]

Id: 12/11 Title: File: 11_GPIO_Expander.kicad_sch Sheet: /11_GPIO_Expander/
