faoziaziz/qioters/qris_iot.pdf

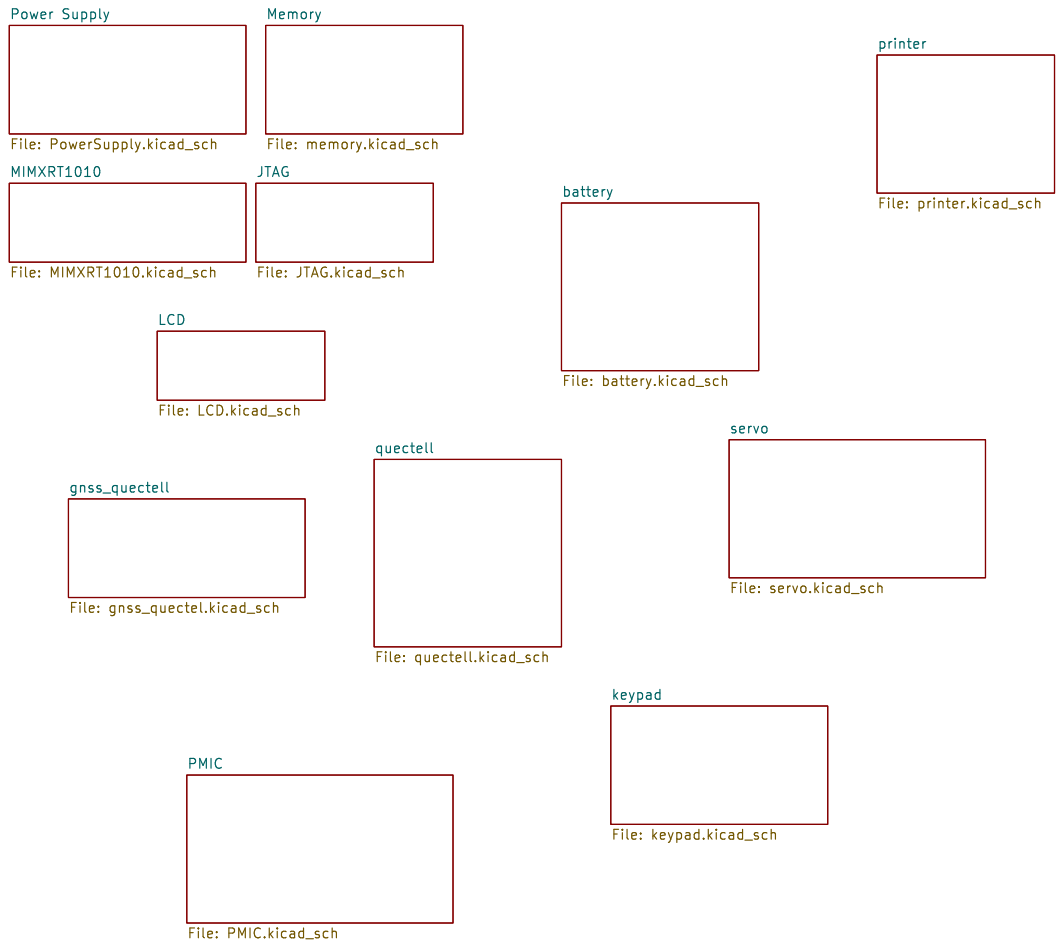
[picture p21: page 1]

servo File: servo.kicad_sch Power Supply File: PowerSupply.kicad_sch

keypad File: keypad.kicad_sch PMIC

Id: 1/13 Title: File: qris_iot.kicad_sch Sheet: /

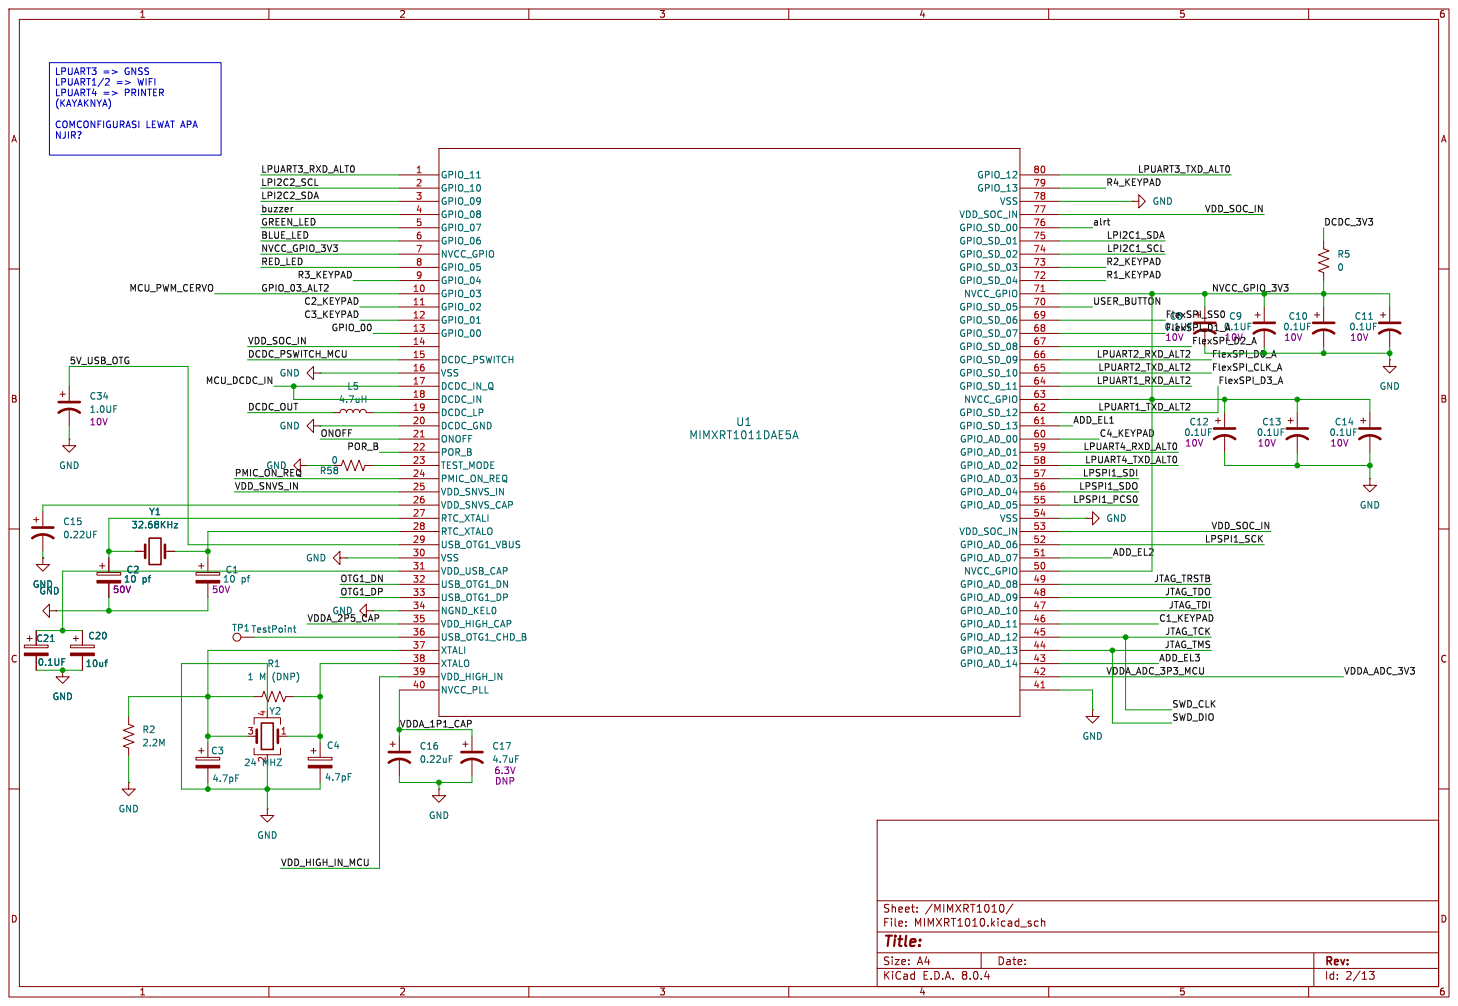
[picture p22: page 2]

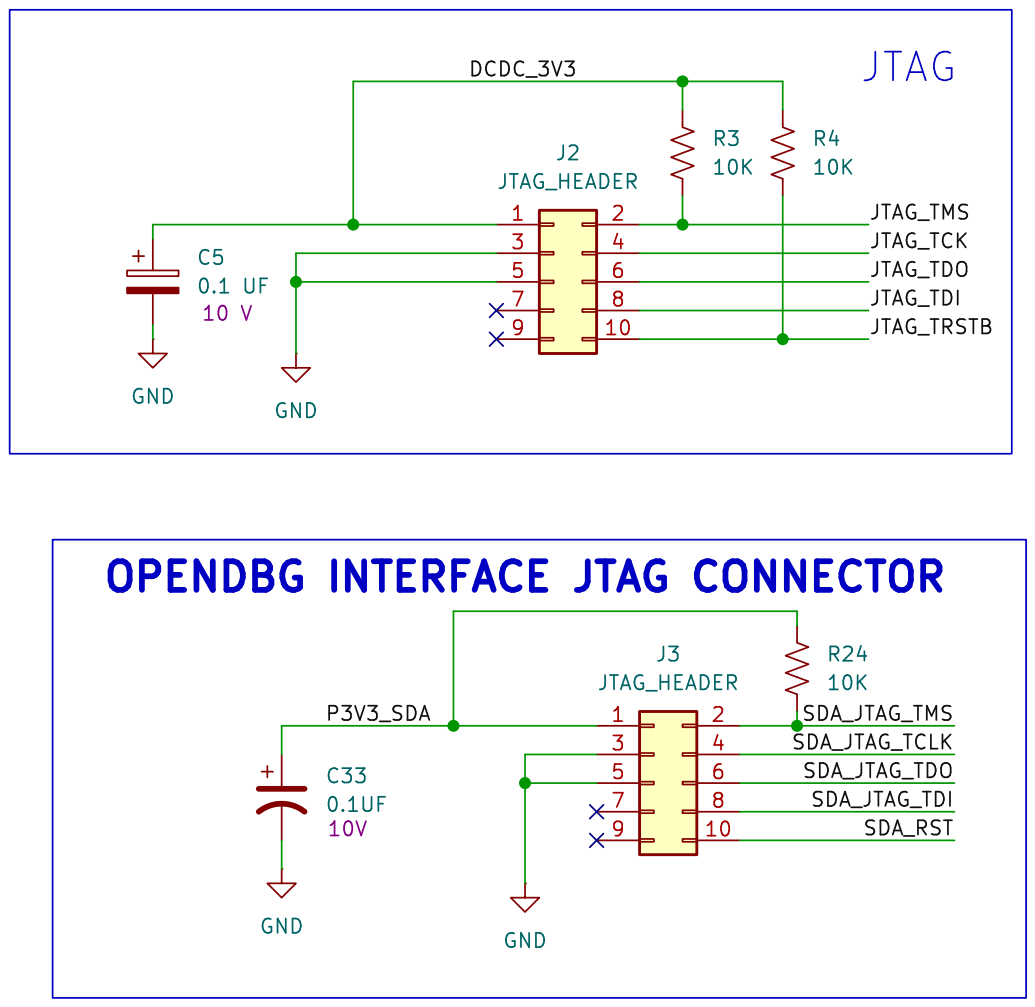
[picture p23: page 3]

Id: 3/13 Title: File: JTAG.kicad_sch Sheet: /JTAG/

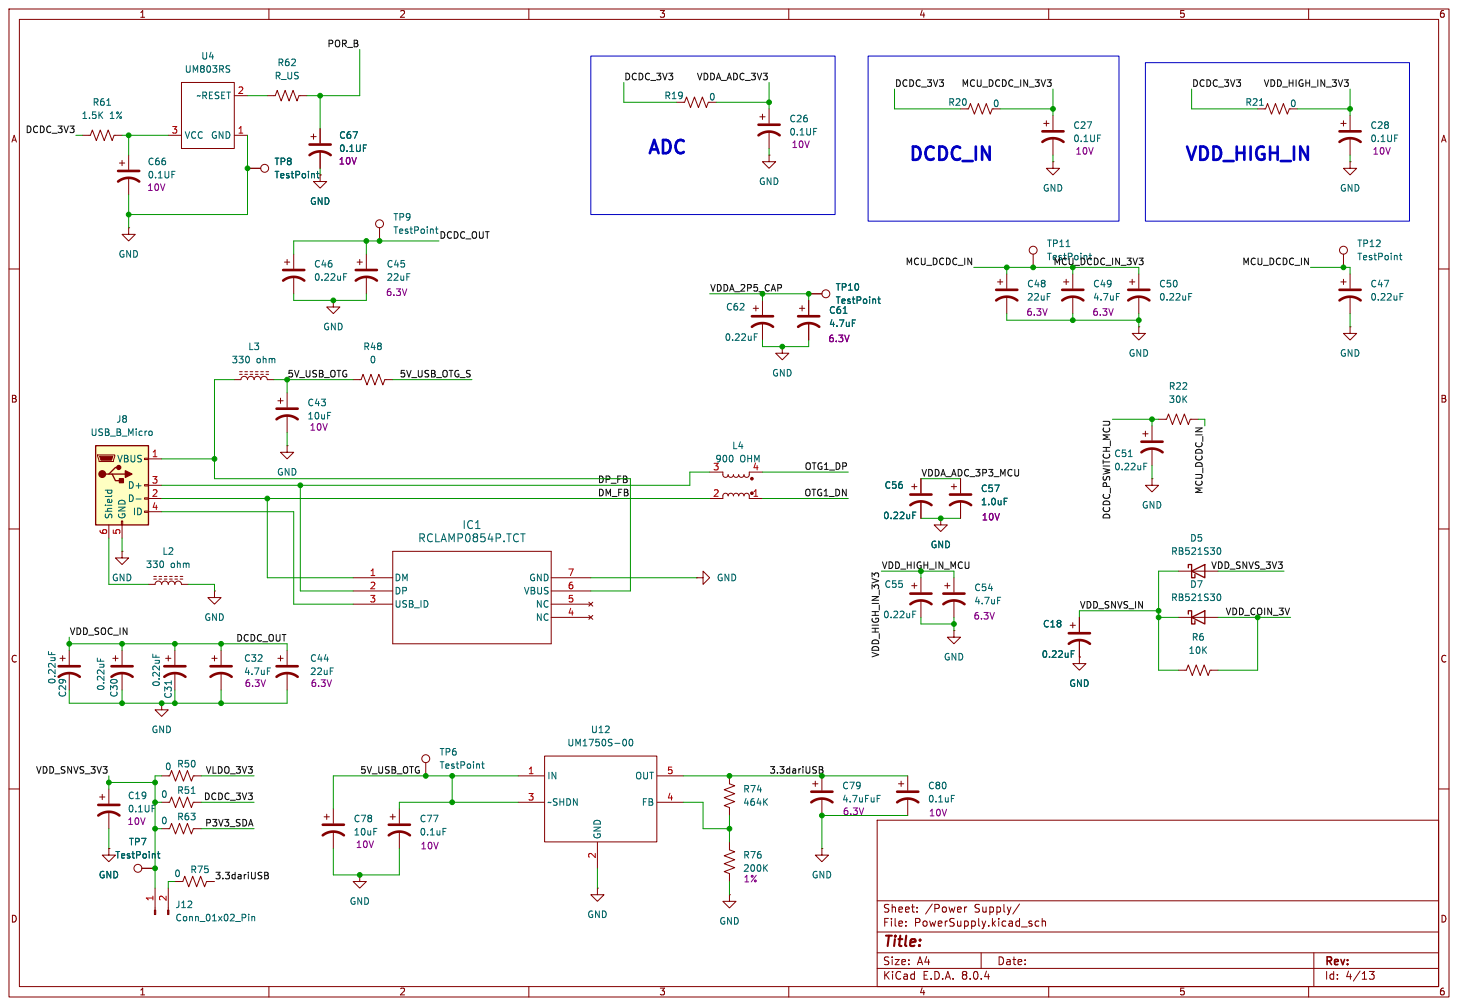
[picture p24: page 4]

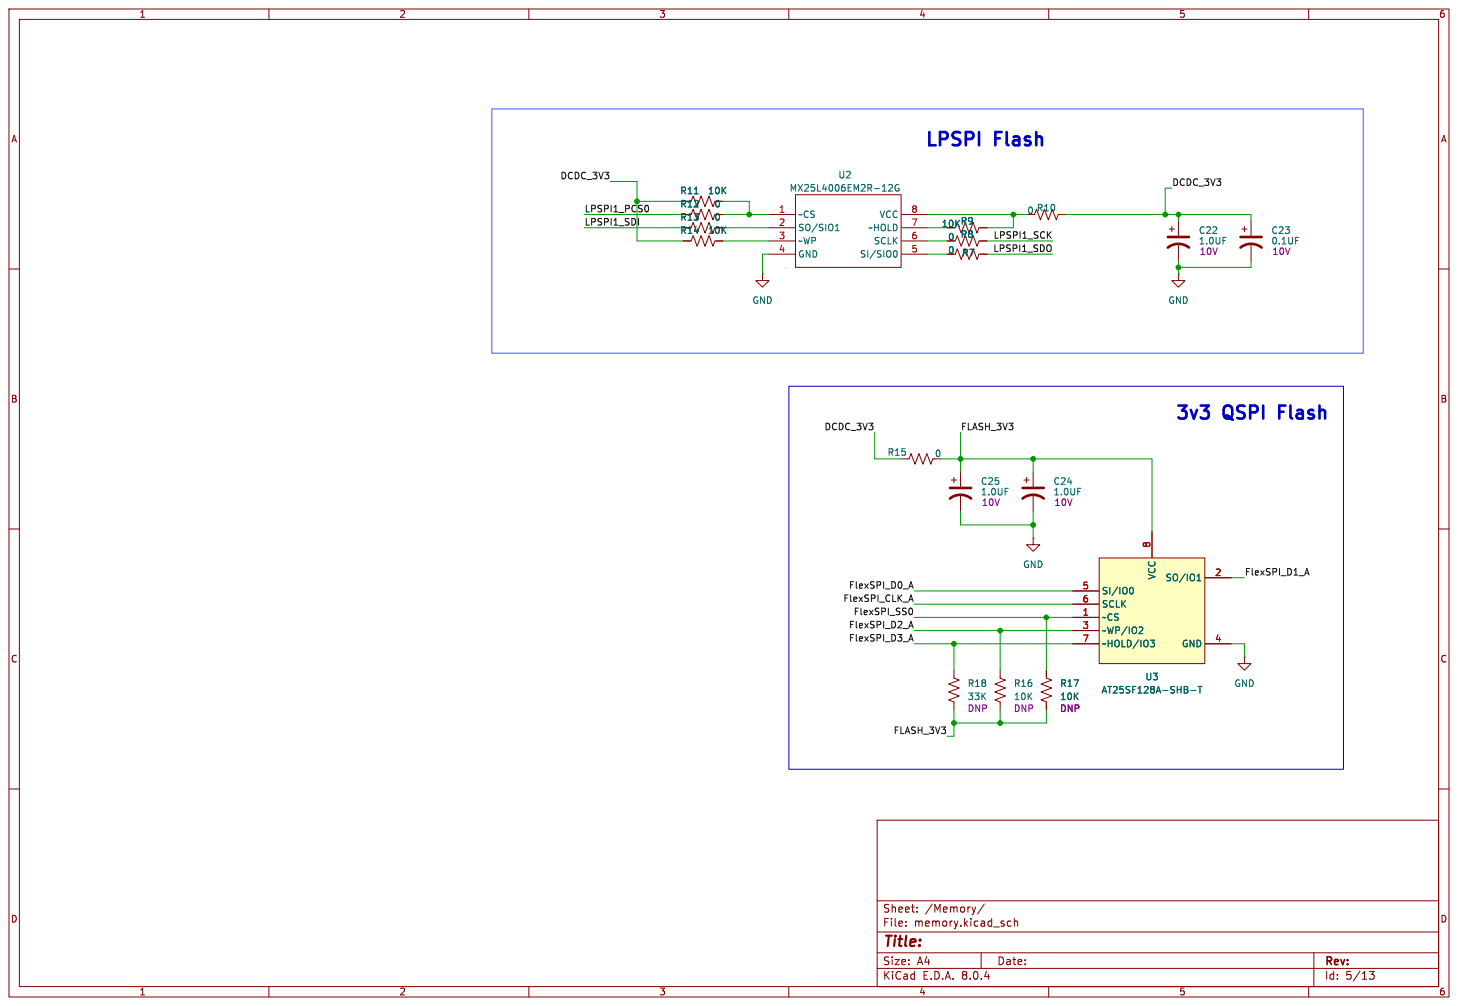
[picture p25: page 5]

Id: 5/13 Title: File: memory.kicad_sch Sheet: /Memory/

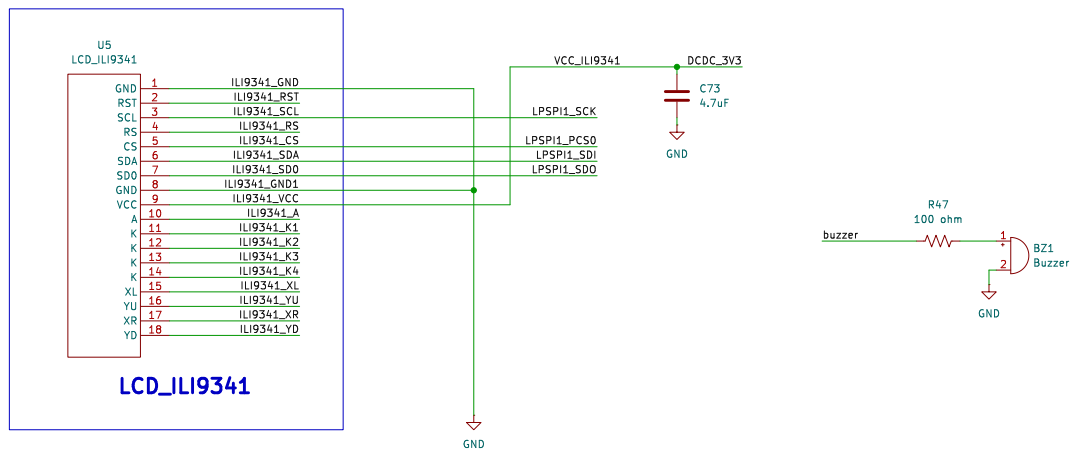
[picture p26: page 6]

ILI9341_RST ILI9341_RS ILI9341_CS ILI9341_SDA ILI9341_GND1

ILI9341_VCC

Id: 6/13 Title: File: LCD.kicad_sch Sheet: /LCD/

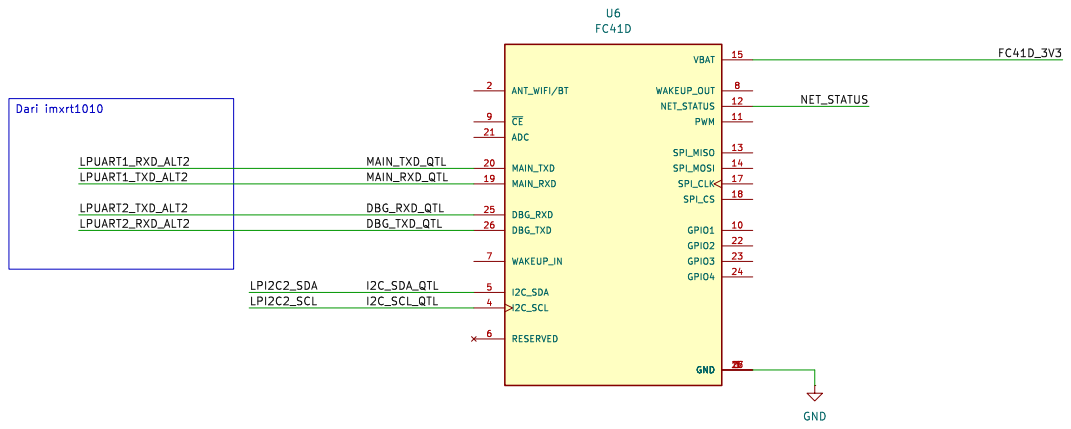
[picture p27: page 7]

Id: 8/13 Title: File: quectell.kicad_sch Sheet: /quectell/

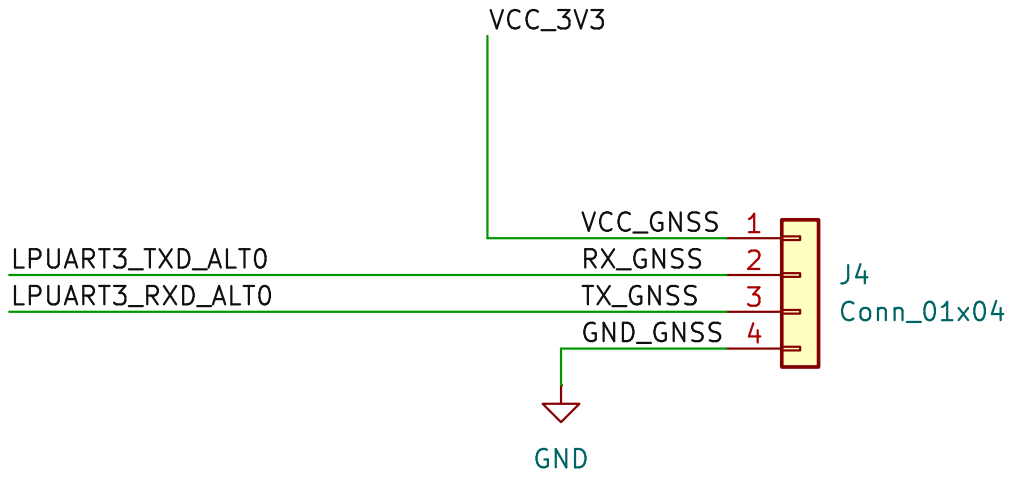
[picture p28: page 8]

Id: 9/13 Title: File: gnss_quectel.kicad_sch Sheet: /gnss_quectell/

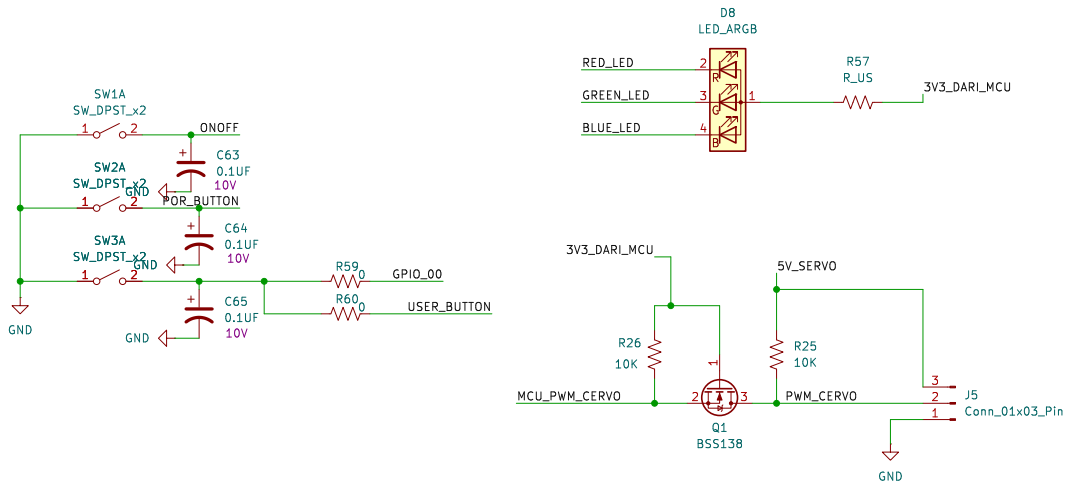
[picture p29: page 9]

Id: 9/13 Title: File: servo.kicad_sch Sheet: /servo/

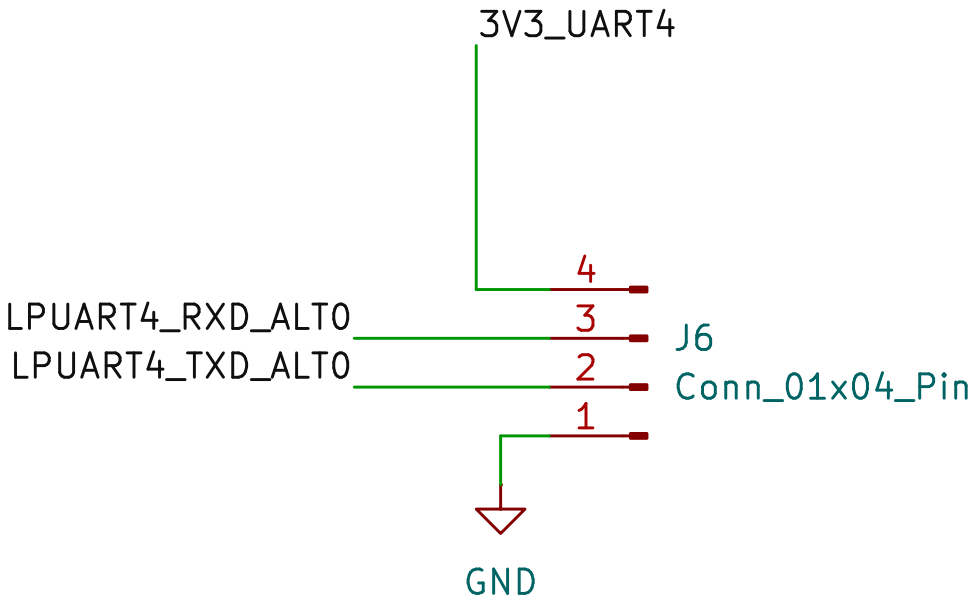
[picture p30: page 10]

Id: 11/13 Title: File: printer.kicad_sch Sheet: /printer/ GND

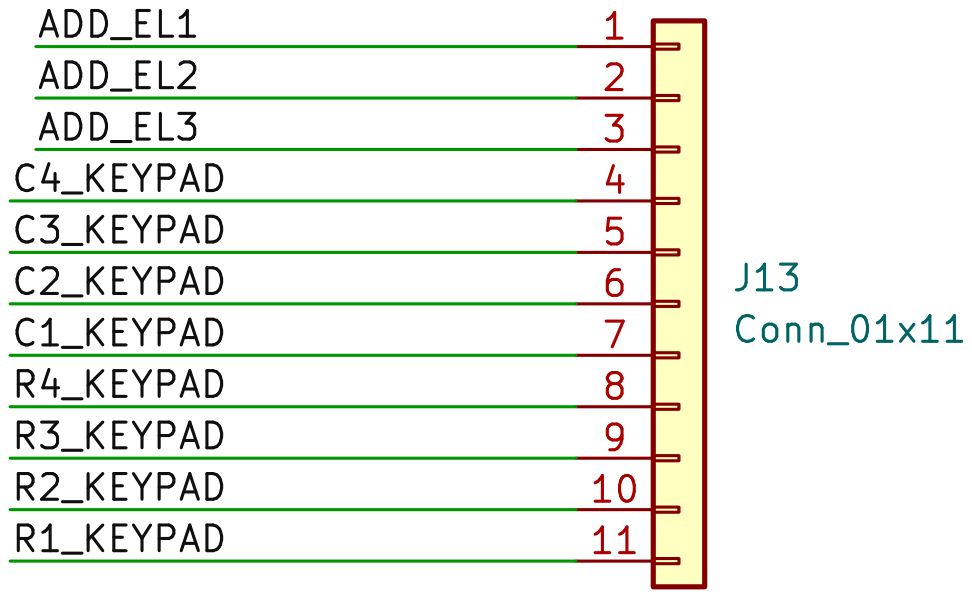
[picture p31: page 11]

Id: 12/13 Title: File: keypad.kicad_sch Sheet: /keypad/

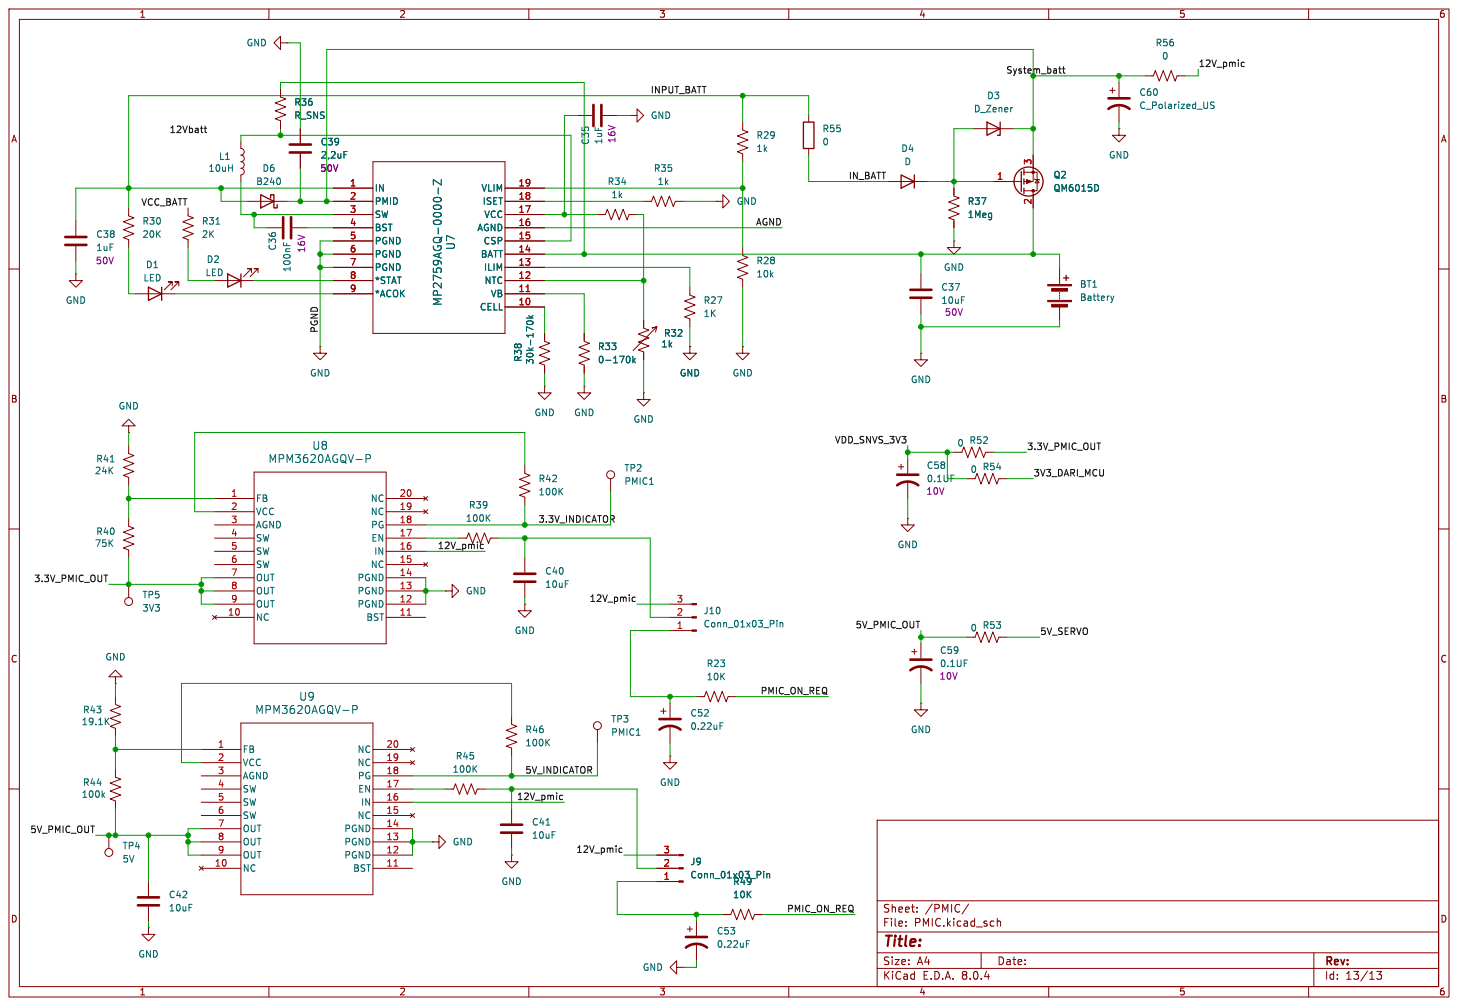
[picture p32: page 12]

Id: 13/13 Title: File: PMIC.kicad_sch Sheet: /PMIC/

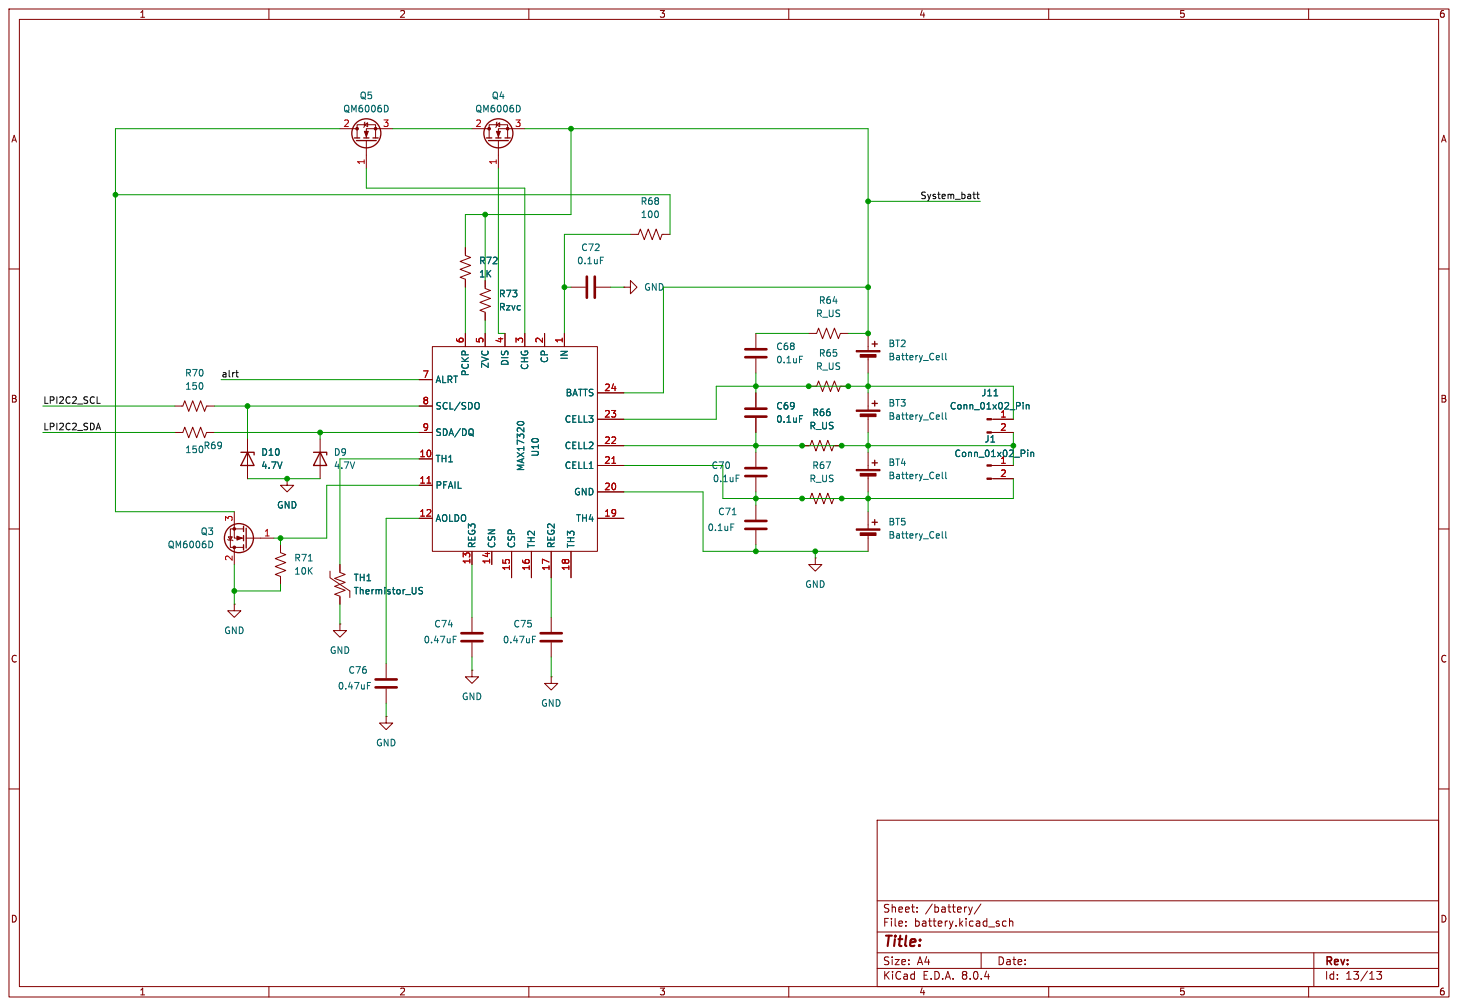
[picture p33: page 13]

6 ALRT 7 SCL/SDO 8 SDA/DQ 9 R73 Rzvc R72

6 ALRT 7 SCL/SDO 8 SDA/DQ 9 U10 MAX17320 R69 150 D10
BT2 Battery_Cell R70

1 TH1 10 PFAIL 11 AOLDO 12 REG3 13 CSN 14 CSP 15 TH2 16 REG2 17 TH3 18 TH4 19 CP
