faoziaziz/qioters/qiot_revBattery/qiot.pdf

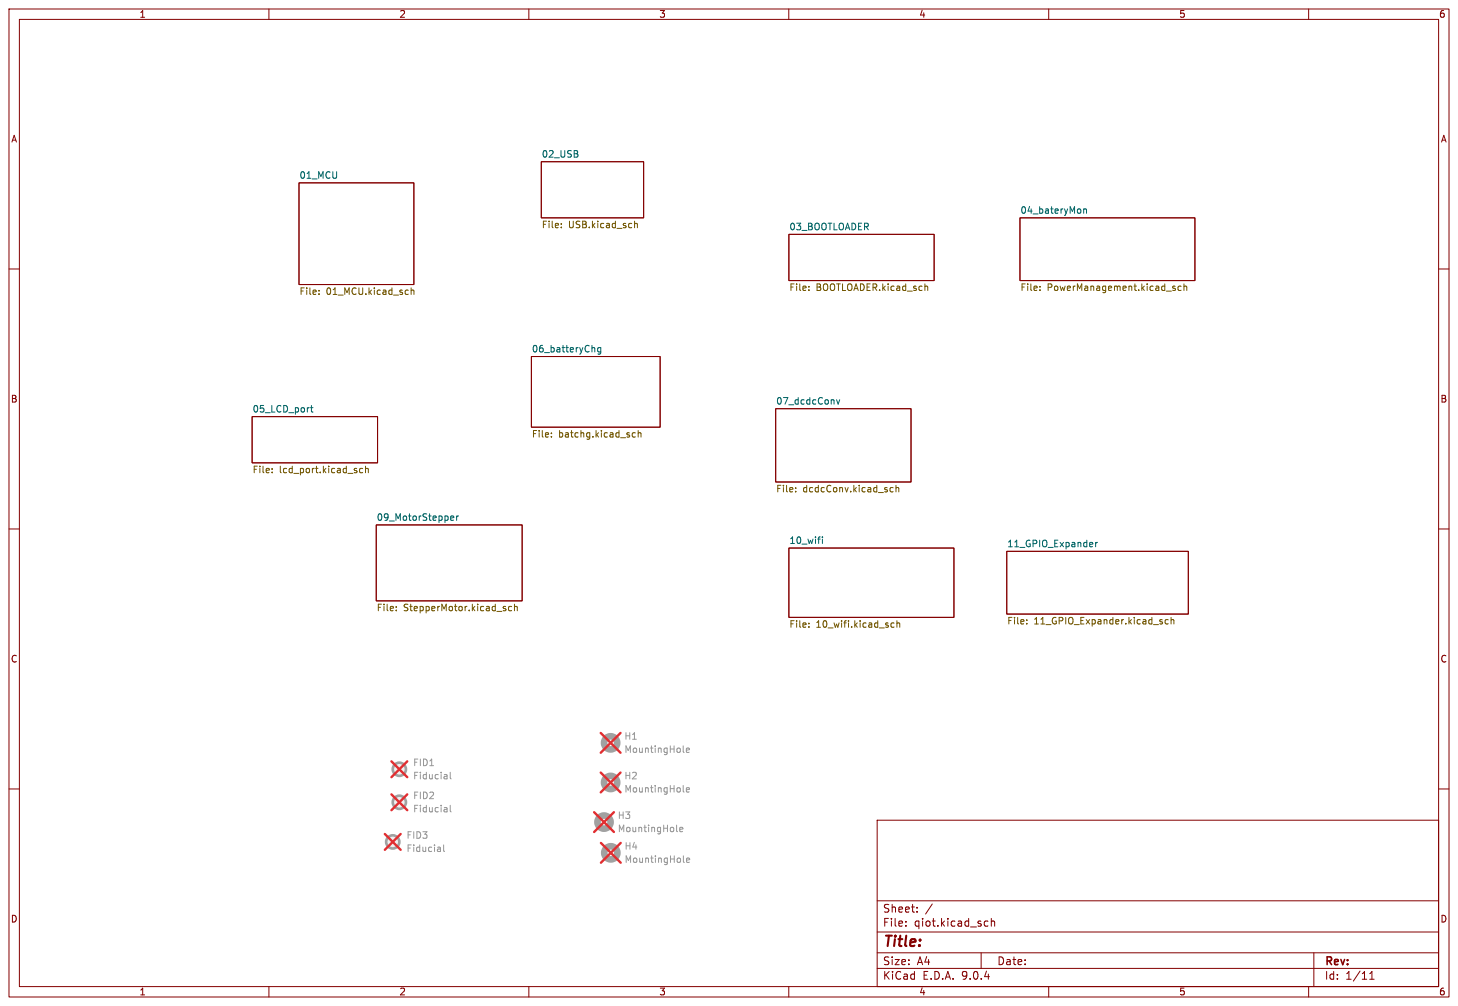
[picture p34: page 1]

Id: 1/11 Title: File: qiot.kicad_sch Sheet: /

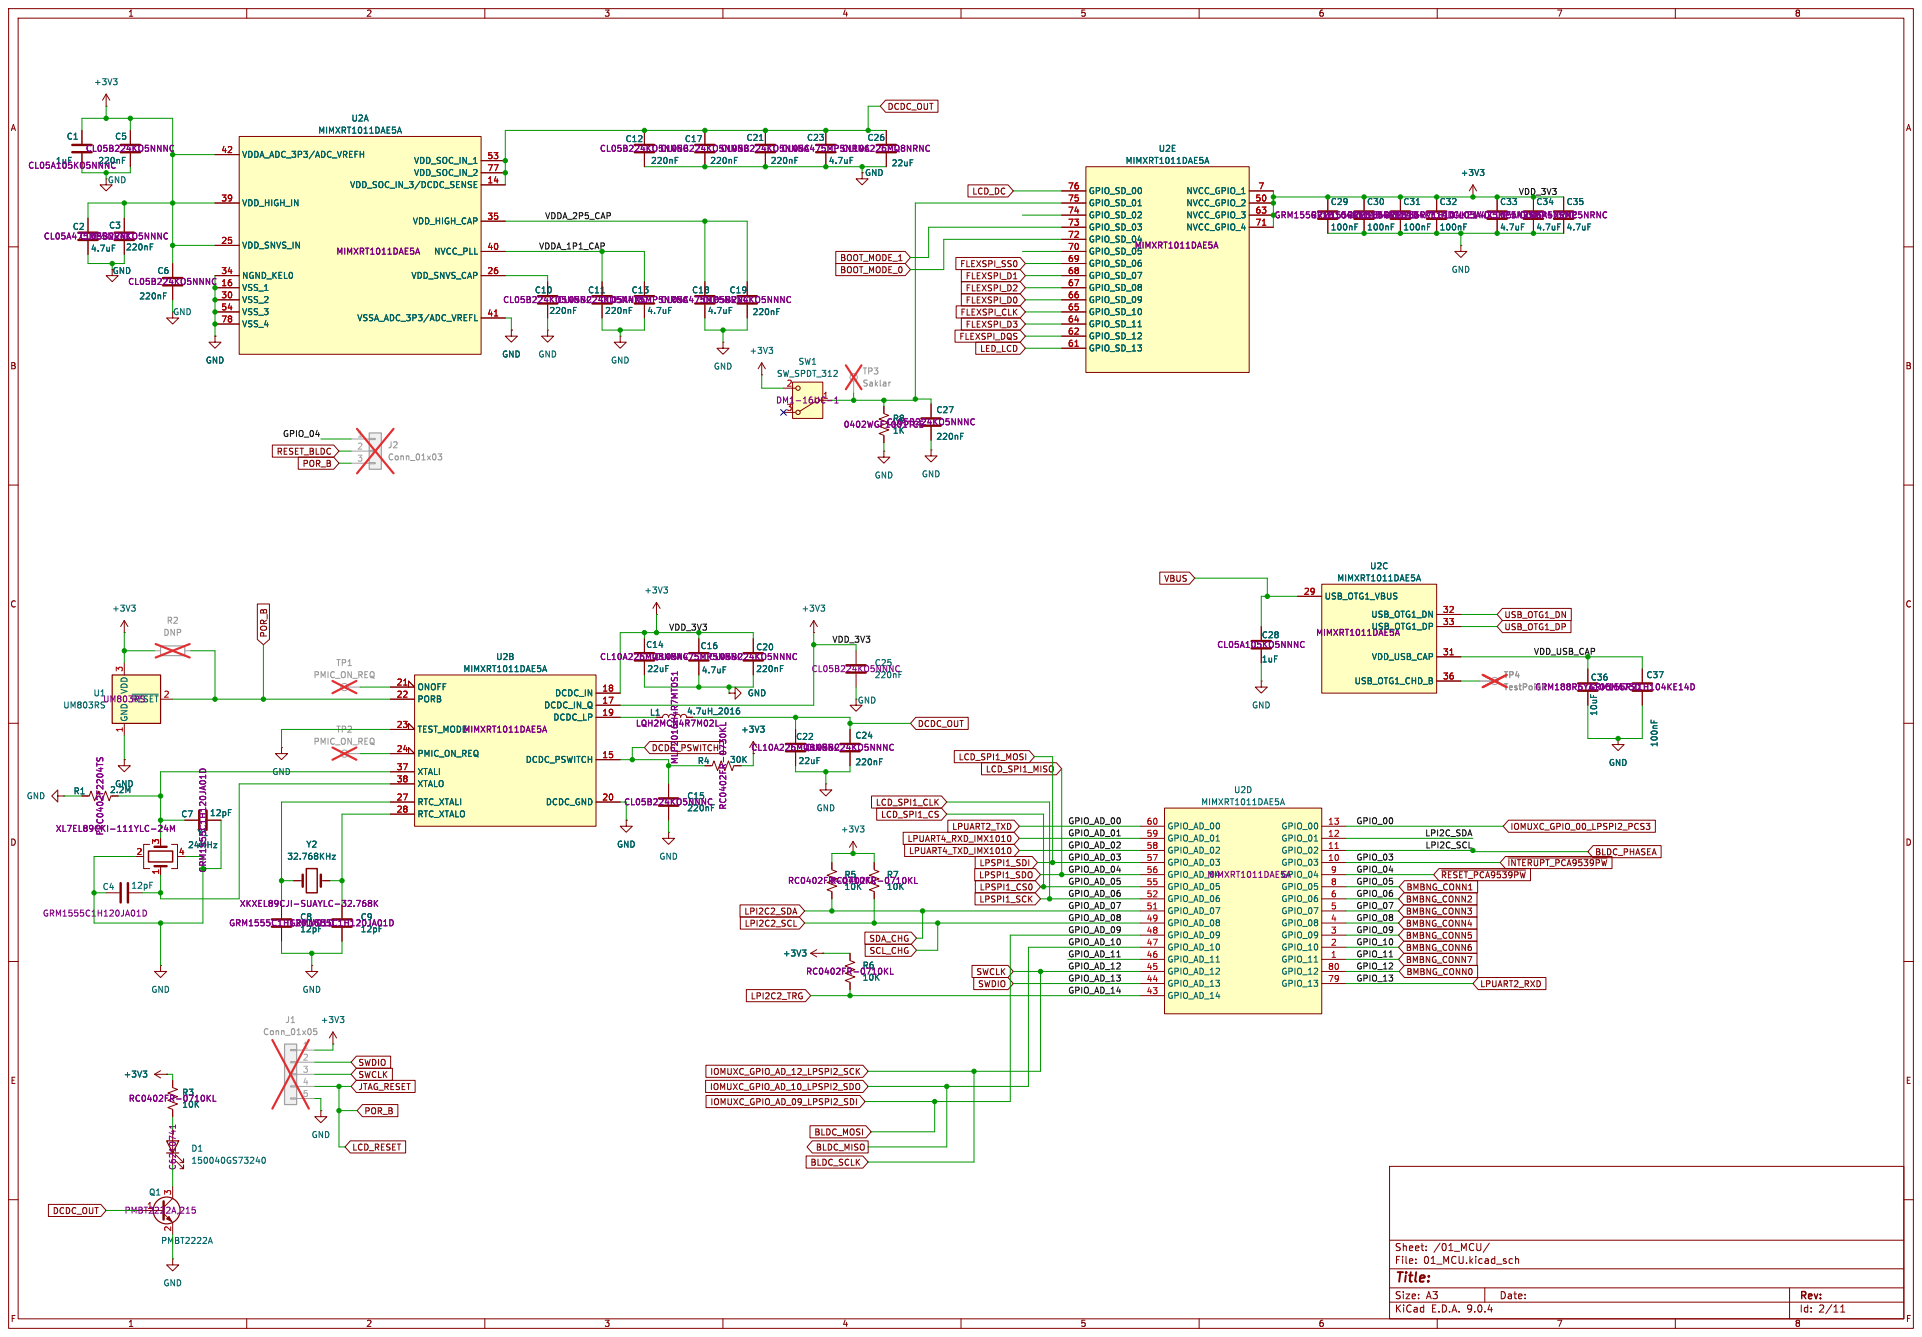
[picture p35: page 2]

Id: 2/11 Title: File: 01_MCU.kicad_sch Sheet: /01_MCU/ GND

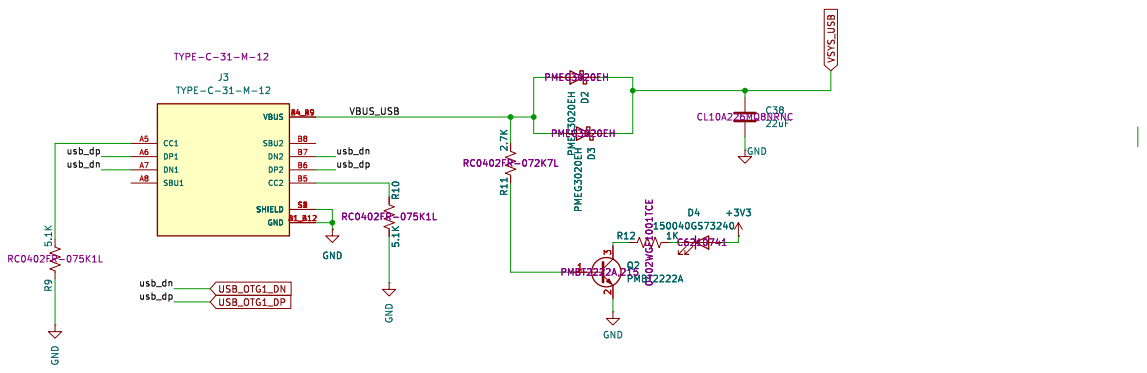
[picture p36: page 3]

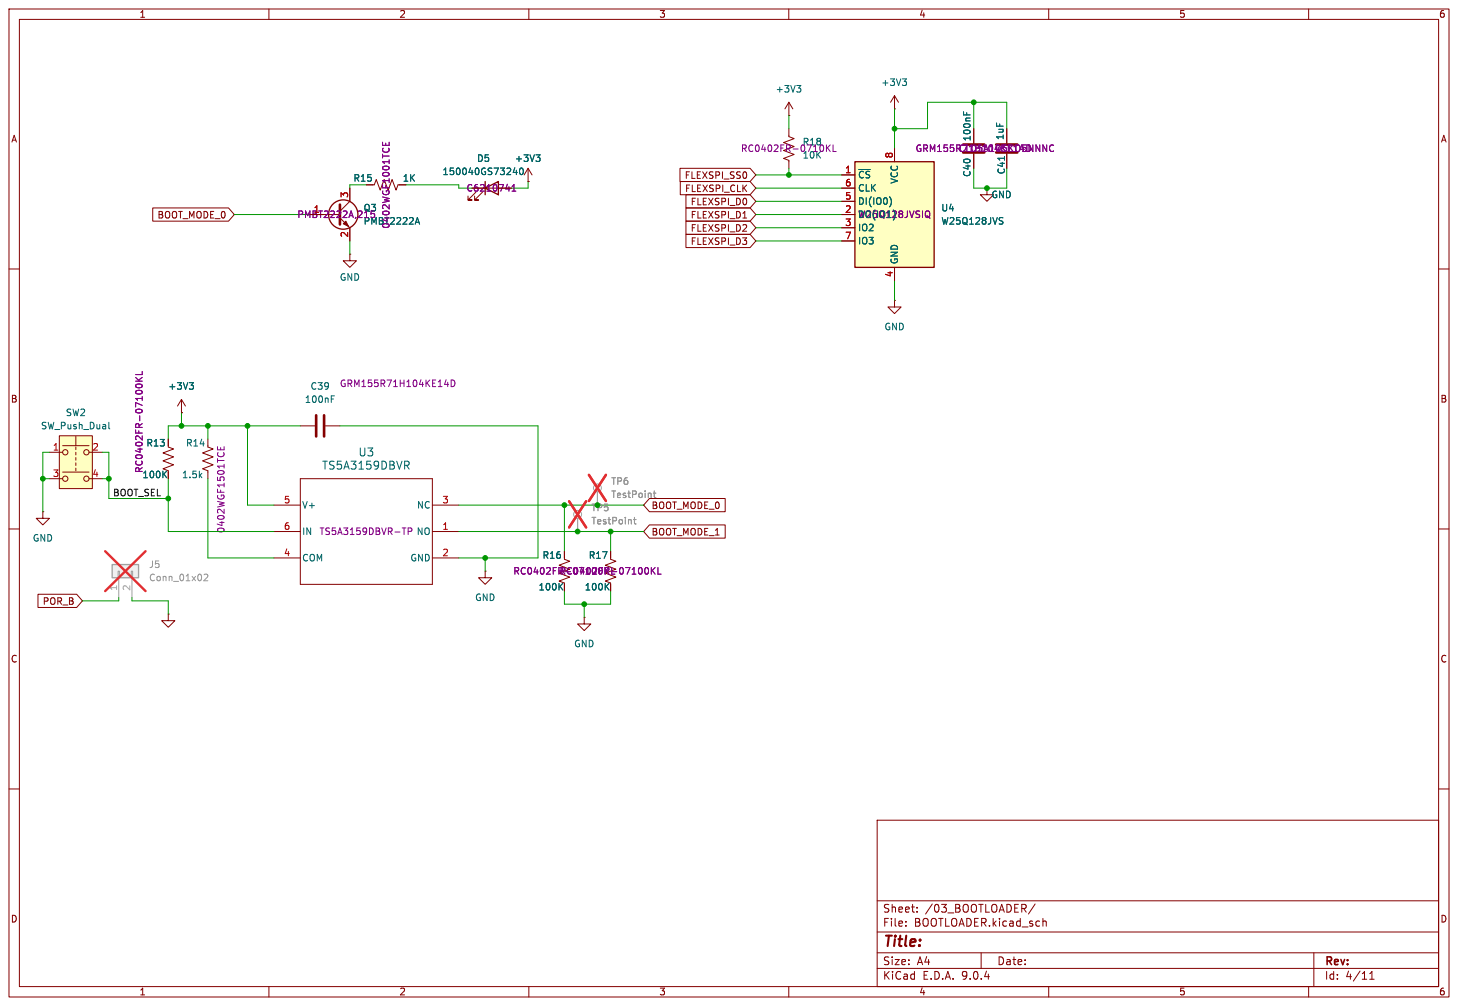
[picture p37: page 4]

Id: 4/11 Title: File: BOOTLOADER.kicad_sch Sheet: /03_BOOTLOADER/

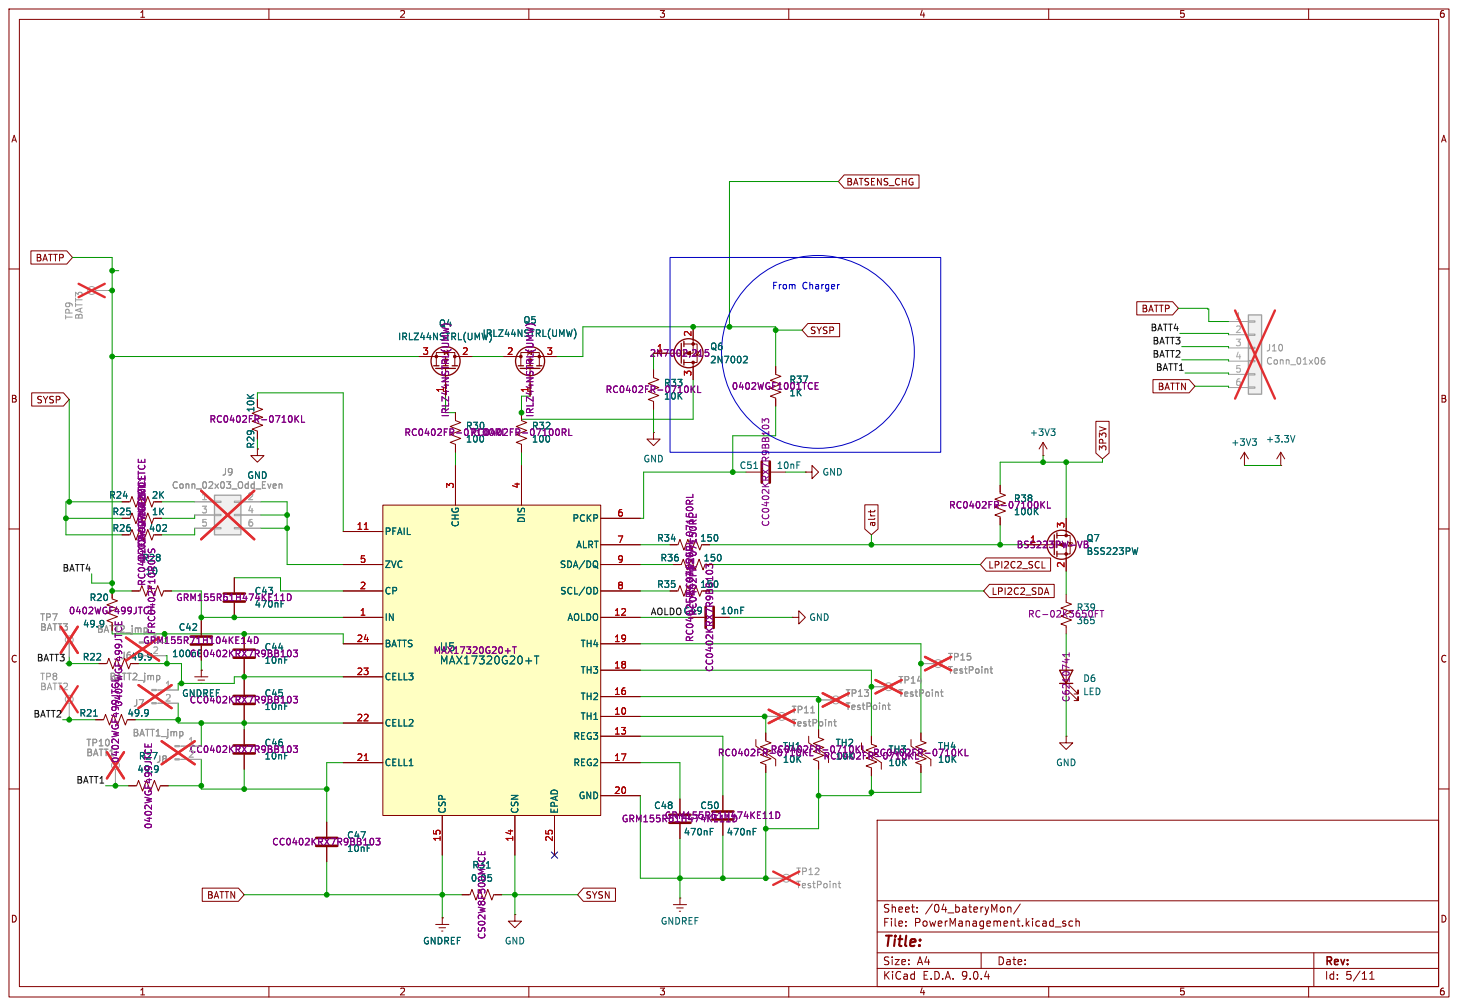
[picture p38: page 5]

4 EPAD 25 ALRT 7 SDA/DQ 9 SCL/OD 8 AOLDO 12 TH4 19 TH3 18 TH2 16 TH1 10 REG3 13 REG2 17 GND 20 PCKP 6 C47

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


Id: 6/11 Title: File: lcd_port.kicad_sch Sheet: /05_LCD_port/

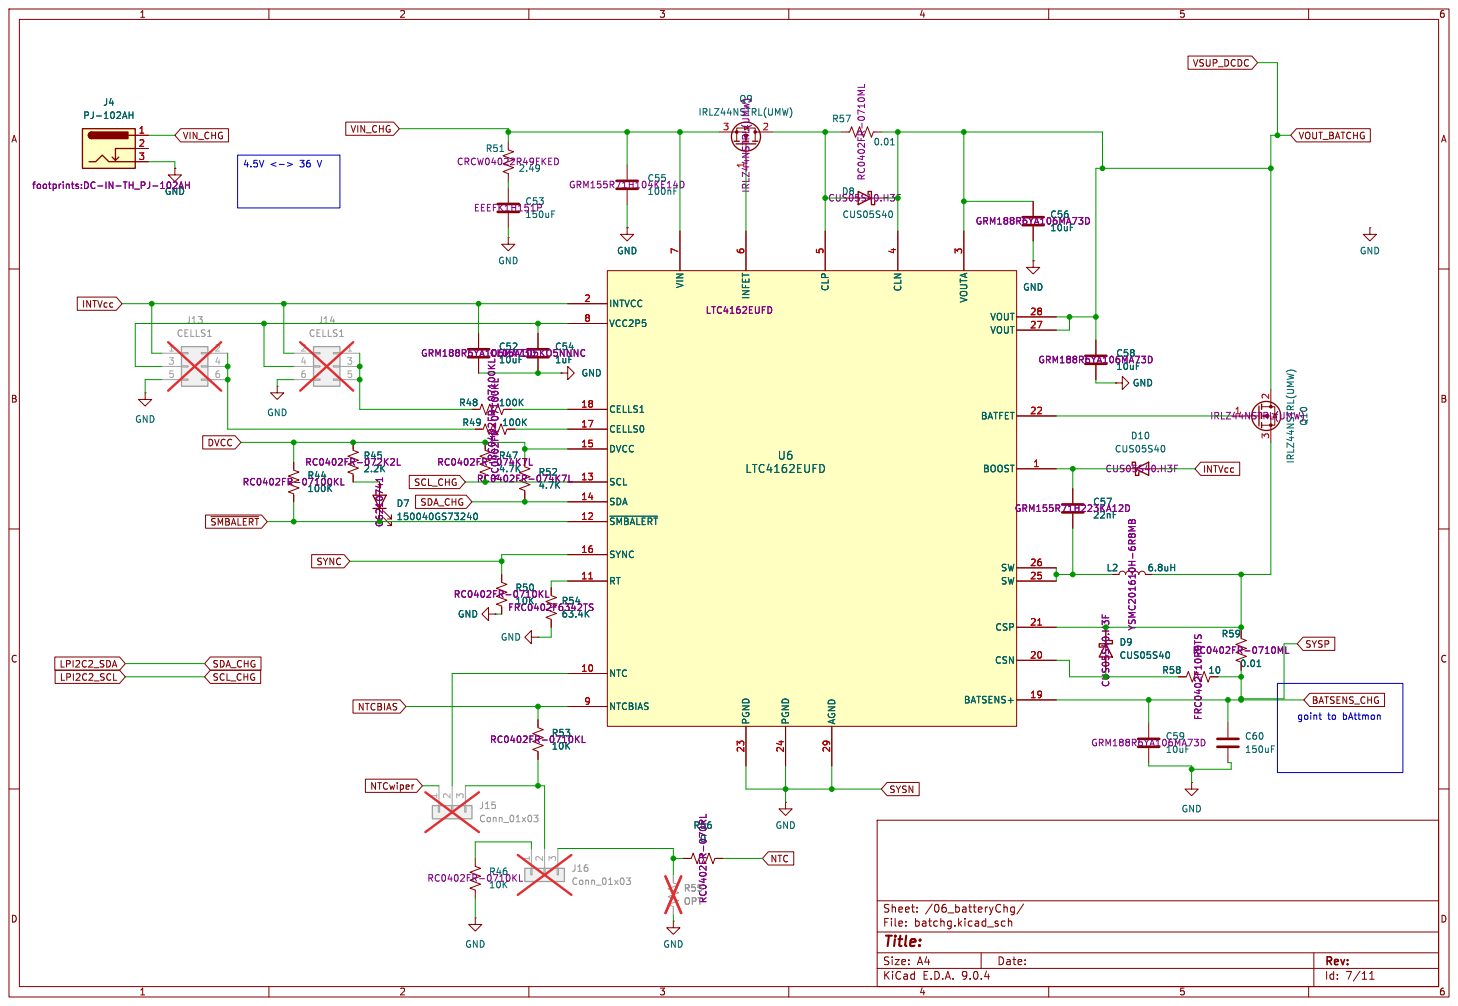
[picture p39: page 7]

3 VOUT 28 VOUT 27 BATFET 22 BOOST 1 SW 26 SW 25 CSP 21 CSN 20 BATSENS+ 19 ~{SMBALERT} 12 GND

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

Id: 7/11 Title: File: batchg.kicad_sch Sheet: /06_batteryChg/

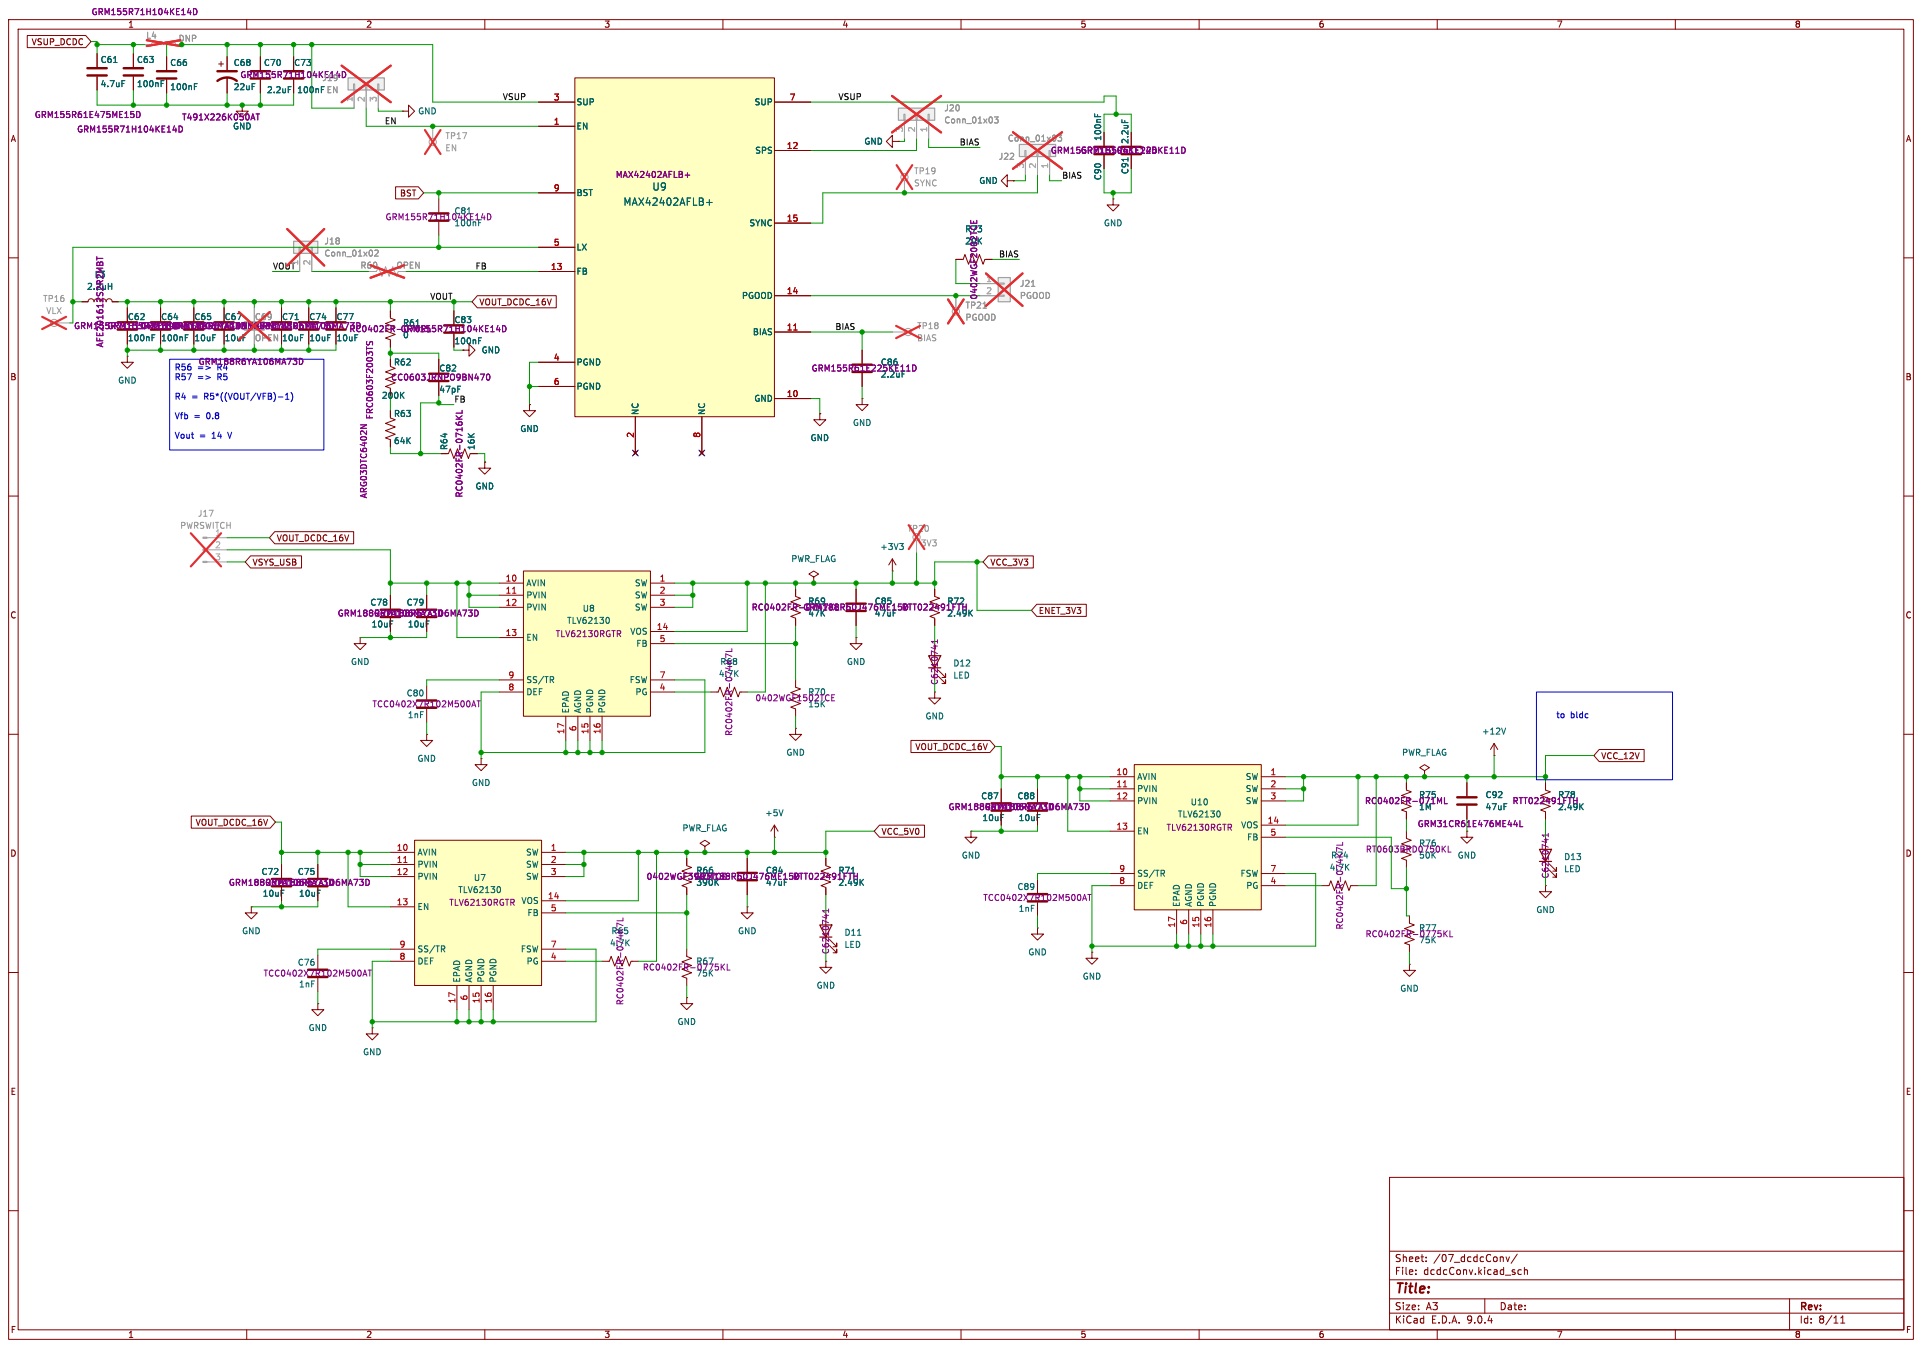
[picture p40: page 8]

8 SUP 7 SPS 12 SYNC 15 PGOOD 14 BIAS 11 GND 10 C83

8 SUP 7 SPS 12 SYNC 15 PGOOD 14 BIAS 11 GND 10 U9 MAX42402AFLB+ MAX42402AFLB+

6 PGND 15 PGND 16 SW 1 SW 2 SW 3 VOS 14 FB 5 FSW 7 PG 4 U10 TLV62130 TLV62130RGTR GND GNDC90 100nF GRM155R71H104KE14D C91 2.2uF GRM155R61E225KE11D GND
J22Conn_01x03

BIAS R56 => R4 R57 => R5 R4 = R5*((VOUT/VFB)-1) Vfb = 0.8 Vout = 14 V

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

Id: 8/11 Title: File: dcdcConv.kicad_sch Sheet: /07_dcdcConv/

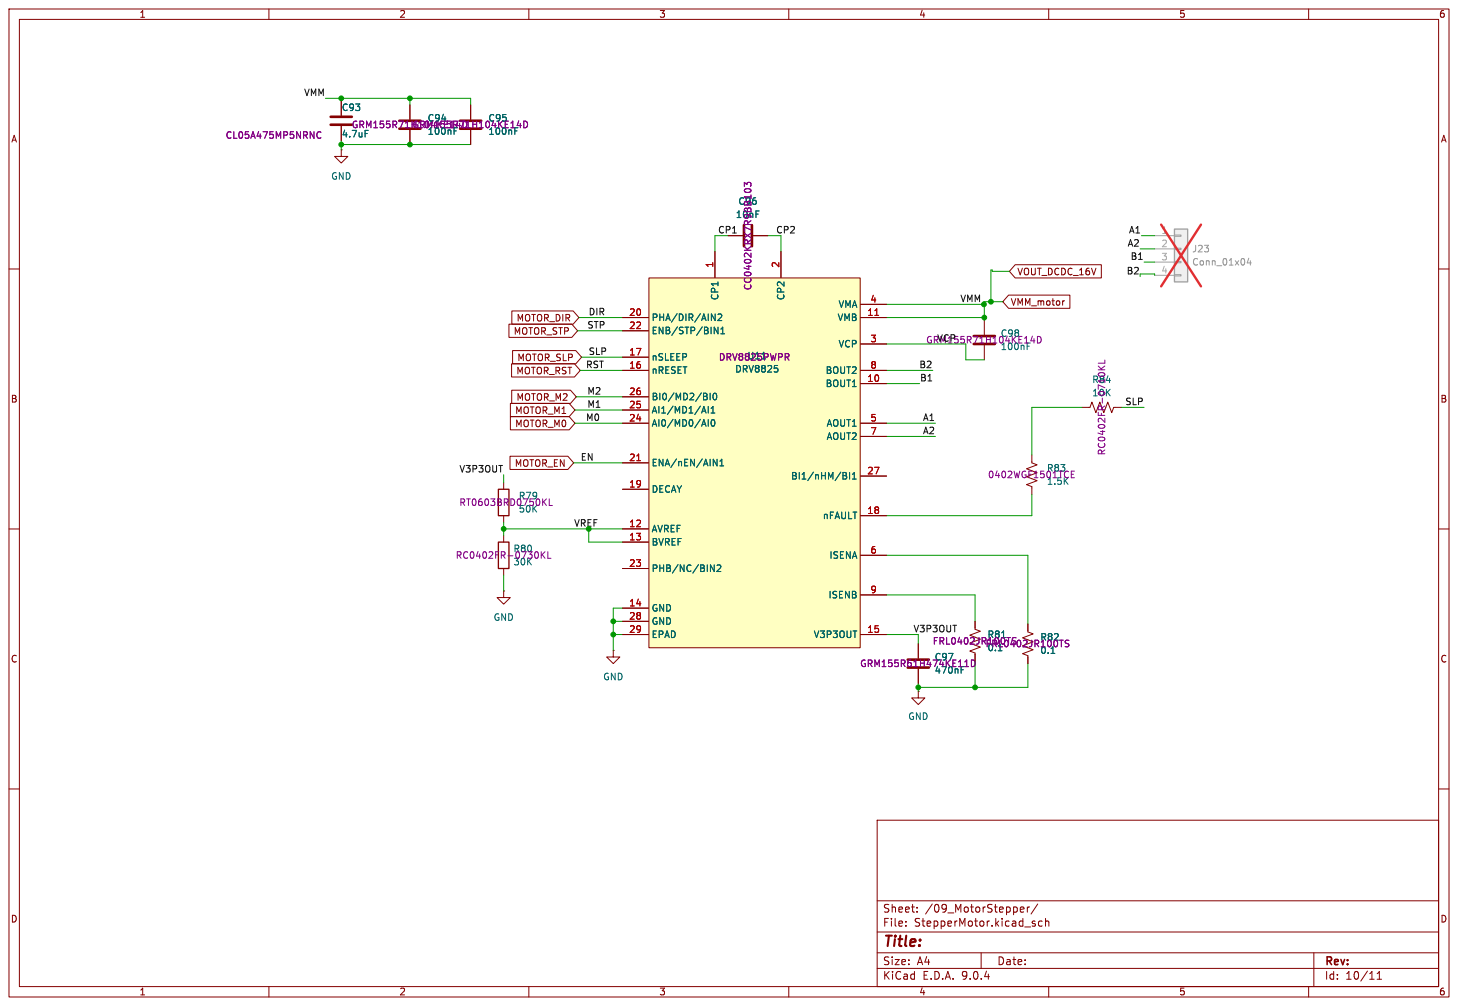
[picture p41: page 9]
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

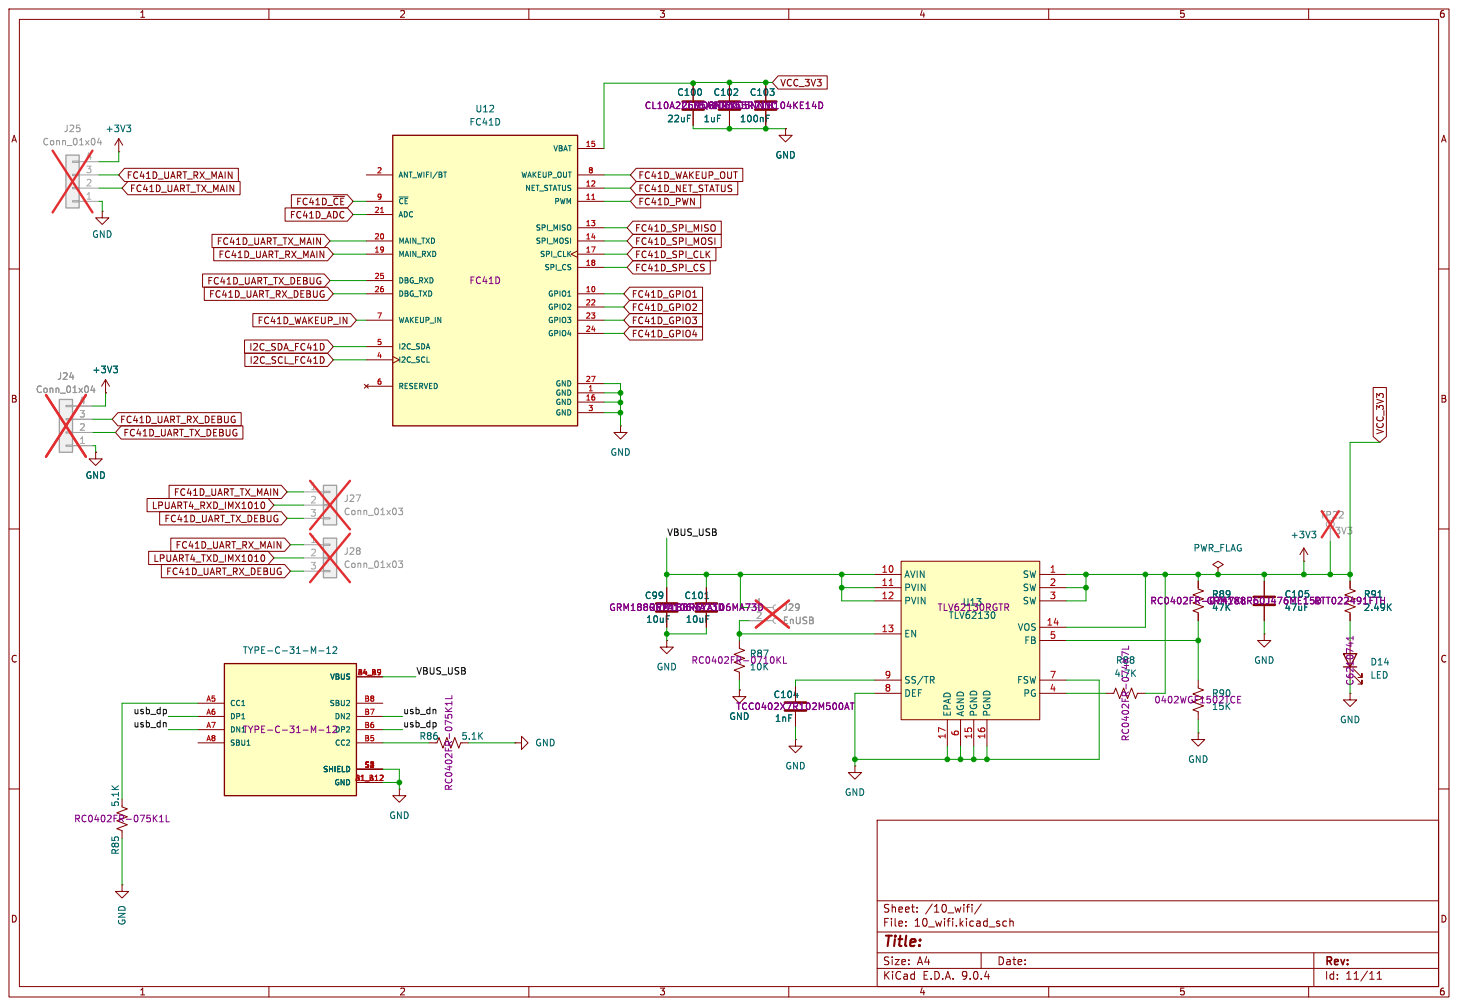
[picture p42: page 10]

6 PGND 15 PGND 16 SW 1 SW 2 SW 3 VOS 14 FB 5 FSW 7 PG 4 U13 TLV62130 TLV62130RGTR GND


Id: 12/11 Title: File: 11_GPIO_Expander.kicad_sch Sheet: /11_GPIO_Expander/
