faoziaziz/qioters/qiot.kicad_pcb

## KiCad design qiot.kicad_pcb (2025-10-26)

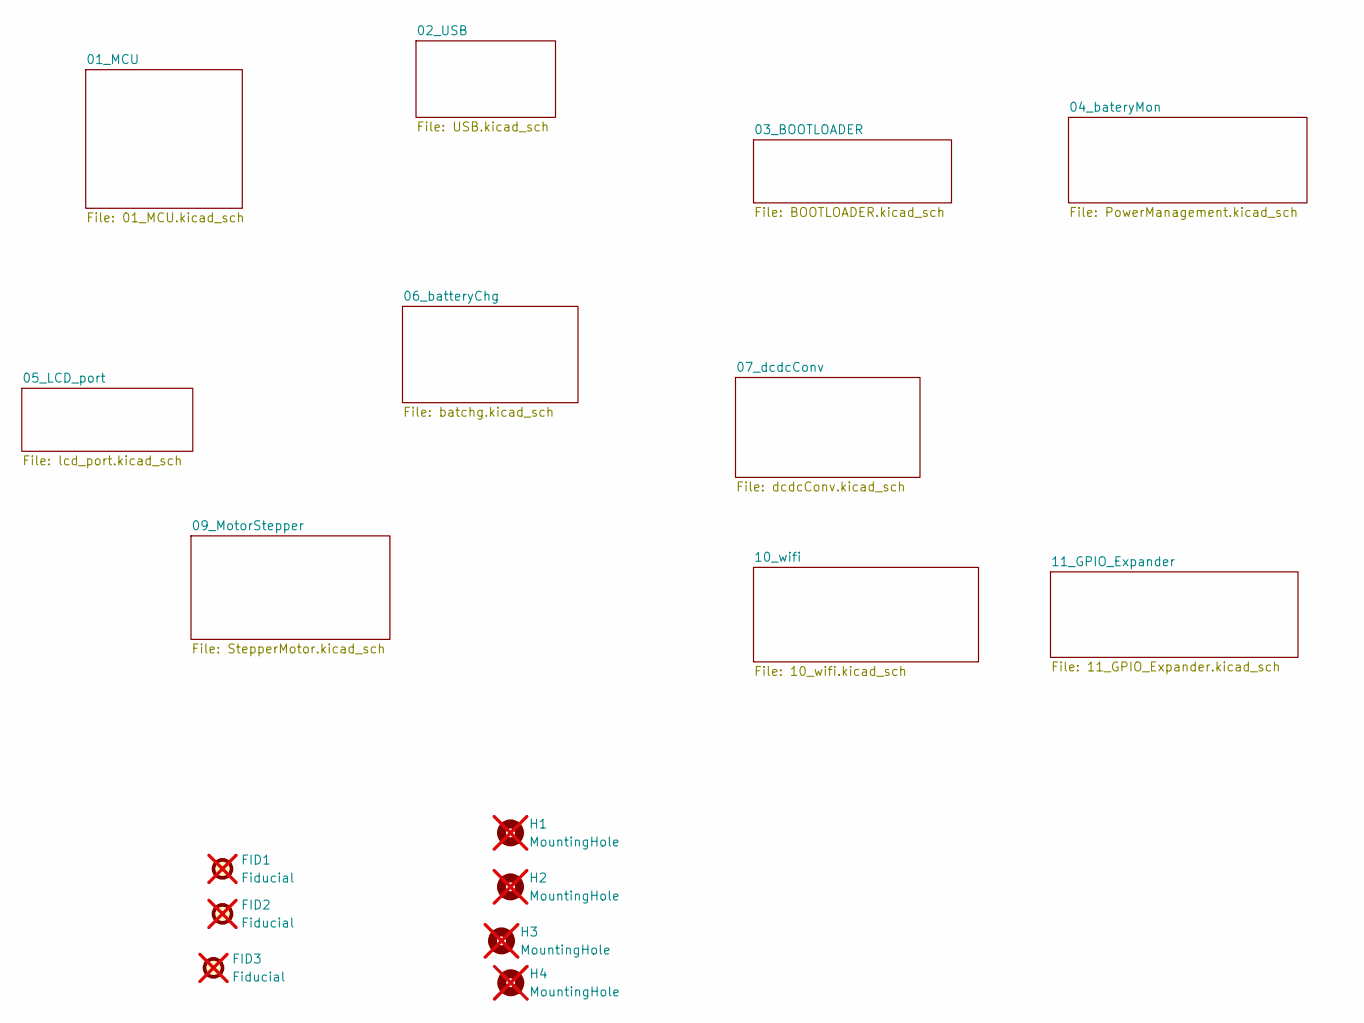
[picture p43: schematic qiot.kicad_sch]

Parts:
FID1, FID2, FID3: Fiducial; Fiducial_1.5mm_Mask3mm; not fitted
H1, H2, H3, H4: MountingHole; MountingHole_2.7mm_M2.5; not fitted

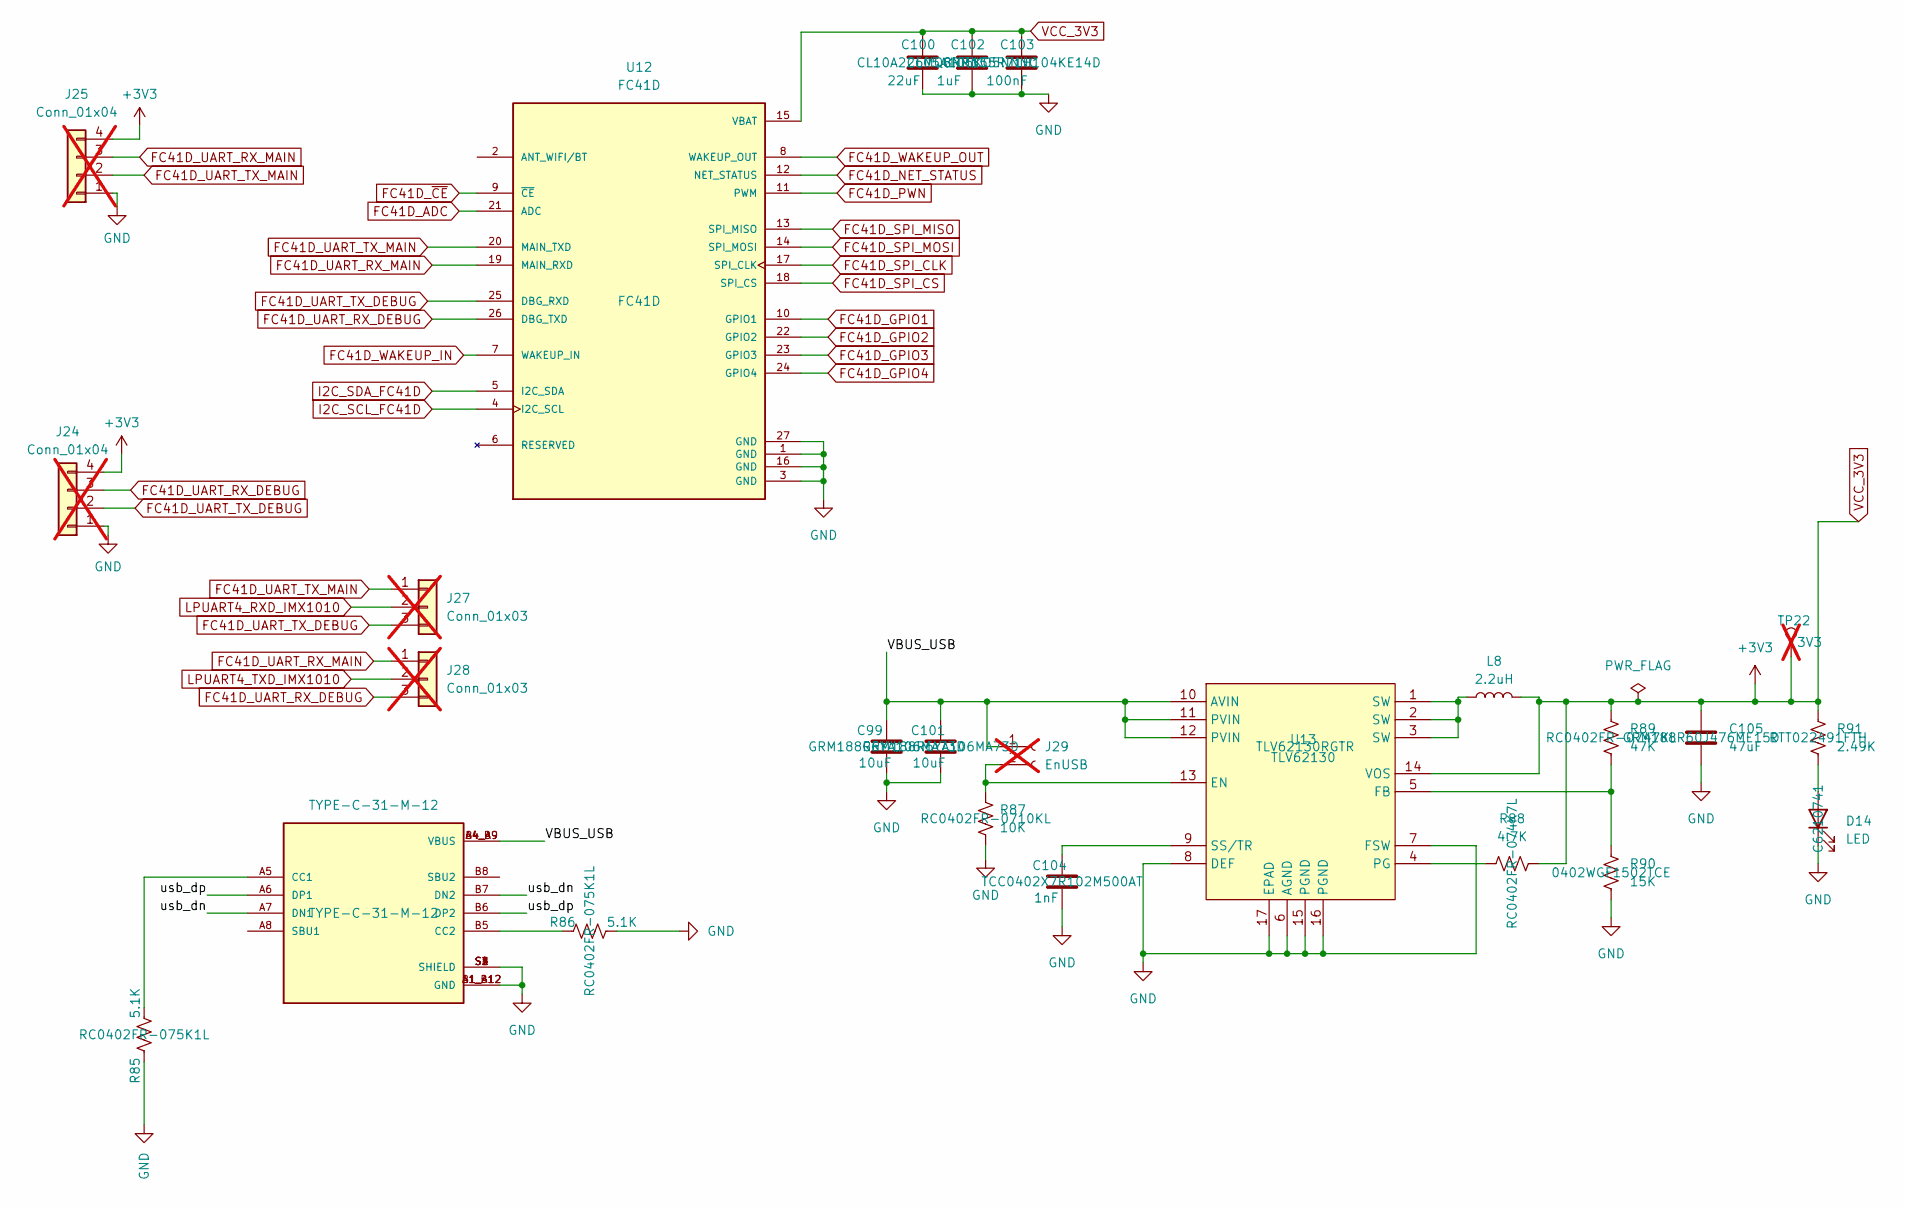
[picture p44: schematic 10_wifi.kicad_sch]

Parts:
C99, C101: 10uF; C_0603_1608Metric; Manufacturer_Part_Number GRM188R6YA106MA73D; LCSC Part # C194427
C100: 22uF; C_0603_1608Metric; Manufacturer_Part_Number CL10A226MQ8NRNC; LCSC Part # C59461
C102: 1uF; C_0402_1005Metric; Manufacturer_Part_Number CL05A105KO5NNNC; LCSC Part # C29266
C103: 100nF; C_0402_1005Metric; Manufacturer_Part_Number GRM155R71H104KE14D; LCSC Part # C77020
C104: 1nF; C_0402_1005Metric; Manufacturer_Part_Number TCC0402X7R102M500AT; LCSC Part # C696907
C105: 47uF; C_0603_1608Metric; Manufacturer_Part_Number GRM188R60J476ME15D; LCSC Part # C140782
D14: LED; LED_0402_1005Metric; Manufacturer_Part_Number C6210741; LCSC Part # C6210741
J24, J25: Conn_01x04; PinHeader_1x04_P2.54mm_Vertical; not fitted
J26: TYPE-C-31-M-12; HRO_TYPE-C-31-M-12; PARTREV 2020.12.08; LCSC Part # C165948
J27, J28: Conn_01x03; PinHeader_1x03_P2.54mm_Vertical; not fitted
J29: EnUSB; PinHeader_1x02_P2.54mm_Vertical; not fitted
L8: 2.2uH; LCSC part C108293
R85, R86: 5.1K; R_0402_1005Metric; Manufacturer_Part_Number RC0402FR-075K1L; LCSC Part # C105872
R87: 10K; R_0402_1005Metric; Manufacturer_Part_Number RC0402FR-0710KL; LCSC Part # C60490
R88: 4.7K; R_0402_1005Metric; Manufacturer_Part_Number RC0402FR-074K7L; LCSC Part # C105871
R89: 47K; R_0402_1005Metric; Manufacturer_Part_Number RC0402FR-0747KL; LCSC Part # C93943
R90: 15K; R_0402_1005Metric; Manufacturer_Part_Number 0402WGF1502TCE; LCSC Part # C25756
R91: 2.49K; R_0402_1005Metric; Manufacturer_Part_Number RTT022491FTH; LCSC Part # C102924
TP22: 3V3; TestPoint_Pad_D2.5mm; not fitted
U12: FC41D; XCVR_FC41D; PARTREV 1.0; LCSC Part # FC41D
U13: TLV62130; RGT0016C; Manufacturer_Part_Number TLV62130RGTR; LCSC Part # C122479

Connections:
/10_wifi/VBUS_USB: C99.1, C101.1, J26.A4_B9 (VBUS), J26.B4_A9 (VBUS), J29.1, U13.10 (AVIN), U13.11 (PVIN), U13.12 (PVIN)
/10_wifi/usb_dn: J26.A7 (DN1), J26.B7 (DN2)
/10_wifi/usb_dp: J26.A6 (DP1), J26.B6 (DP2)
FC41D_ADC: U12.21 (ADC)
FC41D_GPIO1: U12.10 (GPIO1)
FC41D_GPIO2: U12.22 (GPIO2)
FC41D_GPIO3: U12.23 (GPIO3)
FC41D_GPIO4: U12.24 (GPIO4)
FC41D_NET_STATUS: U12.12 (NET_STATUS)
FC41D_PWN: U12.11 (PWM)
FC41D_SPI_CLK: U12.17 (SPI_CLK)
FC41D_SPI_CS: U12.18 (SPI_CS)
FC41D_SPI_MISO: U12.13 (SPI_MISO)
FC41D_SPI_MOSI: U12.14 (SPI_MOSI)
FC41D_UART_RX_DEBUG: J24.3, J28.3, U12.26 (DBG_TXD)
FC41D_UART_RX_MAIN: J25.3, J28.1, U12.19 (MAIN_RXD)
FC41D_UART_TX_DEBUG: J24.2, J27.3, U12.25 (DBG_RXD)
FC41D_UART_TX_MAIN: J25.2, J27.1, U12.20 (MAIN_TXD)
FC41D_WAKEUP_IN: U12.7 (WAKEUP_IN)
FC41D_WAKEUP_OUT: U12.8 (WAKEUP_OUT)
FC41D_~CE: U12.9 (~CE)
I2C_SCL_FC41D: U12.4 (I2C_SCL)
I2C_SDA_FC41D: U12.5 (I2C_SDA)
LPUART4_RXD_IMX1010: J27.2; also elsewhere on the board
LPUART4_TXD_IMX1010: J28.2; also elsewhere on the board
unnamed: D14.2 (A), R91.1
unnamed: J26.A5 (CC1), R85.2
unnamed: J26.B5 (CC2), R86.2
unnamed: J29.2, R87.1, U13.13 (EN)
unnamed: R89.1, R90.2, U13.5 (FB)
unnamed: R88.1, U13.4 (PG)
unnamed: C104.1, U13.9 (SS/TR)
SYSN: C99.2, C100.2, C101.2, C102.2, C103.2, C104.2, C105.2, D14.1 (K), J24.1, J25.1, J26.A1_B12 (GND), J26.B1_A12 (GND), J26.S1 (SHIELD), J26.S2 (SHIELD), J26.S3 (SHIELD), J26.S4 (SHIELD), R85.1, R86.1, R87.2, R90.1, U12.1 (GND), U12.3 (GND), U12.16 (GND), U12.27 (GND), U13.6 (AGND), U13.7 (FSW), U13.8 (DEF), U13.15 (PGND), U13.16 (PGND), U13.17 (EPAD); also elsewhere on the board

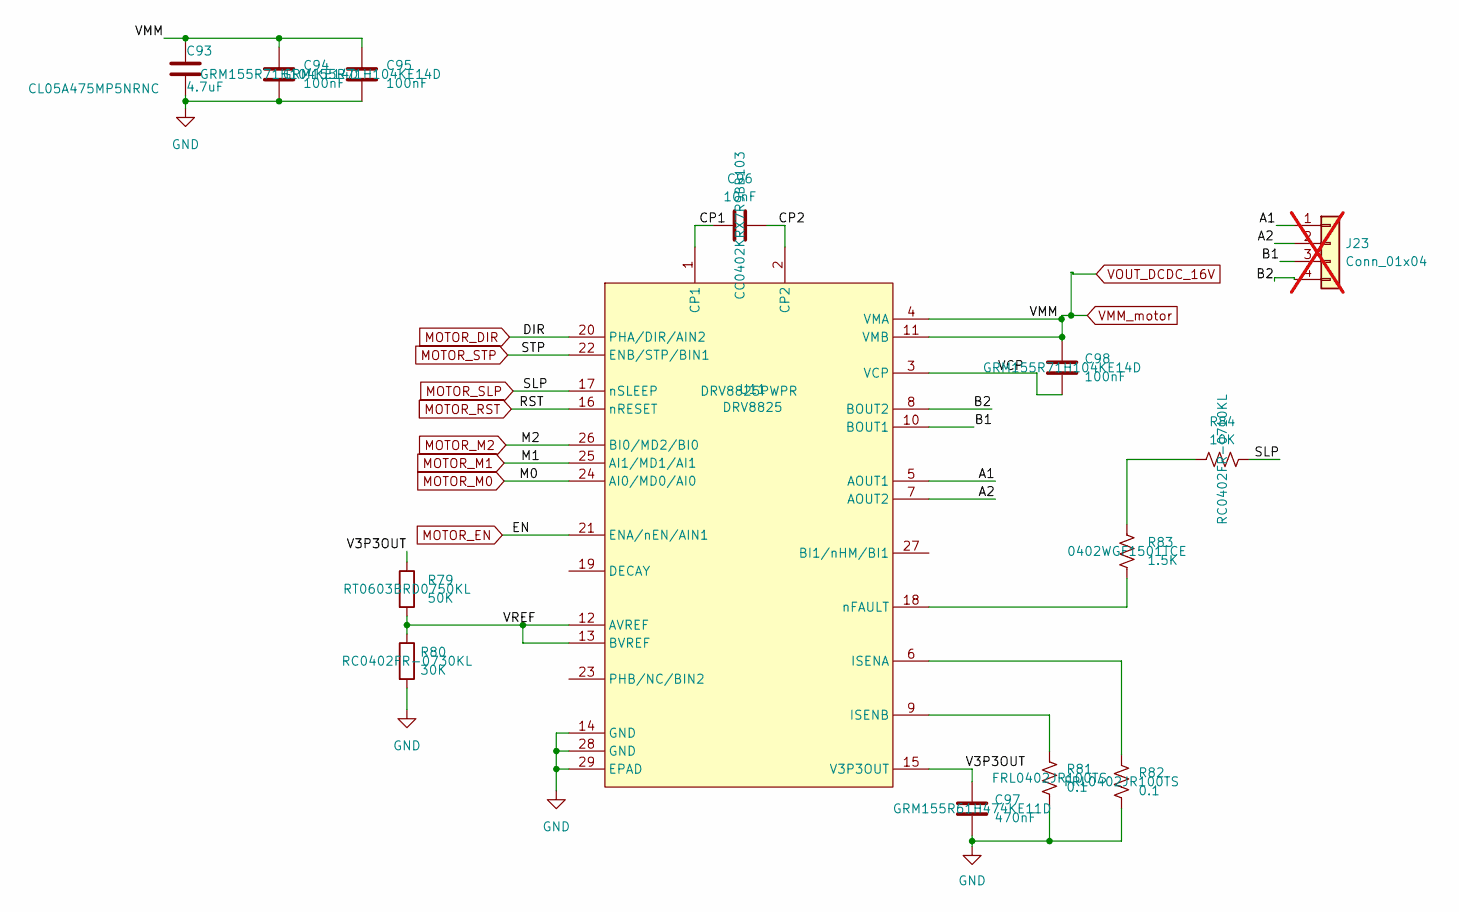
[picture p45: schematic StepperMotor.kicad_sch]

Parts:
C93: 4.7uF; C_0402_1005Metric; Manufacturer_Part_Number CL05A475MP5NRNC; LCSC Part # C23733
C94, C95, C98: 100nF; C_0402_1005Metric; Manufacturer_Part_Number GRM155R71H104KE14D; LCSC Part # C77020
C96: 10nF; C_0402_1005Metric; Manufacturer_Part_Number CC0402KRX7R9BB103; LCSC Part # C60133
C97: 470nF; C_0402_1005Metric; Manufacturer_Part_Number GRM155R61H474KE11D; LCSC Part # C437527
J23: Conn_01x04; PinSocket_1x04_P2.54mm_Vertical; not fitted
R79: 50K; R_0603_1608Metric; Manufacturer_Part_Number RT0603BRD0750KL; LCSC Part # C861451
R80: 30K; R_0402_1005Metric; Manufacturer_Part_Number RC0402FR-0730KL; LCSC Part # C138008
R81, R82: 0.1; R_0402_1005Metric; Manufacturer_Part_Number FRL0402JR100TS; LCSC Part # C3013344
R83: 1.5K; R_0402_1005Metric; Manufacturer_Part_Number 0402WGF1501TCE; LCSC Part # C25867
R84: 10K; R_0402_1005Metric; Manufacturer_Part_Number RC0402FR-0710KL; LCSC Part # C60490
U11: DRV8825; PWP28_5P18X3P1; Manufacturer_Part_Number DRV8825PWPR; LCSC Part # C81582

Connections:
/09_MotorStepper/A1: J23.1, U11.5 (AOUT1)
/09_MotorStepper/A2: J23.2, U11.7 (AOUT2)
/09_MotorStepper/B1: J23.3, U11.10 (BOUT1)
/09_MotorStepper/B2: J23.4, U11.8 (BOUT2)
/09_MotorStepper/CP1: C96.1, U11.1 (CP1)
/09_MotorStepper/CP2: C96.2, U11.2 (CP2)
/09_MotorStepper/V3P3OUT: C97.1, R79.1, U11.15 (V3P3OUT)
/09_MotorStepper/VCP: C98.2, U11.3 (VCP)
/09_MotorStepper/VREF: R79.2, R80.1, U11.12 (AVREF), U11.13 (BVREF)
MOTOR_DIR: U11.20 (PHA/DIR/AIN2); also elsewhere on the board
MOTOR_EN: U11.21 (ENA/nEN/AIN1); also elsewhere on the board
MOTOR_M0: U11.24 (AI0/MD0/AI0); also elsewhere on the board
MOTOR_M1: U11.25 (AI1/MD1/AI1); also elsewhere on the board
MOTOR_M2: U11.26 (BI0/MD2/BI0); also elsewhere on the board
MOTOR_RST: U11.16 (nRESET); also elsewhere on the board
MOTOR_SLP: R84.2, U11.17 (nSLEEP); also elsewhere on the board
MOTOR_STP: U11.22 (ENB/STP/BIN1); also elsewhere on the board
unnamed: R83.1, R84.1
unnamed: R82.1, U11.6 (ISENA)
unnamed: R81.1, U11.9 (ISENB)
unnamed: R83.2, U11.18 (nFAULT)
SYSN: C93.2, C94.2, C95.2, C97.2, R80.2, R81.2, R82.2, U11.14 (GND), U11.28 (GND), U11.29 (EPAD); also elsewhere on the board
VMM_motor: C93.1, C94.1, C95.1, C98.1, U11.4 (VMA), U11.11 (VMB); also elsewhere on the board

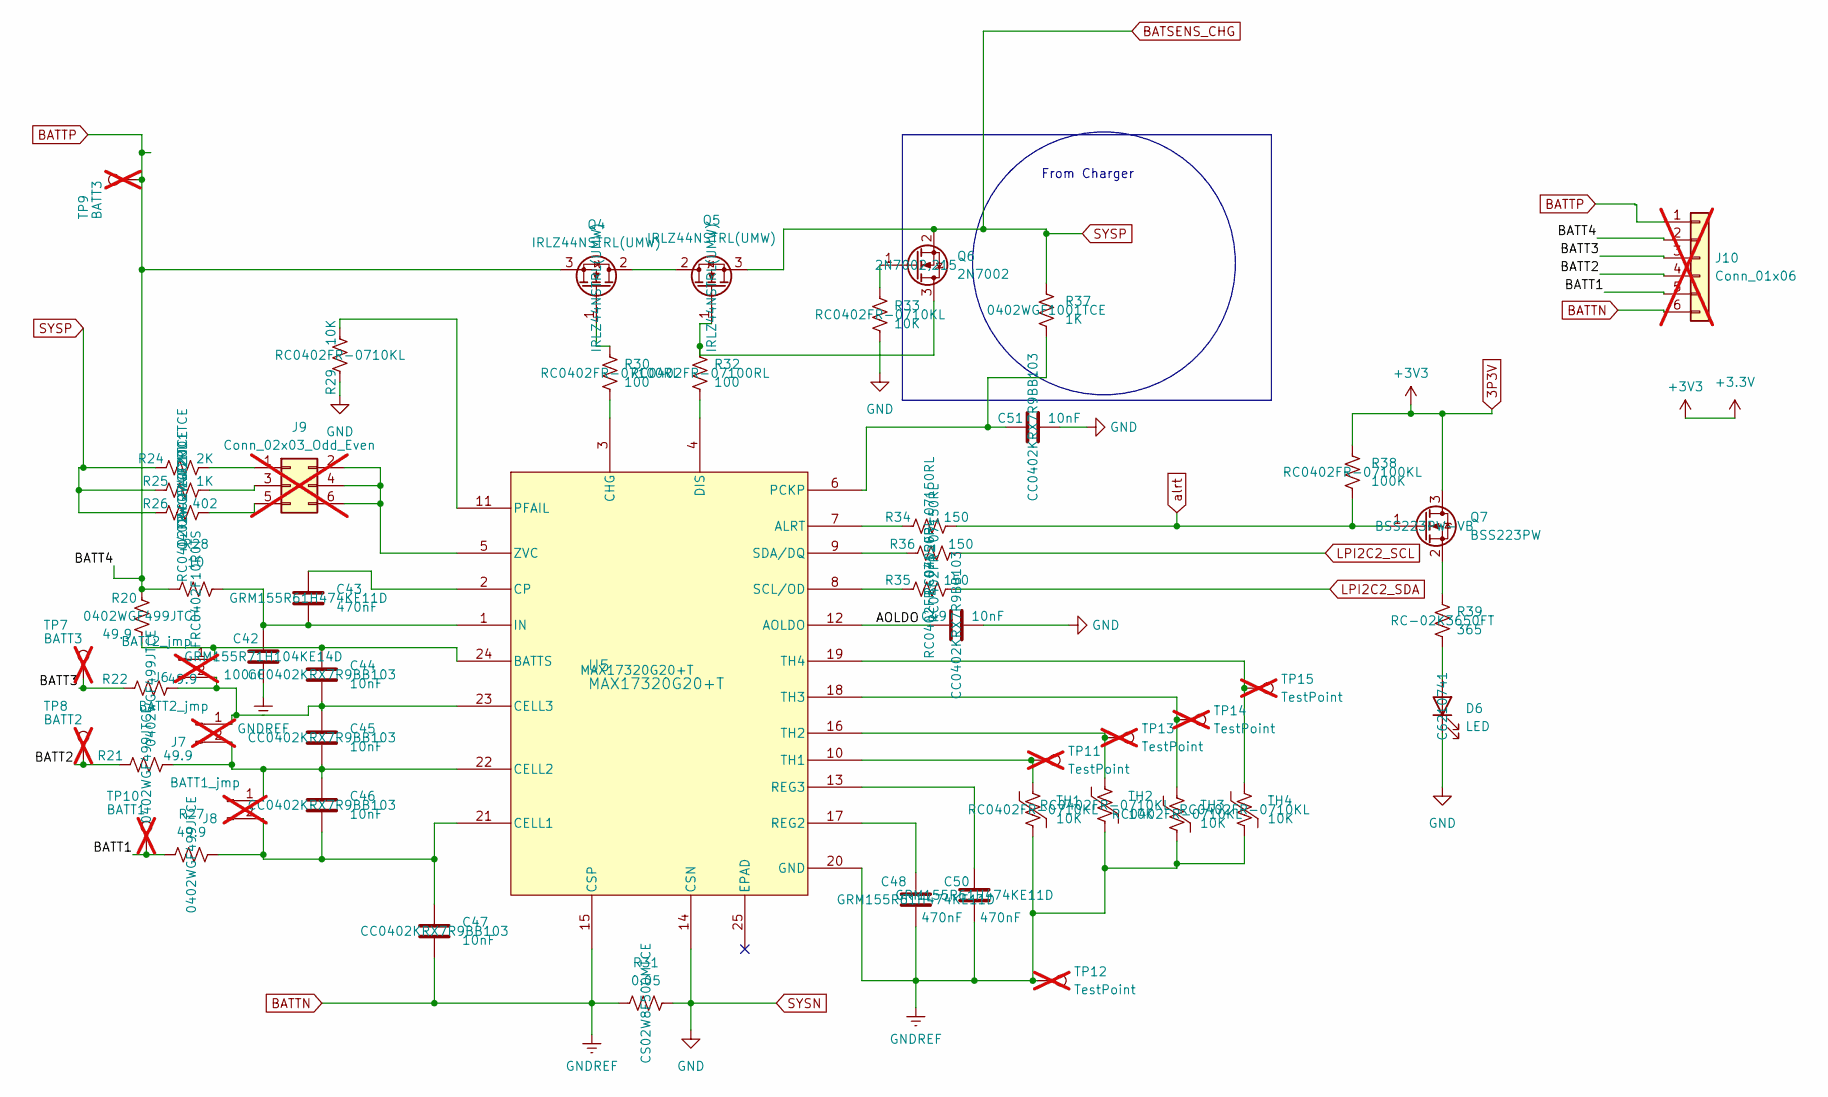
[picture p46: schematic PowerManagement.kicad_sch]

Parts:
C42: 100nF; C_0402_1005Metric; Manufacturer_Part_Number GRM155R71H104KE14D; LCSC Part # C77020
C43, C48, C50: 470nF; C_0402_1005Metric; Manufacturer_Part_Number GRM155R61H474KE11D; LCSC Part # C437527
C44, C45, C46, C47, C49, C51: 10nF; C_0402_1005Metric; Manufacturer_Part_Number CC0402KRX7R9BB103; LCSC Part # C60133
D6: LED; LED_0402_1005Metric; Manufacturer_Part_Number C6210741; LCSC Part # C6210741
J6, J7: BATT2_jmp; PinHeader_1x02_P2.54mm_Vertical; not fitted
J8: BATT1_jmp; PinHeader_1x02_P2.54mm_Vertical; not fitted
J9: Conn_02x03_Odd_Even; PinHeader_2x03_P2.54mm_Vertical; not fitted
J10: Conn_01x06; PinSocket_1x06_P2.54mm_Vertical; not fitted
Q4, Q5: IRLZ44NSTRL(UMW); TO-263-2; Manufacturer_Part_Number IRLZ44NSTRL(UMW); LCSC Part # C42370422
Q6: 2N7002; SOT-23; Manufacturer_Part_Number 2N7002,215; LCSC Part # C65189
Q7: BSS223PW; SOT-323_SC-70; Manufacturer_Part_Number BSS223PW-VB; LCSC Part # C5197341
R20, R21, R22, R27: 49.9; R_0402_1005Metric; Manufacturer_Part_Number 0402WGF499JTCE; LCSC Part # C25120
R24: 2K; R_0402_1005Metric; Manufacturer_Part_Number 0402WGF2001TCE; LCSC Part # C4109
R25, R37: 1K; R_0402_1005Metric; Manufacturer_Part_Number 0402WGF1001TCE; LCSC Part # C11702
R26: 402; R_0402_1005Metric; Manufacturer_Part_Number RC0402FR-07402RL; LCSC Part # C137984
R28: 10; R_0402_1005Metric; Manufacturer_Part_Number FRC0402F10R0TS; LCSC Part # C2906862
R29, R33: 10K; R_0402_1005Metric; Manufacturer_Part_Number RC0402FR-0710KL; LCSC Part # C60490
R30, R32: 100; R_0402_1005Metric; Manufacturer_Part_Number RC0402FR-07100RL; LCSC Part # C106232
R31: 0.05; R_0402_1005Metric; Manufacturer_Part_Number CS02W8F500MTCE; LCSC Part # C473658
R34, R35, R36: 150; R_0402_1005Metric; Manufacturer_Part_Number RC0402FR-07150RL; LCSC Part # C138054
R38: 100K; R_0402_1005Metric; Manufacturer_Part_Number RC0402FR-07100KL; LCSC Part # C60491
R39: 365; R_0402_1005Metric; Manufacturer_Part_Number RC-02K3650FT; LCSC Part # C453662
TH1: 10K; R_0402_1005Metric; Manu Part NCP15XH103F03RC; LCSC Part # C60490
TH2, TH3, TH4: 10K; R_0402_1005Metric; Manufacturer_Part_Number RC0402FR-0710KL; LCSC Part # C60490
TP7, TP9: BATT3; TestPoint_Pad_D2.5mm; not fitted
TP8: BATT2; TestPoint_Pad_D2.5mm; not fitted
TP10: BATT1; TestPoint_Pad_D2.5mm; not fitted
TP11, TP12, TP13, TP14, TP15: TestPoint; TestPoint_Pad_D2.5mm; not fitted
U5: MAX17320G20+T; 21-0139I_T2444-4_MXM; Manufacturer_Part_Number MAX17320G20+T; LCSC Part # C7457895

Connections:
/04_bateryMon/AOLDO: C49.1, U5.12 (AOLDO)
/04_bateryMon/BATT1: J10.5, R27.1, TP10.1
/04_bateryMon/BATT2: J10.4, R21.1, TP8.1
/04_bateryMon/BATT3: J10.3, R22.1, TP7.1
BATSENS_CHG: Q5.3 (S), Q6.2 (S), R24.1, R25.1, R26.1, R37.1; also elsewhere on the board
BATTN: C42.2, C47.2, C48.2, C50.2, J10.6, R31.1, TH1.2, TH2.2, TH3.2, TH4.2, TP12.1, U5.15 (CSP), U5.20 (GND)
BATTP: J10.1, J10.2, Q4.3 (S), R20.1, R28.1, TP9.1
LPI2C2_SCL: R36.2; also elsewhere on the board
LPI2C2_SDA: R35.2; also elsewhere on the board
unnamed: D6.2 (A), R39.2
unnamed: C44.1, J6.1, R20.2, U5.24 (BATTS)
unnamed: C44.2, C45.1, J6.2, J7.1, R22.2, U5.23 (CELL3)
unnamed: C45.2, C46.1, J7.2, J8.1, R21.2, U5.22 (CELL2)
unnamed: C46.2, C47.1, J8.2, R27.2, U5.21 (CELL1)
unnamed: J9.1, R24.2
unnamed: J9.2, J9.4, J9.6, U5.5 (ZVC)
unnamed: J9.3, R25.2
unnamed: J9.5, R26.2
unnamed: Q4.2 (D), Q5.2 (D)
unnamed: Q4.1 (G), R30.1
unnamed: Q5.1 (G), Q6.3 (D), R32.1
unnamed: Q6.1 (G), R33.1
unnamed: Q7.2 (S), R39.1
unnamed: R34.1, U5.7 (ALRT)
unnamed: R30.2, U5.3 (CHG)
unnamed: C43.1, U5.2 (CP)
unnamed: R32.2, U5.4 (DIS)
unnamed: C42.1, C43.2, R28.2, U5.1 (IN)
unnamed: C51.1, R37.2, U5.6 (PCKP)
unnamed: R29.2, U5.11 (PFAIL)
unnamed: C48.1, U5.17 (REG2)
unnamed: C50.1, U5.13 (REG3)
unnamed: R35.1, U5.8 (SCL/OD)
unnamed: R36.1, U5.9 (SDA/DQ)
unnamed: TH1.1, TP11.1, U5.10 (TH1)
unnamed: TH2.1, TP13.1, U5.16 (TH2)
unnamed: TH3.1, TP14.1, U5.18 (TH3)
unnamed: TH4.1, TP15.1, U5.19 (TH4)
SYSN: C49.2, C51.2, D6.1 (K), R29.1, R31.2, R33.2, U5.14 (CSN); also elsewhere on the board
alrt: Q7.1 (G), R34.2, R38.2

Notes on the sheet:
From Charger

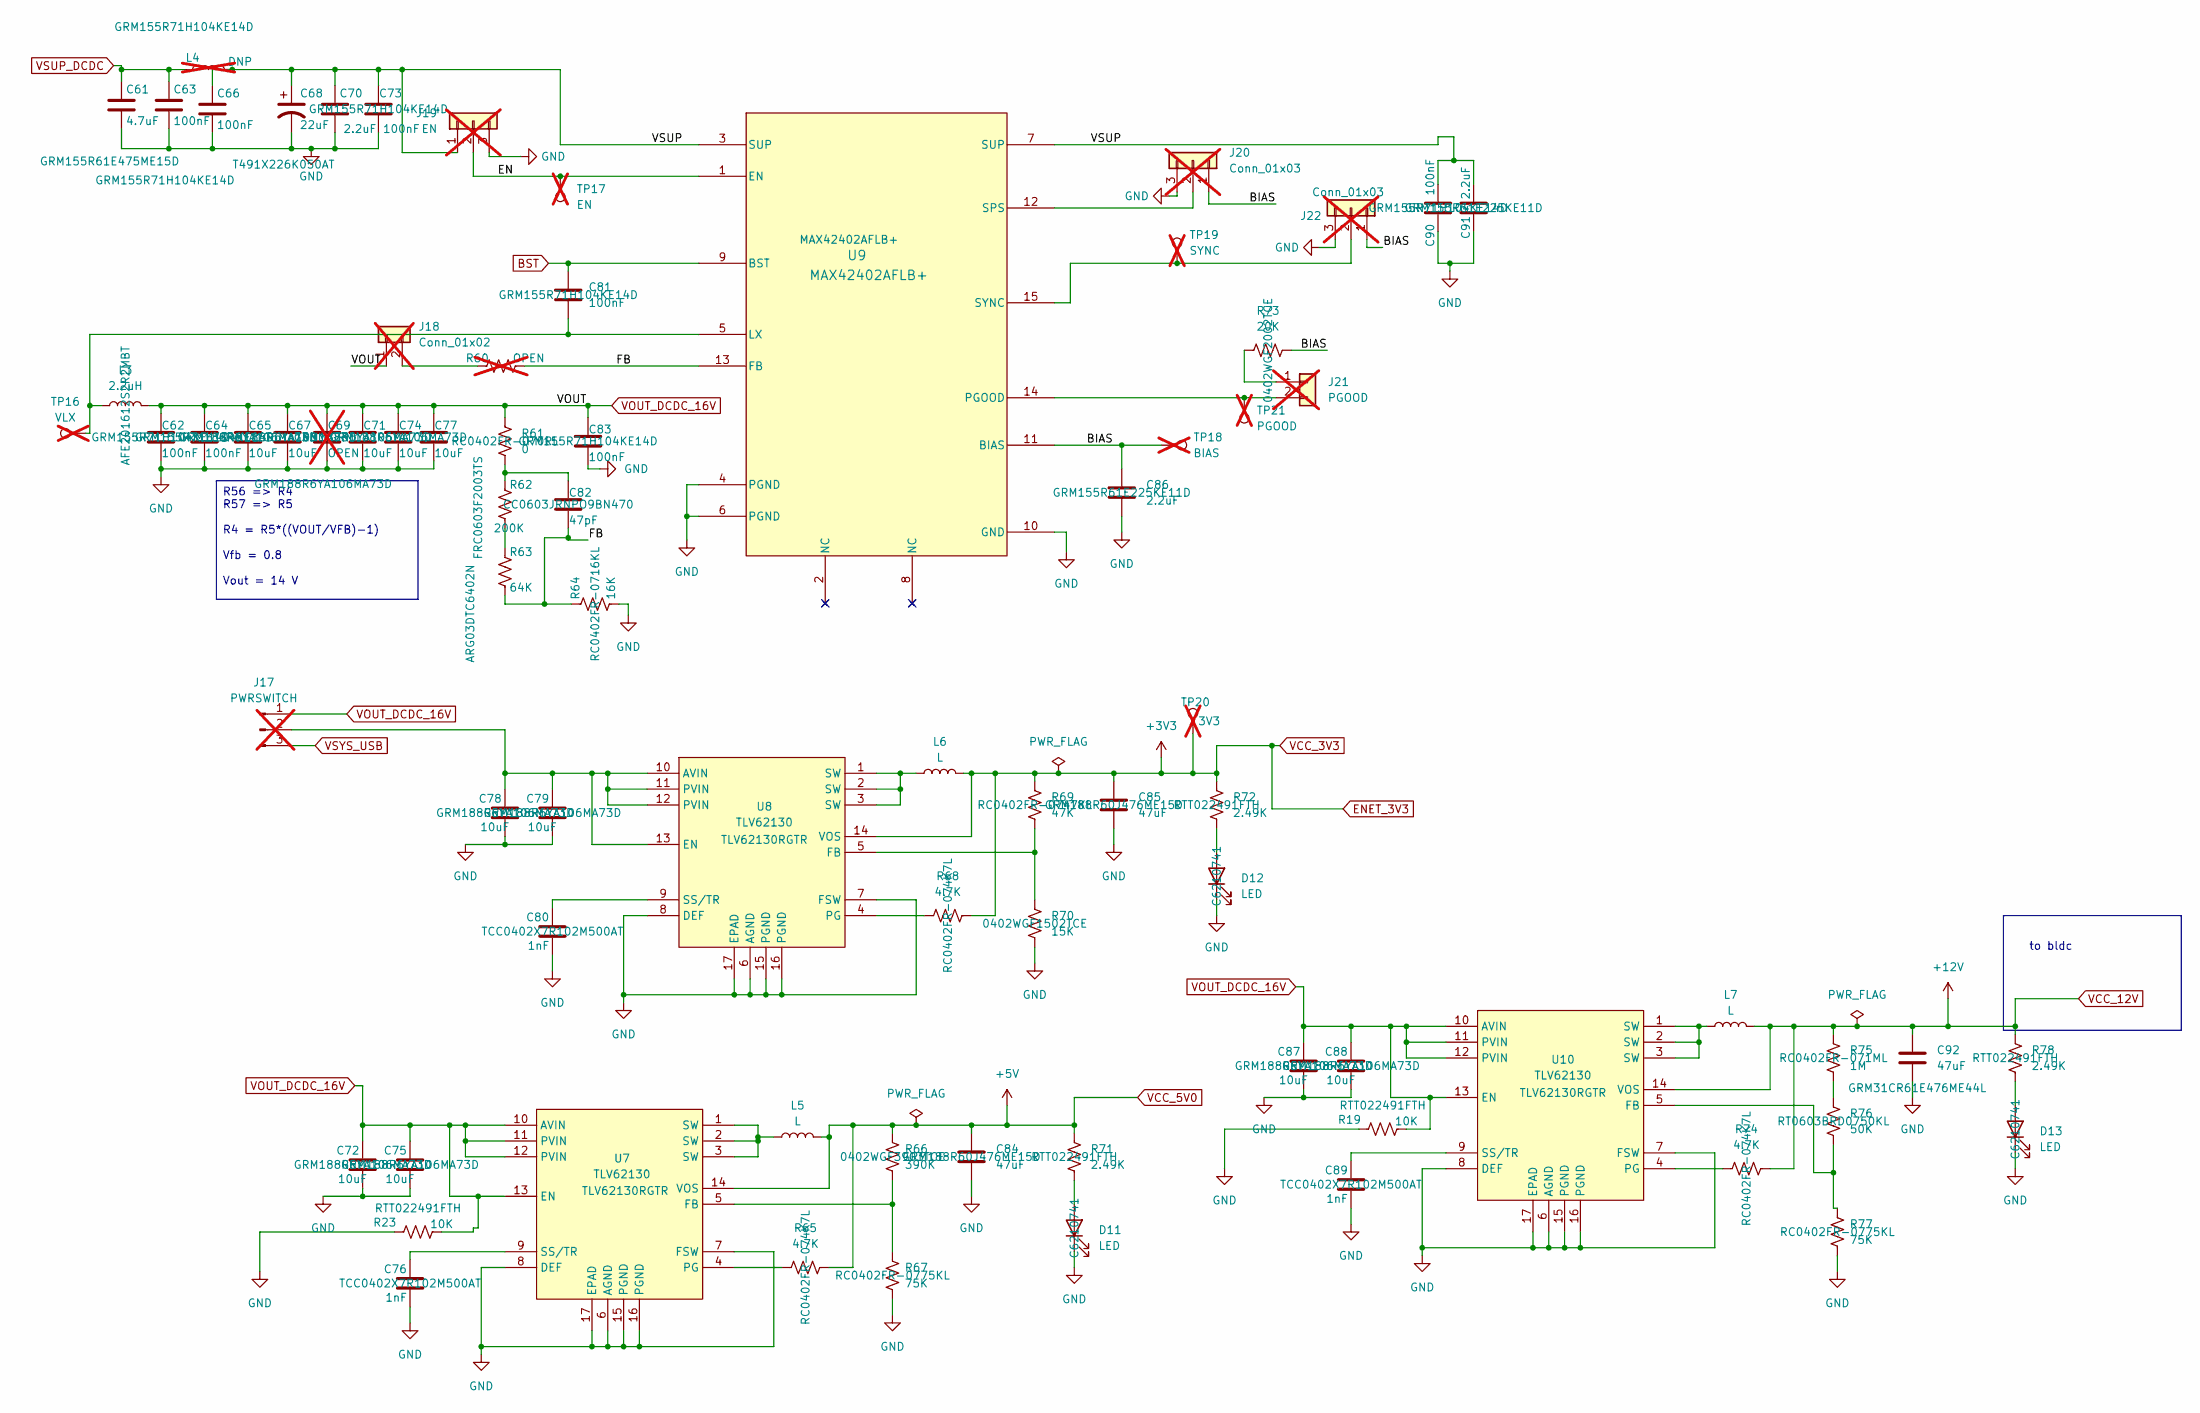
[picture p47: schematic dcdcConv.kicad_sch]

Parts:
C61: 4.7uF; C_0402_1005Metric; Manufacturer_Part_Number GRM155R61E475ME15D; LCSC Part # C2858031
C62, C63, C64, C66, C73, C81, C83, C90: 100nF; C_0402_1005Metric; Manufacturer_Part_Number GRM155R71H104KE14D; LCSC Part # C77020
C65, C67, C71, C72, C74, C75, C77, C78, C79, C87, C88: 10uF; C_0603_1608Metric; Manufacturer_Part_Number GRM188R6YA106MA73D; LCSC Part # C194427
C68: 22uF; CAP-SMD_L7.3-W4.3-R-RD; Manufacturer_Part_Number T491X226K050AT; LCSC Part # C696800
C69: OPEN; C_0603_1608Metric; not fitted
C70, C86, C91: 2.2uF; C_0402_1005Metric; Manufacturer_Part_Number GRM155R61E225KE11D; LCSC Part # C385032
C76, C80, C89: 1nF; C_0402_1005Metric; Manufacturer_Part_Number TCC0402X7R102M500AT; LCSC Part # C696907
C82: 47pF; C_0603_1608Metric; Manufacturer_Part_Number CC0603JRNPO9BN470; LCSC Part # C105622
C84, C85: 47uF; C_0603_1608Metric; Manufacturer_Part_Number GRM188R60J476ME15D; LCSC Part # C140782
C92: 47uF; C_1206_3216Metric; Manufacturer_Part_Number GRM31CR61E476ME44L; LCSC Part # C403725
D11, D12, D13: LED; LED_0402_1005Metric; Manufacturer_Part_Number C6210741; LCSC Part # C6210741
J17: PWRSWITCH; PinHeader_1x03_P2.54mm_Vertical; not fitted
J18: Conn_01x02; PinHeader_1x02_P2.54mm_Vertical; not fitted
J19: EN; PinHeader_1x03_P2.54mm_Vertical; not fitted
J20, J22: Conn_01x03; PinHeader_1x03_P2.54mm_Vertical; not fitted
J21: PGOOD; PinSocket_1x02_P2.54mm_Vertical; not fitted
L3: 2.2uH; L_APV_APH0620; Manufacturer_Part_Number AFE201612S2R2MBT; LCSC Part # C41347750
L4: DNP; L_APV_APH0620; not fitted
L5, L6, L7: L
R19, R23: 10K; R_0402_1005Metric; Manufacturer_Part_Number RTT022491FTH; LCSC Part # C102924
R60: OPEN; R_0402_1005Metric; not fitted
R61: 0; R_0402_1005Metric; Manufacturer_Part_Number RC0402FR-070RL; LCSC Part # C106231
R62: 200K; R_0603_1608Metric; Manufacturer_Part_Number FRC0603F2003TS; LCSC Part # C2907009
R63: 64K; R_0603_1608Metric; Manufacturer_Part_Number ARG03DTC6402N; LCSC Part # C2902643
R64: 16K; R_0402_1005Metric; Manufacturer_Part_Number RC0402FR-0716KL; LCSC Part # C163487
R65, R68, R74: 4.7K; R_0402_1005Metric; Manufacturer_Part_Number RC0402FR-074K7L; LCSC Part # C105871
R66: 390K; R_0402_1005Metric; Manufacturer_Part_Number 0402WGF3903TCE; LCSC Part # C25782
R67, R77: 75K; R_0402_1005Metric; Manufacturer_Part_Number RC0402FR-0775KL; LCSC Part # C137935
R69: 47K; R_0402_1005Metric; Manufacturer_Part_Number RC0402FR-0747KL; LCSC Part # C93943
R70: 15K; R_0402_1005Metric; Manufacturer_Part_Number 0402WGF1502TCE; LCSC Part # C25756
R71, R72, R78: 2.49K; R_0402_1005Metric; Manufacturer_Part_Number RTT022491FTH; LCSC Part # C102924
R73: 20K; R_0402_1005Metric; Manufacturer_Part_Number 0402WGF2002TCE; LCSC Part # C25765
R75: 1M; R_0402_1005Metric; Manufacturer_Part_Number RC0402FR-071ML; LCSC Part # C138033
R76: 50K; R_0603_1608Metric; Manufacturer_Part_Number RT0603BRD0750KL; LCSC Part # C861451
TP16: VLX; TestPoint_Pad_D2.5mm; not fitted
TP17: EN; TestPoint_Pad_D2.5mm; not fitted
TP18: BIAS; TestPoint_Pad_D2.5mm; not fitted
TP19: SYNC; TestPoint_Pad_D2.5mm; not fitted
TP20: 3V3; TestPoint_Pad_D2.5mm; not fitted
TP21: PGOOD; TestPoint_Pad_D2.5mm; not fitted
U7, U8, U10: TLV62130; RGT0016C; Manufacturer_Part_Number TLV62130RGTR; LCSC Part # C122479
U9: MAX42402AFLB+; MAX42402AFLB; Manufacturer_Part_Number MAX42402AFLB+; LCSC Part # C22392296

Connections:
/07_dcdcConv/BIAS: C86.1, J20.1, J22.1, R73.2, TP18.1, U9.11 (BIAS)
/07_dcdcConv/EN: J19.2, TP17.1, U9.1 (EN)
/07_dcdcConv/FB: C82.2, R60.2, R63.2, R64.1, U9.13 (FB)
/07_dcdcConv/VSUP: C66.1, C68.1, C70.1, C73.1, C90.1, C91.1, J19.1, L4.2, U9.3 (SUP), U9.7 (SUP)
BST: C81.1, U9.9 (BST)
unnamed: C82.1, R61.2, R62.1
unnamed: D11.2 (A), R71.1
unnamed: D12.2 (A), R72.1
unnamed: D13.2 (A), R78.1
unnamed: C78.1, C79.1, J17.2, U8.10 (AVIN), U8.11 (PVIN), U8.12 (PVIN), U8.13 (EN)
unnamed: J18.2, R60.1
unnamed: J20.2, U9.12 (SPS)
unnamed: J21.1, R73.1
unnamed: J21.2, TP21.1, U9.14 (PGOOD)
unnamed: J22.2, TP19.1, U9.15 (SYNC)
unnamed: R62.2, R63.1
unnamed: R75.1, R76.1
unnamed: R66.1, R67.2, U7.5 (FB)
unnamed: R65.1, U7.4 (PG)
unnamed: C76.1, U7.9 (SS/TR)
unnamed: R69.1, R70.2, U8.5 (FB)
unnamed: R68.1, U8.4 (PG)
unnamed: C80.1, U8.9 (SS/TR)
unnamed: C81.2, L3.1, TP16.1, U9.5 (LX)
unnamed: R76.2, R77.2, U10.5 (FB)
unnamed: R74.1, U10.4 (PG)
unnamed: C89.1, U10.9 (SS/TR)
SYSN: C61.2, C62.2, C63.2, C64.2, C65.2, C66.2, C67.2, C68.2, C69.2, C70.2, C71.2, C72.2, C73.2, C74.2, C75.2, C76.2, C77.2, C78.2, C79.2, C80.2, C83.2, C84.2, C85.2, C86.2, C87.2, C88.2, C89.2, C90.2, C91.2, C92.2, D11.1 (K), D12.1 (K), D13.1 (K), J19.3, J20.3, J22.3, R19.2, R23.2, R64.2, R67.1, R70.1, R77.1, U7.6 (AGND), U7.7 (FSW), U7.8 (DEF), U7.15 (PGND), U7.16 (PGND), U7.17 (EPAD), U8.6 (AGND), U8.7 (FSW), U8.8 (DEF), U8.15 (PGND), U8.16 (PGND), U8.17 (EPAD), U9.4 (PGND), U9.6 (PGND), U9.10 (GND), U10.6 (AGND), U10.7 (FSW), U10.8 (DEF), U10.15 (PGND), U10.16 (PGND), U10.17 (EPAD); also elsewhere on the board
VMM_motor: C62.1, C64.1, C65.1, C67.1, C69.1, C71.1, C72.1, C74.1, C75.1, C77.1, C83.1, C87.1, C88.1, J17.1, J18.1, L3.2, R19.1, R23.1, R61.1, U7.10 (AVIN), U7.11 (PVIN), U7.12 (PVIN), U7.13 (EN), U10.10 (AVIN), U10.11 (PVIN), U10.12 (PVIN), U10.13 (EN); also elsewhere on the board
VOUT_BATCHG: C61.1, C63.1, L4.1; also elsewhere on the board
VSYS_USB: J17.3; also elsewhere on the board

Notes on the sheet:
to bldc
R56 => R4 R57 => R5 R4 = R5*((VOUT/VFB)-1) Vfb = 0.8 Vout = 14 V

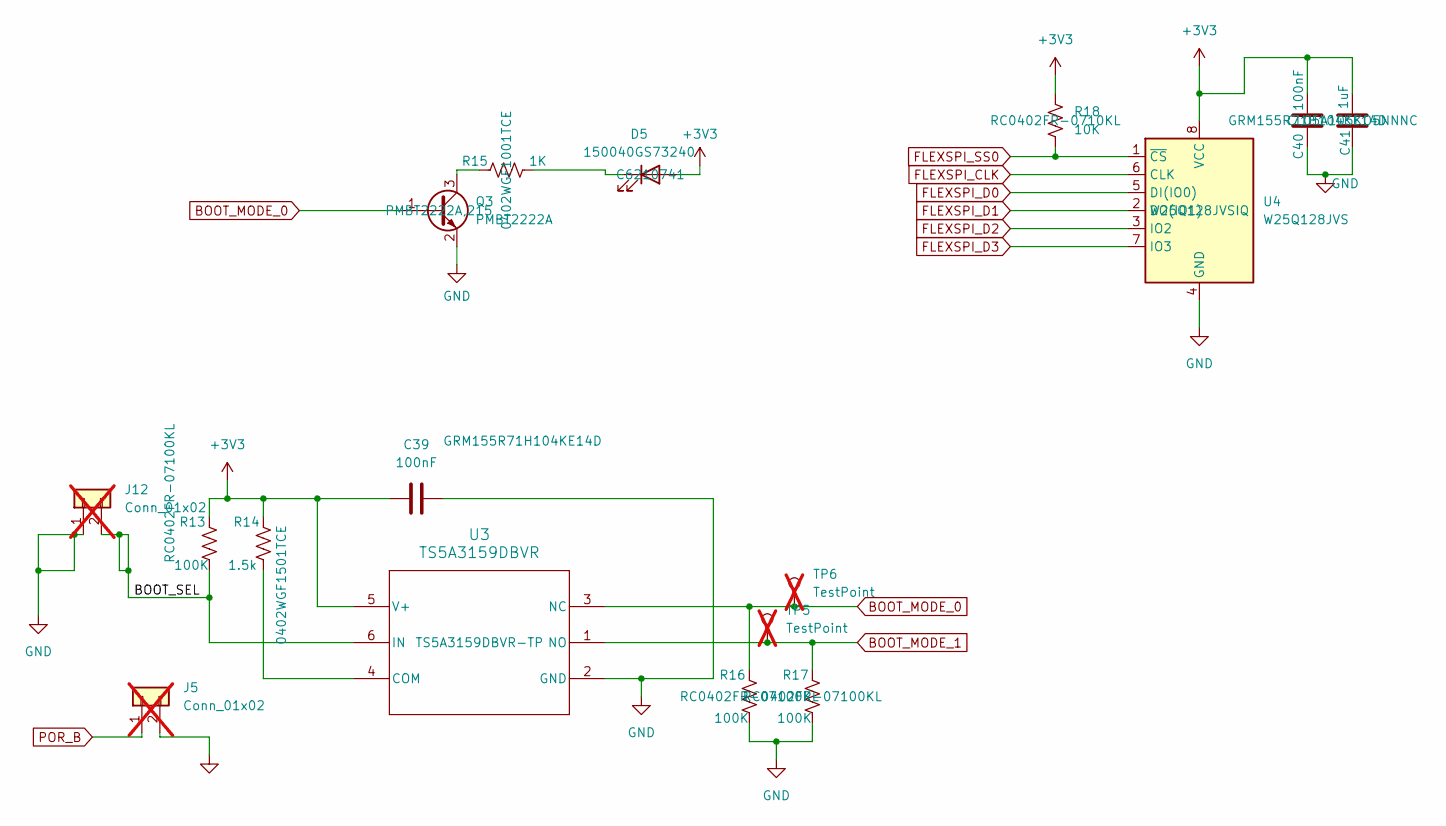
[picture p48: schematic BOOTLOADER.kicad_sch]

Parts:
C39, C40: 100nF; C_0402_1005Metric; Manufacturer_Part_Number GRM155R71H104KE14D; LCSC Part # C77020
C41: 1uF; C_0402_1005Metric; Manufacturer_Part_Number CL05A105KO5NNNC; LCSC Part # C29266
D5: 150040GS73240; LED_0402_1005Metric; Manufacturer_Part_Number C6210741; LCSC Part # C6210741
J5, J12: Conn_01x02; PinHeader_1x02_P2.54mm_Vertical; not fitted
Q3: PMBT2222A; SOT-23; Manufacturer_Part_Number PMBT2222A,215; LCSC Part # C23869
R13, R16, R17: 100K; R_0402_1005Metric; Manufacturer_Part_Number RC0402FR-07100KL; LCSC Part # C60491
R14: 1.5k; R_0402_1005Metric; Manufacturer_Part_Number 0402WGF1501TCE; LCSC Part # C25867
R15: 1K; R_0402_1005Metric; Manufacturer_Part_Number 0402WGF1001TCE; LCSC Part # C11702
R18: 10K; R_0402_1005Metric; Manufacturer_Part_Number RC0402FR-0710KL; LCSC Part # C60490
TP5, TP6: TestPoint; TestPoint_Pad_D2.5mm; not fitted
U3: TS5A3159DBVR; SOT-23-6; Manufacturer_Part_Number TS5A3159DBVR-TP; LCSC Part # C42411032
U4: W25Q128JVS; SOIC127P790X216-8N; Manufacturer_Part_Number W25Q128JVSIQ; LCSC Part # C97521

Connections:
/03_BOOTLOADER/BOOT_SEL: J12.2, R13.2, U3.6 (IN)
BOOT_MODE_0: Q3.1 (B), R16.1, TP6.1, U3.3 (NC); also elsewhere on the board
BOOT_MODE_1: R17.1, TP5.1, U3.1 (NO); also elsewhere on the board
FLEXSPI_CLK: U4.6 (CLK); also elsewhere on the board
FLEXSPI_D0: U4.5 (DI(IO0)); also elsewhere on the board
FLEXSPI_D1: U4.2 (DO(IO1)); also elsewhere on the board
FLEXSPI_D2: U4.3 (IO2); also elsewhere on the board
FLEXSPI_D3: U4.7 (IO3); also elsewhere on the board
FLEXSPI_SS0: R18.2, U4.1 (~CS); also elsewhere on the board
JTAG_RESET: J5.1; also elsewhere on the board
unnamed: D5.1 (K), R15.2
unnamed: Q3.3 (C), R15.1
unnamed: R14.2, U3.4 (COM)
SYSN: C39.2, C40.2, C41.2, J5.2, J12.1, Q3.2 (E), R16.2, R17.2, U3.2 (GND), U4.4 (GND); also elsewhere on the board

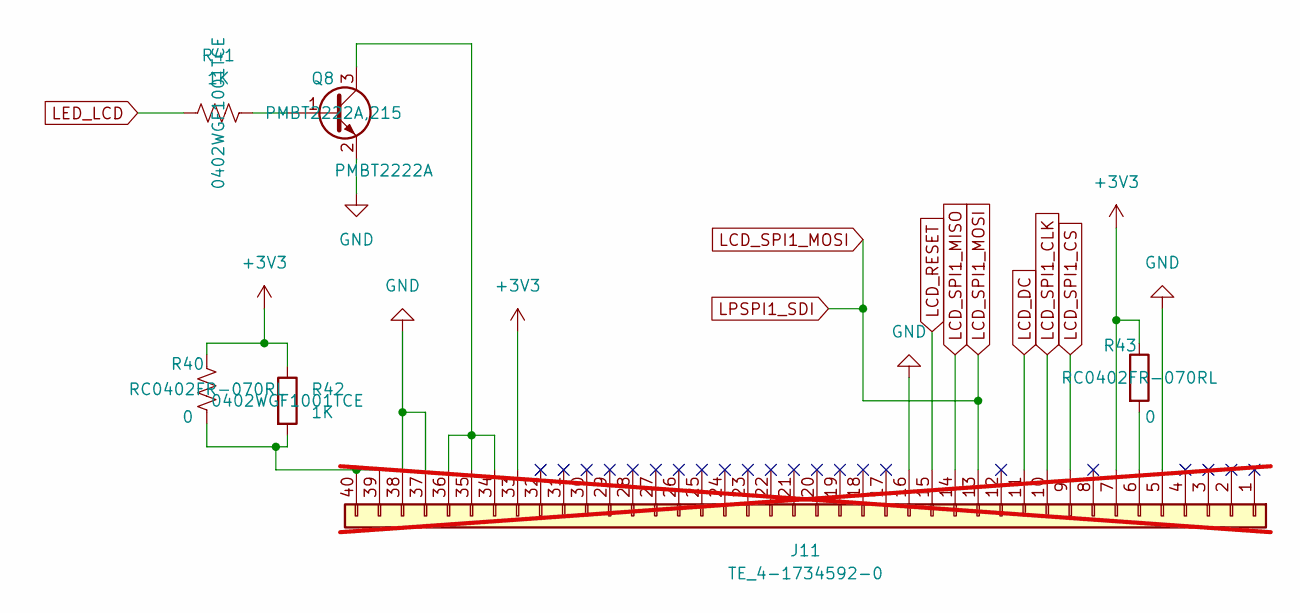
[picture p49: schematic lcd_port.kicad_sch]

Parts:
J11: TE_4-1734592-0; not fitted
Q8: PMBT2222A; SOT-23; Manufacturer_Part_Number PMBT2222A,215; LCSC Part # C23869
R40, R43: 0; R_0402_1005Metric; Manufacturer_Part_Number RC0402FR-070RL; LCSC Part # C106231
R41, R42: 1K; R_0402_1005Metric; Manufacturer_Part_Number 0402WGF1001TCE; LCSC Part # C11702

Connections:
JTAG_RESET: J11.15; also elsewhere on the board
LCD_DC: J11.11; also elsewhere on the board
LCD_SPI1_CLK: J11.10; also elsewhere on the board
LCD_SPI1_CS: J11.9; also elsewhere on the board
LCD_SPI1_MISO: J11.14; also elsewhere on the board
LCD_SPI1_MOSI: J11.13; also elsewhere on the board
LED_LCD: R41.1; also elsewhere on the board
unnamed: J11.6, R43.2
unnamed: J11.34, J11.35, J11.36, Q8.3 (C)
unnamed: J11.39, J11.40, R40.2, R42.2
unnamed: Q8.1 (B), R41.2
SYSN: J11.5, J11.16, J11.37, J11.38, Q8.2 (E); also elsewhere on the board
