faoziaziz/qioters/qiot.kicad_pcb

## KiCad design qiot.kicad_pcb (continued)

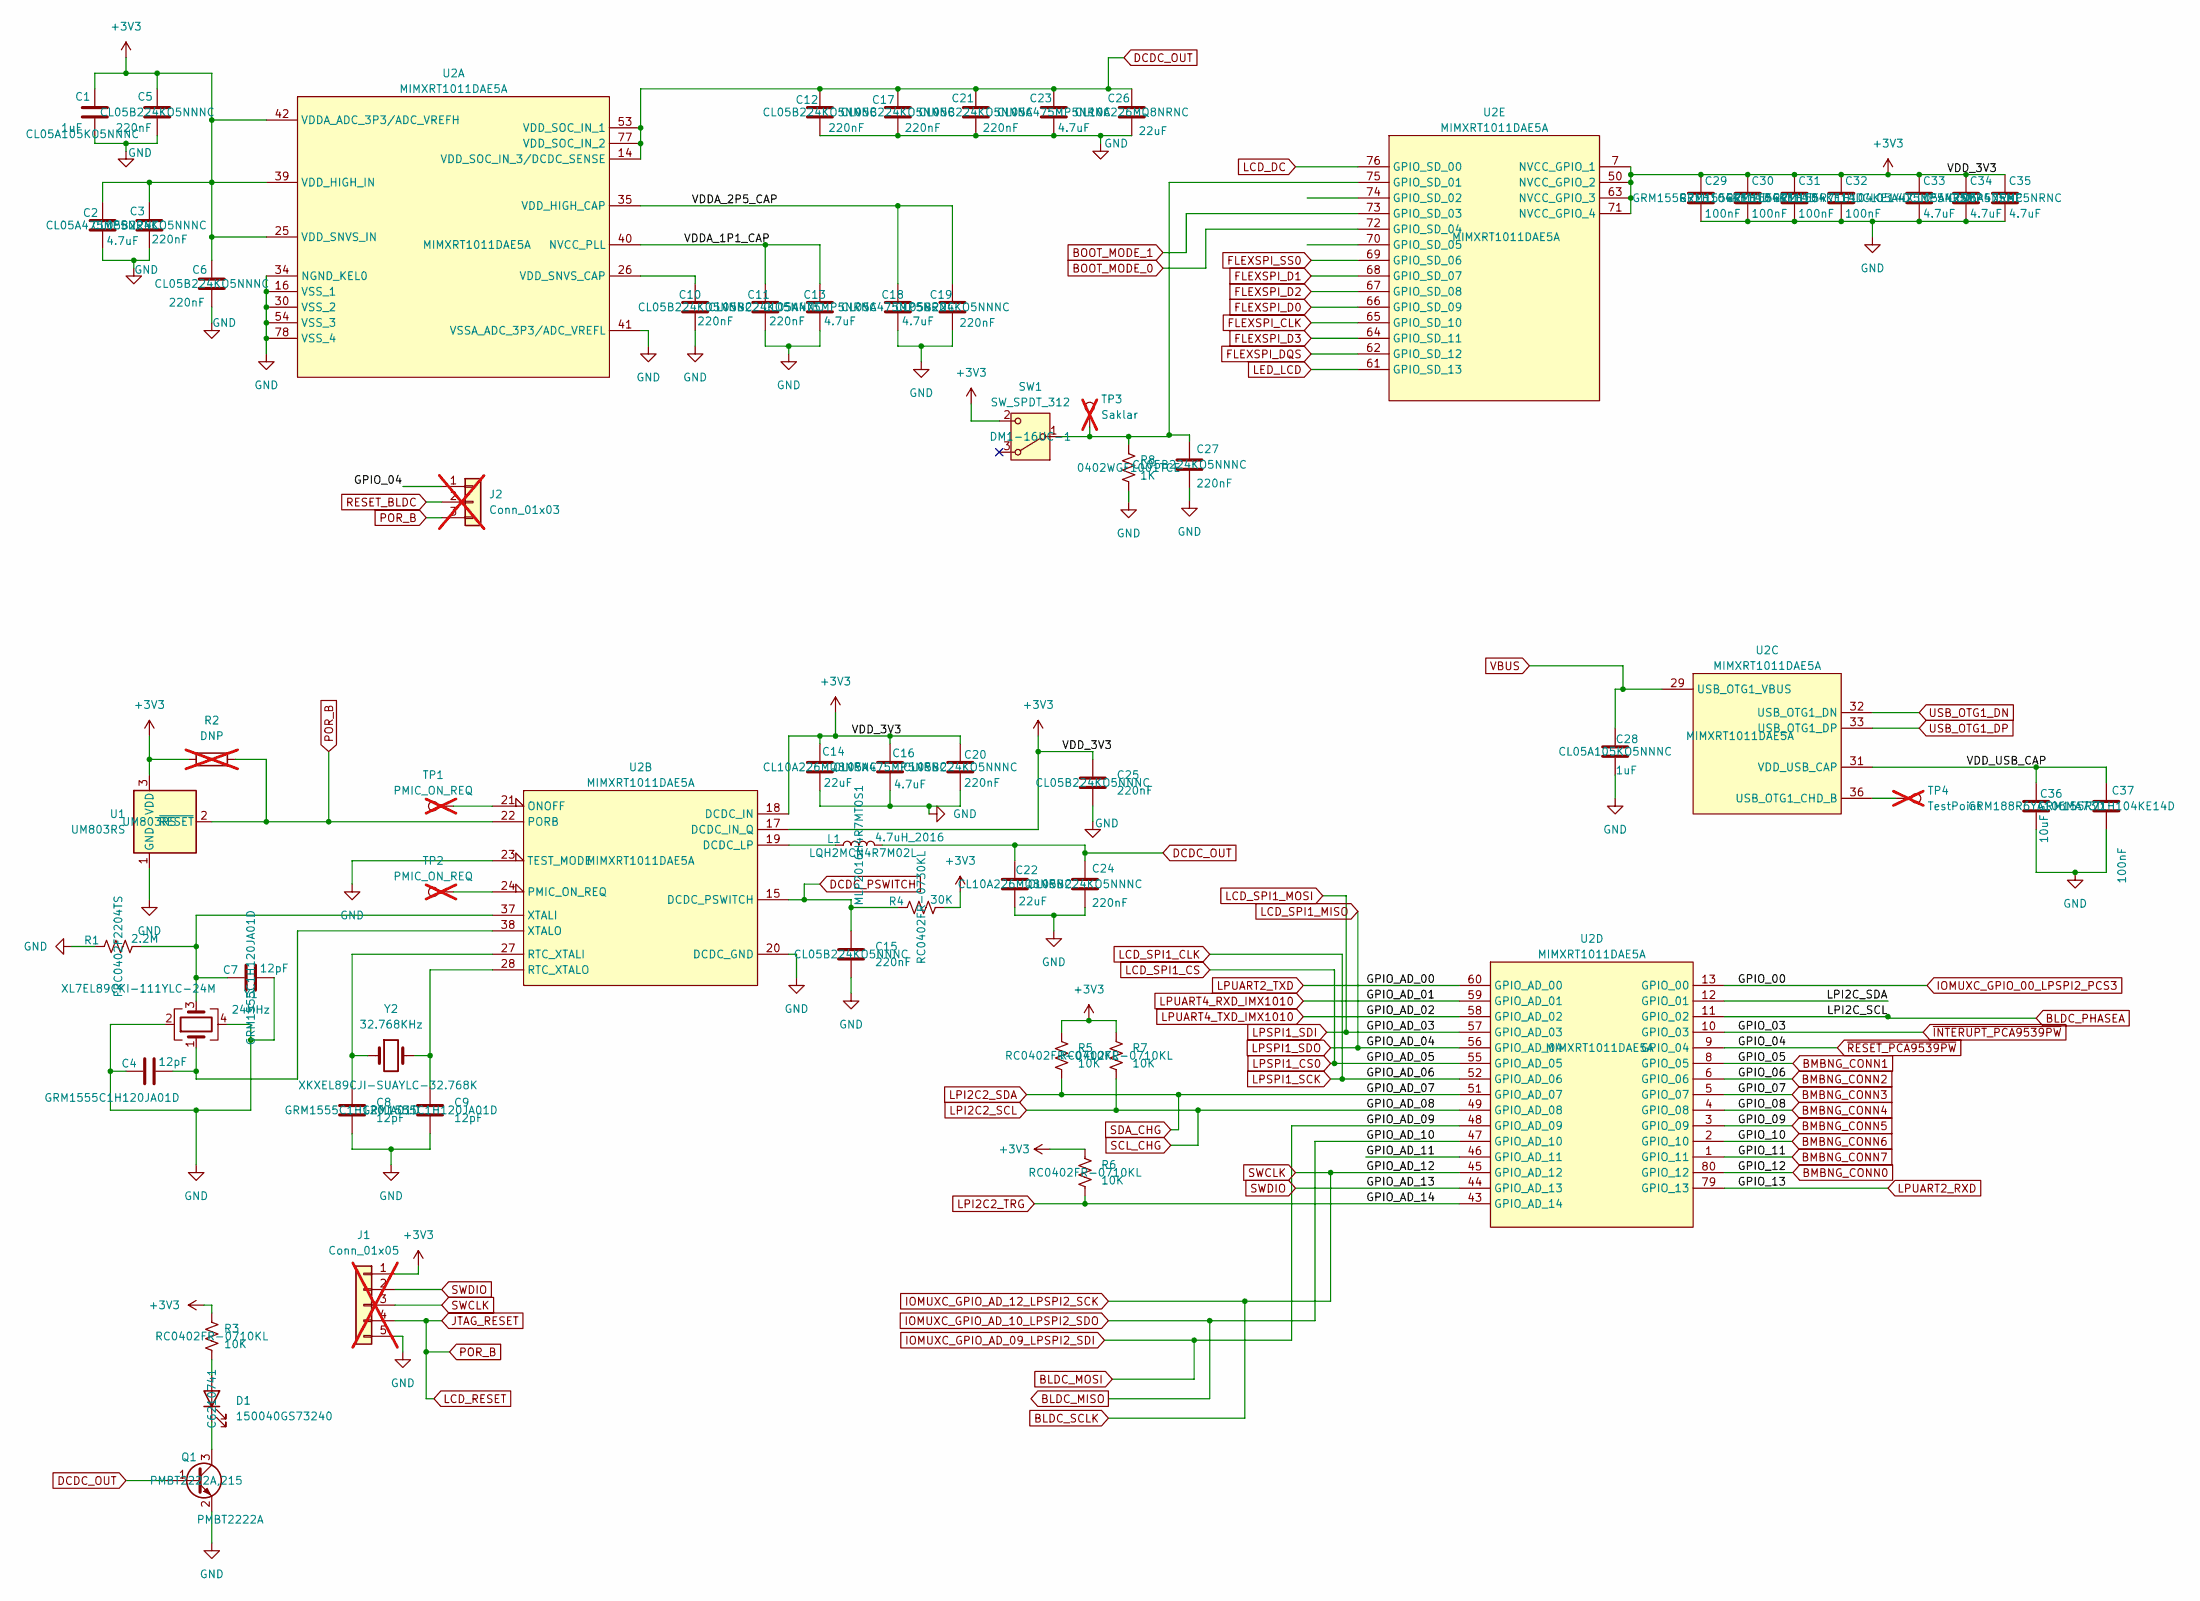
[picture p50: schematic 01_MCU.kicad_sch]

Parts:
C1, C28: 1uF; C_0402_1005Metric; Manufacturer_Part_Number CL05A105KO5NNNC; LCSC Part # C29266
C2, C13, C16, C18, C23, C33, C34, C35: 4.7uF; C_0402_1005Metric; Manufacturer_Part_Number CL05A475MP5NRNC; LCSC Part # C23733
C3, C5, C6, C10, C11, C12, C15, C17, C19, C20, C21, C24, C25, C27: 220nF; C_0402_1005Metric; Manufacturer_Part_Number CL05B224KO5NNNC; LCSC Part # C16772
C4, C7, C8, C9: 12pF; C_0402_1005Metric; Manufacturer_Part_Number GRM1555C1H120JA01D; LCSC Part # C76948
C14, C22, C26: 22uF; C_0603_1608Metric; Manufacturer_Part_Number CL10A226MQ8NRNC; LCSC Part # C59461
C29, C30, C31, C32, C37: 100nF; C_0402_1005Metric; Manufacturer_Part_Number GRM155R71H104KE14D; LCSC Part # C77020
C36: 10uF; C_0603_1608Metric; Manufacturer_Part_Number GRM188R6YA106MA73D; LCSC Part # C194427
D1: 150040GS73240; LED_0402_1005Metric; Manufacturer_Part_Number C6210741; LCSC Part # C6210741
J1: Conn_01x05; PinSocket_1x05_P2.54mm_Vertical; not fitted
J2: Conn_01x03; PinHeader_1x03_P2.54mm_Vertical; not fitted
L1: 4.7uH_2016; L_Murata_DFE201610P; Mfr. Part # LQH2MCN4R7M02L; LCSC Part # C383380
Q1: PMBT2222A; SOT-23; Manufacturer_Part_Number PMBT2222A,215; LCSC Part # C23869
R1: 2.2M; R_0402_1005Metric; Manufacturer_Part_Number FRC0402F2204TS; LCSC Part # C2998080
R2: DNP; R_0402_1005Metric; not fitted
R3, R5, R6, R7: 10K; R_0402_1005Metric; Manufacturer_Part_Number RC0402FR-0710KL; LCSC Part # C60490
R4: 30K; R_0402_1005Metric; Manufacturer_Part_Number RC0402FR-0730KL; LCSC Part # C138008
R8: 1K; R_0402_1005Metric; Manufacturer_Part_Number 0402WGF1001TCE; LCSC Part # C11702
SW1: SW_SPDT_312; SW_XKB_DM1-16UC-1; Manufacturer_Part_Number DM1-16UC-1; LCSC Part # C466019
TP1, TP2: PMIC_ON_REQ; TestPoint_Pad_D2.5mm; not fitted
TP3: Saklar; TestPoint_Pad_D2.5mm; not fitted
TP4: TestPoint; TestPoint_Pad_D2.5mm; not fitted
U1: UM803RS; SOT-23; Manufacturer_Part_Number UM803RS; LCSC Part # C620009
U2: MIMXRT1011DAE5A; MIMXRT1011DAE5A_NXP; Manufacturer_Part_Number MIMXRT1011DAE5A; LCSC Part # C1575810
Y1: 24MHz; OSC_XRCGB24M000F2P29R0; Mfr. Part # XRCGB24M000F2P29R0; LCSC Part # C2965580
Y2: 32.768KHz; CRYSTAL_FC-135 32.7680KA-AG3_EPS; Manufacturer_Part_Number XKXEL89CJI-SUAYLC-32.768K; LCSC Part # C7528807

Connections:
/01_MCU/GPIO_AD_11: U2.46 (GPIO_AD_11)
/01_MCU/LPI2C_SDA: U2.12 (GPIO_01)
/01_MCU/VDDA_1P1_CAP: C11.1, C13.1, U2.40 (NVCC_PLL)
/01_MCU/VDDA_2P5_CAP: C18.1, C19.1, U2.35 (VDD_HIGH_CAP)
/01_MCU/VDD_USB_CAP: C36.1, C37.1, U2.31 (VDD_USB_CAP)
BLDC_MISO: U2.47 (GPIO_AD_10)
BLDC_MOSI: U2.48 (GPIO_AD_09)
BLDC_PHASEA: U2.11 (GPIO_02)
BLDC_SCLK: J1.3, U2.45 (GPIO_AD_12)
BMBNG_CONN0: U2.80 (GPIO_12); also elsewhere on the board
BMBNG_CONN1: U2.8 (GPIO_05); also elsewhere on the board
BMBNG_CONN2: U2.6 (GPIO_06); also elsewhere on the board
BMBNG_CONN3: U2.5 (GPIO_07); also elsewhere on the board
BMBNG_CONN4: U2.4 (GPIO_08); also elsewhere on the board
BMBNG_CONN5: U2.3 (GPIO_09); also elsewhere on the board
BMBNG_CONN6: U2.2 (GPIO_10); also elsewhere on the board
BMBNG_CONN7: U2.1 (GPIO_11); also elsewhere on the board
BOOT_MODE_0: U2.72 (GPIO_SD_04); also elsewhere on the board
BOOT_MODE_1: U2.73 (GPIO_SD_03); also elsewhere on the board
DCDC_OUT: C12.1, C17.1, C21.1, C22.1, C23.1, C24.1, C26.1, L1.2, Q1.1 (B), U2.14 (VDD_SOC_IN_3/DCDC_SENSE), U2.53 (VDD_SOC_IN_1), U2.77 (VDD_SOC_IN_2)
DCDC_PSWITCH: C15.1, R4.1, U2.15 (DCDC_PSWITCH)
FLEXSPI_CLK: U2.65 (GPIO_SD_10); also elsewhere on the board
FLEXSPI_D0: U2.66 (GPIO_SD_09); also elsewhere on the board
FLEXSPI_D1: U2.68 (GPIO_SD_07); also elsewhere on the board
FLEXSPI_D2: U2.67 (GPIO_SD_08); also elsewhere on the board
FLEXSPI_D3: U2.64 (GPIO_SD_11); also elsewhere on the board
FLEXSPI_DQS: U2.62 (GPIO_SD_12)
FLEXSPI_SS0: U2.69 (GPIO_SD_06); also elsewhere on the board
IOMUXC_GPIO_00_LPSPI2_PCS3: U2.13 (GPIO_00)
JTAG_RESET: J1.4, J2.3, R2.2, U1.2 (~RESET), U2.22 (PORB); also elsewhere on the board
LCD_DC: U2.76 (GPIO_SD_00); also elsewhere on the board
LCD_SPI1_CLK: U2.52 (GPIO_AD_06); also elsewhere on the board
LCD_SPI1_CS: U2.55 (GPIO_AD_05); also elsewhere on the board
LCD_SPI1_MISO: U2.56 (GPIO_AD_04); also elsewhere on the board
LCD_SPI1_MOSI: U2.57 (GPIO_AD_03); also elsewhere on the board
LED_LCD: U2.61 (GPIO_SD_13); also elsewhere on the board
LPI2C2_SCL: R7.2, U2.49 (GPIO_AD_08); also elsewhere on the board
LPI2C2_SDA: R5.2, U2.51 (GPIO_AD_07); also elsewhere on the board
LPI2C2_TRG: R6.2, U2.43 (GPIO_AD_14)
LPUART2_RXD: U2.79 (GPIO_13)
LPUART2_TXD: U2.60 (GPIO_AD_00)
LPUART4_RXD_IMX1010: U2.59 (GPIO_AD_01); also elsewhere on the board
LPUART4_TXD_IMX1010: U2.58 (GPIO_AD_02); also elsewhere on the board
unnamed: D1.2 (A), R3.2
unnamed: D1.1 (K), Q1.3 (C)
unnamed: C27.1, R8.1, SW1.1 (B), TP3.1, U2.75 (GPIO_SD_01)
unnamed: C10.1, U2.26 (VDD_SNVS_CAP)
unnamed: L1.1, U2.19 (DCDC_LP)
unnamed: TP1.1, U2.21 (ONOFF)
unnamed: TP2.1, U2.24 (PMIC_ON_REQ)
unnamed: C8.1, U2.27 (RTC_XTALI), Y2.1
unnamed: C9.1, U2.28 (RTC_XTALO), Y2.2
unnamed: C7.1, R1.2, U2.37 (XTALI), Y1.3
unnamed: C4.2, U2.38 (XTALO), Y1.1
unnamed: TP4.1, U2.36 (USB_OTG1_CHD_B)
RESET_BLDC: J2.2
SWDIO: J1.2, U2.44 (GPIO_AD_13)
SYSN: C1.2, C2.2, C3.2, C4.1, C5.2, C6.2, C7.2, C8.2, C9.2, C10.2, C11.2, C12.2, C13.2, C14.2, C15.2, C16.2, C17.2, C18.2, C19.2, C20.2, C21.2, C22.2, C23.2, C24.2, C25.2, C26.2, C27.2, C28.2, C29.2, C30.2, C31.2, C32.2, C33.2, C34.2, C35.2, C36.2, C37.2, J1.5, Q1.2 (E), R1.1, R8.2, U1.1 (GND), U2.16 (VSS_1), U2.20 (DCDC_GND), U2.23 (TEST_MODE), U2.30 (VSS_2), U2.34 (NGND_KEL0), U2.41 (VSSA_ADC_3P3/ADC_VREFL), U2.54 (VSS_3), U2.78 (VSS_4), Y1.2, Y1.4; also elsewhere on the board
USB_OTG1_DN: U2.32 (USB_OTG1_DN); also elsewhere on the board
USB_OTG1_DP: U2.33 (USB_OTG1_DP); also elsewhere on the board
VBUS: C28.1, U2.29 (USB_OTG1_VBUS)
~INTERUPT_PCA9539PW: U2.10 (GPIO_03); also elsewhere on the board
~RESET_PCA9539PW: J2.1, U2.9 (GPIO_04); also elsewhere on the board

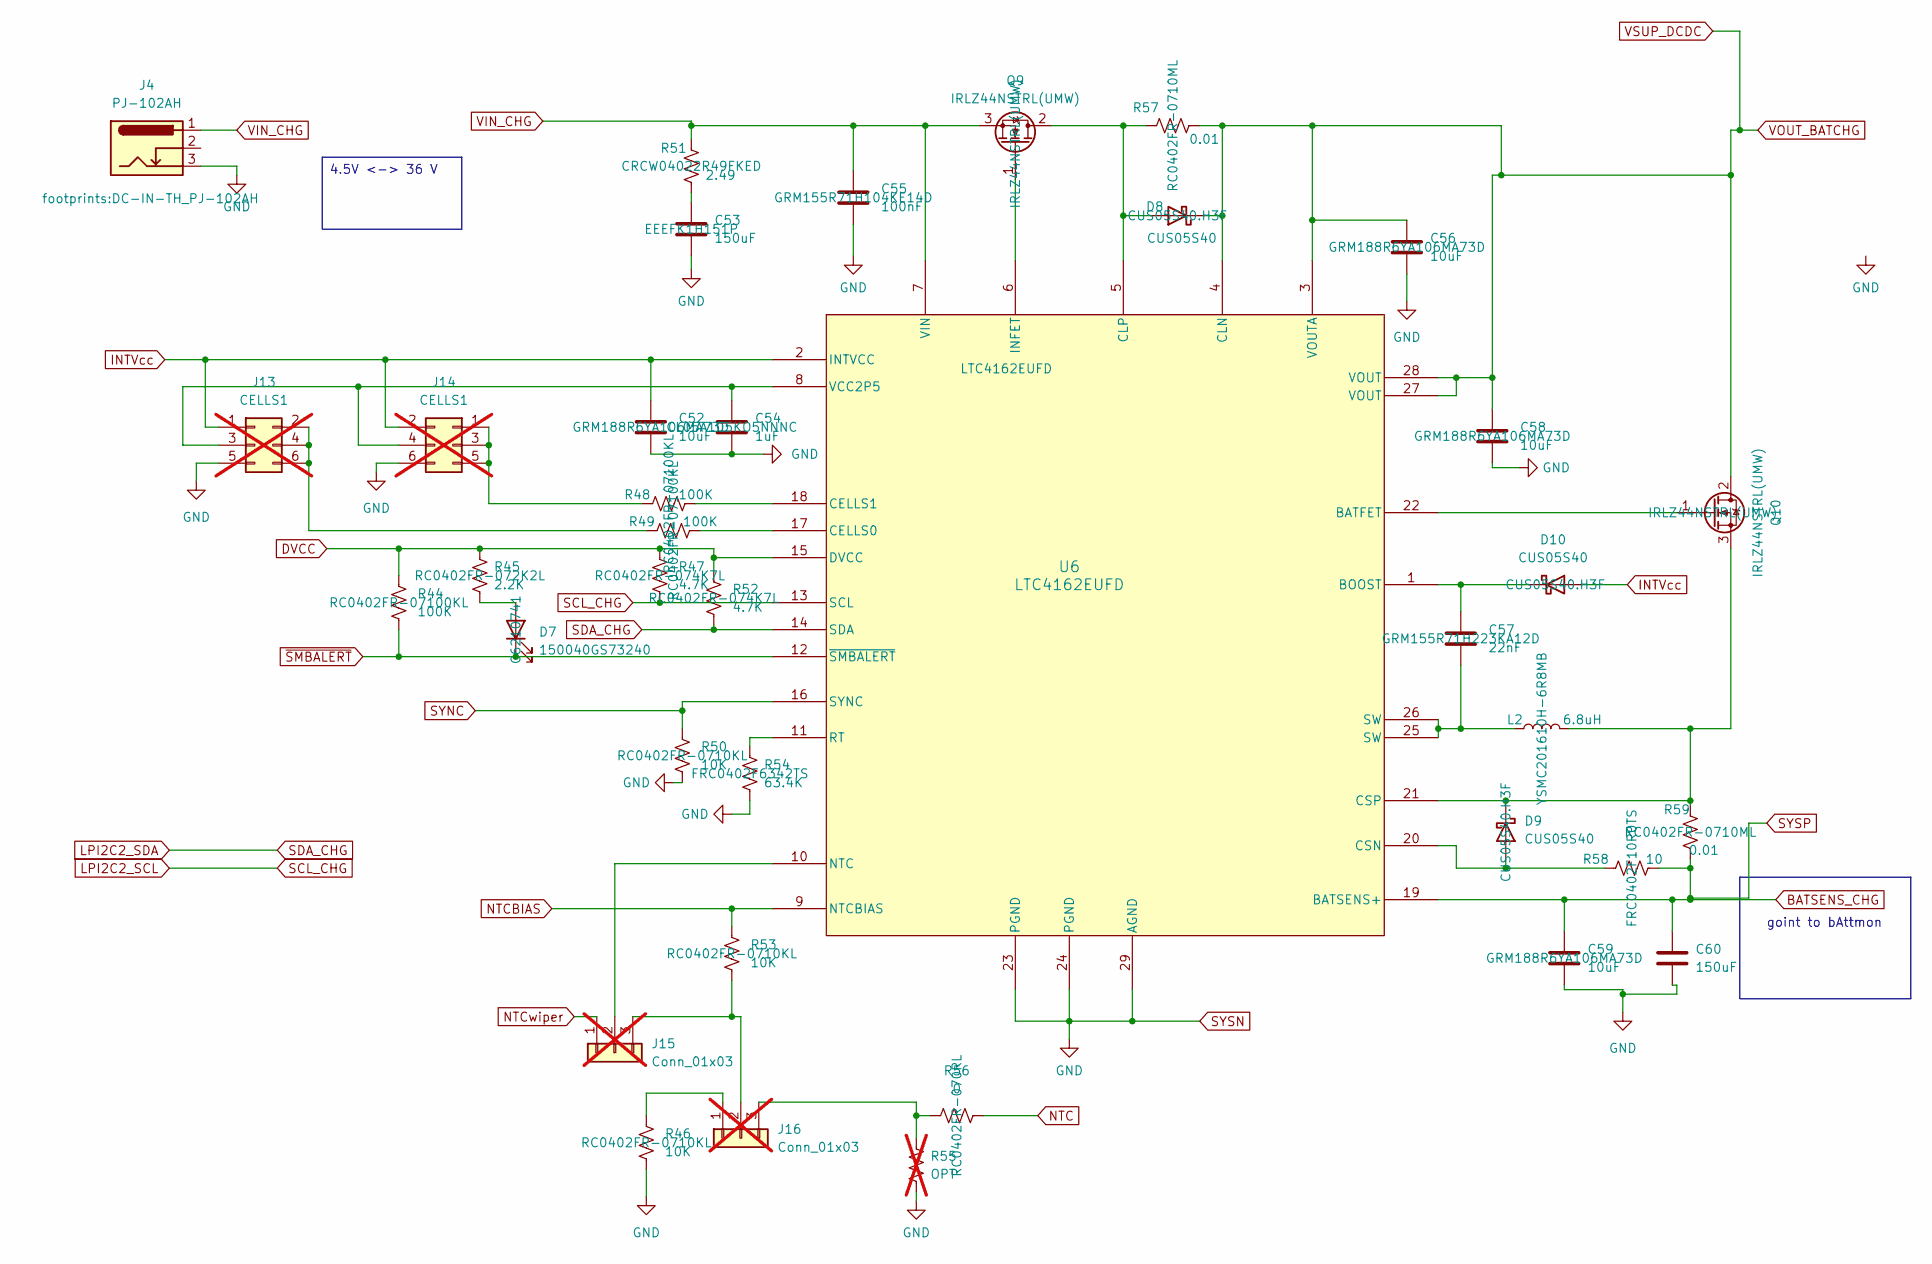
[picture p51: schematic batchg.kicad_sch]

Parts:
C52, C56, C58, C59: 10uF; C_0603_1608Metric; Manufacturer_Part_Number GRM188R6YA106MA73D; LCSC Part # C194427
C53: 150uF; CP_Elec_10x10.5; Manufacturer_Part_Number EEEFK1H151P; LCSC Part # C413508
C54: 1uF; C_0402_1005Metric; Manufacturer_Part_Number CL05A105KO5NNNC; LCSC Part # C29266
C55: 100nF; C_0402_1005Metric; Manufacturer_Part_Number GRM155R71H104KE14D; LCSC Part # C77020
C57: 22nF; C_0402_1005Metric; Manufacturer_Part_Number GRM155R71H223KA12D; LCSC Part # C77023
C60: 150uF; CP_Elec_10x10.5; Manufacturer_Part_Number EEEFK1H151P; JLCPARTS EEEFK1H151P
D7: 150040GS73240; LED_0402_1005Metric; Manufacturer_Part_Number C6210741; LCSC Part # C6210741
D8, D9, D10: CUS05S40; D_SOD-323; Manufacturer_Part_Number CUS05S40.H3F; LCSC Part # C2762696
J4: PJ-102AH; DC-IN-TH_PJ-102AH; Manufacturer_Part_Number PJ-102AH; LCSC Part # C3096093
J13, J14: CELLS1; PinHeader_2x03_P2.54mm_Vertical; not fitted
J15, J16: Conn_01x03; PinHeader_1x03_P2.54mm_Vertical; not fitted
L2: 6.8uH; L_Murata_DFE201610P; PartNum MAI201610S-6R8MT; LCSC Part # C41405888
Q9, Q10: IRLZ44NSTRL(UMW); TO-263-2; Manufacturer_Part_Number IRLZ44NSTRL(UMW); LCSC Part # C42370422
R44, R48, R49: 100K; R_0402_1005Metric; Manufacturer_Part_Number RC0402FR-07100KL; LCSC Part # C60491
R45: 2.2K; R_0402_1005Metric; Manufacturer_Part_Number RC0402FR-072K2L; LCSC Part # C114762
R46, R50, R53: 10K; R_0402_1005Metric; Manufacturer_Part_Number RC0402FR-0710KL; LCSC Part # C60490
R47, R52: 4.7K; R_0402_1005Metric; Manufacturer_Part_Number RC0402FR-074K7L; LCSC Part # C105871
R51: 2.49; R_0402_1005Metric; Manufacturer_Part_Number CRCW04022R49FKED; LCSC Part # C2085509
R54: 63.4K; R_0402_1005Metric; Manufacturer_Part_Number FRC0402F6342TS; LCSC Part # C2933107
R55: OPT; R_0402_1005Metric; not fitted
R56: 0; R_0402_1005Metric; Manufacturer_Part_Number RC0402FR-070RL; LCSC Part # C106231
R57, R59: 0.01; R_0402_1005Metric; Manufacturer_Part_Number RC0402FR-0710ML; LCSC Part # C138067
R58: 10; R_0402_1005Metric; Manufacturer_Part_Number FRC0402F10R0TS; LCSC Part # C2906862
U6: LTC4162EUFD; 05-08-1712_ADI; Manufacturer_Part_Number LTC4162EUFD; LCSC Part # C3681528

Connections:
BATSENS_CHG: C59.1, C60.1, R58.2, R59.2, U6.19 (BATSENS+); also elsewhere on the board
DVCC: R44.1, R45.1, R47.2, R52.1, U6.15 (DVCC)
INTVcc: C52.1, D10.2 (A), J13.1, J14.2, U6.2 (INTVCC)
LPI2C2_SCL: R47.1, U6.13 (SCL); also elsewhere on the board
LPI2C2_SDA: R52.2, U6.14 (SDA); also elsewhere on the board
NTC: R56.2
NTCBIAS: R53.1, U6.9 (NTCBIAS)
NTCwiper: J15.1
unnamed: C53.1, R51.2
unnamed: C57.2, L2.1, U6.25 (SW), U6.26 (SW)
unnamed: D7.2 (A), R45.2
unnamed: D8.2 (A), Q9.2 (D), R57.2, U6.5 (CLP)
unnamed: D9.2 (A), R58.1, U6.20 (CSN)
unnamed: D9.1 (K), L2.2, Q10.3 (S), R59.1, U6.21 (CSP)
unnamed: C57.1, D10.1 (K), U6.1 (BOOST)
unnamed: J13.2, J13.4, J13.6, R49.1
unnamed: C54.1, J13.3, J14.4, U6.8 (VCC2P5)
unnamed: J14.1, J14.3, J14.5, R48.1
unnamed: J15.2, U6.10 (NTC)
unnamed: J15.3, J16.2, R53.2
unnamed: J16.1, R46.1
unnamed: J16.3, R55.2, R56.1
unnamed: Q9.1 (G), U6.6 (INFET)
unnamed: Q10.1 (G), U6.22 (BATFET)
unnamed: R49.2, U6.17 (CELLS0)
unnamed: R48.2, U6.18 (CELLS1)
unnamed: R54.1, U6.11 (RT)
SYNC: R50.1, U6.16 (SYNC)
SYSN: C52.2, C53.2, C54.2, C55.2, C56.2, C58.2, C59.2, C60.2, J4.3, J13.5, J14.6, R46.2, R50.2, R54.2, R55.1, U6.23 (PGND), U6.24 (PGND), U6.29 (AGND); also elsewhere on the board
VIN_CHG: C55.1, J4.1, Q9.3 (S), R51.1, U6.7 (VIN)
VOUT_BATCHG: C56.1, C58.1, D8.1 (K), Q10.2 (D), R57.1, U6.3 (VOUTA), U6.4 (CLN), U6.27 (VOUT), U6.28 (VOUT); also elsewhere on the board
~SMBALERT: D7.1 (K), R44.2, U6.12 (~SMBALERT)

Notes on the sheet:
goint to bAttmon
4.5V <-> 36 V

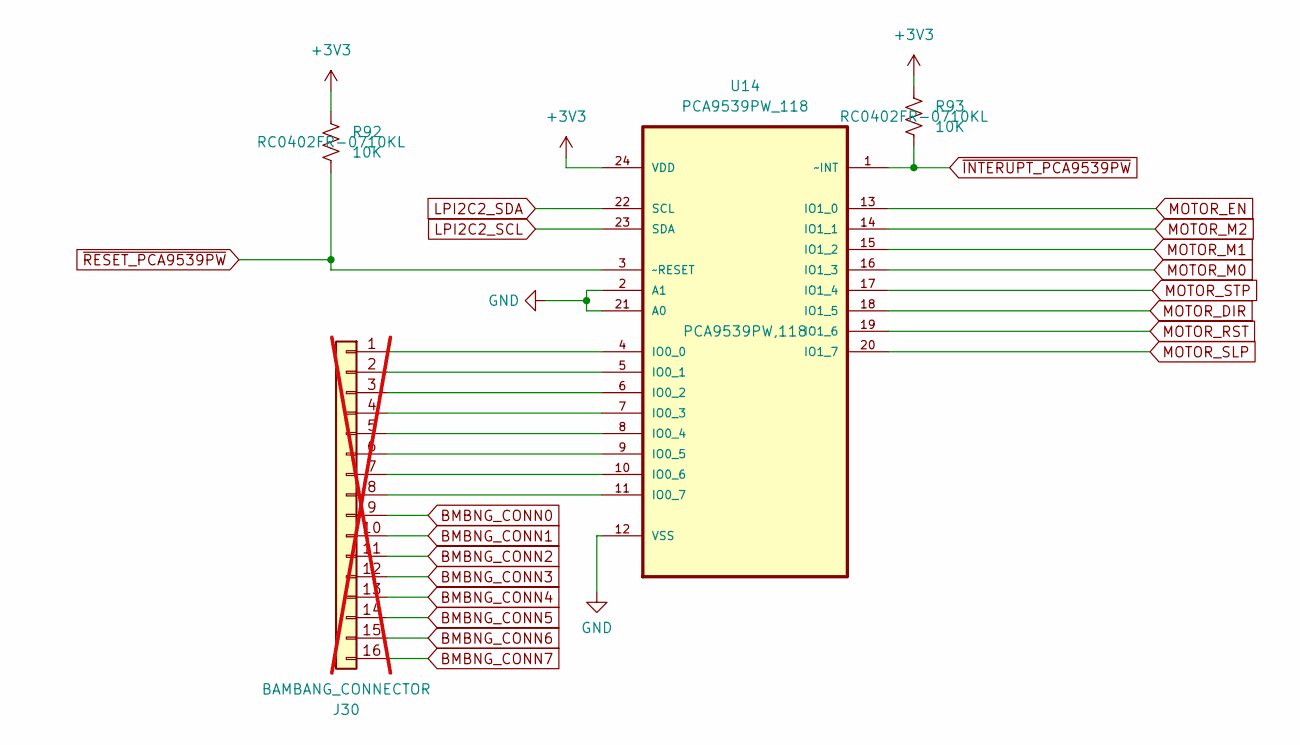
[picture p52: schematic 11_GPIO_Expander.kicad_sch]

Parts:
J30: BAMBANG_CONNECTOR; PinHeader_1x16_P2.54mm_Vertical; not fitted
R92, R93: 10K; R_0402_1005Metric; Manufacturer_Part_Number RC0402FR-0710KL; LCSC Part # C60490
U14: PCA9539PW_118; SOP65P640X110-24N; MPN PCA9539PW,118; LCSC Part # C2687996

Connections:
BMBNG_CONN0: J30.9; also elsewhere on the board
BMBNG_CONN1: J30.10; also elsewhere on the board
BMBNG_CONN2: J30.11; also elsewhere on the board
BMBNG_CONN3: J30.12; also elsewhere on the board
BMBNG_CONN4: J30.13; also elsewhere on the board
BMBNG_CONN5: J30.14; also elsewhere on the board
BMBNG_CONN6: J30.15; also elsewhere on the board
BMBNG_CONN7: J30.16; also elsewhere on the board
LPI2C2_SCL: U14.23 (SDA); also elsewhere on the board
LPI2C2_SDA: U14.22 (SCL); also elsewhere on the board
MOTOR_DIR: U14.18 (IO1_5); also elsewhere on the board
MOTOR_EN: U14.13 (IO1_0); also elsewhere on the board
MOTOR_M0: U14.16 (IO1_3); also elsewhere on the board
MOTOR_M1: U14.15 (IO1_2); also elsewhere on the board
MOTOR_M2: U14.14 (IO1_1); also elsewhere on the board
MOTOR_RST: U14.19 (IO1_6); also elsewhere on the board
MOTOR_SLP: U14.20 (IO1_7); also elsewhere on the board
MOTOR_STP: U14.17 (IO1_4); also elsewhere on the board
unnamed: J30.1, U14.4 (IO0_0)
unnamed: J30.2, U14.5 (IO0_1)
unnamed: J30.3, U14.6 (IO0_2)
unnamed: J30.4, U14.7 (IO0_3)
unnamed: J30.5, U14.8 (IO0_4)
unnamed: J30.6, U14.9 (IO0_5)
unnamed: J30.7, U14.10 (IO0_6)
unnamed: J30.8, U14.11 (IO0_7)
SYSN: U14.2 (A1), U14.12 (VSS), U14.21 (A0); also elsewhere on the board
~INTERUPT_PCA9539PW: R93.2, U14.1 (~INT); also elsewhere on the board
~RESET_PCA9539PW: R92.2, U14.3 (~RESET); also elsewhere on the board

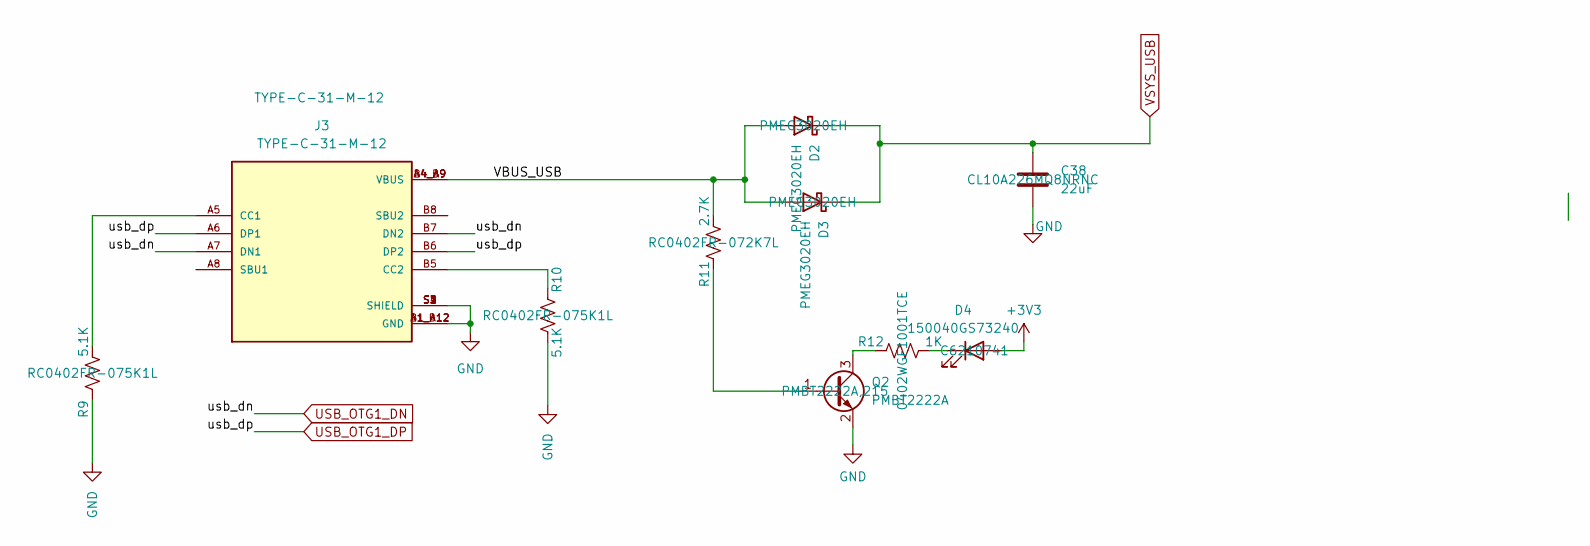
[picture p53: schematic USB.kicad_sch]

Parts:
C38: 22uF; C_0603_1608Metric; Manufacturer_Part_Number CL10A226MQ8NRNC; LCSC Part # C59461
D2, D3: PMEG3020EH; D_SOD-123F; Manufacturer_Part_Number PMEG3020EH; LCSC Part # C167645
D4: 150040GS73240; LED_0402_1005Metric; Manufacturer_Part_Number C6210741; LCSC Part # C6210741
J3: TYPE-C-31-M-12; HRO_TYPE-C-31-M-12; PARTREV 2020.12.08; LCSC Part # C165948
Q2: PMBT2222A; SOT-23; Manufacturer_Part_Number PMBT2222A,215; LCSC Part # C23869
R9, R10: 5.1K; R_0402_1005Metric; Manufacturer_Part_Number RC0402FR-075K1L; LCSC Part # C105872
R11: 2.7K; R_0402_1005Metric; Manufacturer_Part_Number RC0402FR-072K7L; LCSC Part # C138017
R12: 1K; R_0402_1005Metric; Manufacturer_Part_Number 0402WGF1001TCE; LCSC Part # C11702

Connections:
/02_USB/VBUS_USB: D2.2 (A), D3.2 (A), J3.A4_B9 (VBUS), J3.B4_A9 (VBUS), R11.2
unnamed: D4.1 (K), R12.2
unnamed: J3.A5 (CC1), R9.2
unnamed: J3.B5 (CC2), R10.2
unnamed: Q2.1 (B), R11.1
unnamed: Q2.3 (C), R12.1
SYSN: C38.2, J3.A1_B12 (GND), J3.B1_A12 (GND), J3.S1 (SHIELD), J3.S2 (SHIELD), J3.S3 (SHIELD), J3.S4 (SHIELD), Q2.2 (E), R9.1, R10.1; also elsewhere on the board
USB_OTG1_DN: J3.A7 (DN1), J3.B7 (DN2); also elsewhere on the board
USB_OTG1_DP: J3.A6 (DP1), J3.B6 (DP2); also elsewhere on the board
VSYS_USB: C38.1, D2.1 (K), D3.1 (K); also elsewhere on the board

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
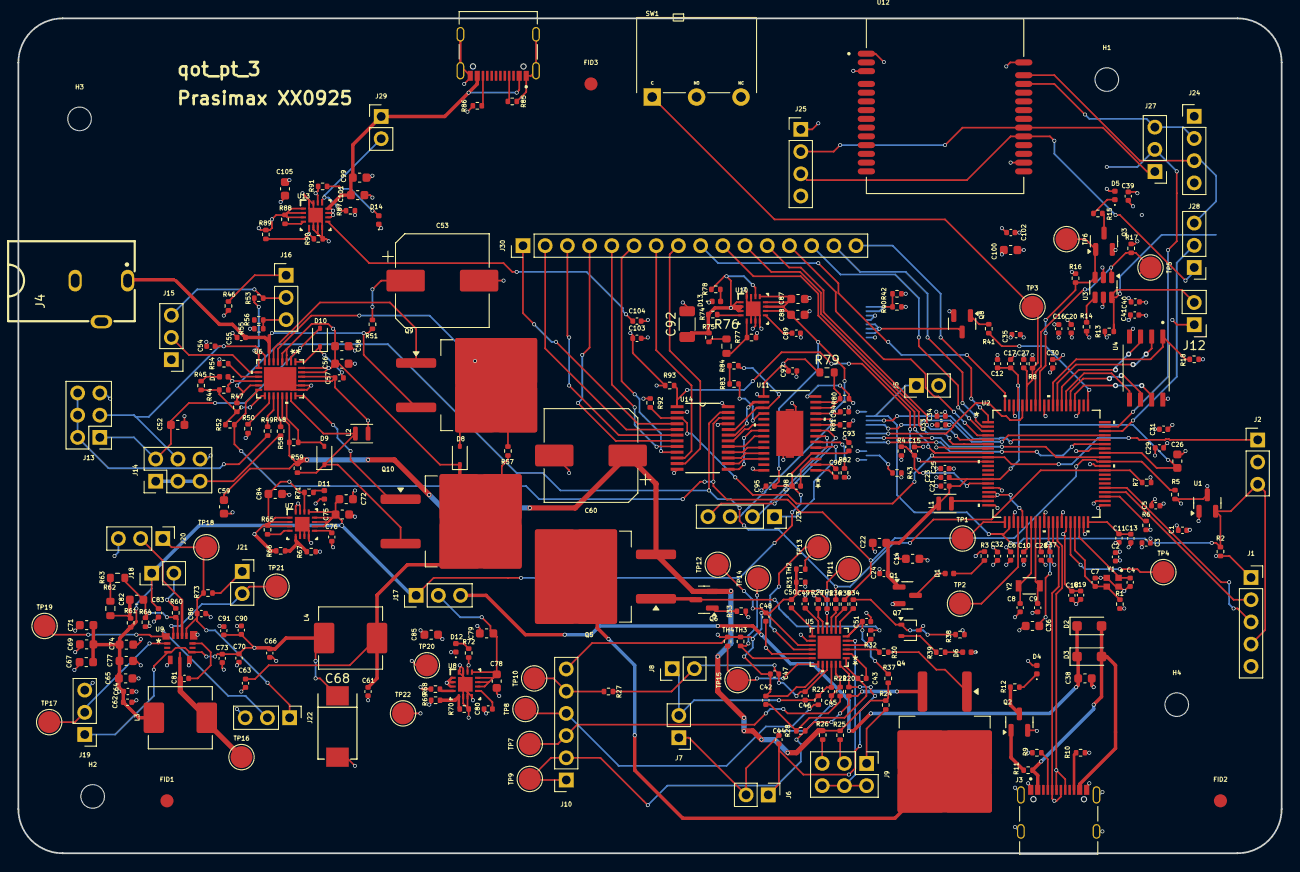
[picture p54: board qiot.kicad_pcb from above]

Board: 4 copper layers, 144.5 x 95.5 mm, 304 parts (1 on the bottom side), 205 nets.
