faoziaziz/qioters/(commit log)

2025-04-20 siapa presiden
    [01_MCU.kicad_sch, 10_wifi.kicad_sch, 11_GPIO_Expander.kicad_sch, 12_imx1062.kicad_sch, 14_RAM.kicad_sch, BOOTLOADER.kicad_sch, Ethernet.kicad_sch, MotorVending.kicad_sch]
2025-04-20 add base
    [qiot.kicad_sch]
2025-04-28 add revision to motor
    [01_MCU.kicad_sch, 10_wifi.kicad_sch, 11_GPIO_Expander.kicad_sch, BOOTLOADER.kicad_sch, MotorVending.kicad_sch, PowerManagement.kicad_sch, StepperMotor.kicad_sch, USB.kicad_sch]
2025-05-01 del some
    [10_wifi.kicad_sch, 11_GPIO_Expander.kicad_sch, MYC-LR3576-PINList.xlsx, PowerManagement.kicad_sch, StepperMotor.kicad_sch, VAR-SOM_Compatibility_and_Pinouts.xlsx, batchg.kicad_sch, dcdcConv.kicad_sch]
2025-05-18 dad
    da
    [01_MCU.kicad_sch, 10_wifi.kicad_sch, 11_GPIO_Expander.kicad_sch, BOOTLOADER.kicad_sch, PowerManagement.kicad_sch, StepperMotor.kicad_sch, USB.kicad_sch, batchg.kicad_sch]
